c03rad0r/balloon-fresh-1/docs/e80-900mbl-02-eval/README.md

E80-900MBL-02 eval kit reference materials (purchased 2026-08-15).

- e80-900mbl-02-manual-id4396.pdf — user manual v1.00 (11 pp, text-extractable)
- e80-900mbl-02-spec-id4397.pdf — board schematic (1 pp, image-only; pin map cross-validated vs main.h in capability report)
- lr2021-datasheet-id4393.pdf — actually a ZIP: E80_DEMO STM32F103 reference firmware (Keil CubeMX, Semtech LR20xx driver v1.3.1). Unpack locally to read.
- ebyte-doc-id1373.pdf — EBYTE corporate brochure (no technical value, kept for provenance)
- E80-900MBL-02_CAPABILITY_REPORT.md — consultant capability extraction (chip, PA tables, pin map, UART command protocol, gaps)

Live plan: docs/plans/PLAN-E80-LR2021-EVAL-2026-08-15.md
Ports on desk box: /dev/ttyUSB3, /dev/ttyUSB4 (CH340, 115200 8N1)
