c03rad0r/balloon-fresh-1/tracker/hardware/connectivity/OPEN-ITEMS.md

# v10 connectivity OPEN ITEMS

Every pin whose connection is NOT decided yet, or whose decision is UNVERIFIED.
This file is the companion to `v10_pinmap.reg`: the registry says what IS, this says
what is NOT YET DECIDED and what evidence would close it.

Rule: a pin may be `UNASSIGNED` only if it is listed here. The registry check prints
the UNASSIGNED list every run; if a pin appears there and not here, that is a defect.

---

## OPEN-16 — ESP32-S3 GPIO0 (J_PROG pin 6)
- **State:** unverified. The WROOM-1U's GPIO0 pad number is not named by any in-repo
  source. An earlier guess (pad 25) was WRONG — pad 25 is IO48 and already carries
  `/U3_RESET_N`; the guess had clobbered that net and was reverted (PR #266).
- **Blocked on:** Espressif ESP32-S3-WROOM-1 datasheet pin table (not in repo).
- **Workaround in force:** J_PROG pin 6 dangles. Flashing still works over
  USB-Serial-JTAG (EN + USB D± are connected), which needs no GPIO0.
- **Likely CLOSED by registry data (2026-10-26):** `GPIO0` = **`U1` pad 27**, per the pad->GPIO map
  corroborated 20 ways in `docs/analysis/E28-ENABLES-DRIVE-FROM-ESP32.md` §3. `U1.27` is
  `UNASSIGNED` in the registry, which is exactly consistent with being the `J_PROG` pin that
  dangles. Weakens the blocker to "still wants the datasheet table pasted in".
- **Closes when:** datasheet table pasted in, or GPIO0 read off a physical module.

## OPEN-E28-EN — E28 RX_EN (pin 8) / TX_EN (pin 9)
- **State:** pads now NAMED (2026-10-26); assignment still not landed on the board.
- **Note:** these are NEW versus the bare SX1280 (which had no PA/LNA enables), so no
  v9 pin carried over.
- **Resolved pads** (pad->GPIO map corroborated 20 ways against this registry; see
  `docs/analysis/E28-ENABLES-DRIVE-FROM-ESP32.md`):
  `TX_EN -> U1.35 (IO42)` — the only clean spare GPIO; `RX_EN -> U1.16 (IO46)` — a
  strapping pin whose load is a high-Z module input. Fallback for RX_EN is strapping it
  high with a resistor rather than spending the strap pin.
- **DO NOT strap both to +3V3.** ADR-123 explicitly budgets `E28 extras (RX_EN, TX_EN) | 2`
  and states "fits with 2 spare"; this item was open only because nobody had named the pads.
  A strap recommendation was made and retracted on 2026-10-26.
- **Closes when:** the two nets are created, routed and re-graded, and the IO46 strapping
  behaviour is confirmed from the WROOM-1 datasheet (the OPEN-16 blocker).

## OPEN-17 / OPEN-25 (merged) — the LAST ADC INPUT on the board

**State:** unresolved, and now BLOCKING two functions that are both in the design.

Two things compete for one ADC-capable pin:

1. **`/SCAP_ADC` — the supercap-rail monitor** (`R_DIV1`/`R_DIV2`, 2× 1 M, ADR-006).
2. **`/CUT_SENSE_W1..W4` — the cut-sense lines** (ADR-051 §2.6), which the operator has now
   confirmed are IN the design (ADR-129 D5).

**Measured in the v9 netlist: `/SCAP_ADC` connects to NOTHING but its own divider.** In v9 the
node was a net between `R_DIV1.2` and `R_DIV2.1` and had **no ESP32 pin at all** — the rail
monitor was never actually readable. So this is not a regression v10 introduced; v10 inherited it
by carrying the divider across. It is recorded here because ADR-129 restores the divider and
therefore makes the gap explicit.

**The arithmetic** (`docs/analysis/ADC-PIN-RESOLUTION-OPEN17-OPEN25.md`): there is **no spare ADC
input**. `IO13` is spent on the F33 rail monitor (ADR-047 §6, `F33_VSENSE`). ADR-029 §4 forbids
GPIO0 for the supercap divider (it is a strap), and ADR-069 forbids dividers on straps generally.

**The three shapes the analysis allows, in its own order of preference:**

1. **Give the cut-sense the one-GPIO + resistor-ladder/mux shape** ADR-051 §2.6 already allows.
2. **Free an ADC-capable pin** by relocating one *digital* assignment onto a free pin — **but note
   the correction below: `U1.26..U1.30` is NOT a "free IO22–IO34 block"**. Those pads are
   `IO45`, `IO0`, `IO35`, `IO36`, `IO37` (two strapping pins + three octal-PSRAM pins), so no
   digital line can move there. The only clean spare GPIO on this board is `U1.35 (IO42)`; see
   `docs/analysis/E28-ENABLES-DRIVE-FROM-ESP32.md` §3. This preserves
   rail-monitor accuracy.
3. **Only if no digital line can move**, share IO13 — and then the divider network must be
   designed and *measured* for burden and post-cut interpretability before flight.

**Not decided here.** `U_CUT1..4` pin 3 is landed on `/CUT_SENSE_W<n>` and the divider is landed
on `/SCAP_ADC`; **neither has a U1 pin.** Closing this item is what gives them one.

**Closes when:** a shape is chosen and a U1 pad is assigned to `/SCAP_ADC` and to the cut-sense
encoding. **`/SCAP_ADC` and `/CUT_SENSE_W1..W4` will remain single-ended nets until then** — they
are a deliberate, documented open item, not an omission.
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
