c03rad0r/balloon-fresh-1/data/comprehensive_plot_20260724.png

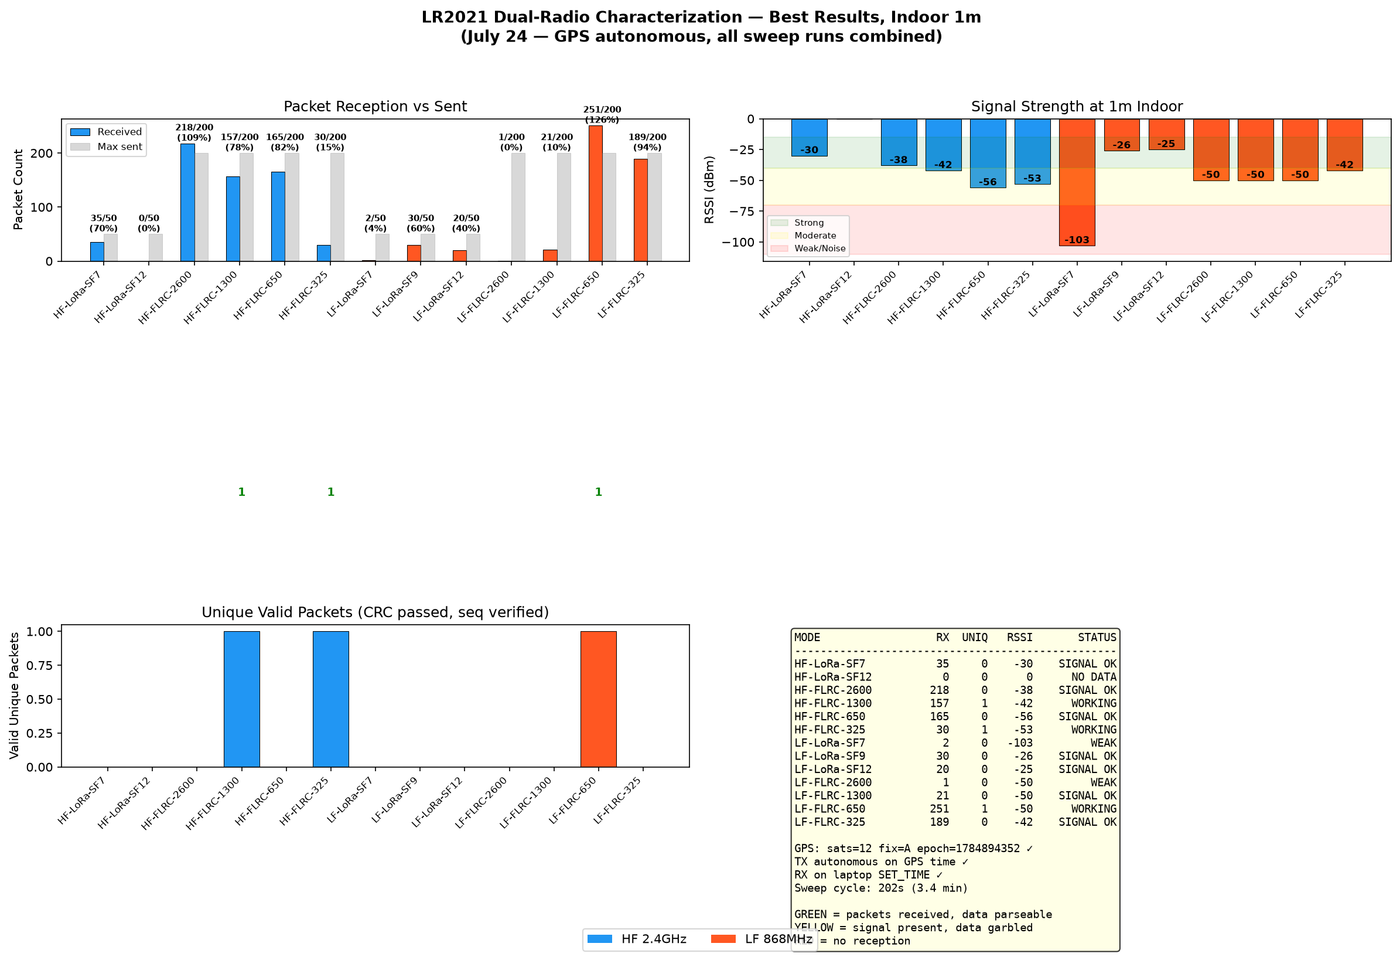
data/comprehensive_plot_20260724.png
