c03rad0r/balloon-fresh-1/data/payload-corruption.png

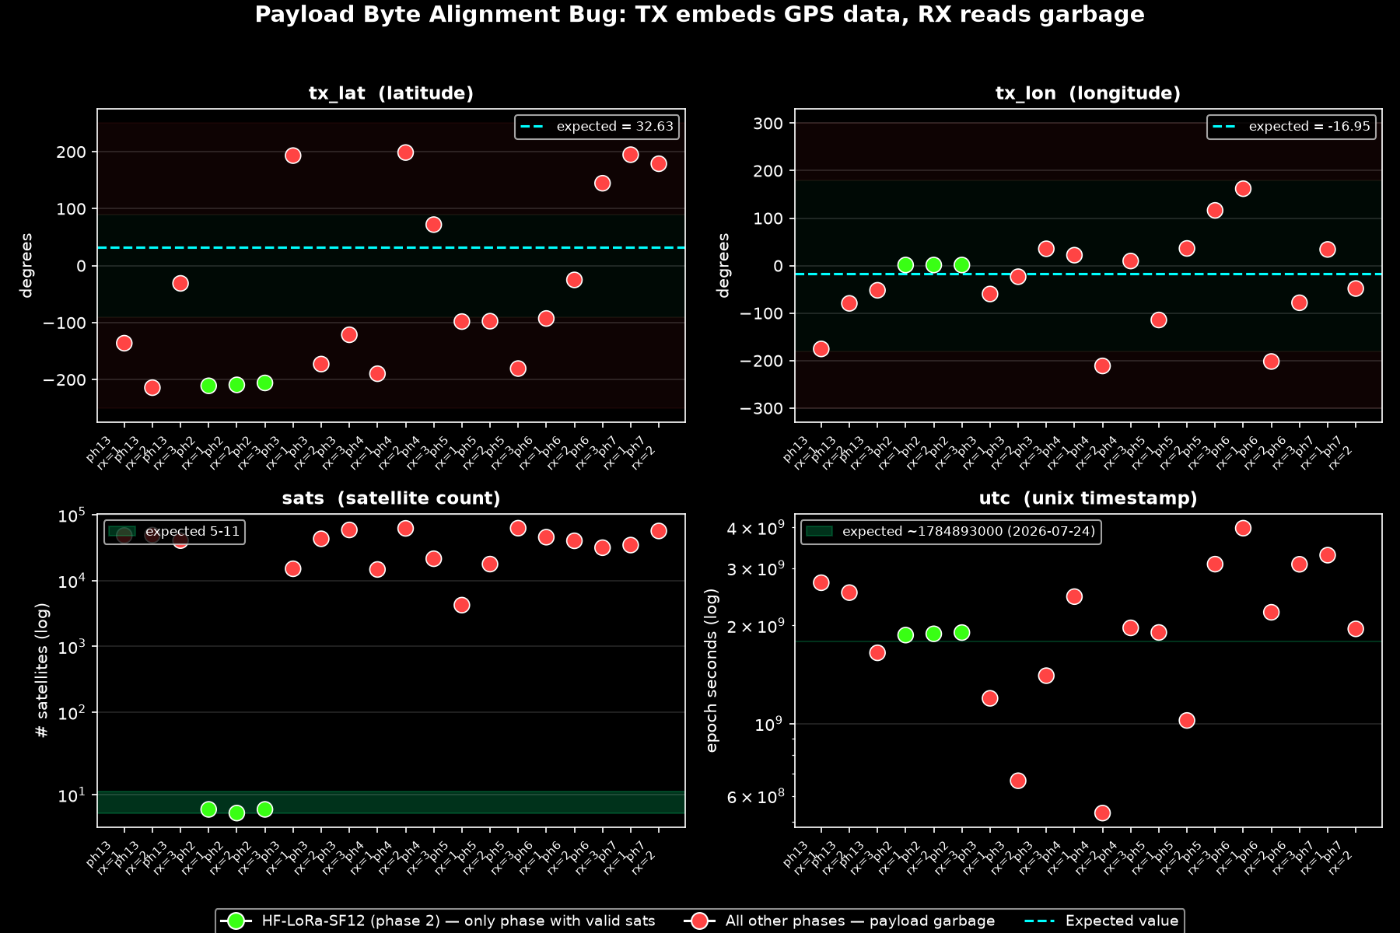
data/payload-corruption.png
