c03rad0r/balloon-fresh-1/data/plots/01_rssi_vs_distance.png

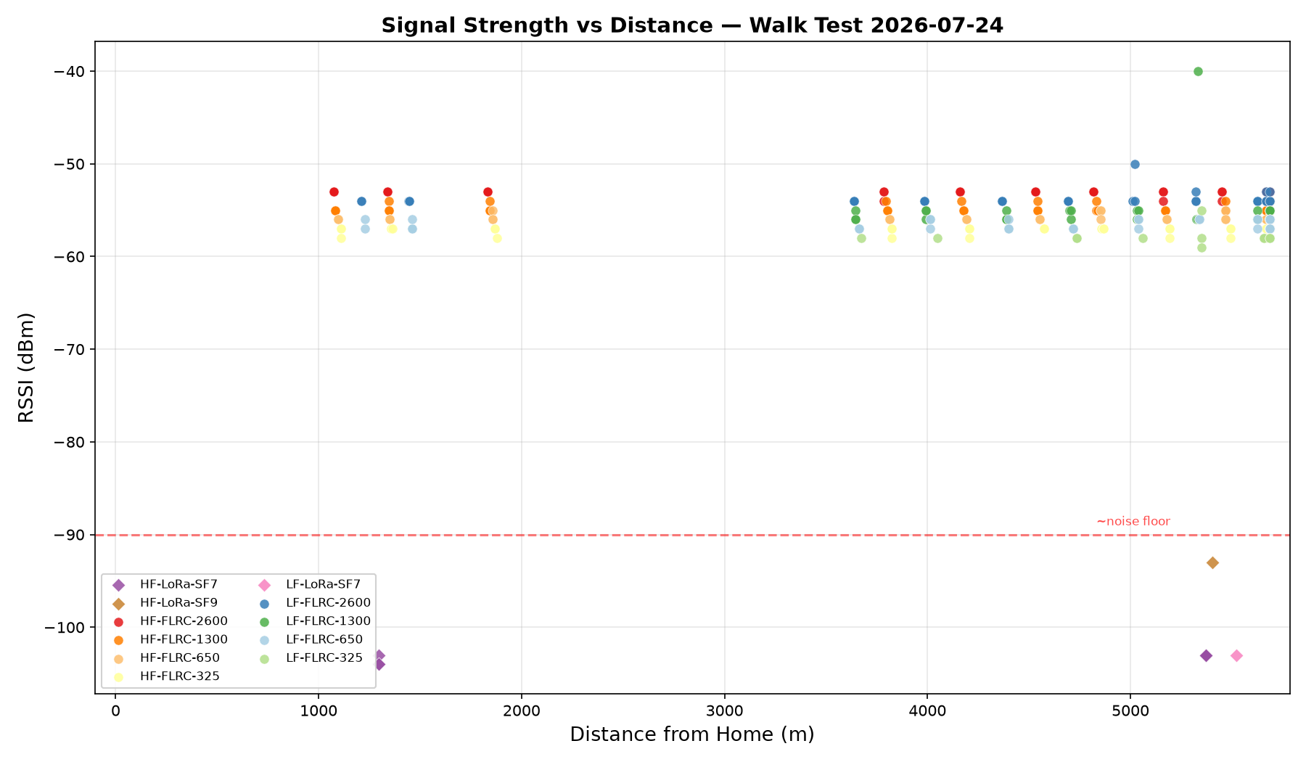
data/plots/01_rssi_vs_distance.png
