c03rad0r/balloon-fresh-1/data/plots/02_rssi_over_time.png

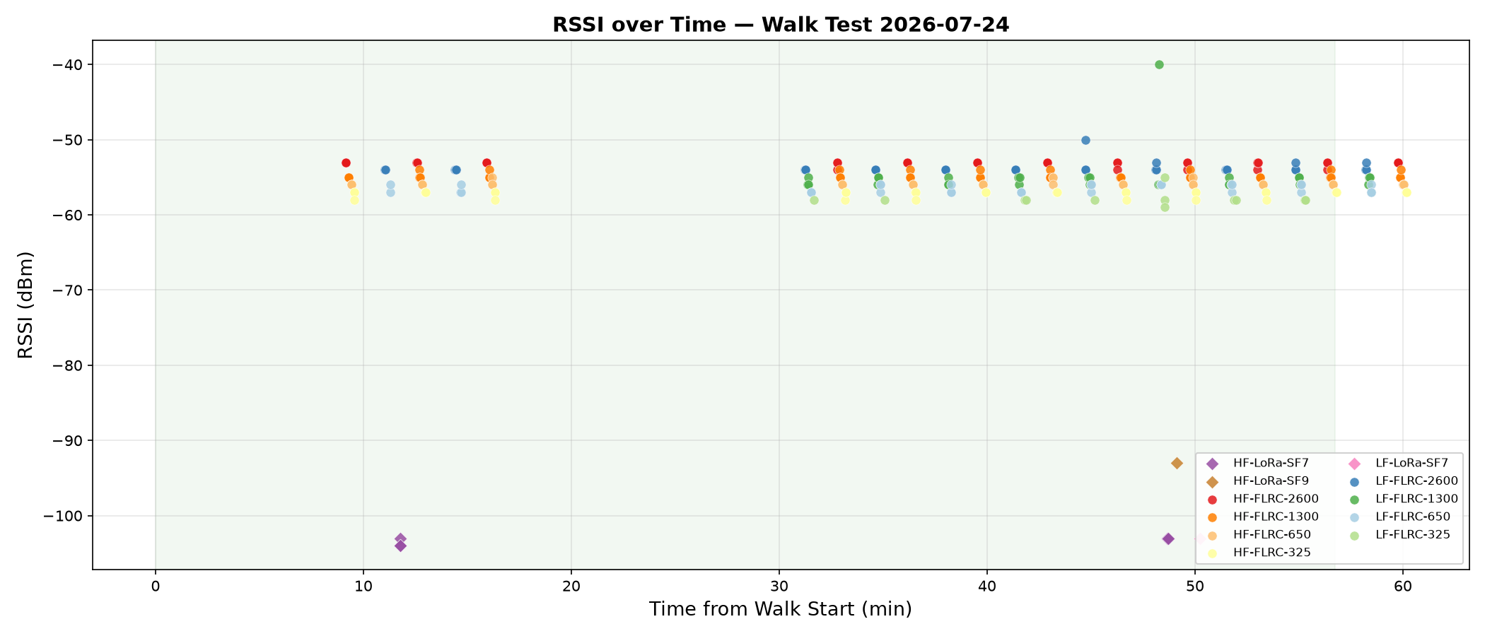
data/plots/02_rssi_over_time.png
