c03rad0r/balloon-fresh-1/data/plots/03_packets_per_mode.png

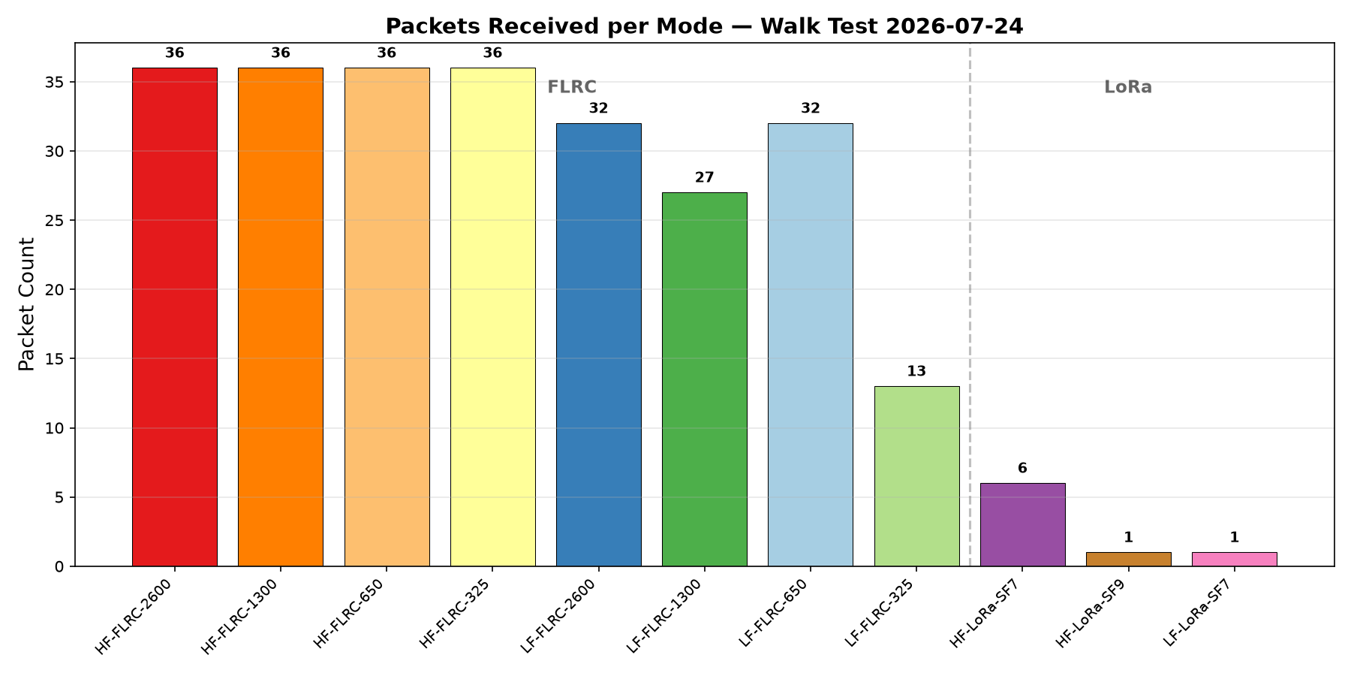
data/plots/03_packets_per_mode.png
