c03rad0r/balloon-fresh-1/data/plots/04_gps_walk_track.png

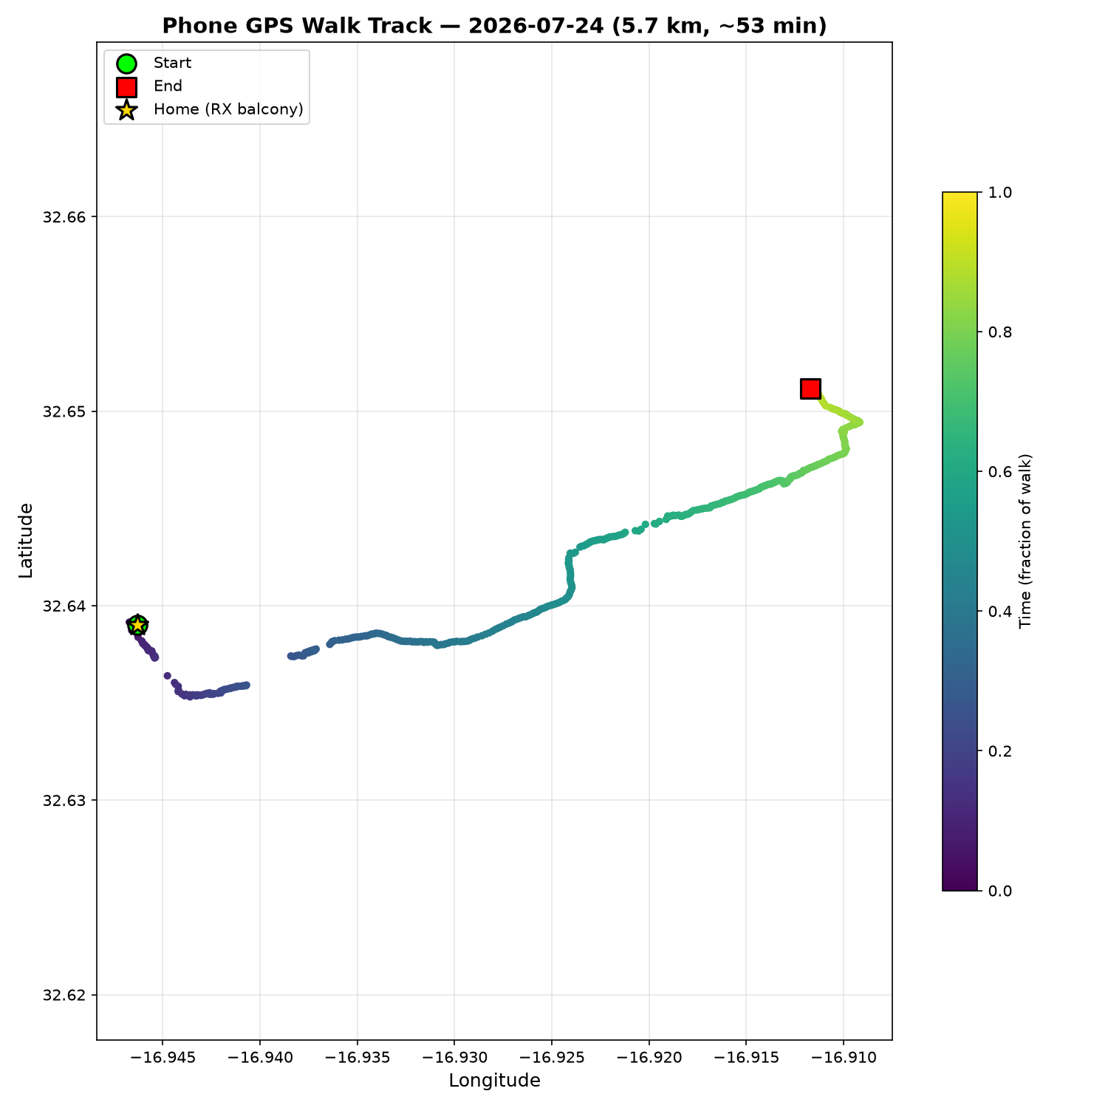
data/plots/04_gps_walk_track.png
