c03rad0r/balloon-fresh-1/data/plots/05_rssi_distribution.png

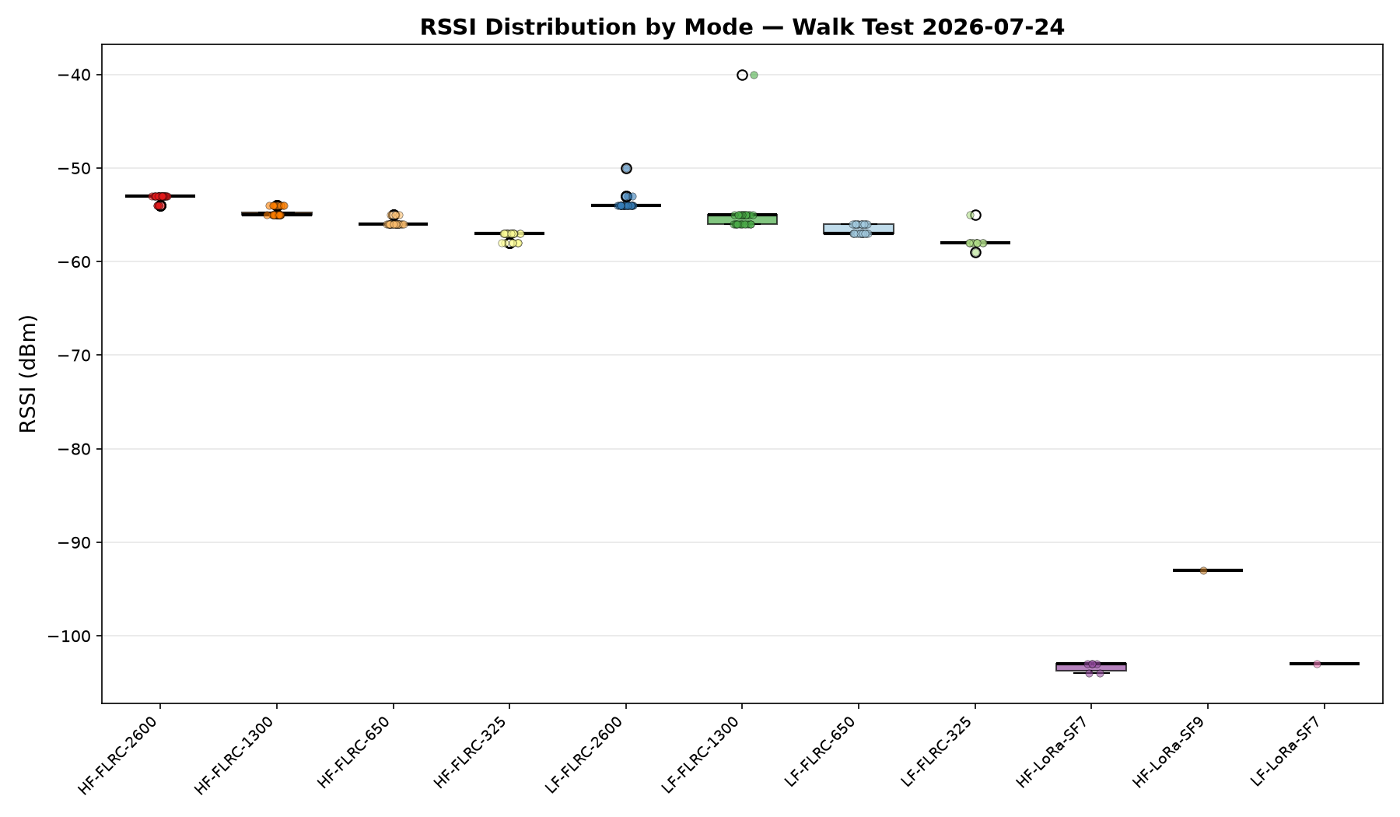
data/plots/05_rssi_distribution.png
