c03rad0r/balloon-fresh-1/data/plots/06_signal_map.png

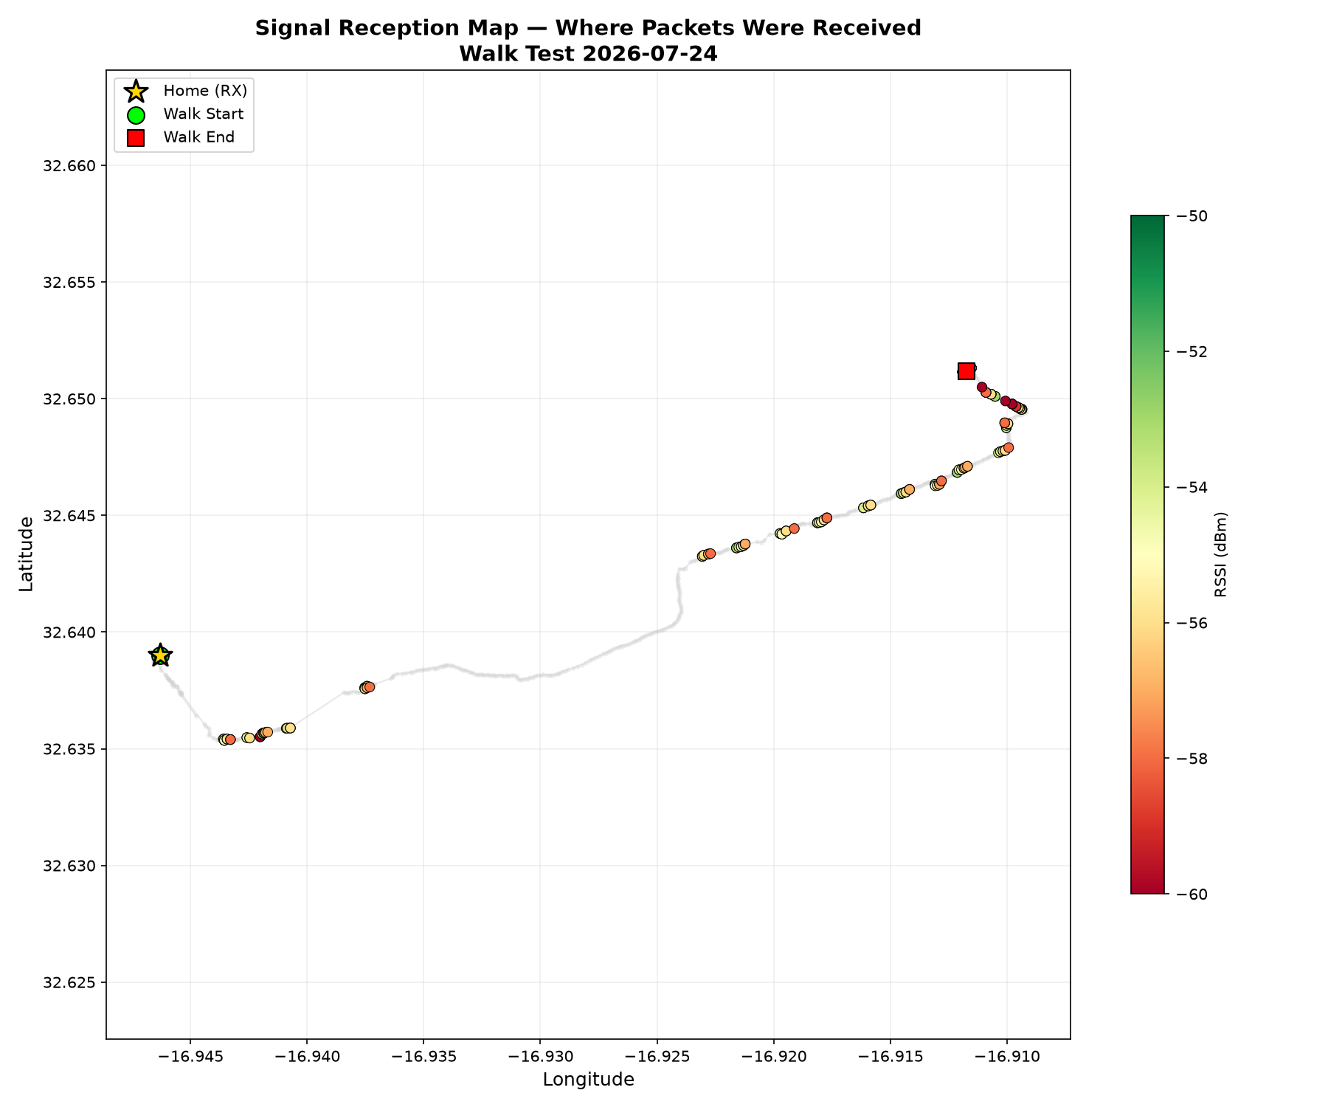
data/plots/06_signal_map.png
