c03rad0r/balloon-fresh-1/data/recent-rssi-analysis.png

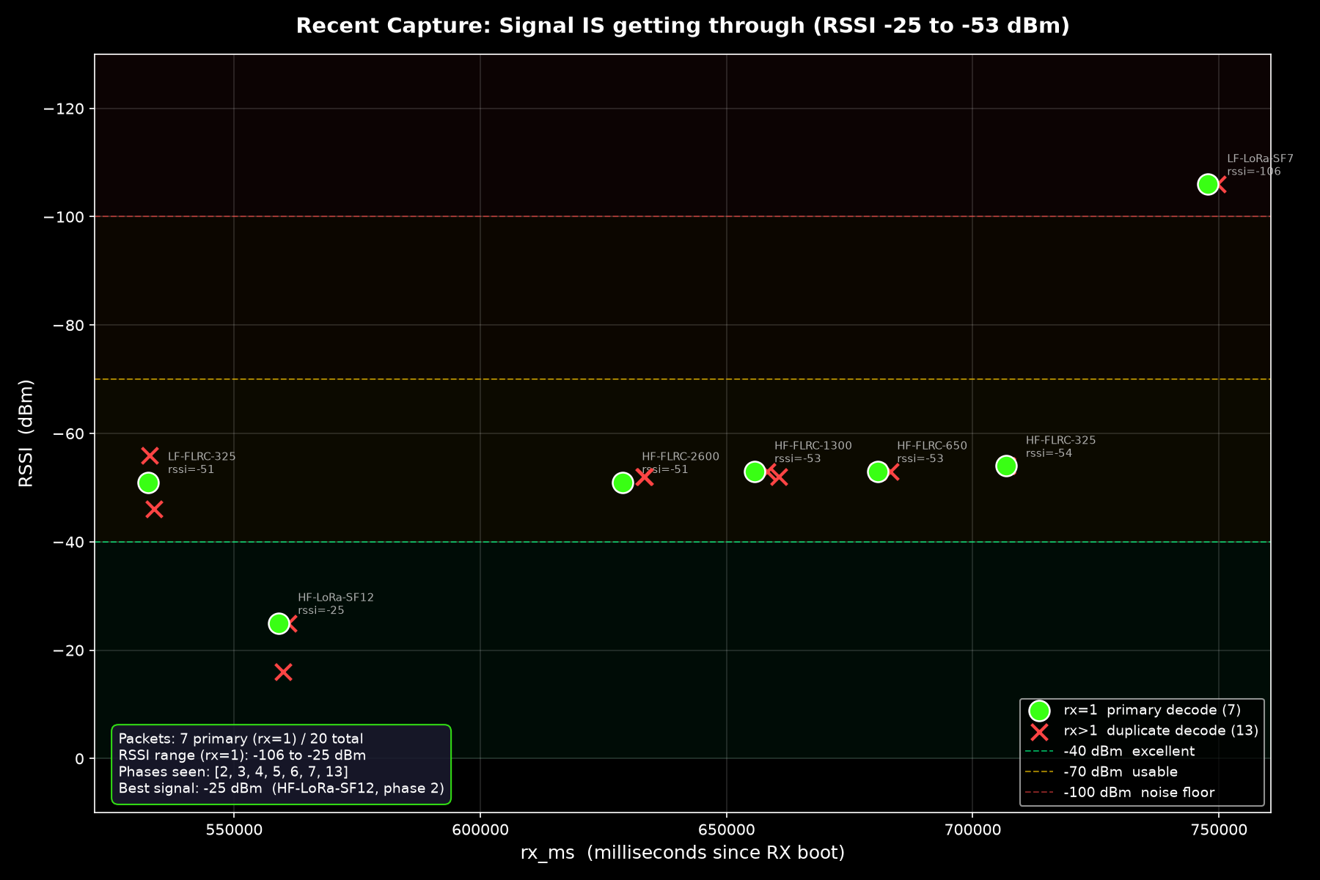
data/recent-rssi-analysis.png
