c03rad0r/balloon-fresh-1/data/sweep_plots.png

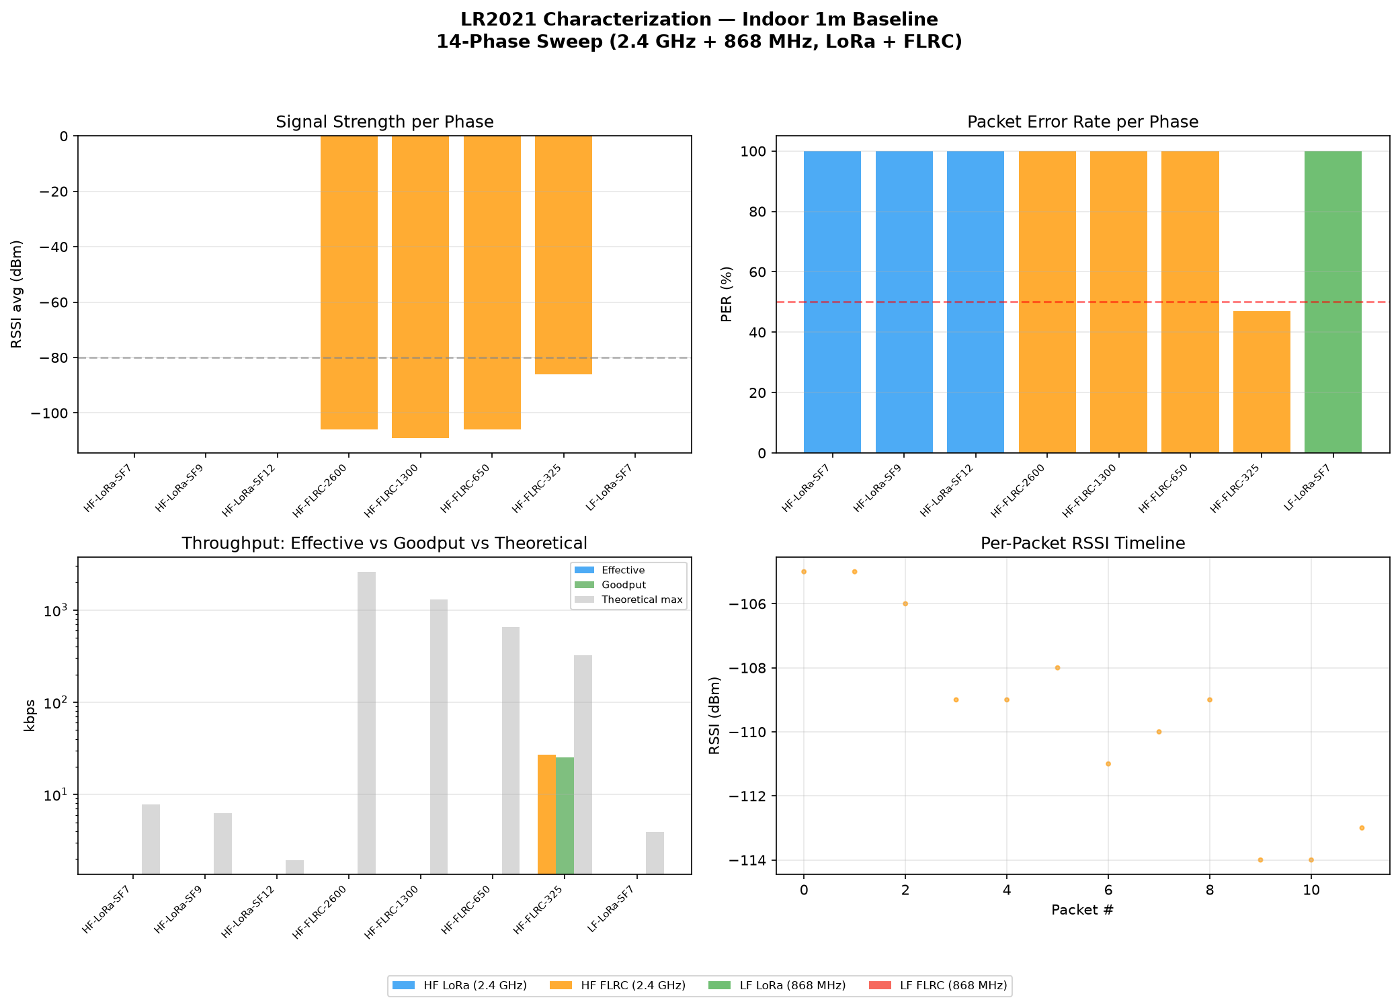
data/sweep_plots.png
