c03rad0r/balloon-fresh-1/data/sweep_plots_v4.png

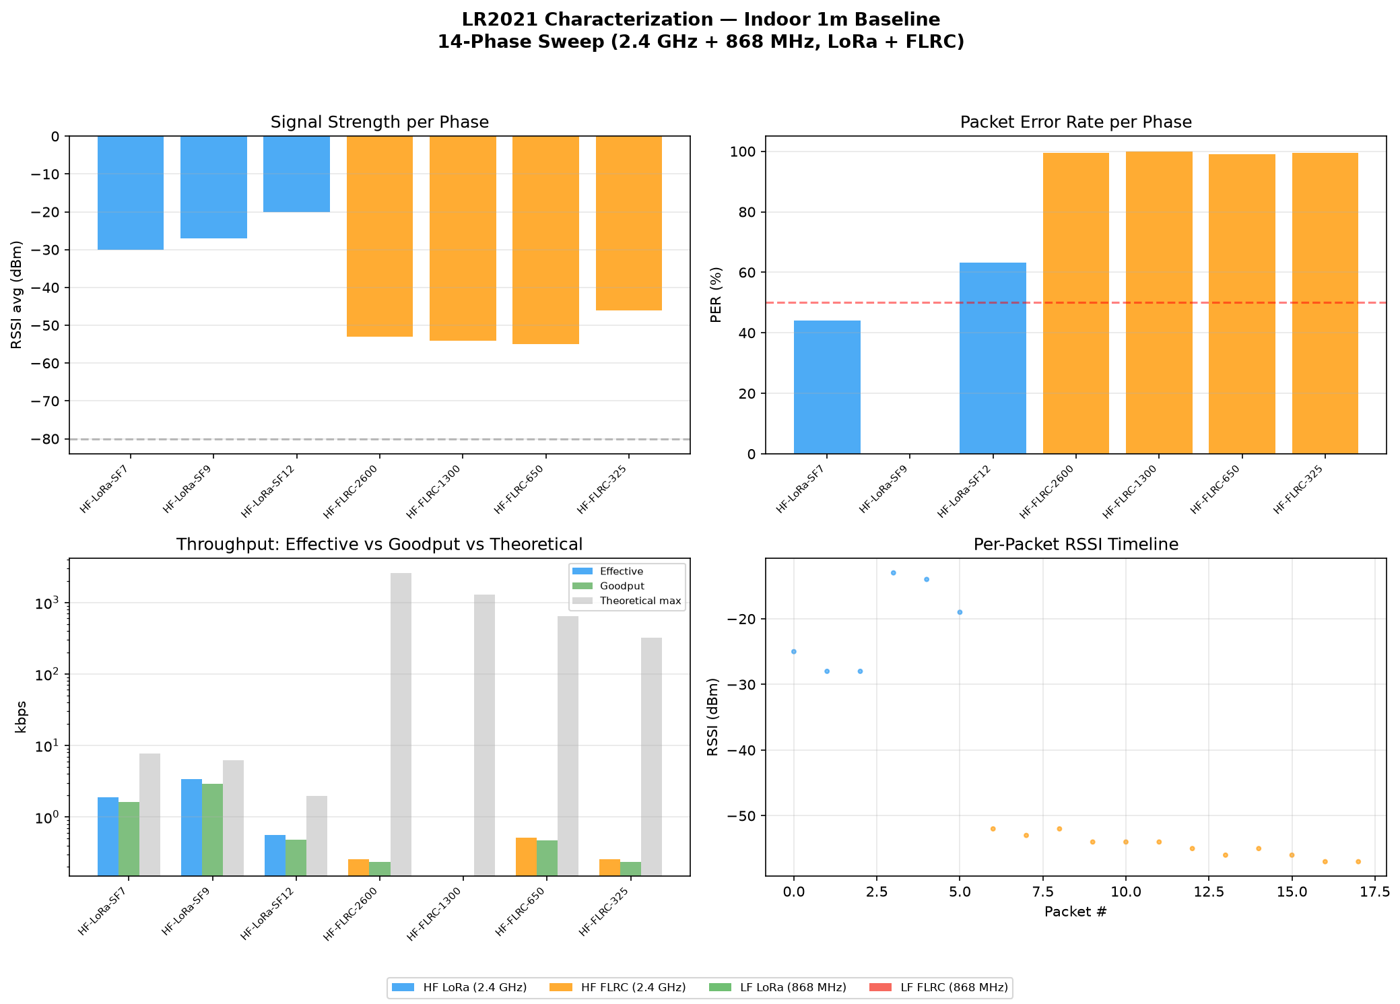
data/sweep_plots_v4.png
