c03rad0r/balloon-fresh-1/data/v4-channel-sweep/plots/01_per_heatmap.png

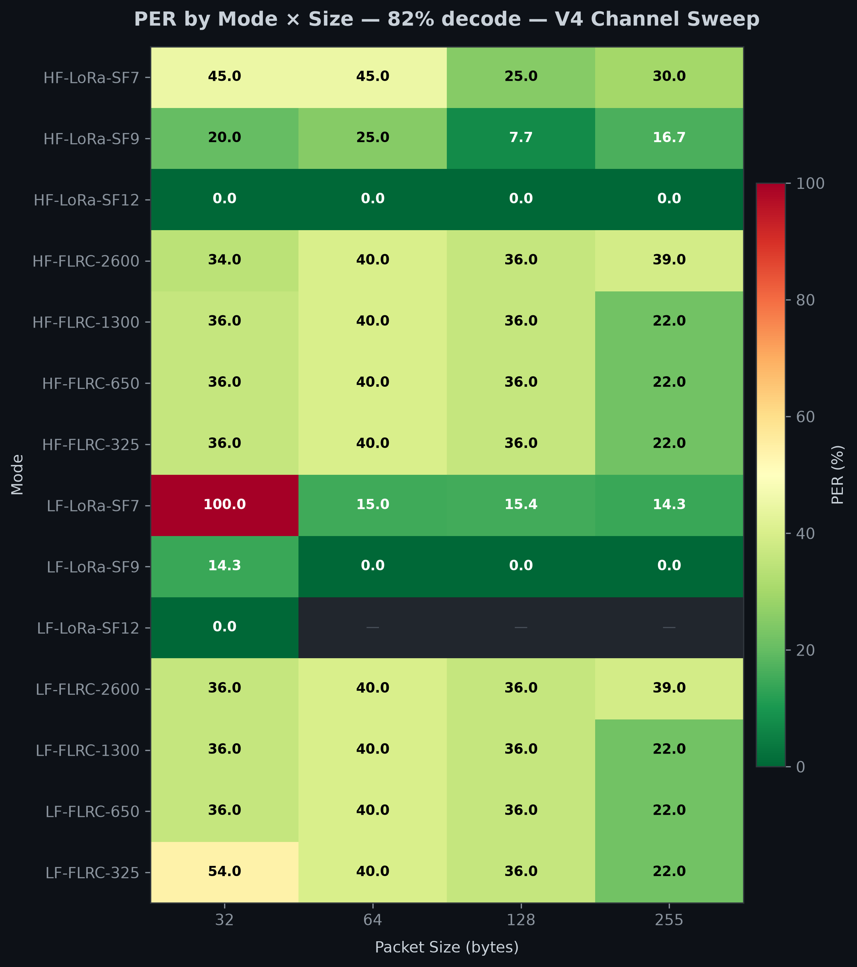
data/v4-channel-sweep/plots/01_per_heatmap.png
