c03rad0r/balloon-fresh-1/data/v4-channel-sweep/plots/02_channel_sweep.png

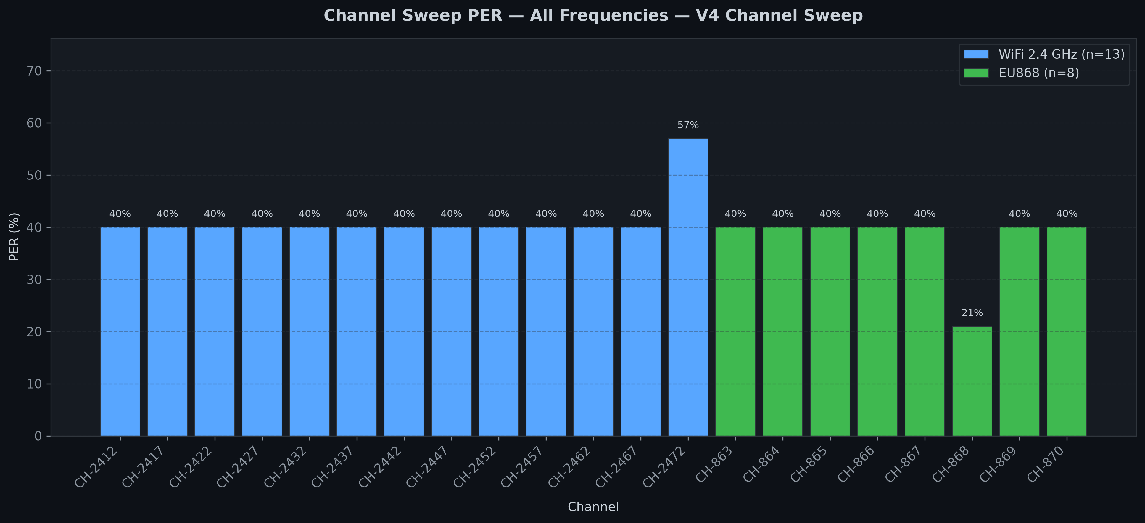
data/v4-channel-sweep/plots/02_channel_sweep.png
