c03rad0r/balloon-fresh-1/data/v4-channel-sweep/plots/03_rssi_by_mode.png

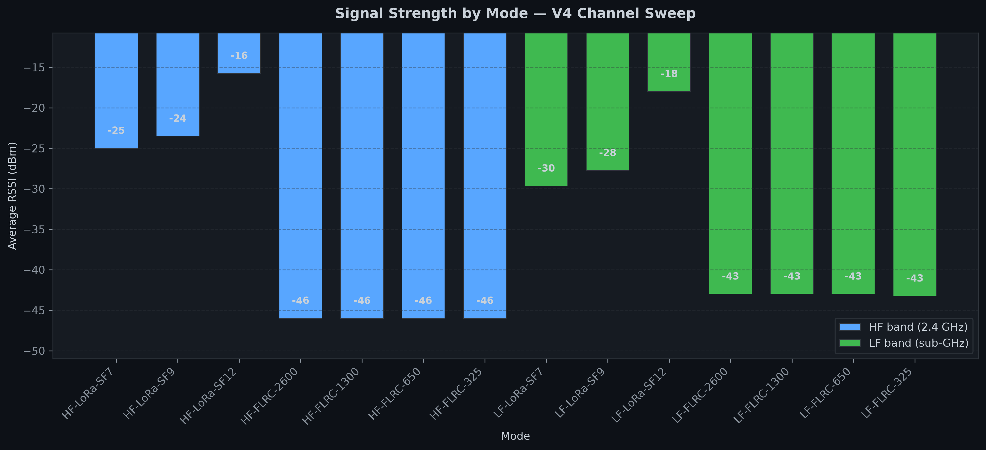
data/v4-channel-sweep/plots/03_rssi_by_mode.png
