c03rad0r/balloon-fresh-1/data/v4-channel-sweep/plots/05_per_comparison.png

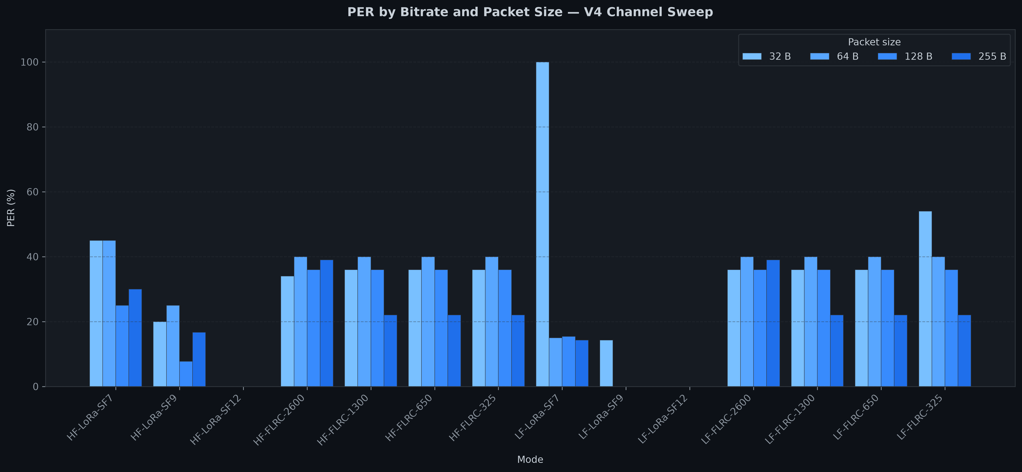
data/v4-channel-sweep/plots/05_per_comparison.png
