c03rad0r/balloon-fresh-1/data/v4-channel-sweep/plots/06_throughput.png

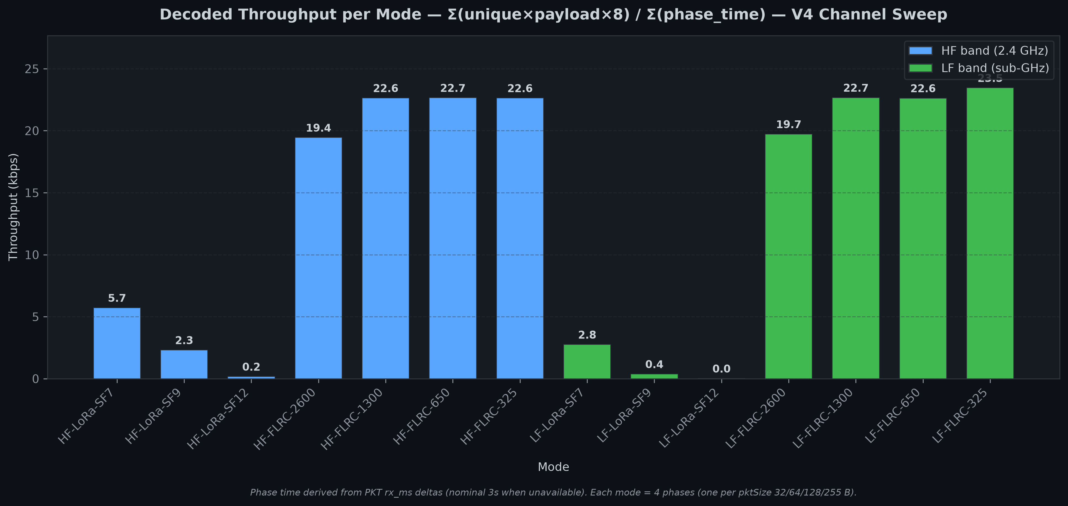
data/v4-channel-sweep/plots/06_throughput.png
