c03rad0r/balloon-fresh-1/data/v4-channel-sweep/plots/per_vs_channel.png

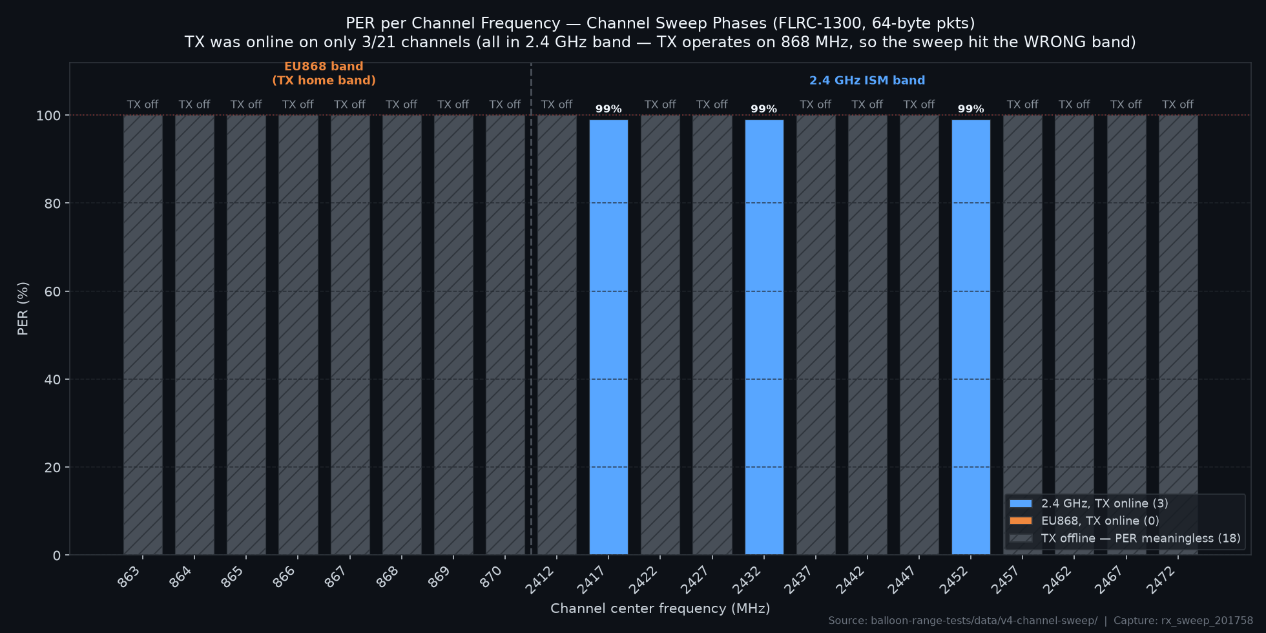
data/v4-channel-sweep/plots/per_vs_channel.png
