c03rad0r/balloon-fresh-1/data/v4-channel-sweep/plots/rssi_vs_mode.png

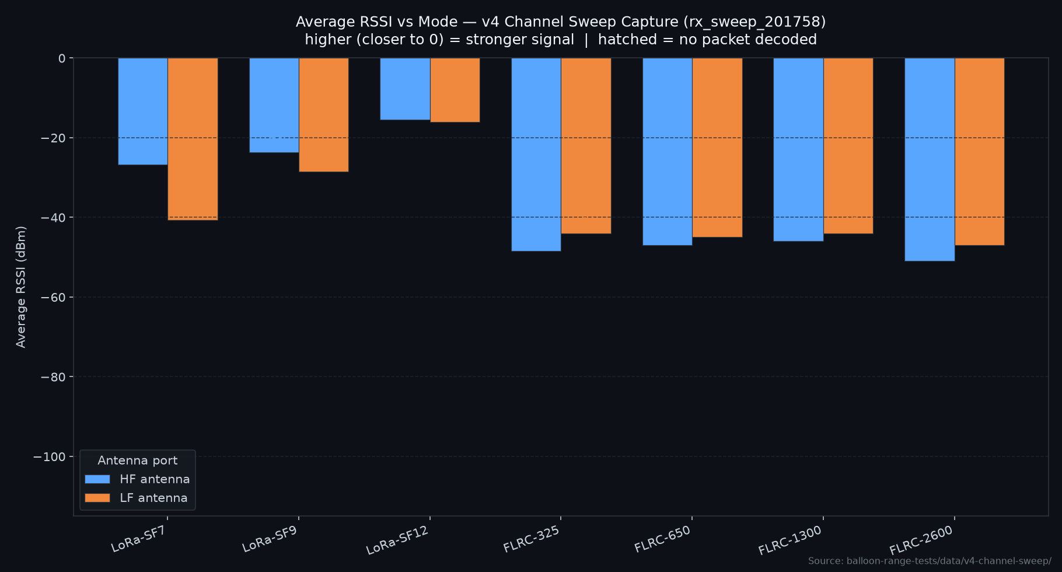
data/v4-channel-sweep/plots/rssi_vs_mode.png
