c03rad0r/balloon-fresh-1/data/v4-channel-sweep/plots/walk_04_decode_summary.png

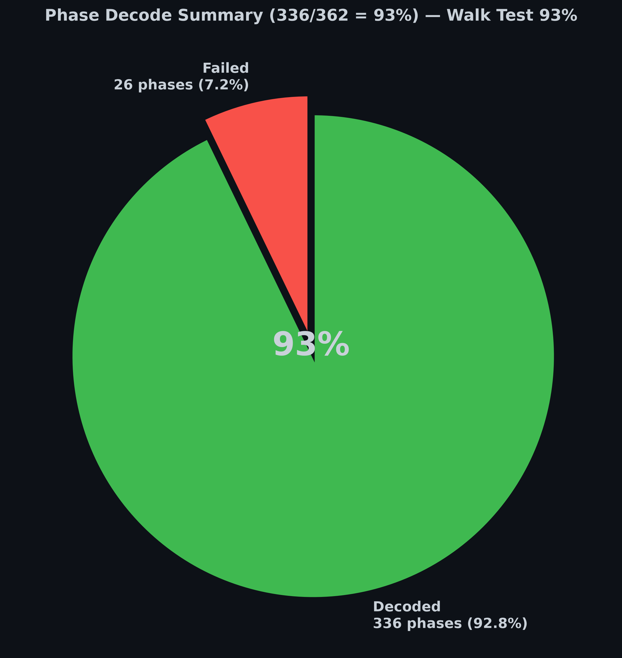
data/v4-channel-sweep/plots/walk_04_decode_summary.png
