c03rad0r/balloon-fresh-1/data/v4-channel-sweep/plots/walk_05_per_comparison.png

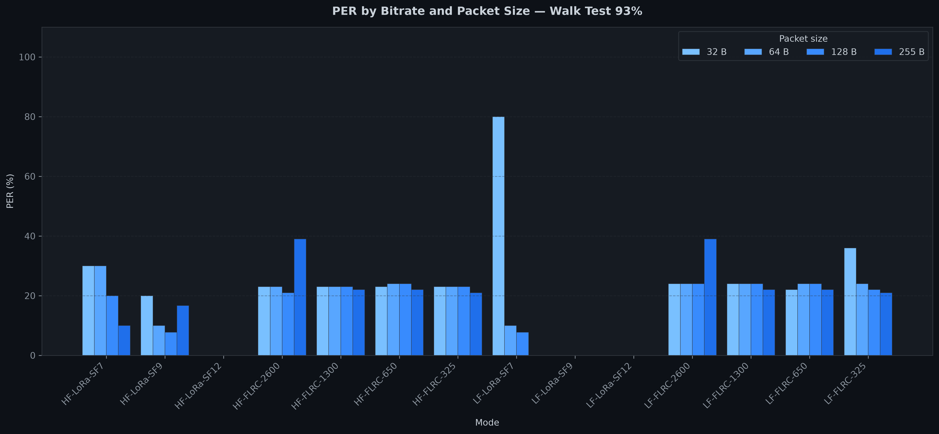
data/v4-channel-sweep/plots/walk_05_per_comparison.png
