c03rad0r/balloon-fresh-1/data/v4-channel-sweep/plots/walk_06_throughput.png

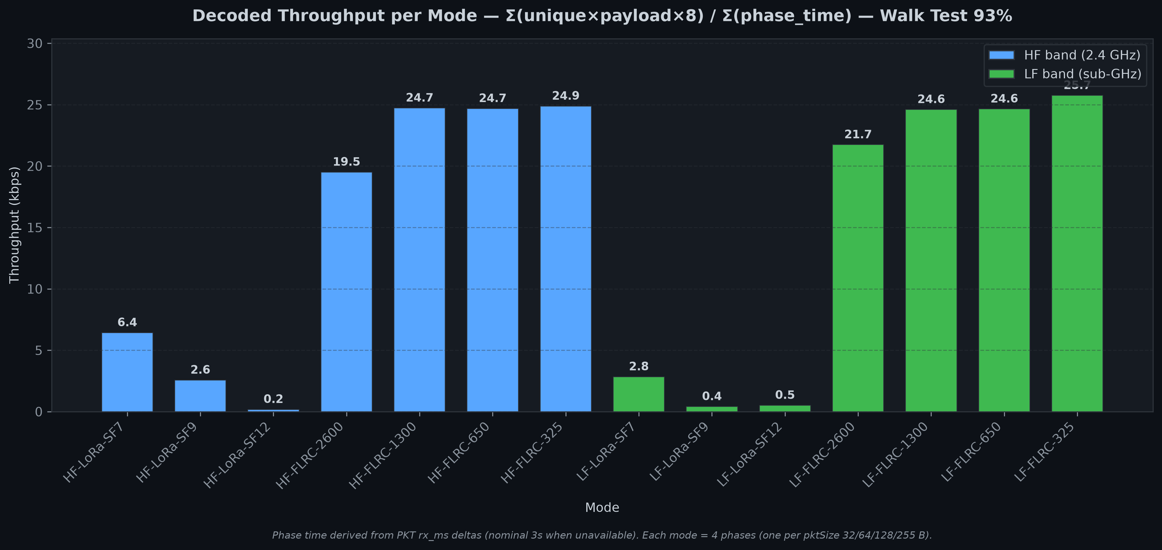
data/v4-channel-sweep/plots/walk_06_throughput.png
