c03rad0r/balloon-fresh-1/data/walk-comprehensive-analysis.png

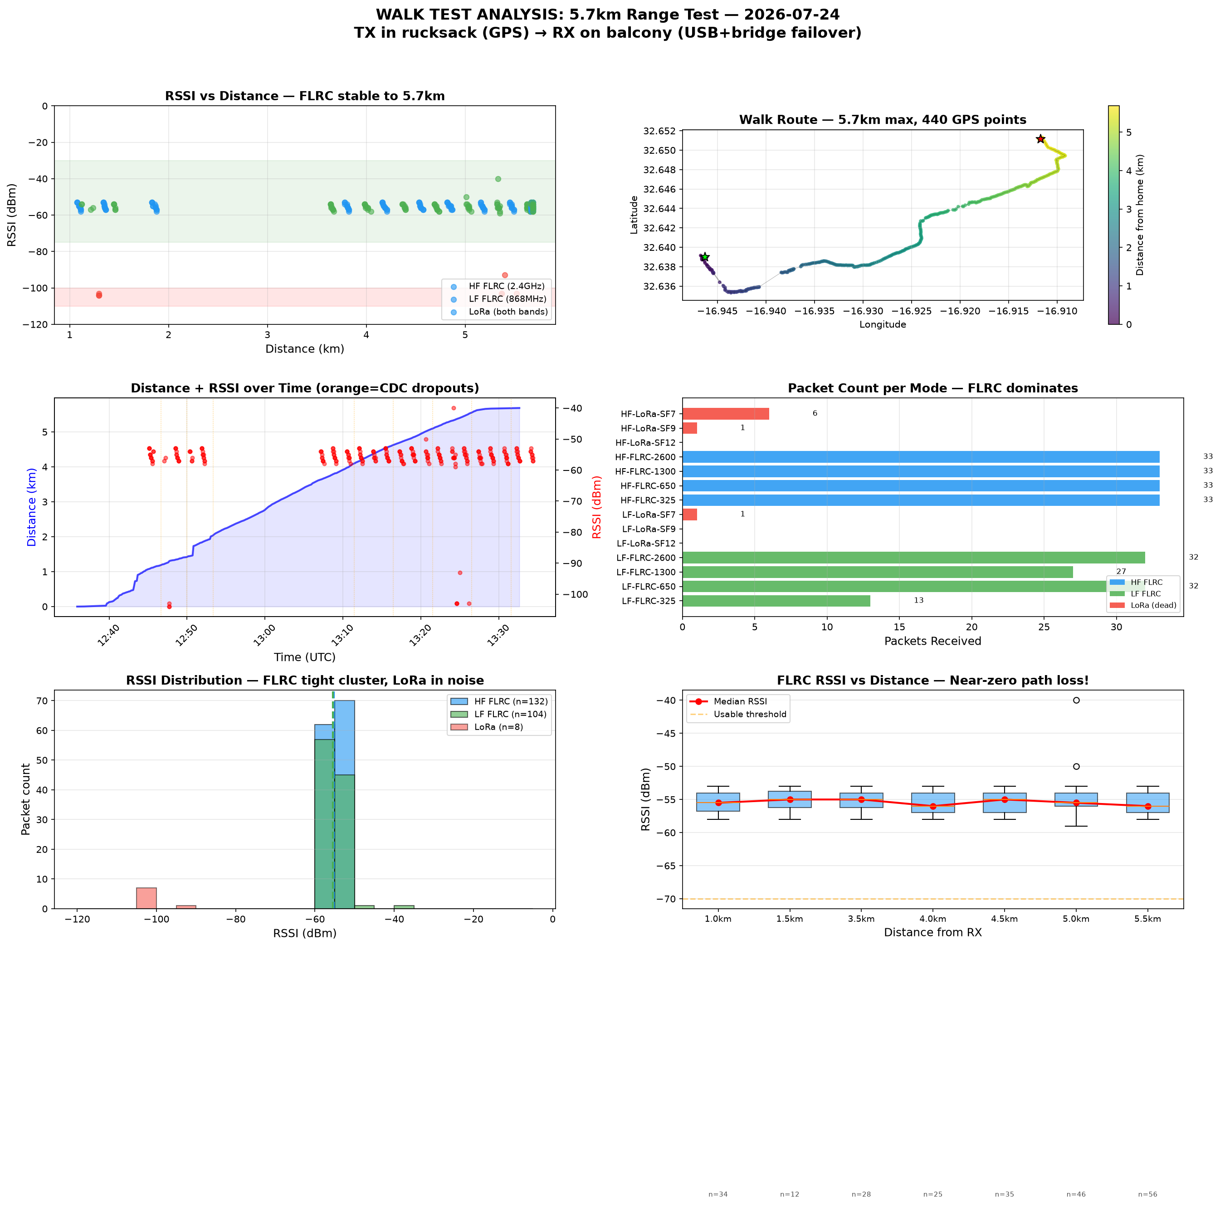
data/walk-comprehensive-analysis.png
