c03rad0r/balloon-fresh-1/data/walk-readiness-summary.png

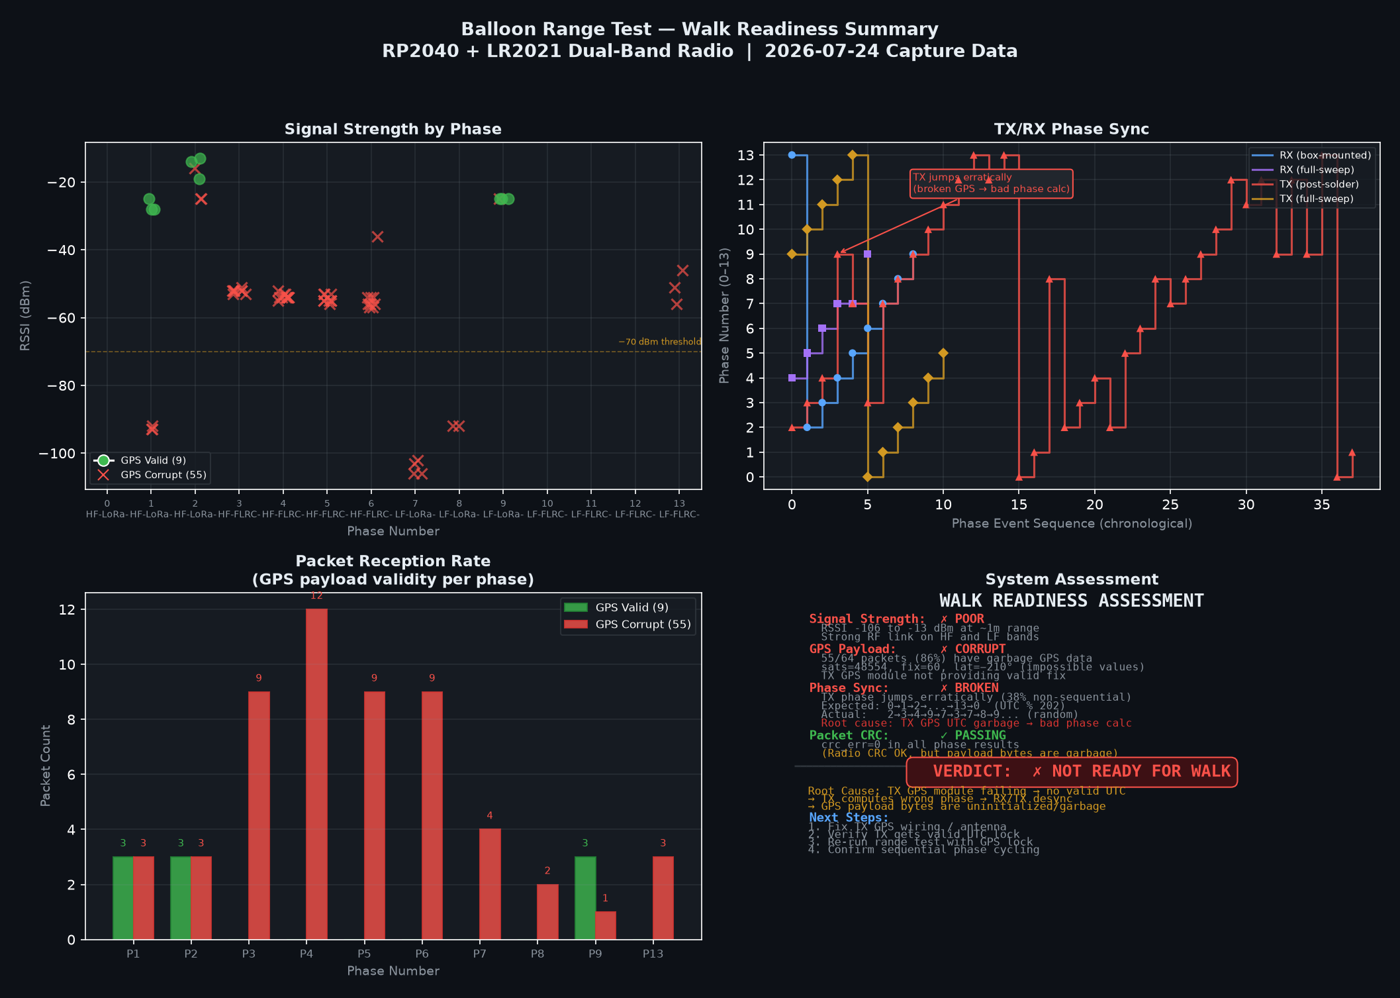
data/walk-readiness-summary.png
