c03rad0r/balloon-fresh-1/docs/analysis/assets/amplifier-hypothesis-ebar.png

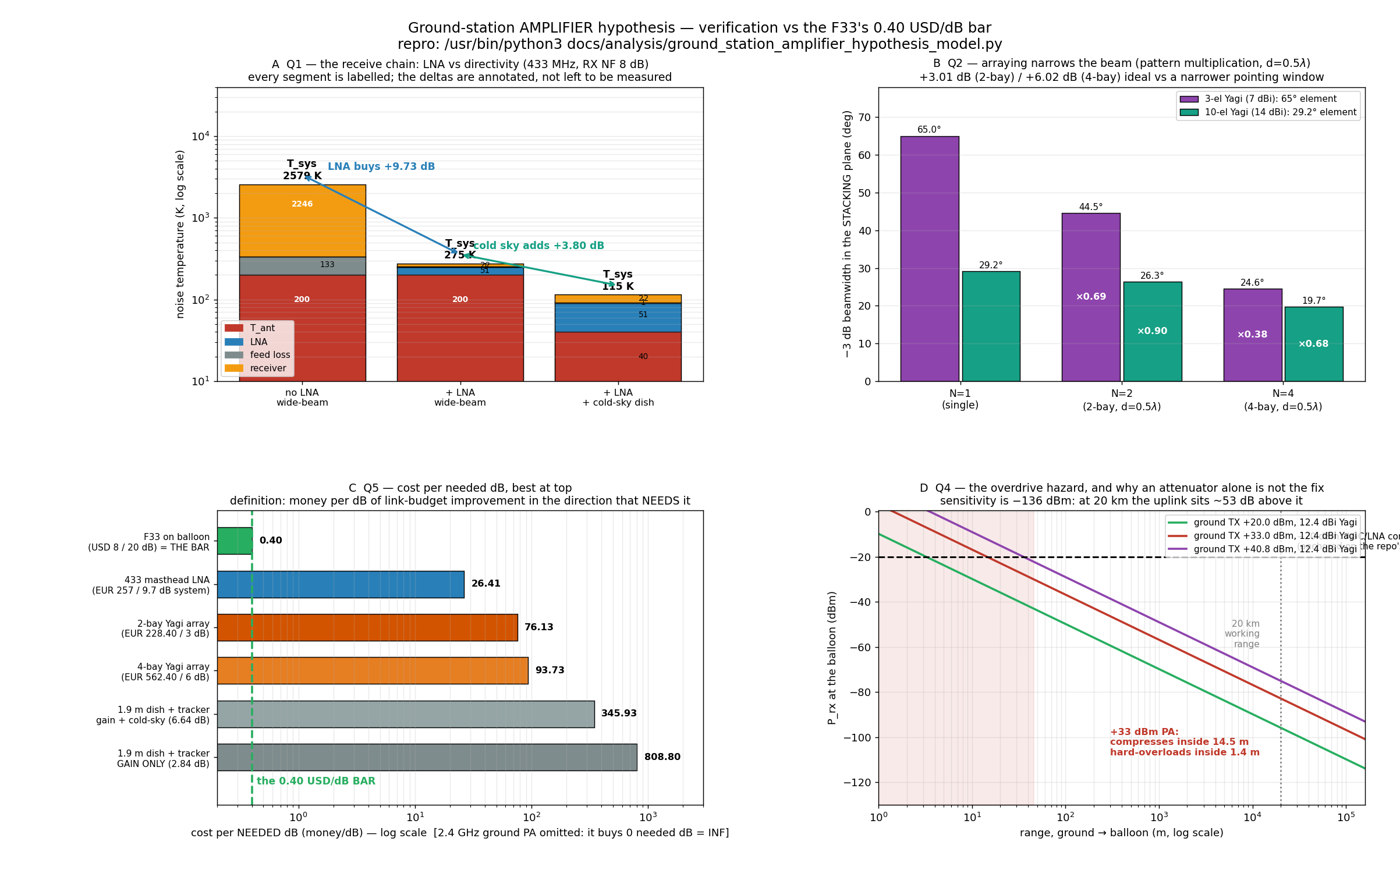
docs/analysis/assets/amplifier-hypothesis-ebar.png
