c03rad0r/balloon-fresh-1/docs/analysis/assets/flrc-max-trade.png

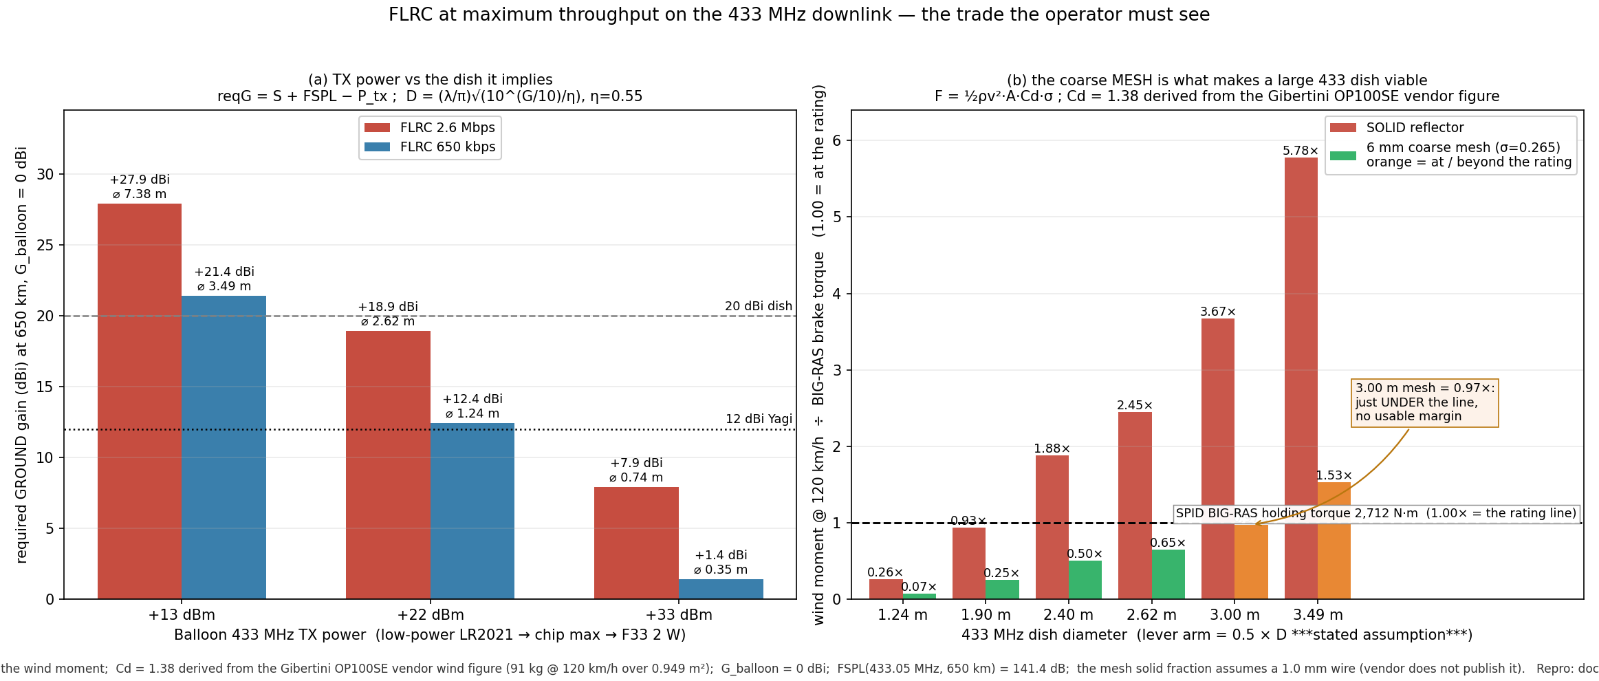
docs/analysis/assets/flrc-max-trade.png
