c03rad0r/balloon-fresh-1/docs/analysis/assets/gain-per-dollar-challenge.png

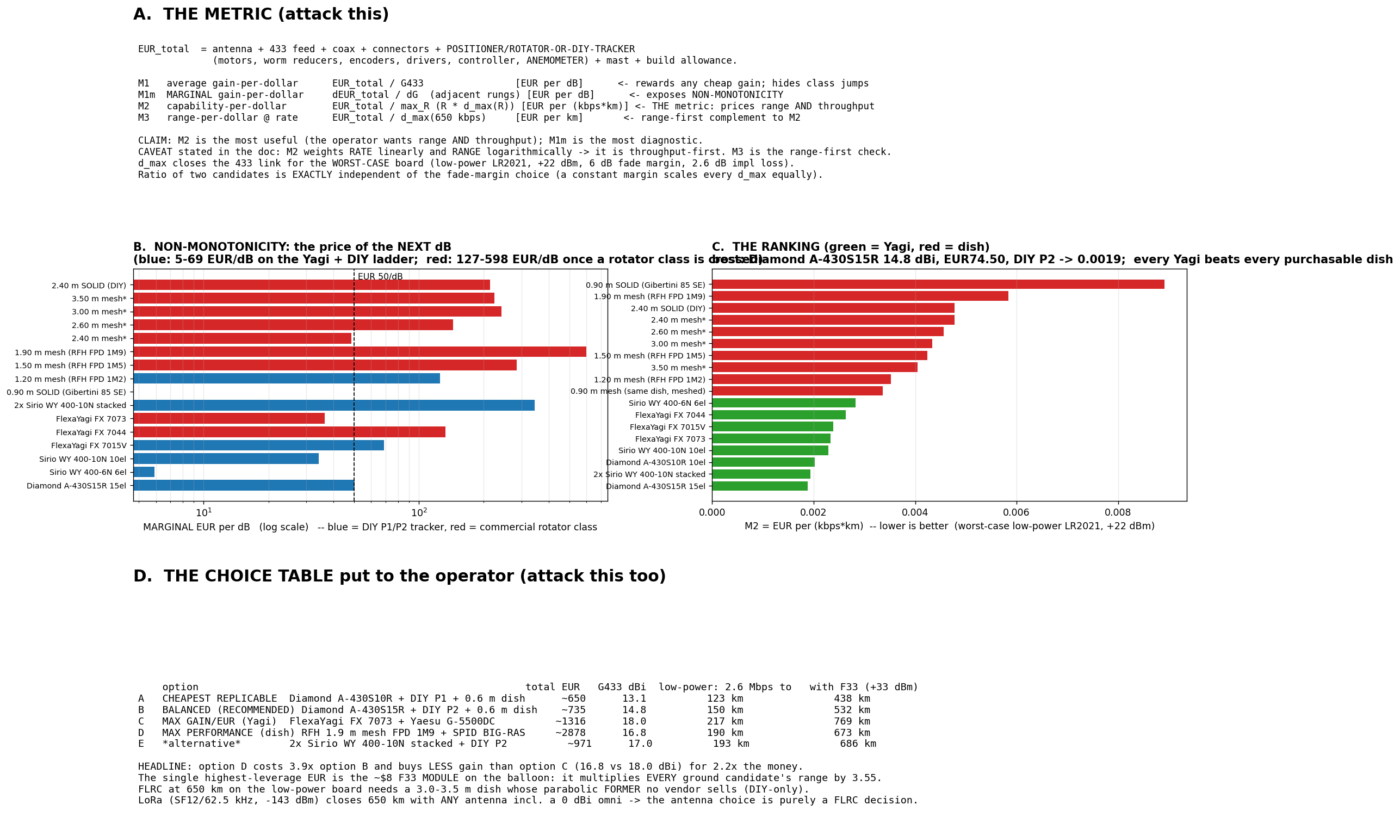
docs/analysis/assets/gain-per-dollar-challenge.png
