c03rad0r/balloon-fresh-1/docs/analysis/assets/gain-per-dollar/fig2-yagi-vs-dish.png

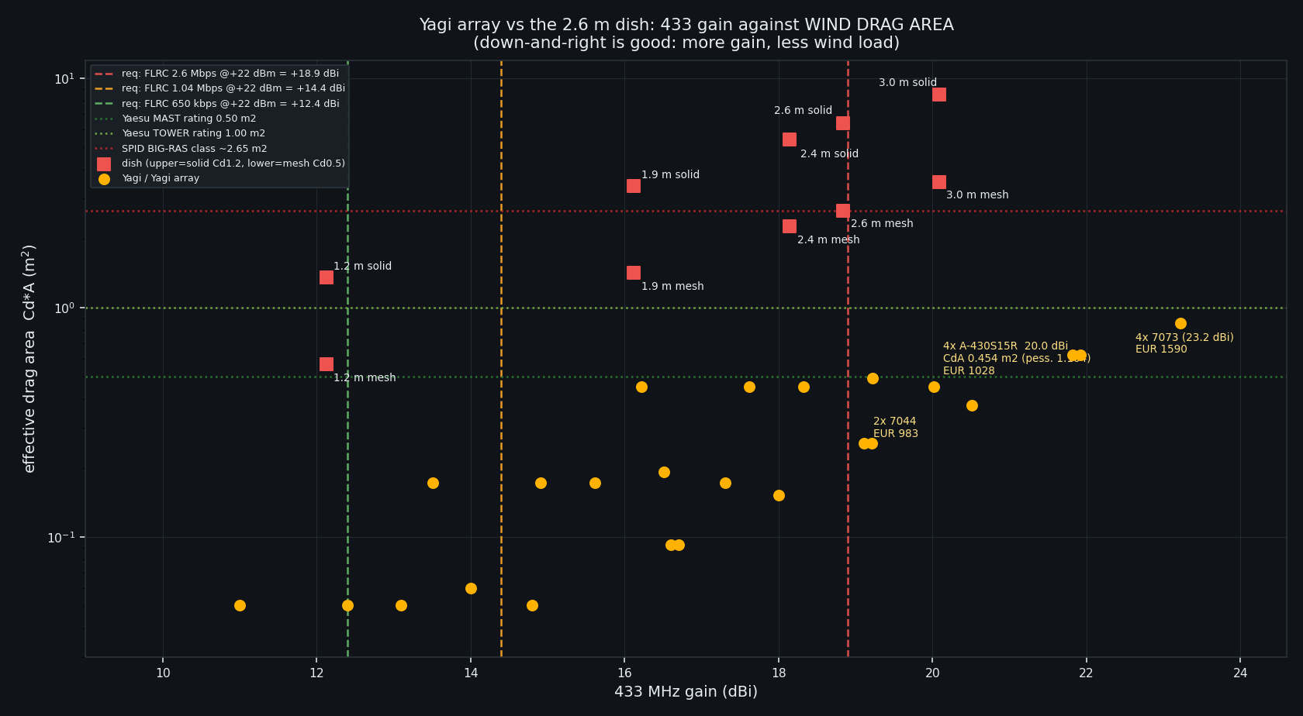
docs/analysis/assets/gain-per-dollar/fig2-yagi-vs-dish.png
