c03rad0r/balloon-fresh-1/docs/analysis/assets/gain-per-dollar/fig3-frontier.png

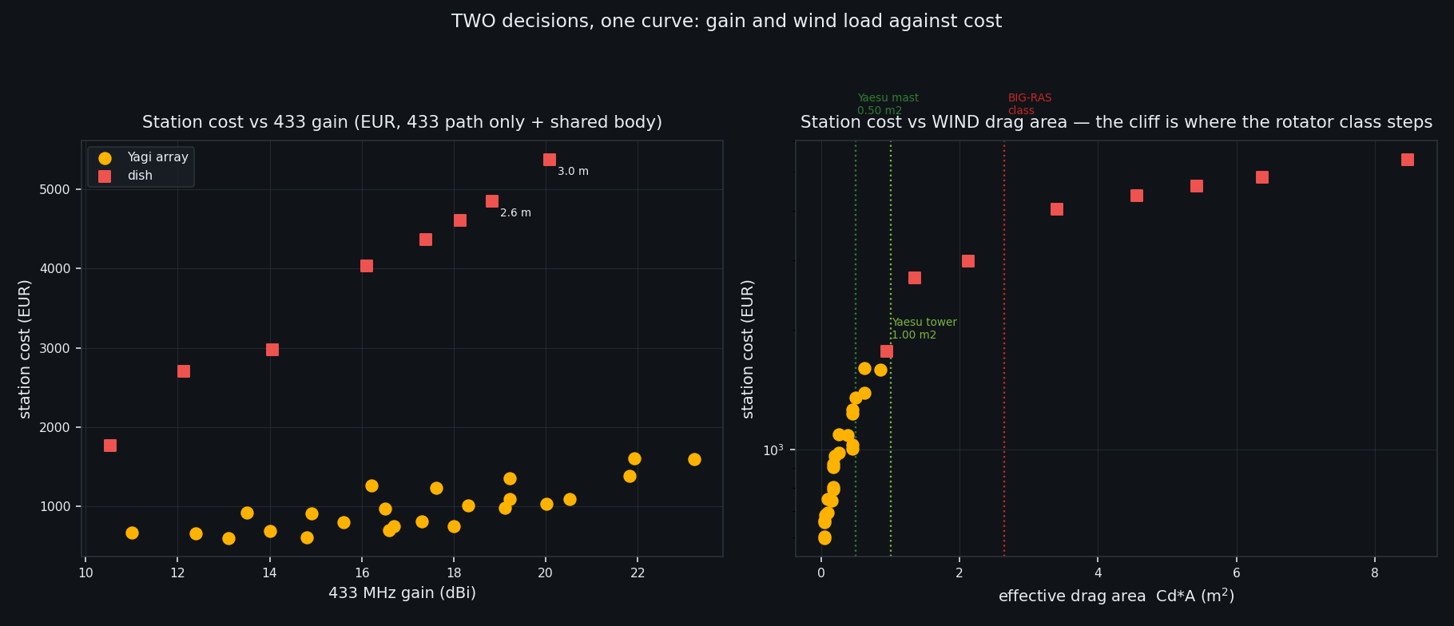
docs/analysis/assets/gain-per-dollar/fig3-frontier.png
