c03rad0r/balloon-fresh-1/docs/analysis/assets/ground-station-amp-vs-ant-figure.png

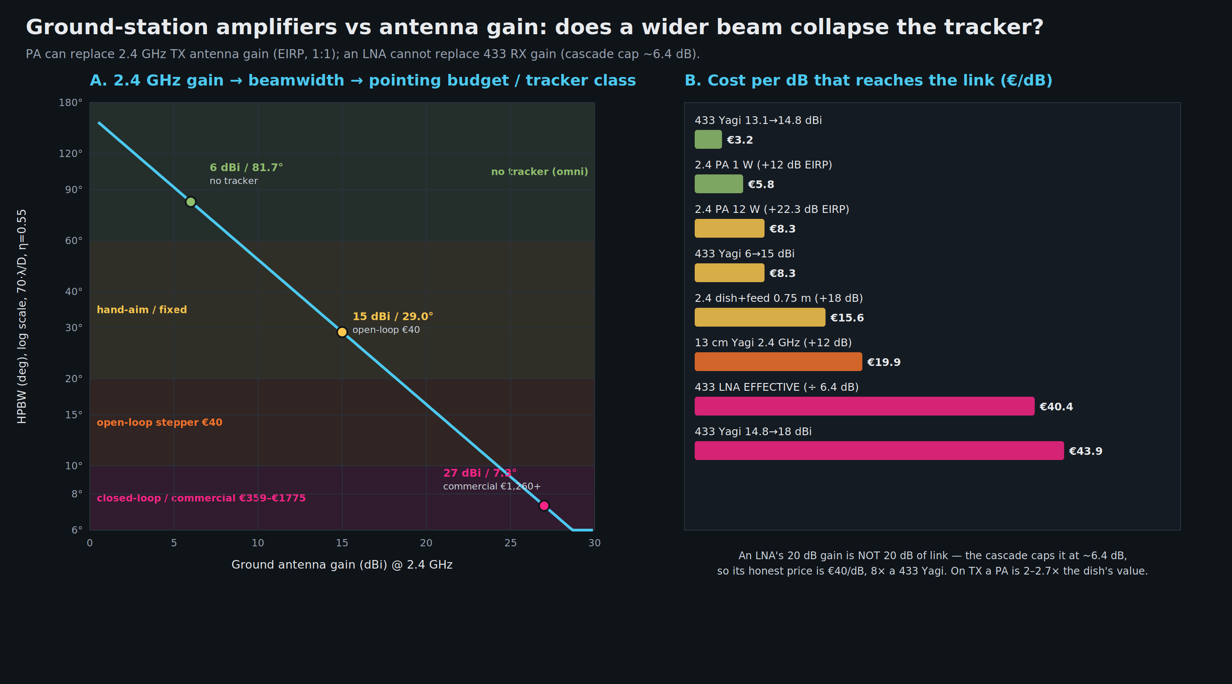
docs/analysis/assets/ground-station-amp-vs-ant-figure.png
