c03rad0r/balloon-fresh-1/docs/analysis/assets/ground-station-plan-summary.png

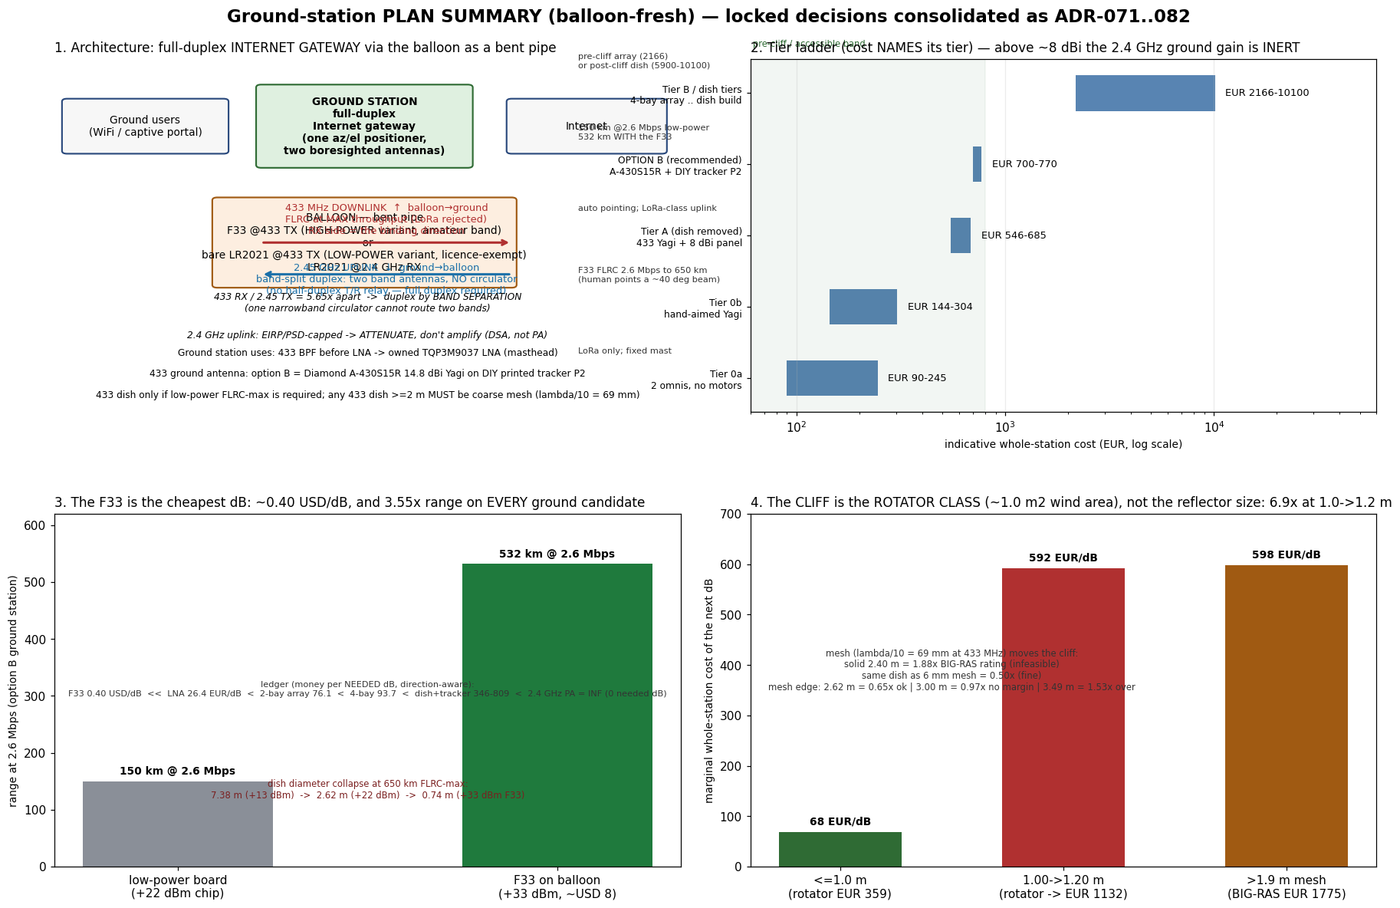
docs/analysis/assets/ground-station-plan-summary.png
