c03rad0r/balloon-fresh-1/docs/analysis/assets/level-control/dynamic-range-budget.png

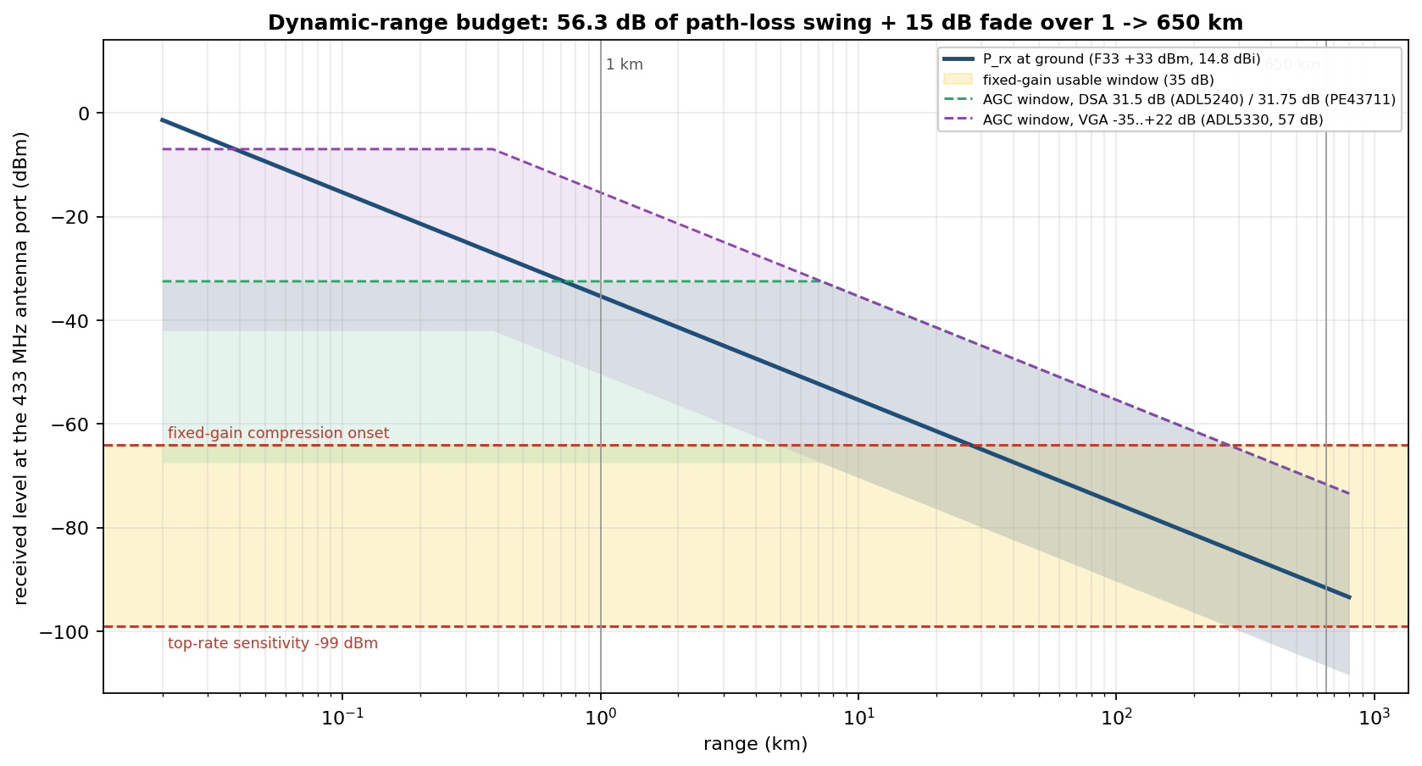
docs/analysis/assets/level-control/dynamic-range-budget.png
