c03rad0r/balloon-fresh-1/docs/analysis/assets/lowpower-link-verdict.png

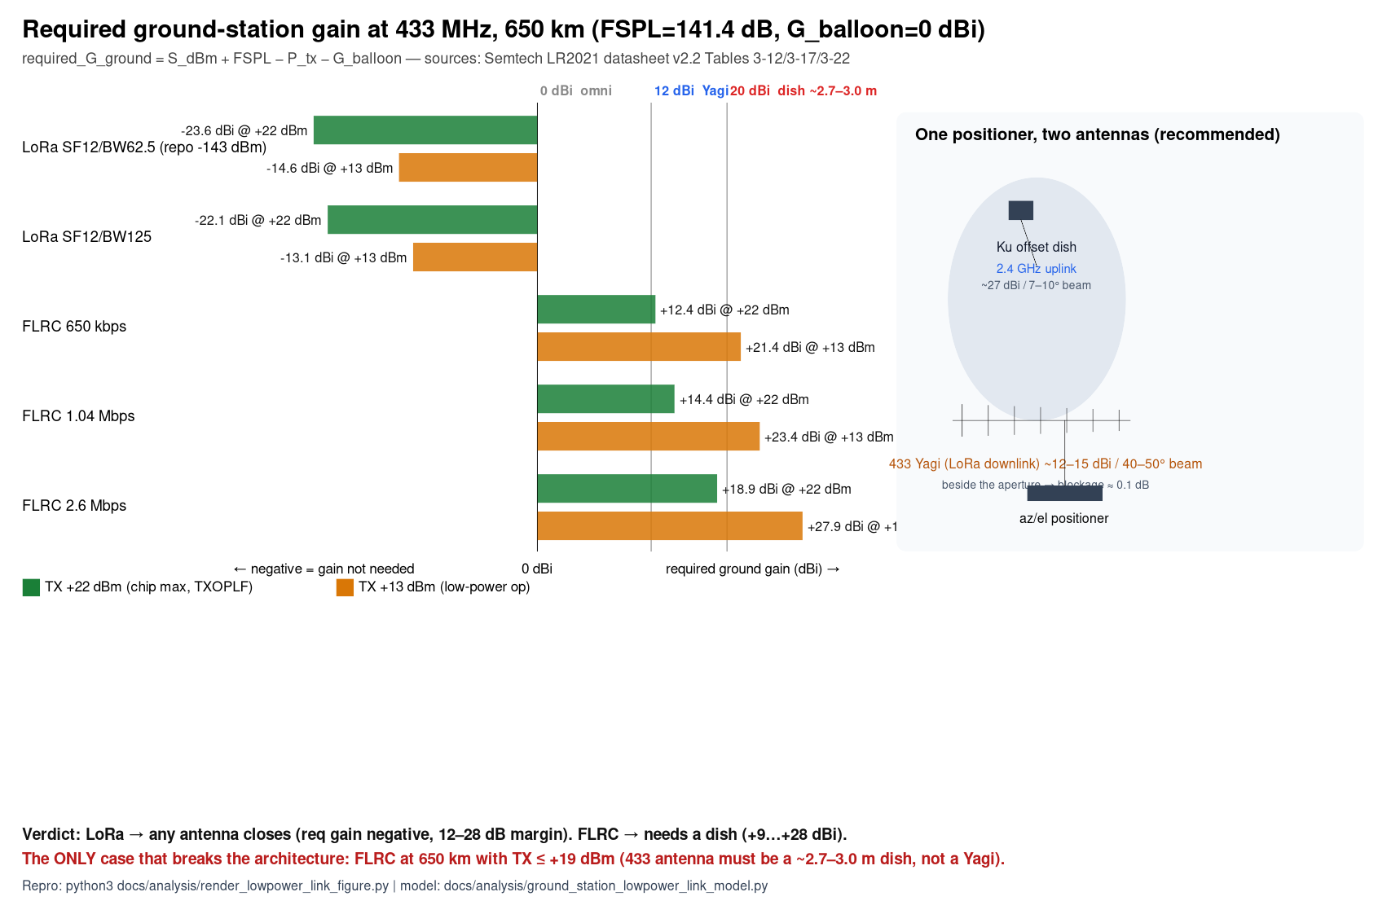
docs/analysis/assets/lowpower-link-verdict.png
