c03rad0r/balloon-fresh-1/docs/analysis/assets/rf-gaps/ruze-2g4-surface-error.png

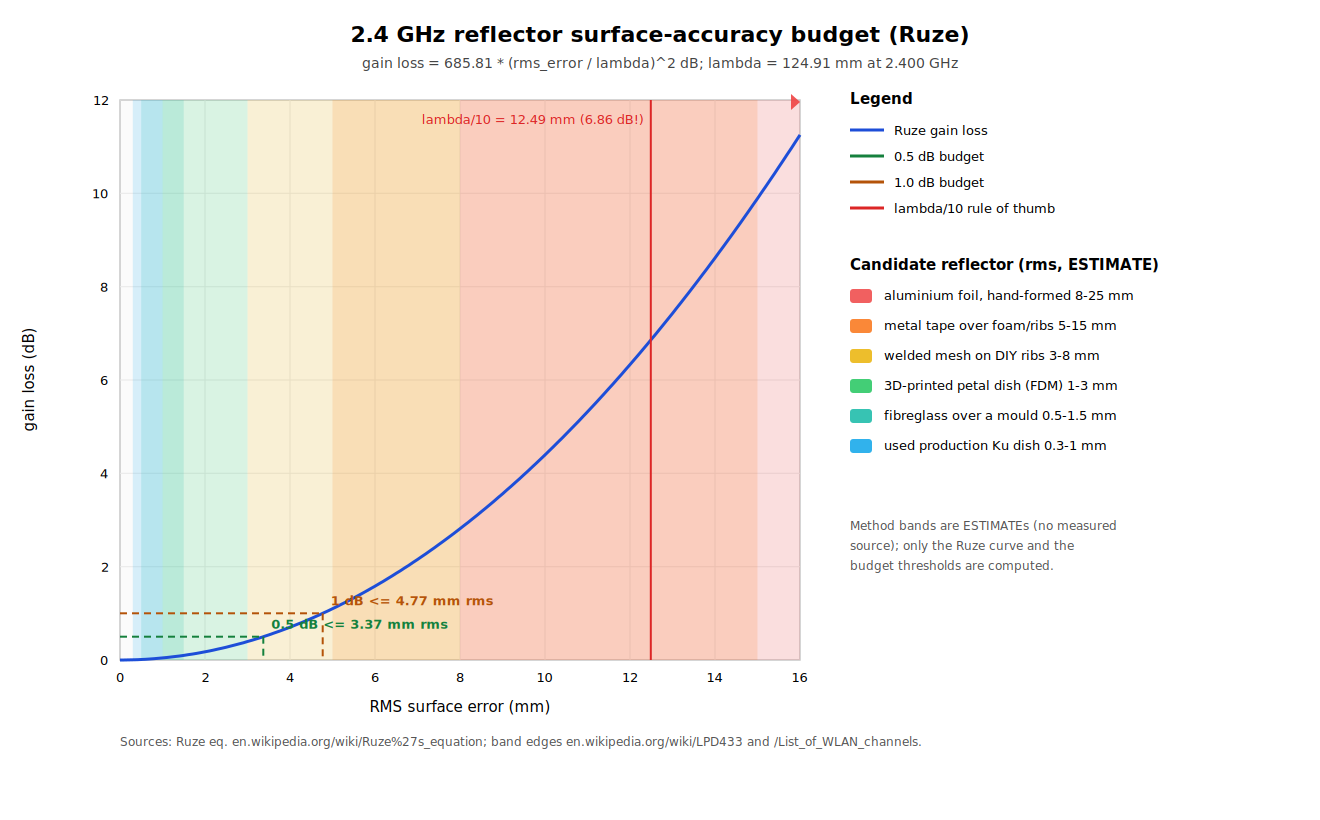
docs/analysis/assets/rf-gaps/ruze-2g4-surface-error.png
