c03rad0r/balloon-fresh-1/docs/analysis/board-status/board-status-v9.png

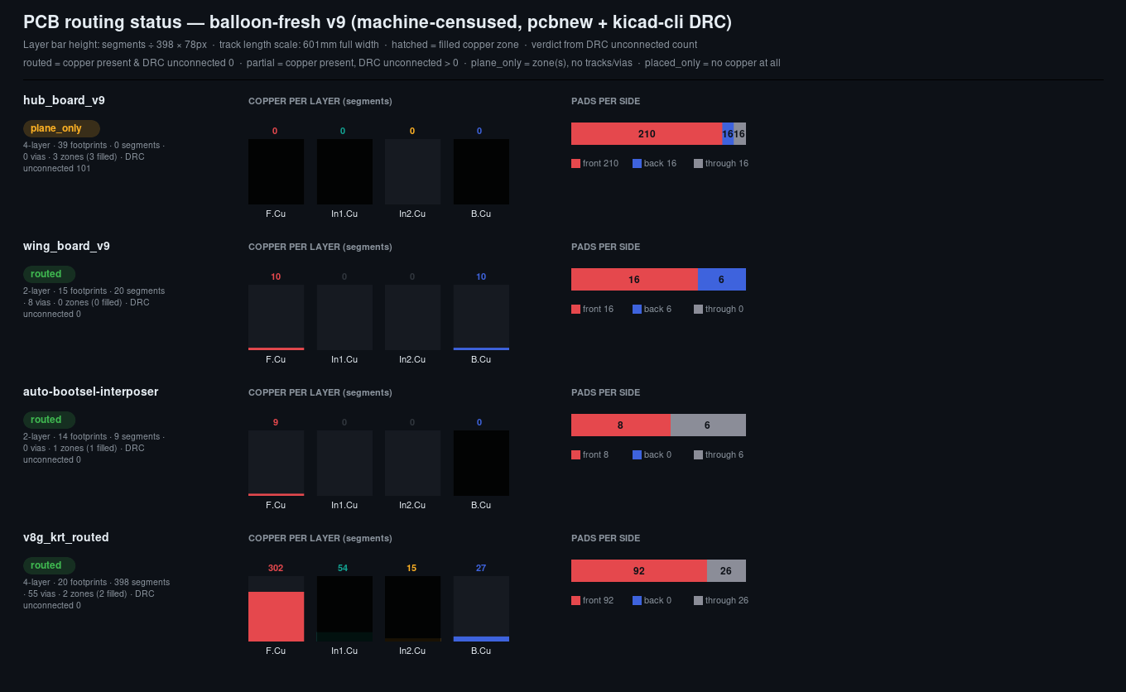
docs/analysis/board-status/board-status-v9.png
