c03rad0r/balloon-fresh-1/docs/analysis/figures/positioner-rightsizing.png

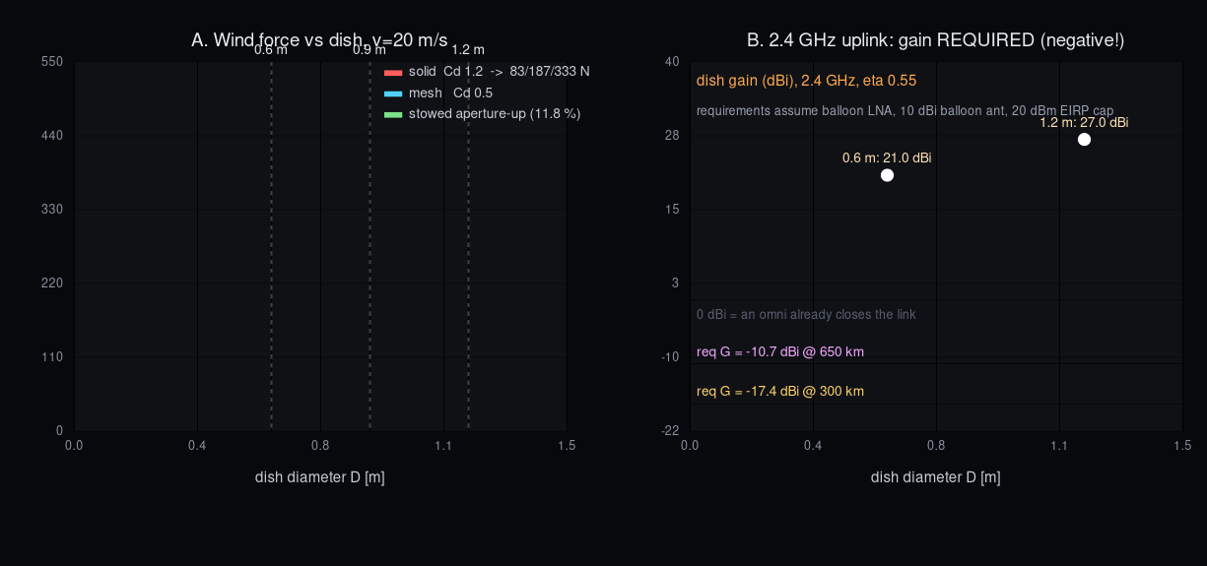
docs/analysis/figures/positioner-rightsizing.png
