c03rad0r/balloon-fresh-1/docs/analysis/figures/tier0-eirp-capped-uplink.png

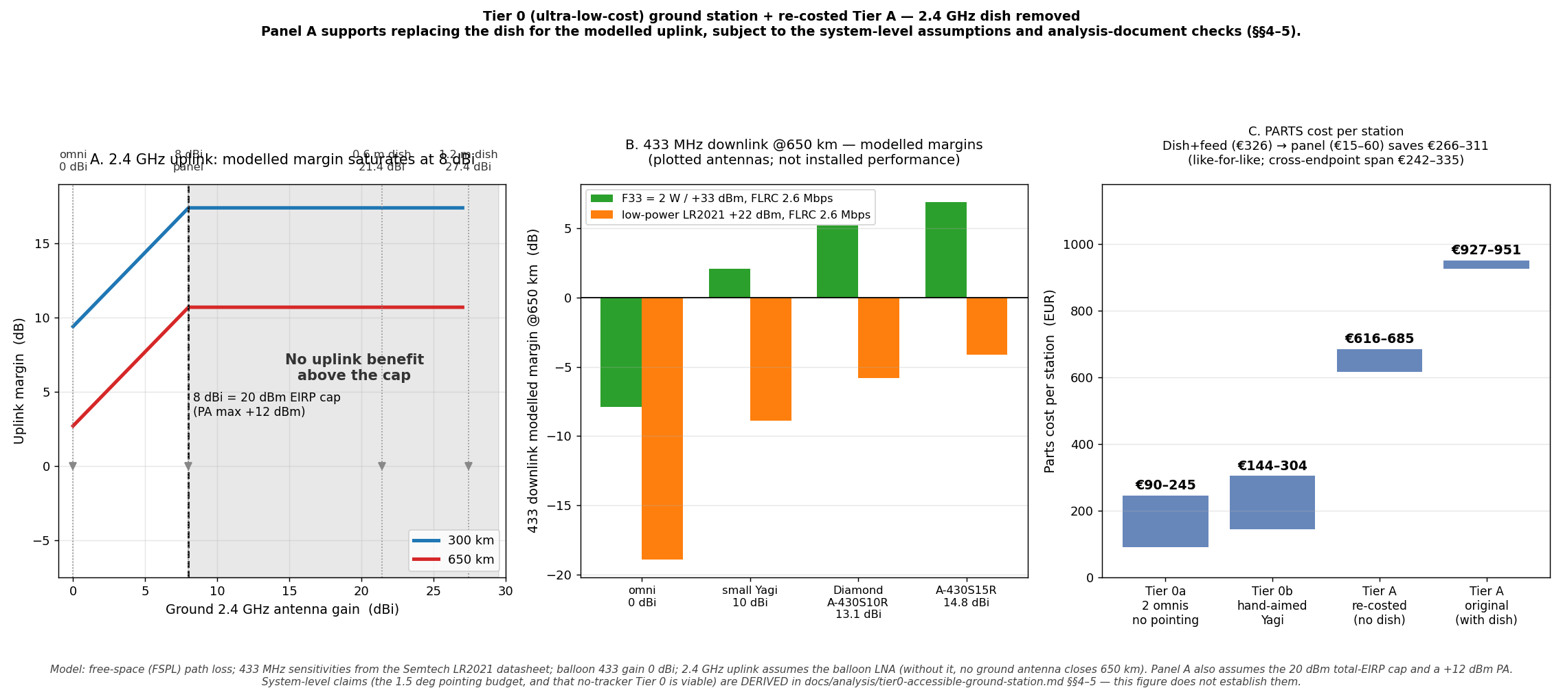
docs/analysis/figures/tier0-eirp-capped-uplink.png
