c03rad0r/balloon-fresh-1/docs/analysis/out/balloon_altitude_vs_payload.png

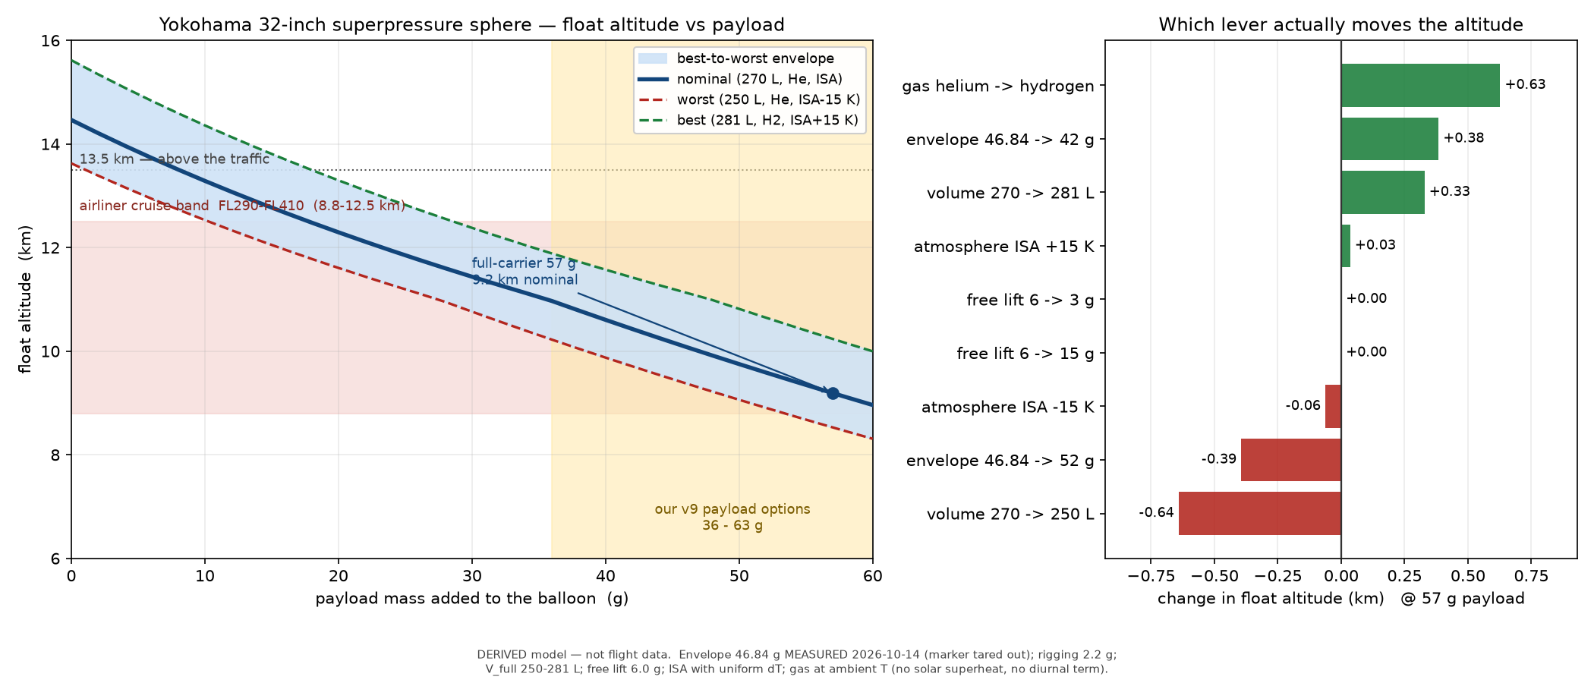
docs/analysis/out/balloon_altitude_vs_payload.png
