c03rad0r/balloon-fresh-1/docs/analysis/telco-g1-g2-g3-services.png

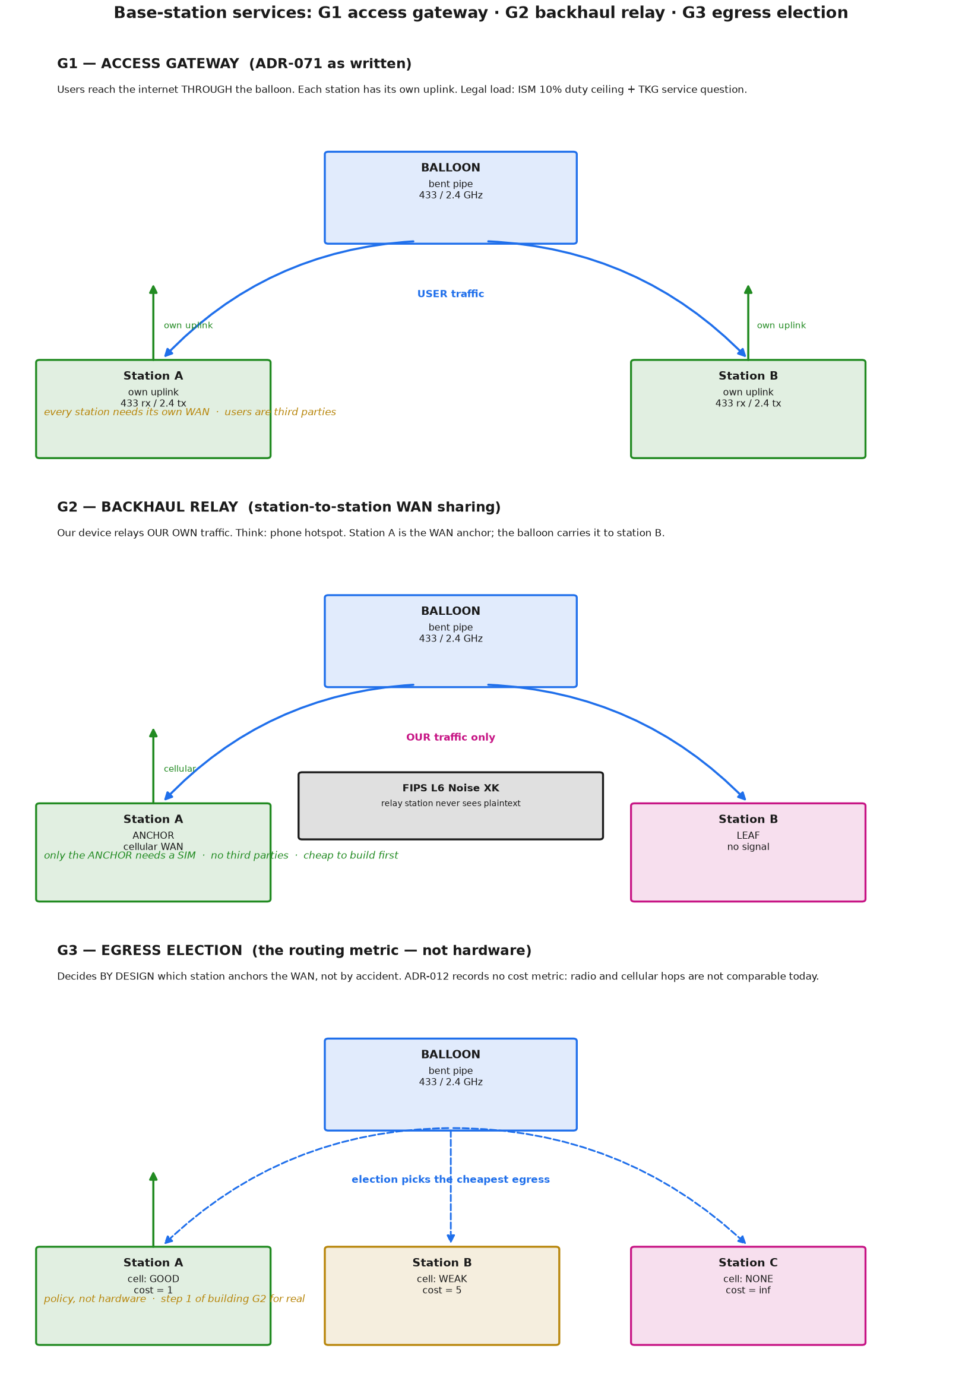
docs/analysis/telco-g1-g2-g3-services.png
