c03rad0r/balloon-fresh-1/docs/analysis/telco-topology-options.png

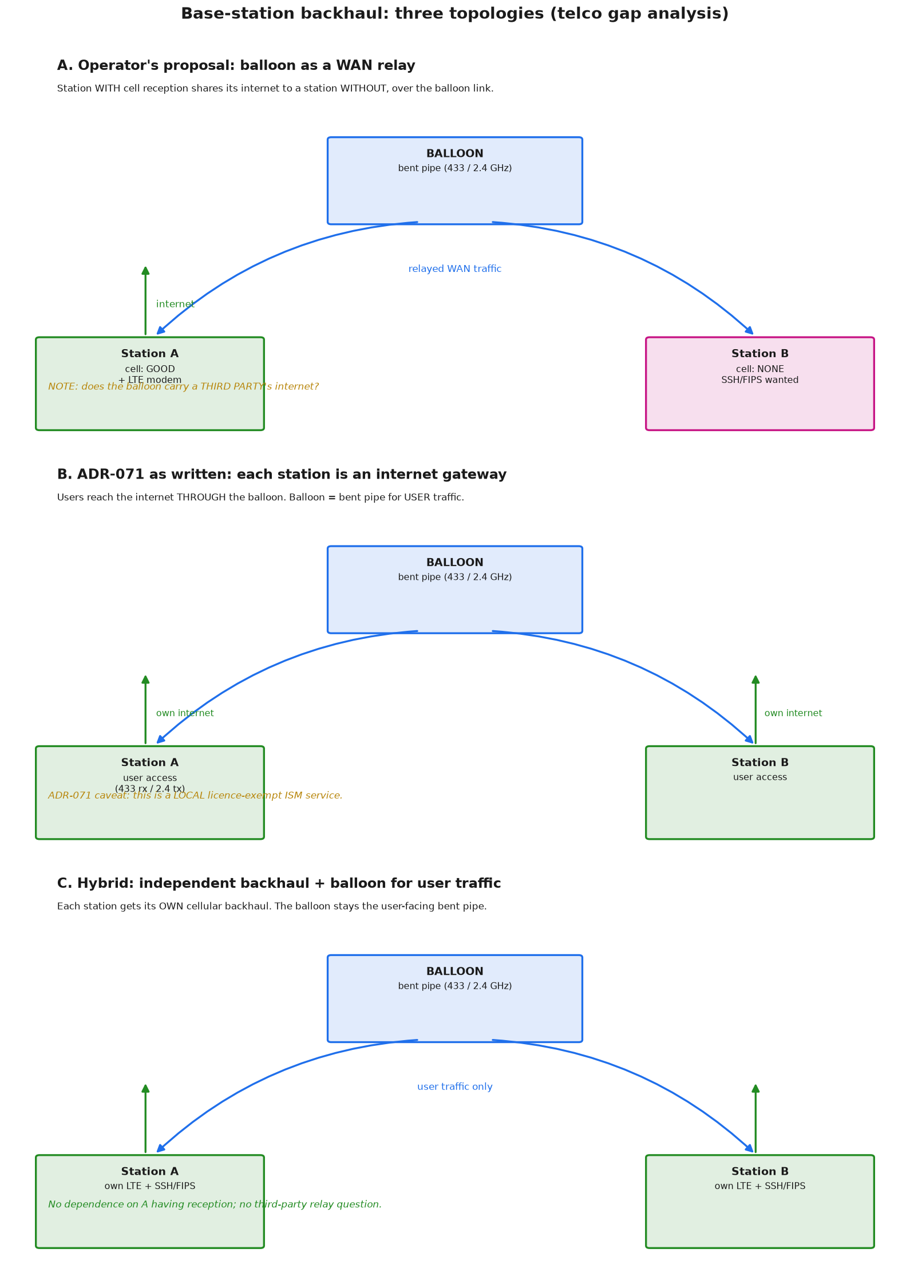
docs/analysis/telco-topology-options.png
