c03rad0r/balloon-fresh-1/docs/analysis/vertical-hub-load-cases.png

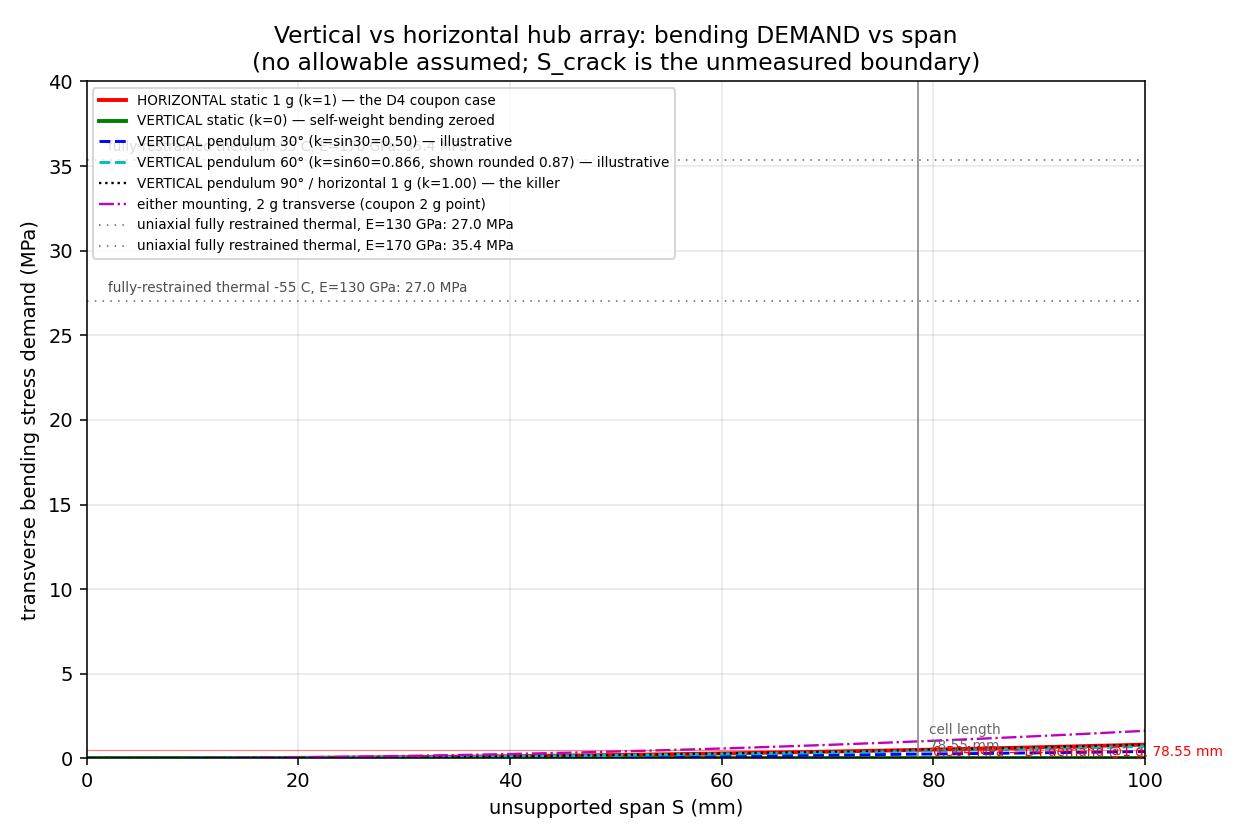
docs/analysis/vertical-hub-load-cases.png
