c03rad0r/balloon-fresh-1/docs/boards/base-station.png

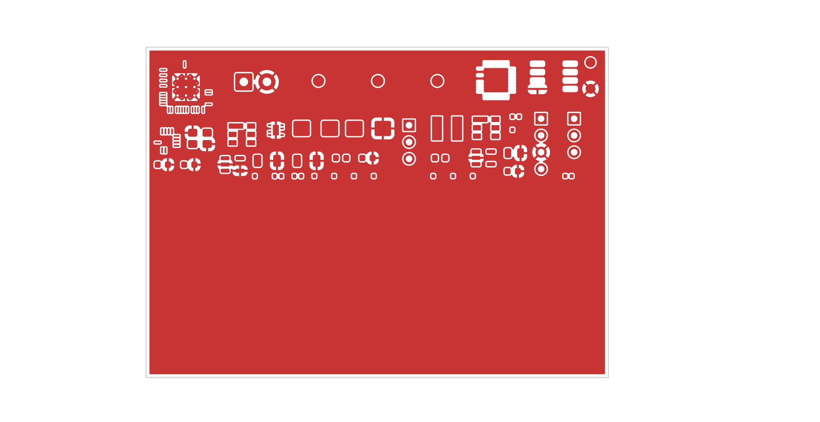
docs/boards/base-station.png
