c03rad0r/balloon-fresh-1/docs/boards/hub-v9.png

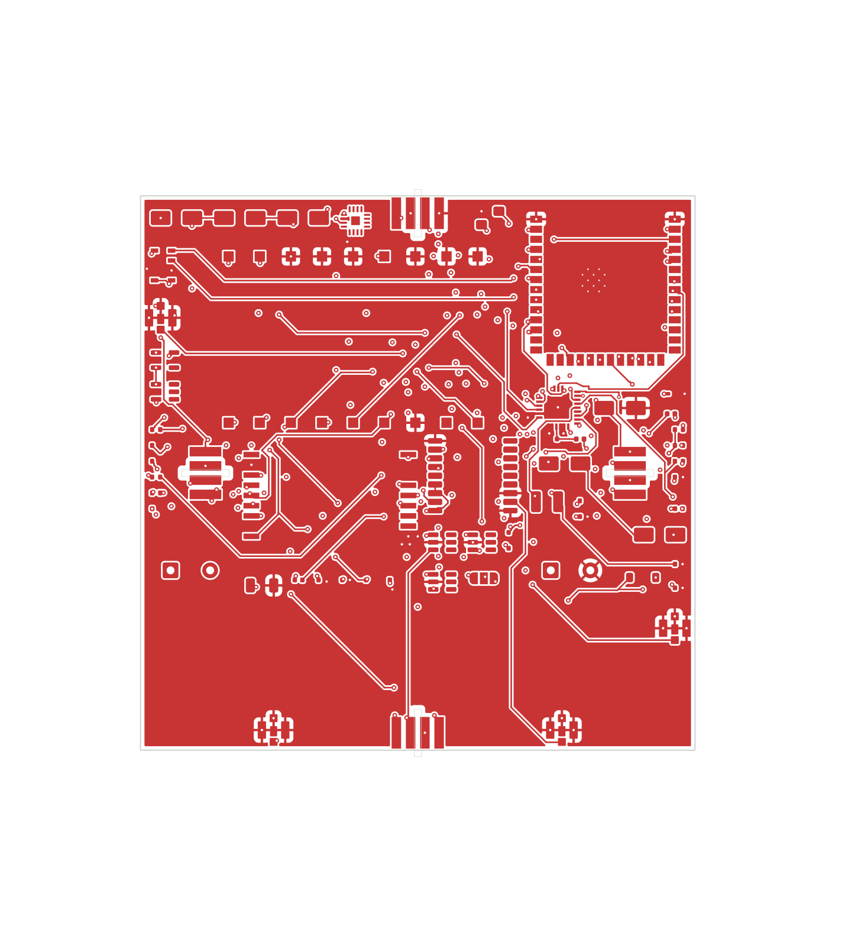
docs/boards/hub-v9.png
