c03rad0r/balloon-fresh-1/docs/boards/wing-v9.png

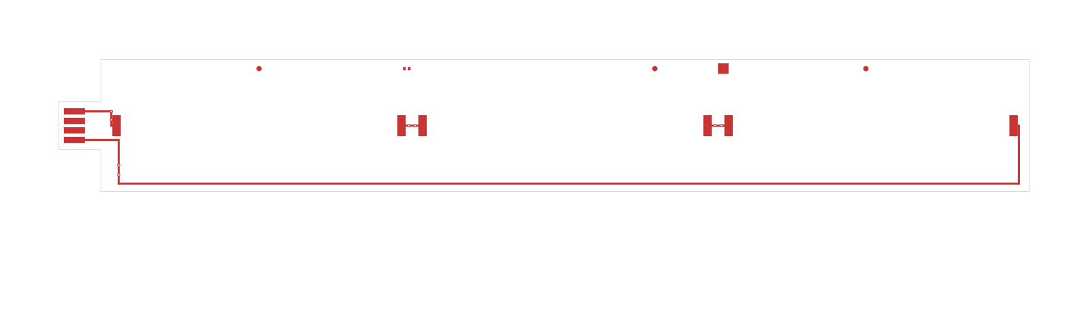
docs/boards/wing-v9.png
