c03rad0r/balloon-fresh-1/docs/esp32-c3-pinout.jpg

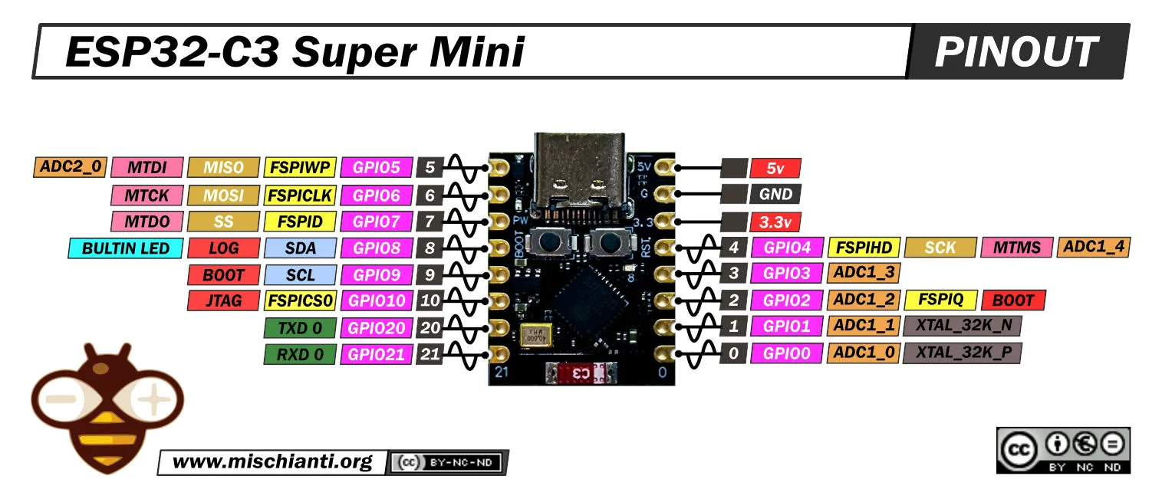
docs/esp32-c3-pinout.jpg
