c03rad0r/balloon-fresh-1/docs/fab/handoff/B.Cu.png

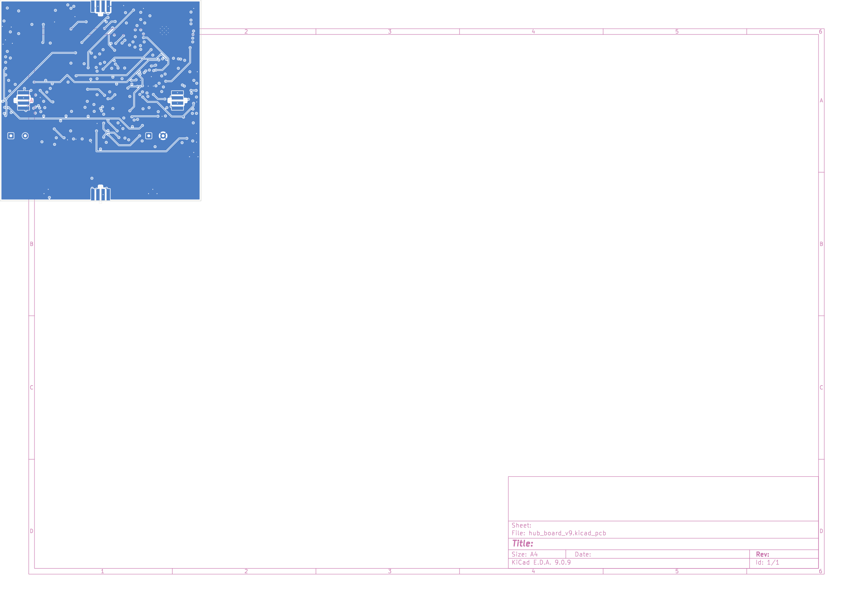
docs/fab/handoff/B.Cu.png
