c03rad0r/balloon-fresh-1/docs/fab/hub-v9/peel-coupon-specimens.png

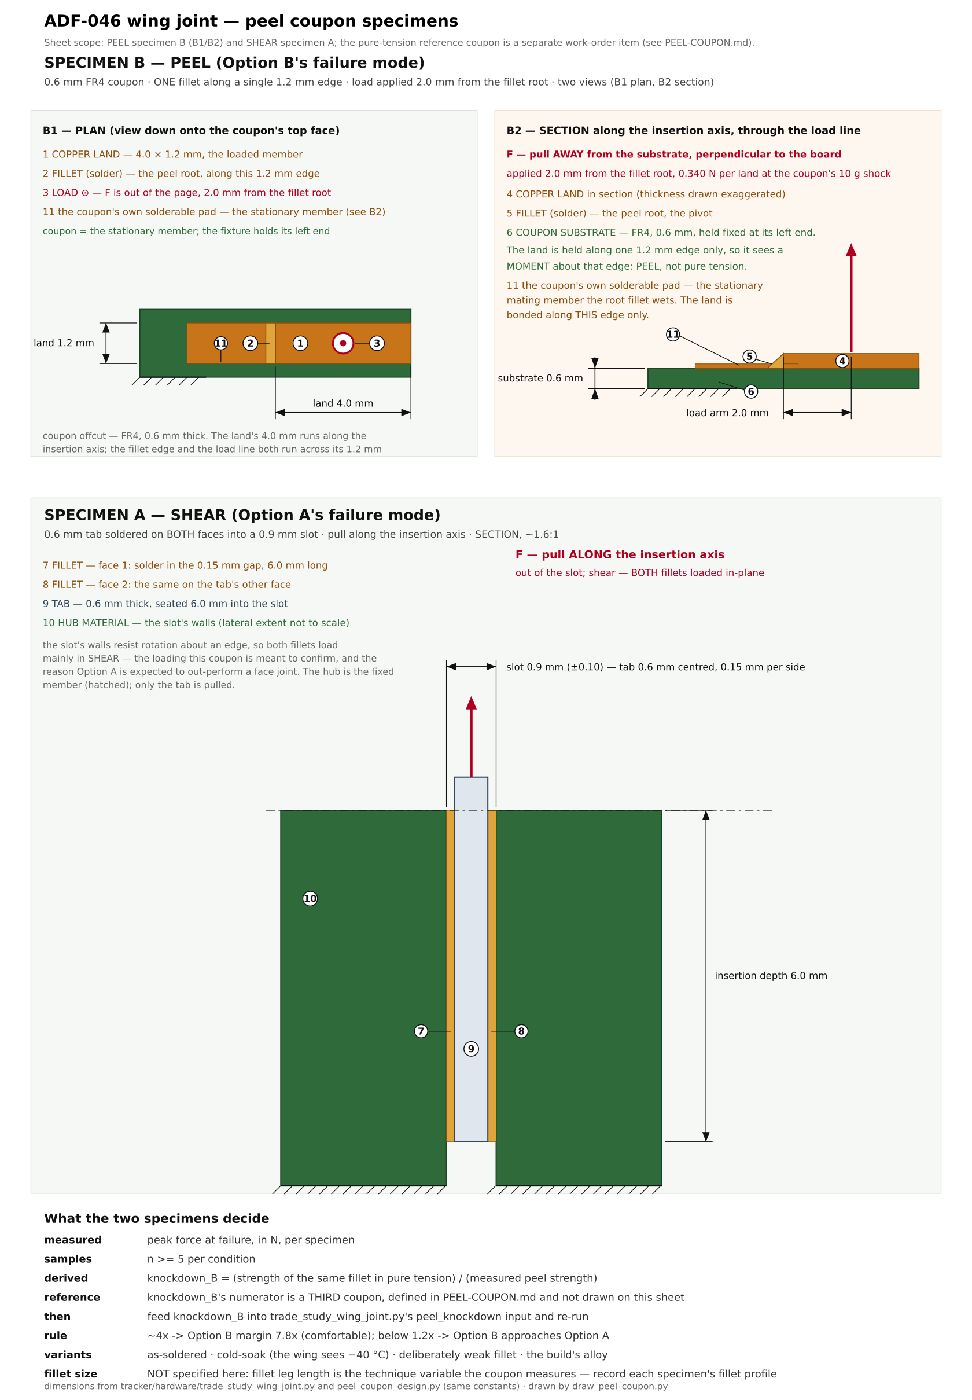
docs/fab/hub-v9/peel-coupon-specimens.png
