c03rad0r/balloon-fresh-1/docs/fab/jlc-query/edge-launch-cross-section.png

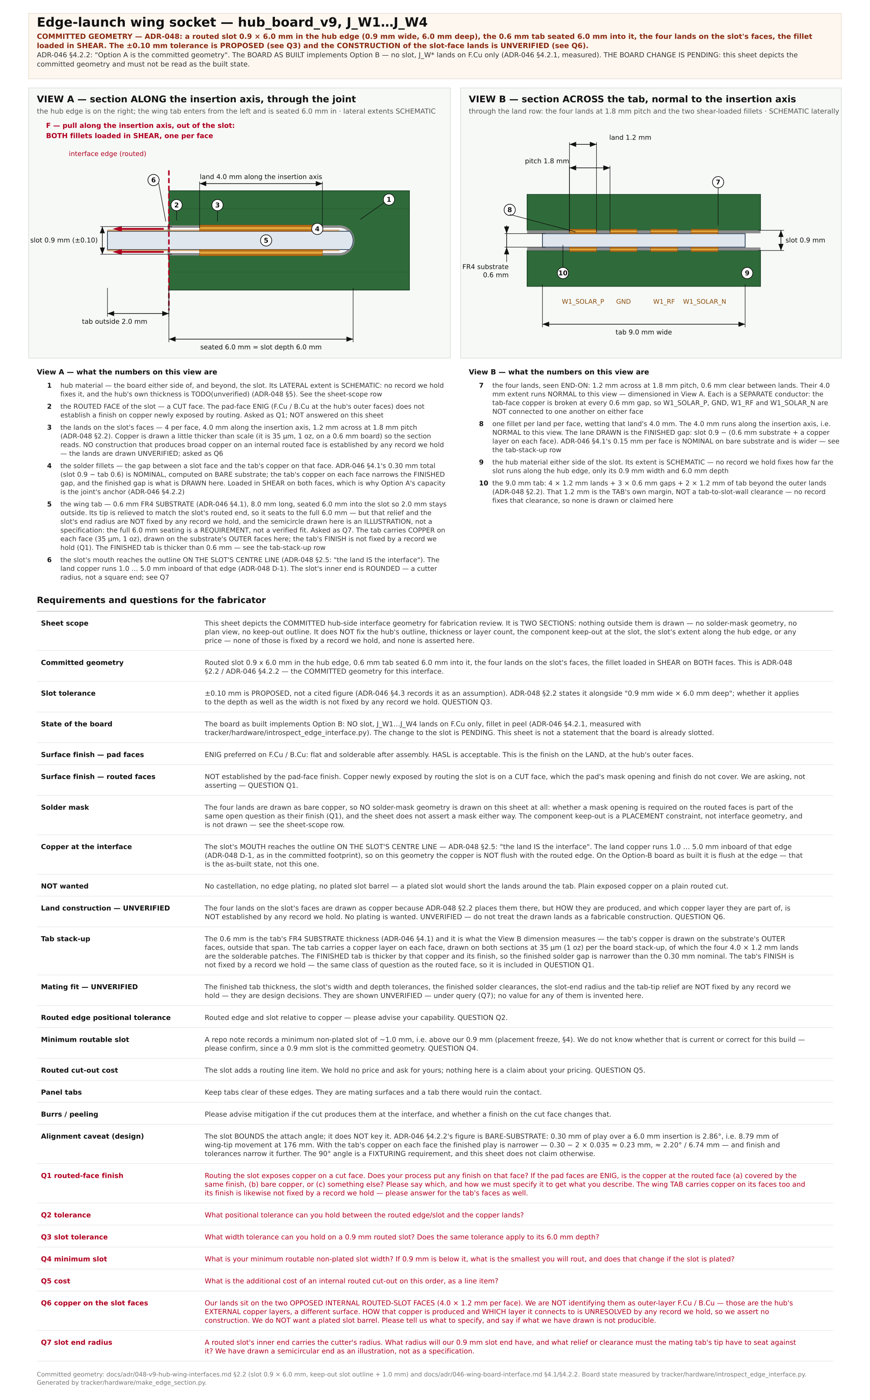
docs/fab/jlc-query/edge-launch-cross-section.png
