c03rad0r/balloon-fresh-1/docs/fab/jlc-query/u413-open-ground.png

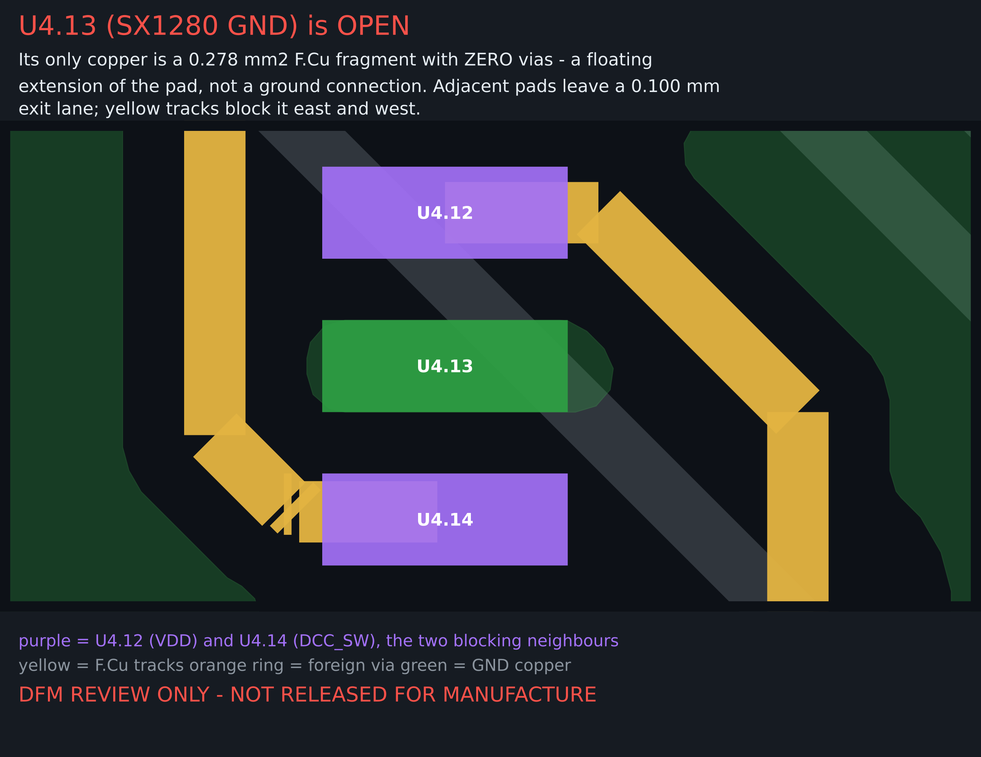
docs/fab/jlc-query/u413-open-ground.png
