c03rad0r/balloon-fresh-1/docs/fab/reviews/u1-pad-field.png

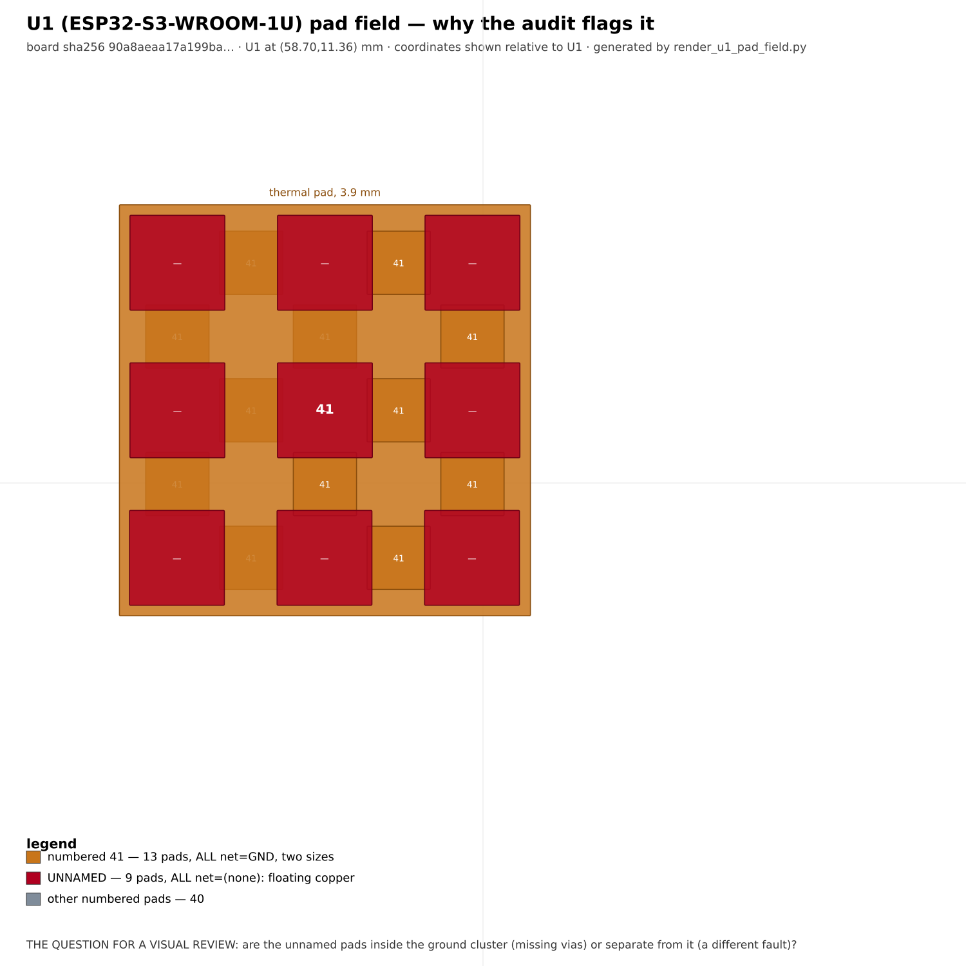
docs/fab/reviews/u1-pad-field.png
