c03rad0r/balloon-fresh-1/docs/fab/status/hub-antenna-volumes.png

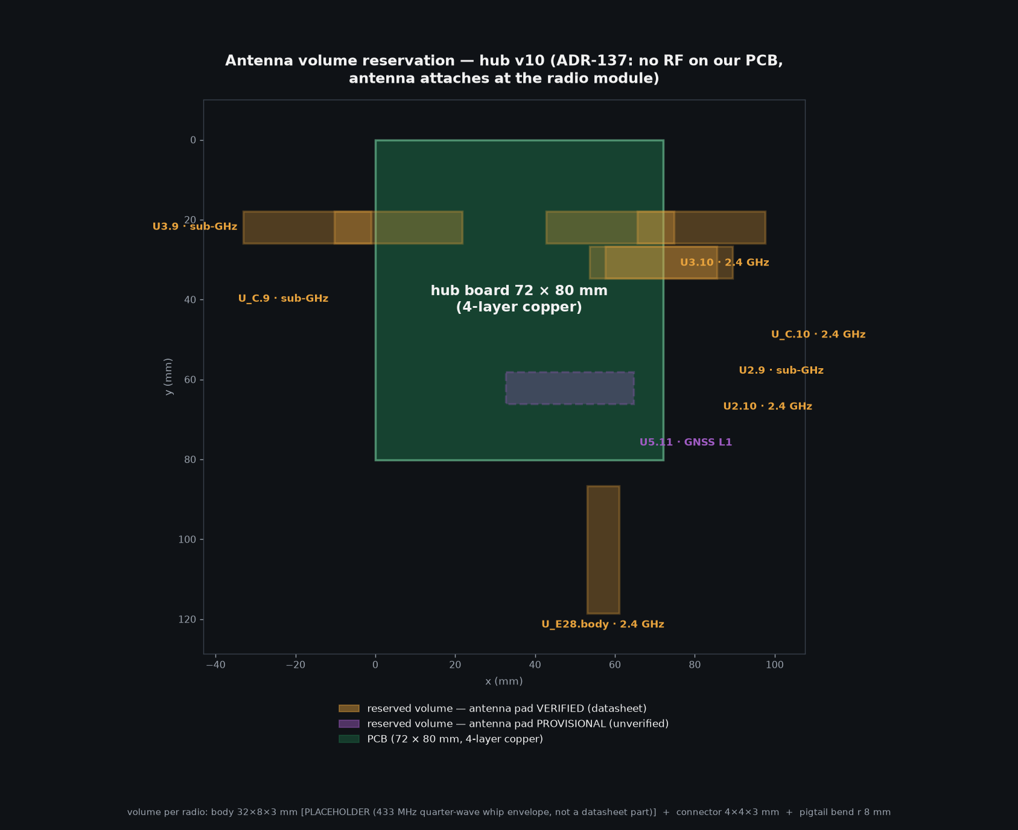
docs/fab/status/hub-antenna-volumes.png
