c03rad0r/balloon-fresh-1/docs/fab/status/hub-radio-options.png

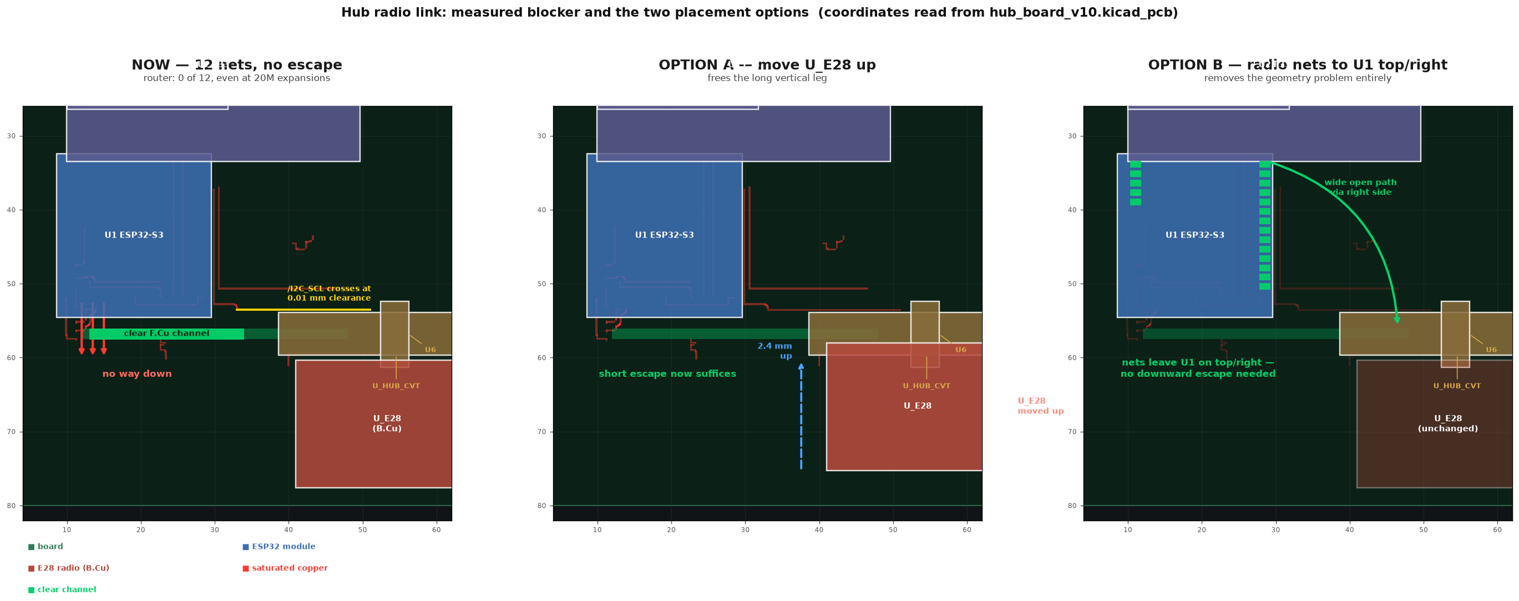
docs/fab/status/hub-radio-options.png
