c03rad0r/balloon-fresh-1/docs/fab/status/hub_v10_master.png

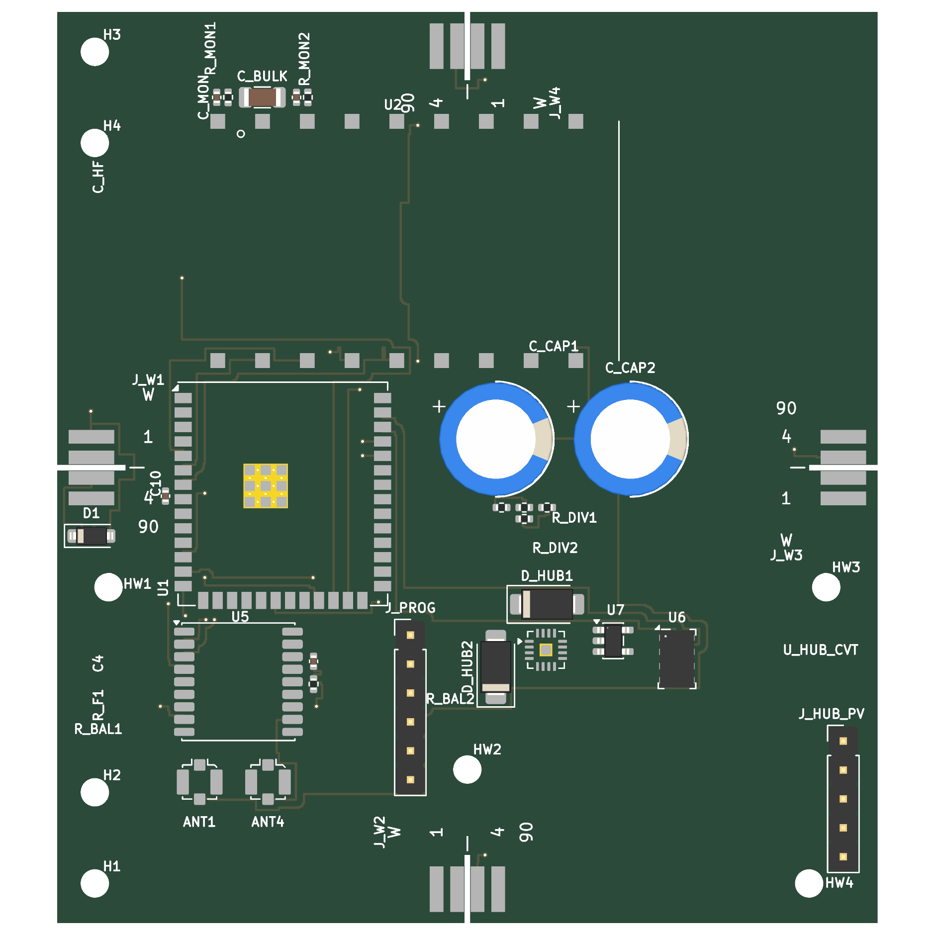
docs/fab/status/hub_v10_master.png
