c03rad0r/balloon-fresh-1/docs/fab/status/lora1280-3d-bottom.png

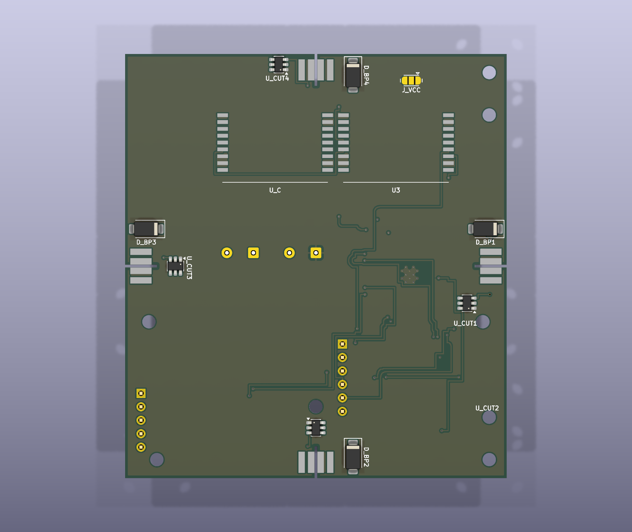
docs/fab/status/lora1280-3d-bottom.png
