c03rad0r/balloon-fresh-1/docs/fab/status/lora1280-7of9-2d.png

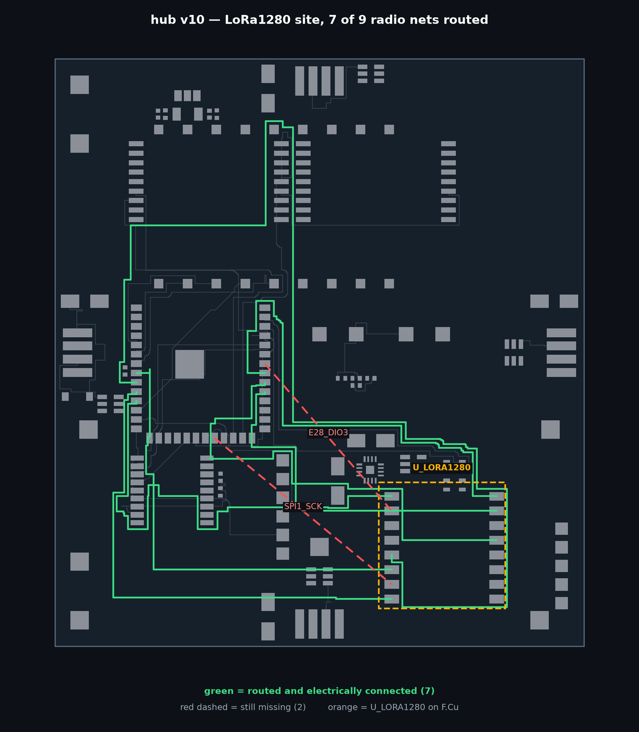
docs/fab/status/lora1280-7of9-2d.png
