c03rad0r/balloon-fresh-1/docs/fab/status/lora1280-clearance-5.png

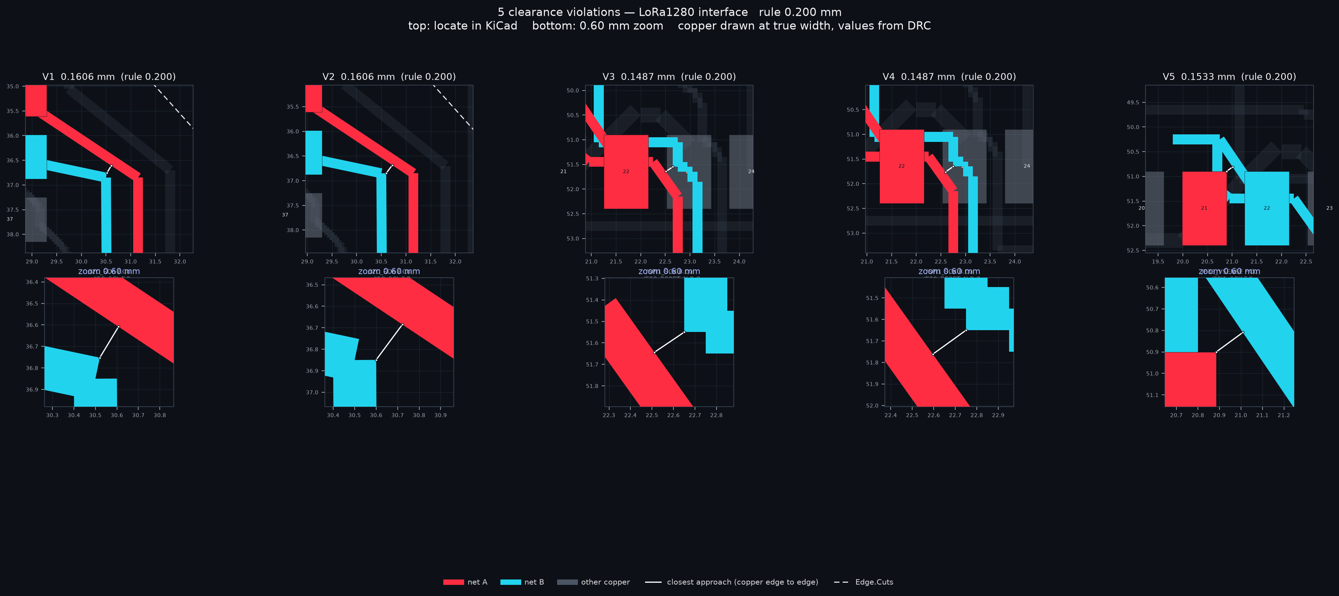
docs/fab/status/lora1280-clearance-5.png
