c03rad0r/balloon-fresh-1/docs/fab/status/router-independent-vs-repo.png

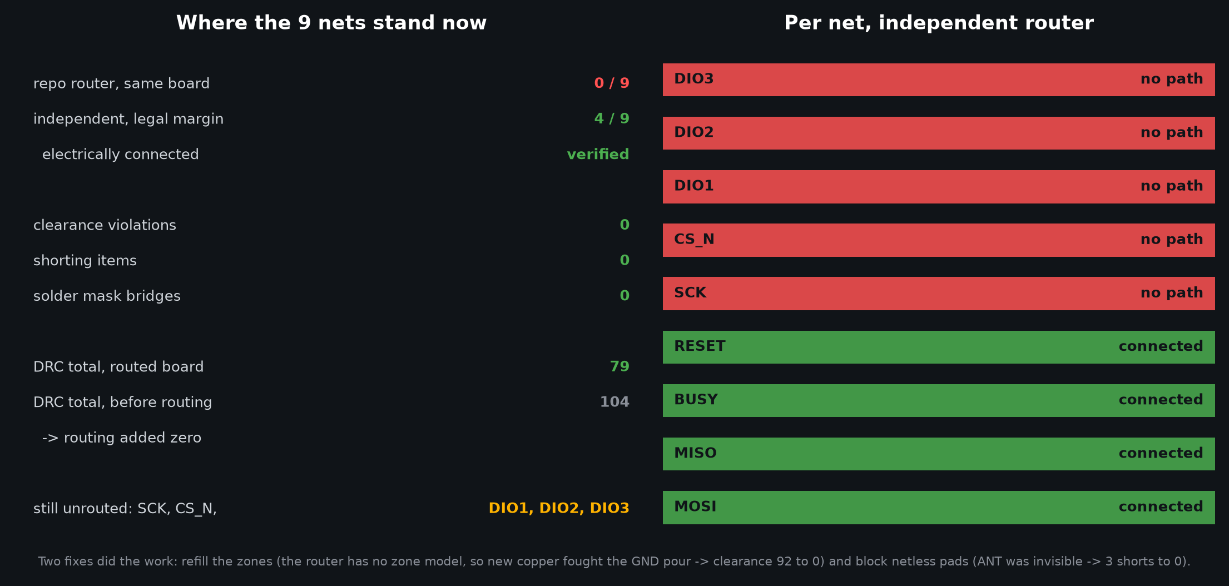
docs/fab/status/router-independent-vs-repo.png
