c03rad0r/balloon-fresh-1/docs/fab/status/wing_ic_master.png

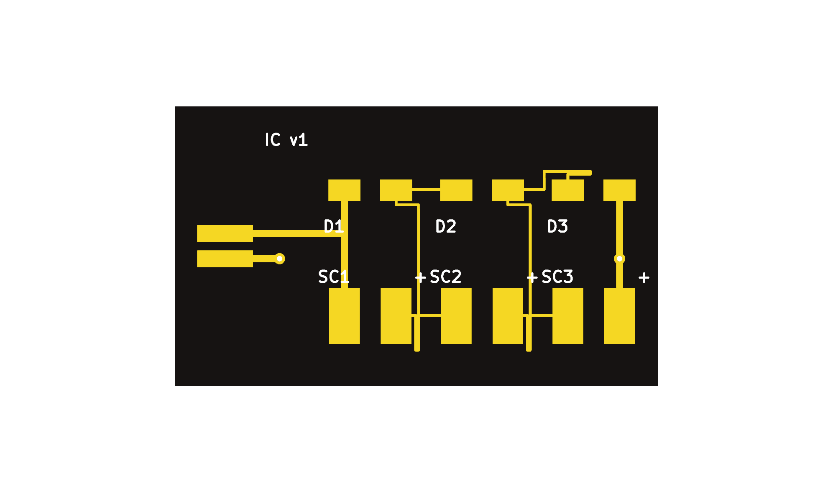
docs/fab/status/wing_ic_master.png
