c03rad0r/balloon-fresh-1/docs/fab/wing-3d/wing_interconnect_routed_bottom.png

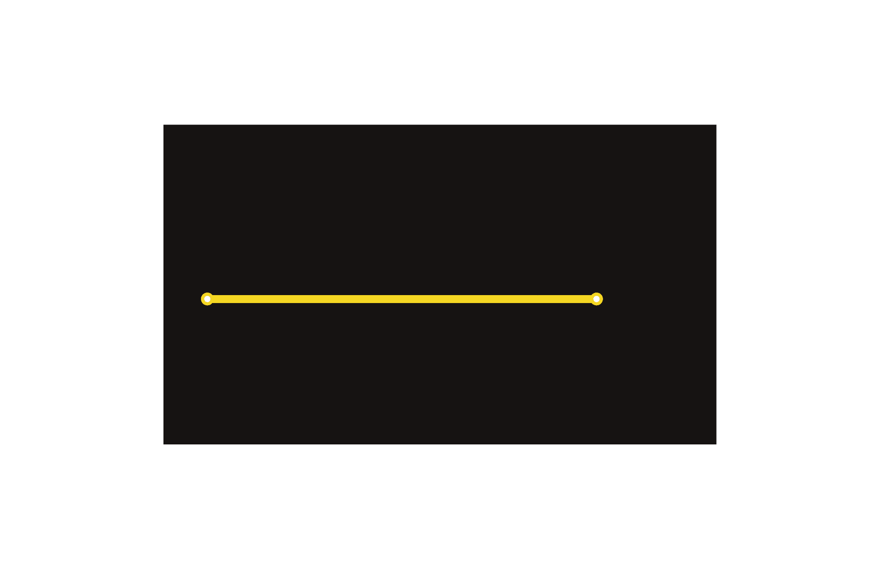
docs/fab/wing-3d/wing_interconnect_routed_bottom.png
