c03rad0r/balloon-fresh-1/docs/fab/wing-3d/wing_interconnect_v1.png

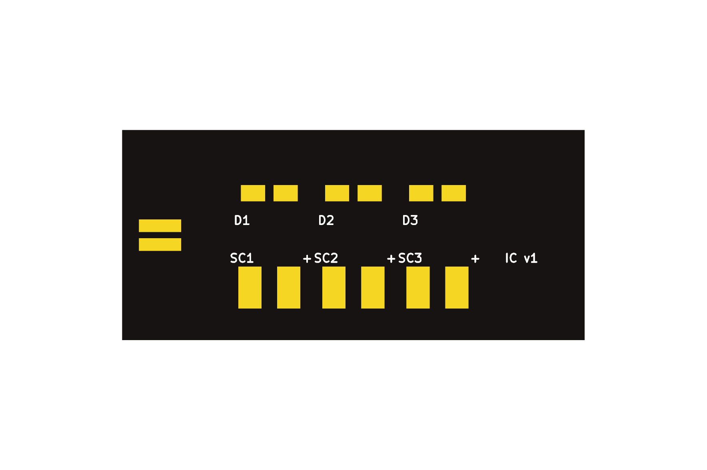
docs/fab/wing-3d/wing_interconnect_v1.png
