c03rad0r/balloon-fresh-1/docs/fab/wing-3d/wing_to_hub_interface.png

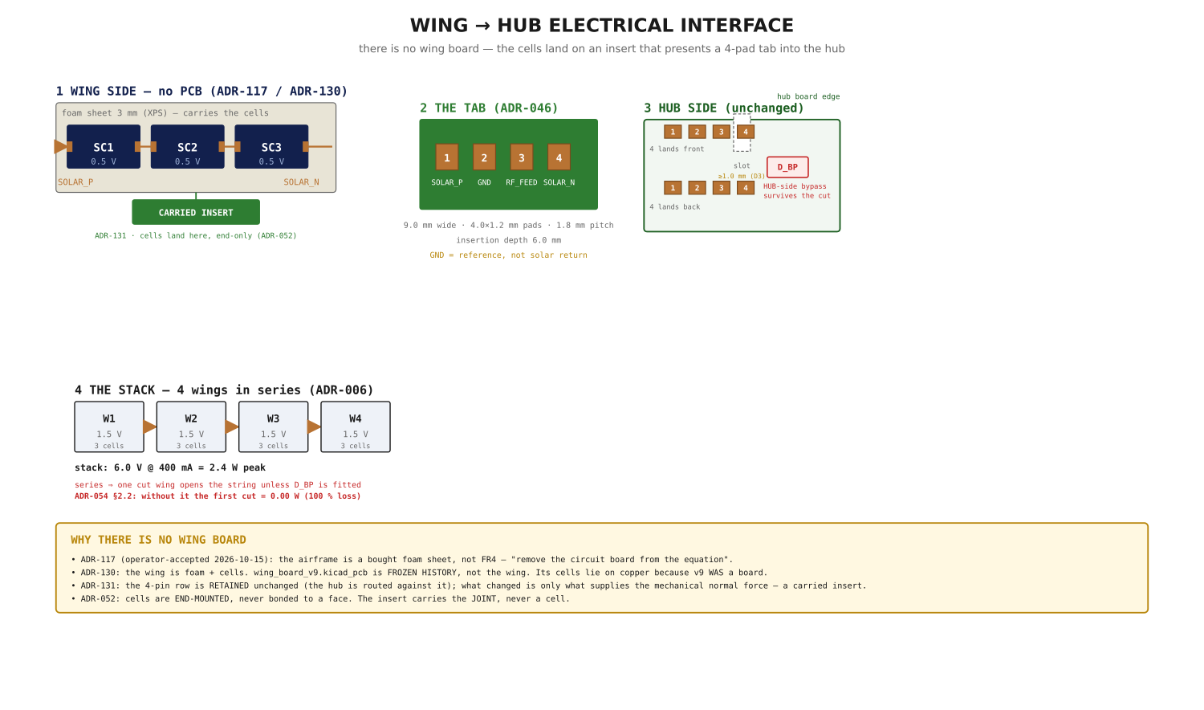
docs/fab/wing-3d/wing_to_hub_interface.png
