c03rad0r/balloon-fresh-1/docs/fab/wing-3d/wing_xps_3mm_BOTH_FACES.png

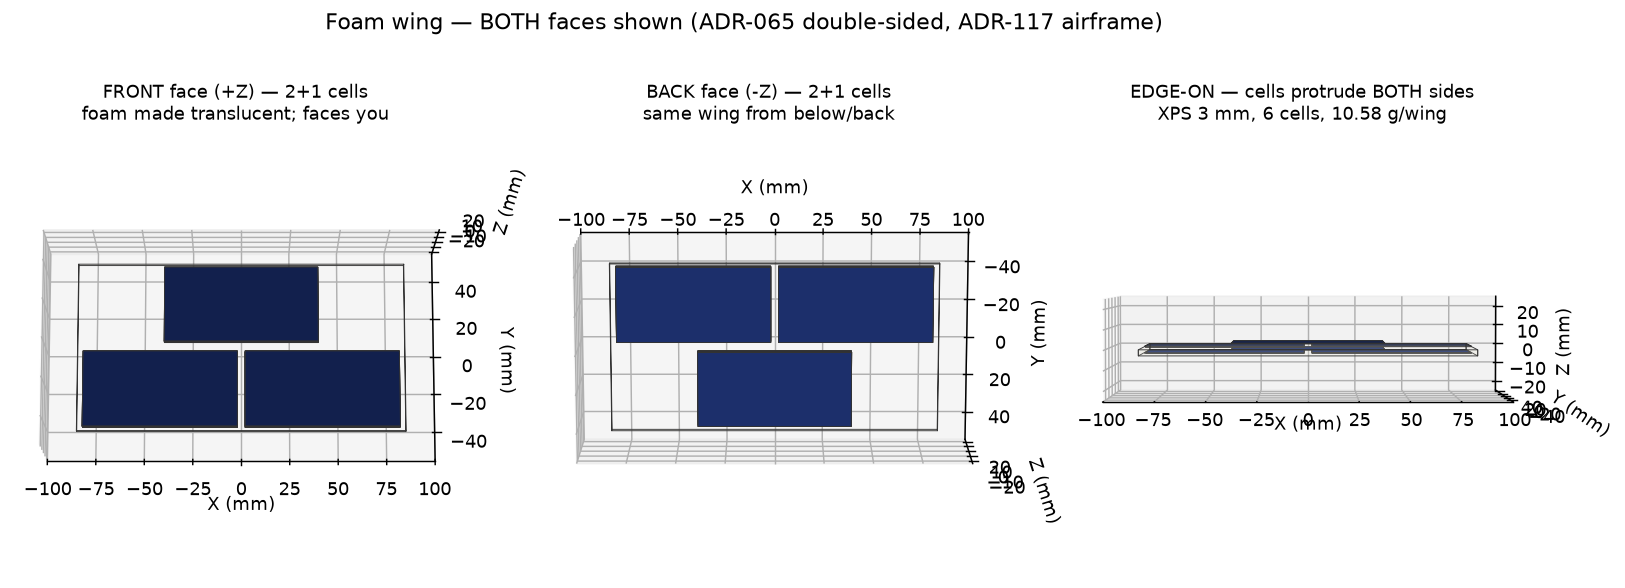
docs/fab/wing-3d/wing_xps_3mm_BOTH_FACES.png
