c03rad0r/balloon-fresh-1/docs/fab/wing-3d/wing_xps_3mm_EDGE_single.png

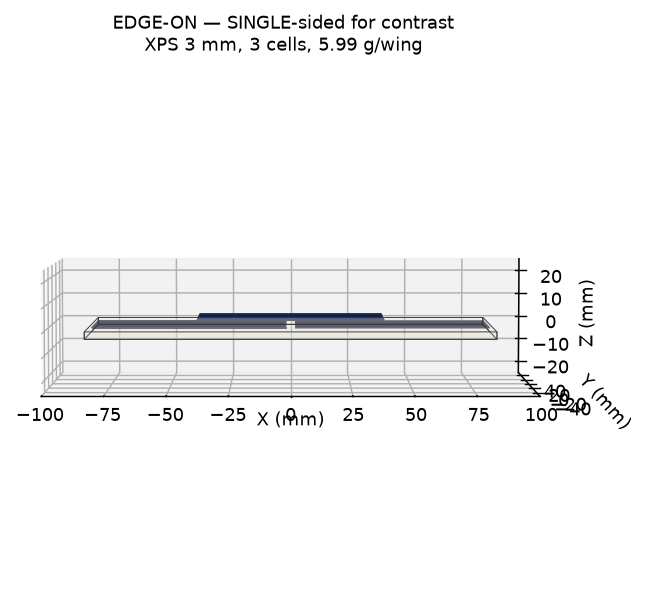
docs/fab/wing-3d/wing_xps_3mm_EDGE_single.png
