c03rad0r/balloon-fresh-1/docs/hardware-reference/rp2040-pinout.png

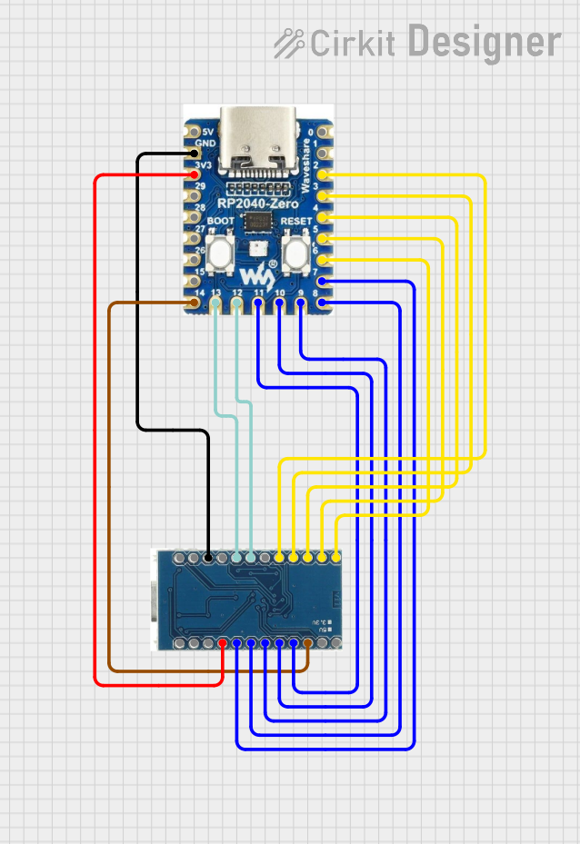
docs/hardware-reference/rp2040-pinout.png
