c03rad0r/balloon-fresh-1/docs/sx1280/Figure15-1-Application-Schematic.png

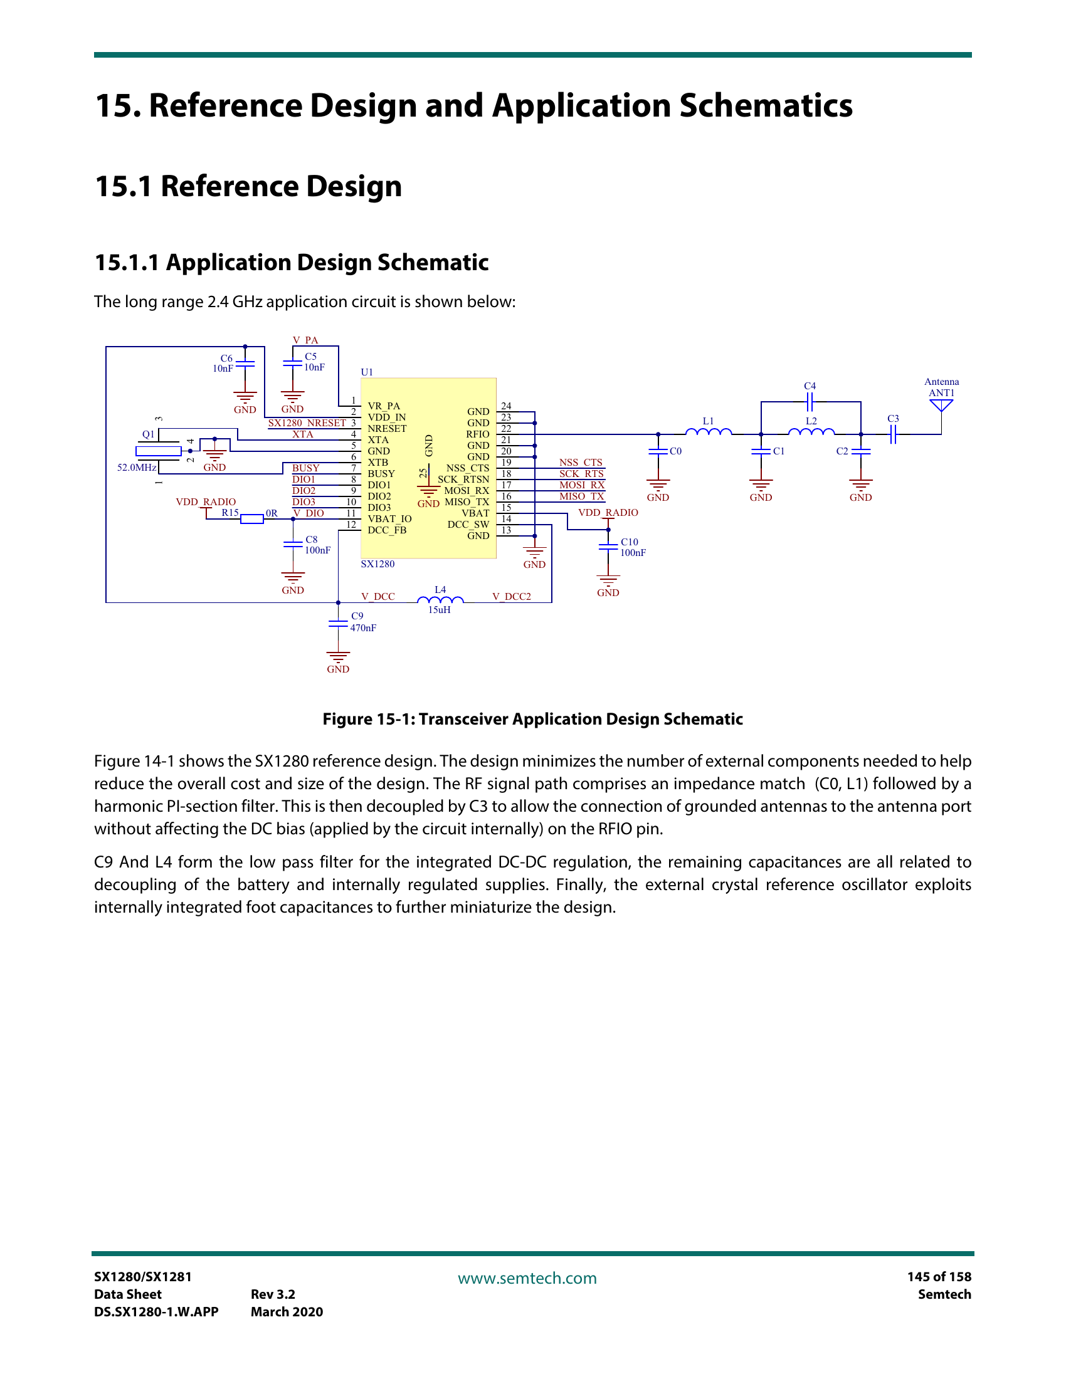
docs/sx1280/Figure15-1-Application-Schematic.png
