c03rad0r/balloon-fresh-1/docs/sx1280/Figure17-3-QFN4x4-LandPattern.png

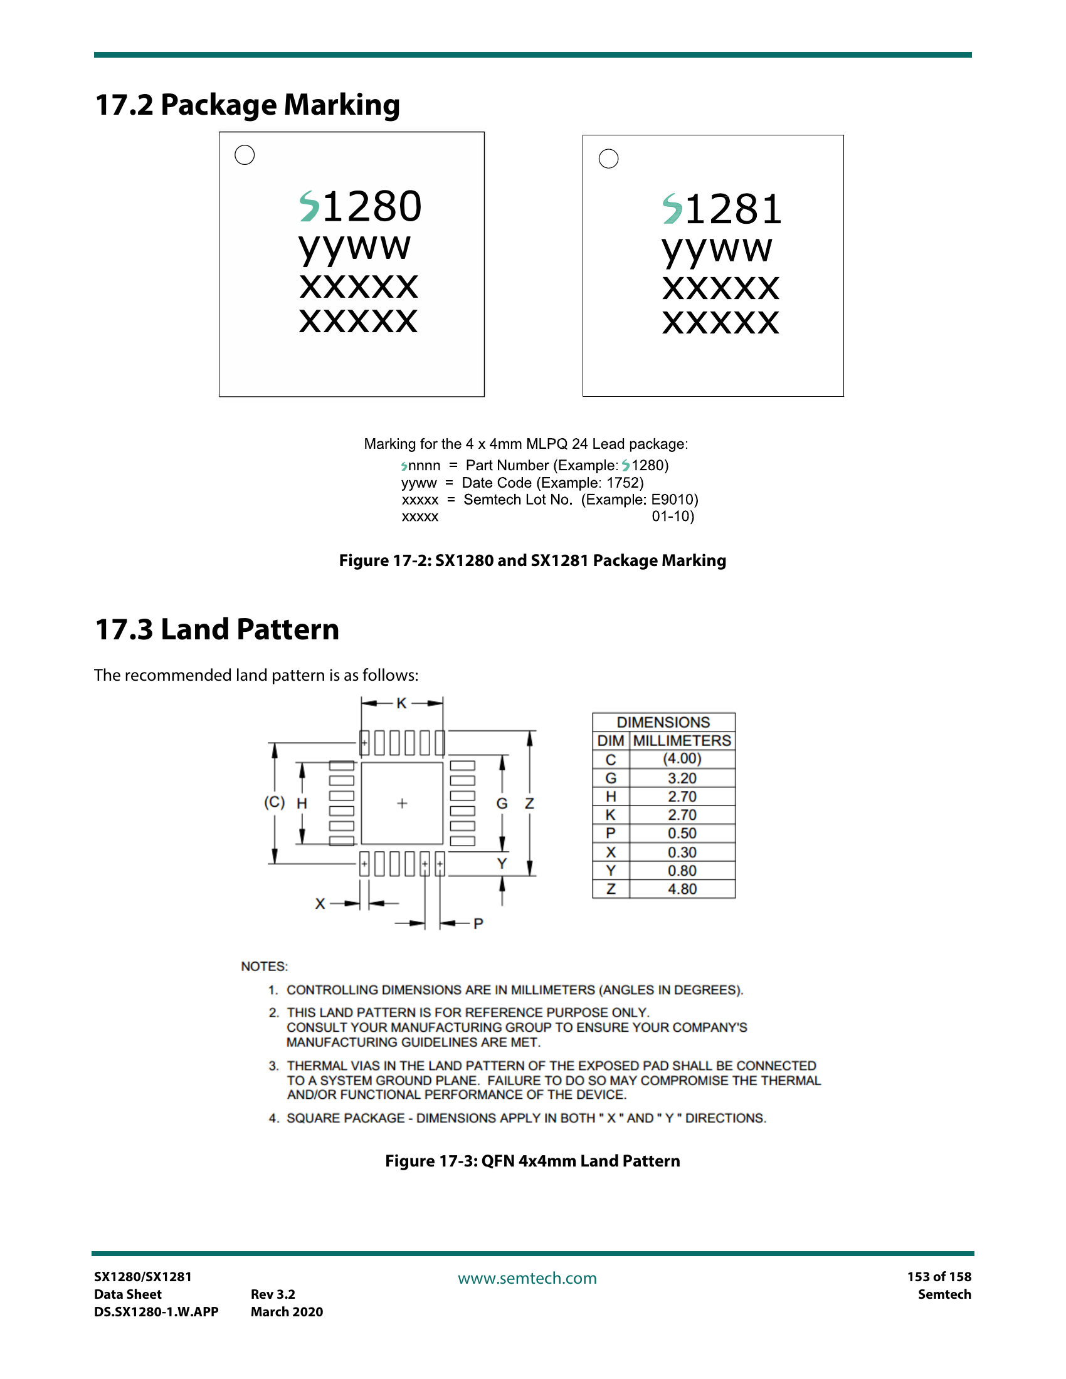
docs/sx1280/Figure17-3-QFN4x4-LandPattern.png
