c03rad0r/balloon-fresh-1/docs/v9-system-diagram.png

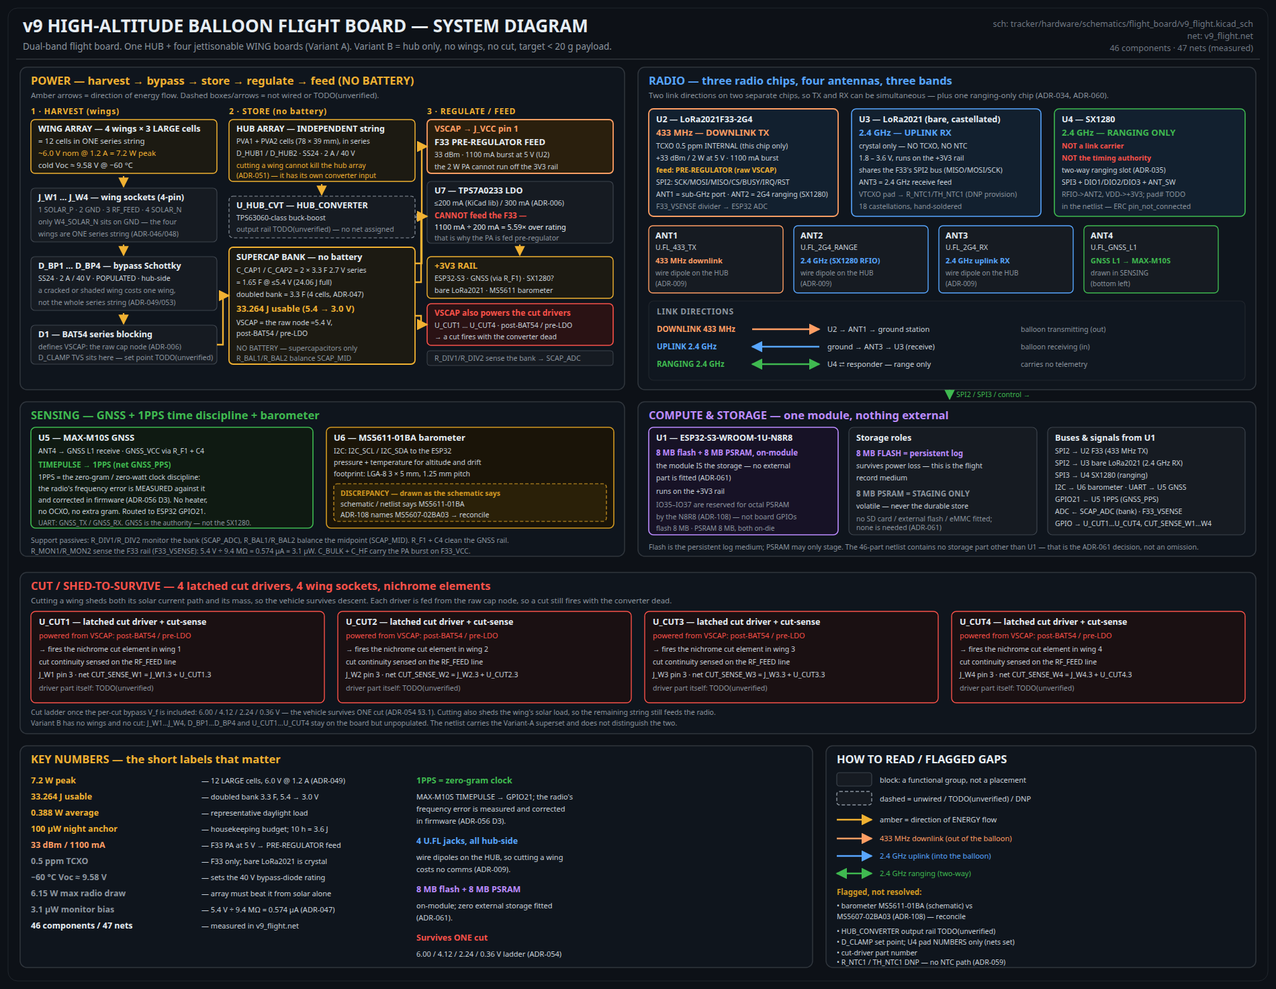
docs/v9-system-diagram.png
