c03rad0r/balloon-fresh-1/hardware/enclosure/bigradio/preview-both.png

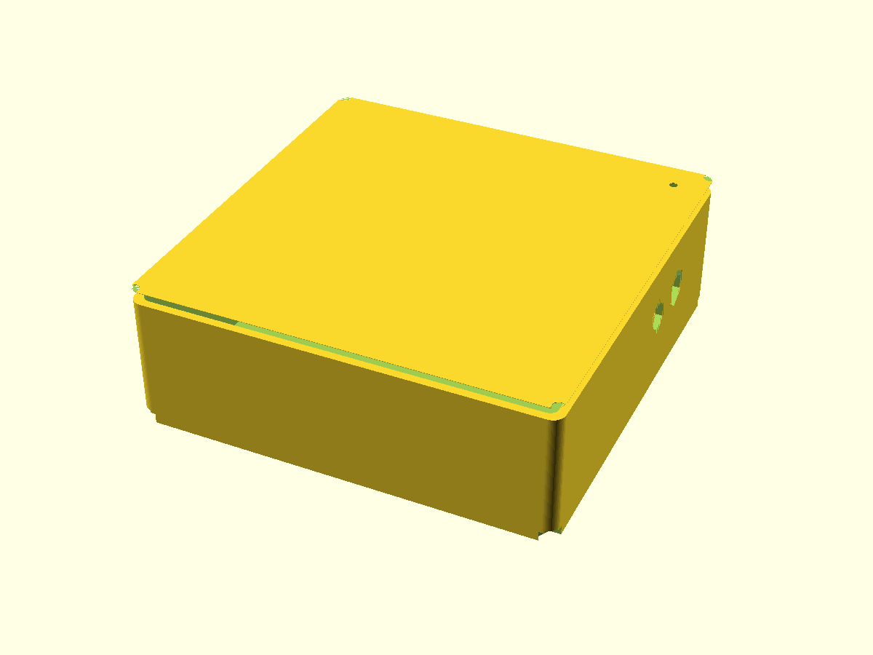
hardware/enclosure/bigradio/preview-both.png
