c03rad0r/balloon-fresh-1/hardware/enclosure/preview-both.png

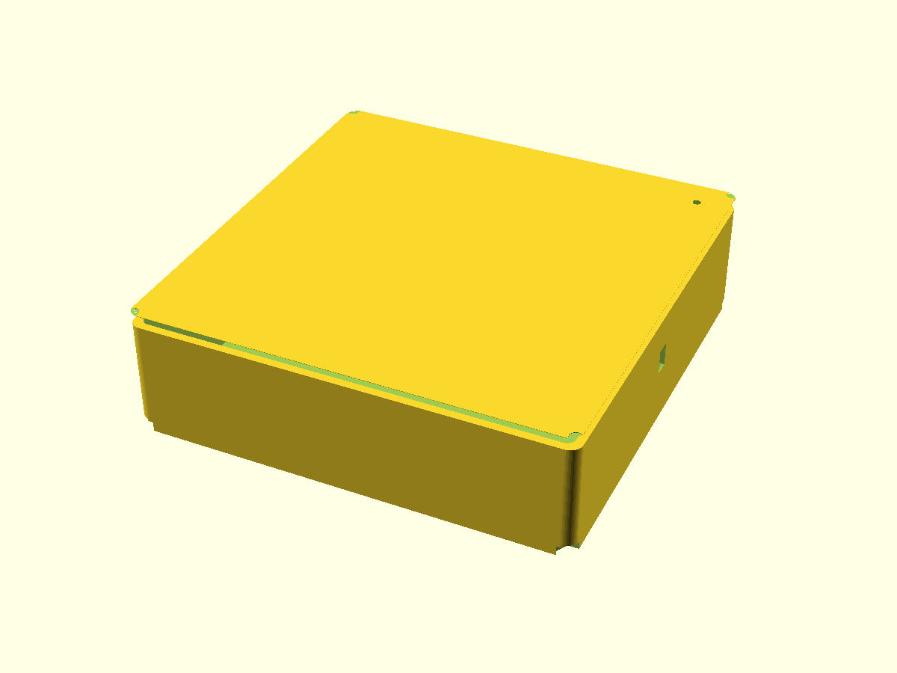
hardware/enclosure/preview-both.png
