c03rad0r/balloon-fresh-1/tracker/ground-station/antenna-tracker/docs/ESP32-pinout.png

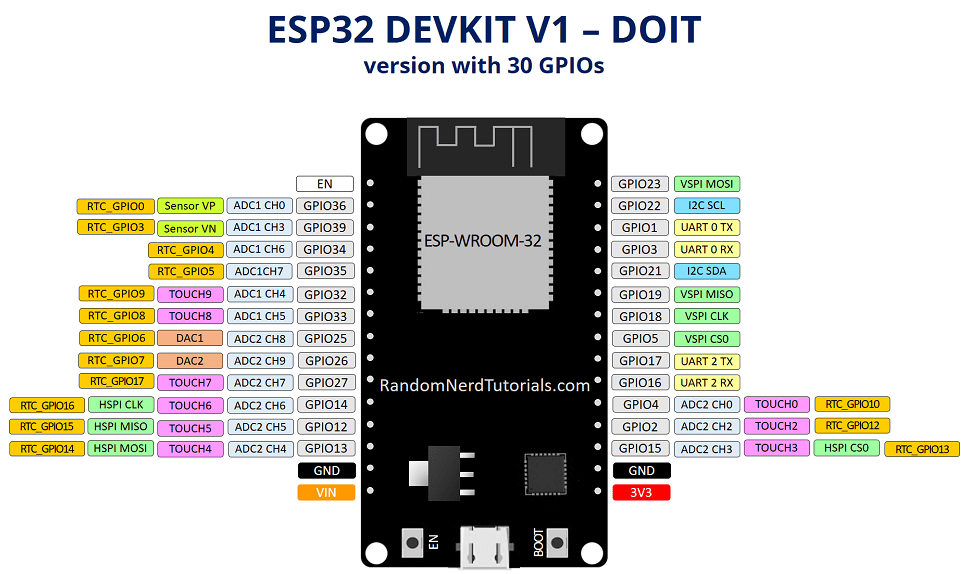
tracker/ground-station/antenna-tracker/docs/ESP32-pinout.png
