c03rad0r/balloon-fresh-1/tracker/ground-station/antenna-tracker/docs/pinout-gpio-pin-number.png

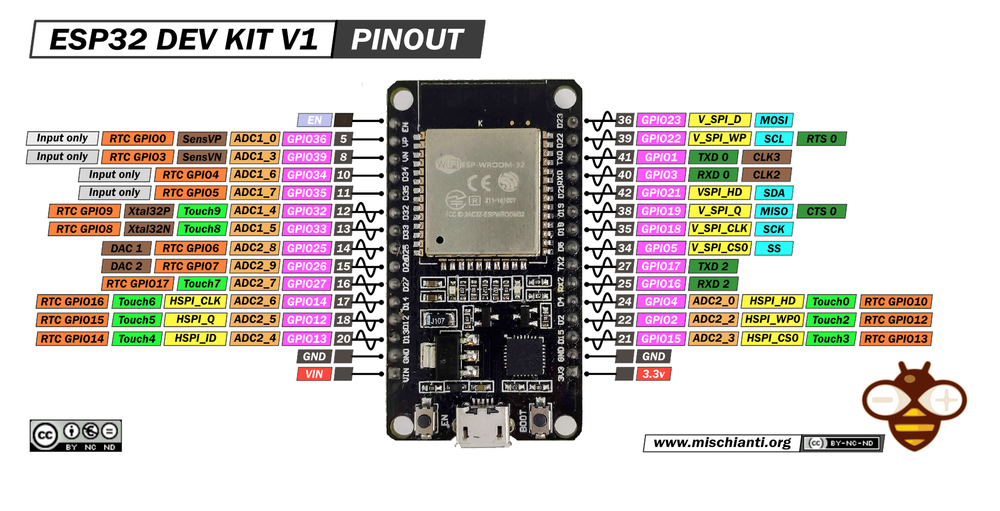
tracker/ground-station/antenna-tracker/docs/pinout-gpio-pin-number.png
