c03rad0r/balloon-fresh-1/tracker/hardware/enclosure/bottom_bottom.png

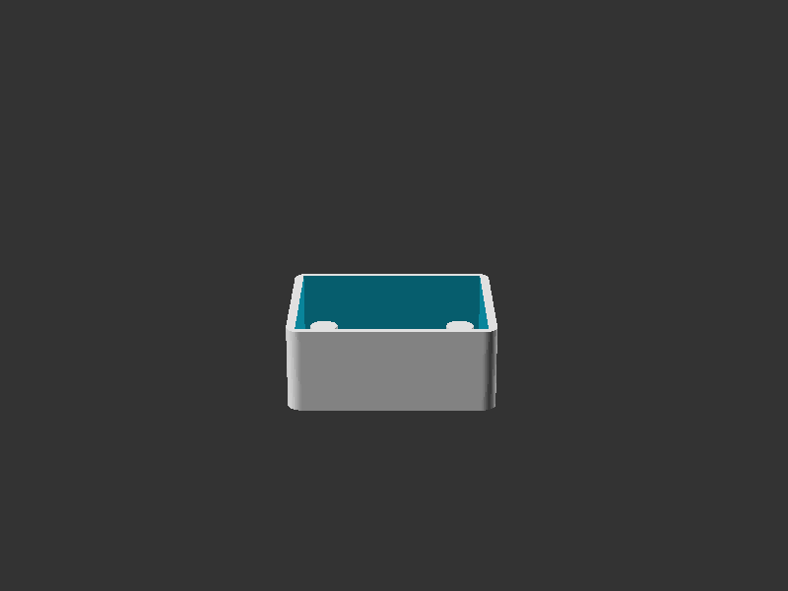
tracker/hardware/enclosure/bottom_bottom.png
