c03rad0r/balloon-fresh-1/tracker/hardware/enclosure/preview_big.png

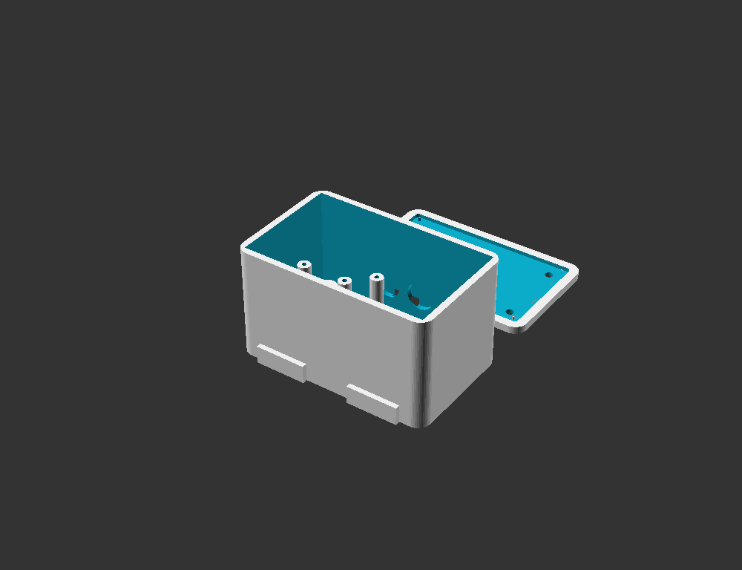
tracker/hardware/enclosure/preview_big.png
