c03rad0r/balloon-fresh-1/tracker/hardware/enclosure/preview_both.png

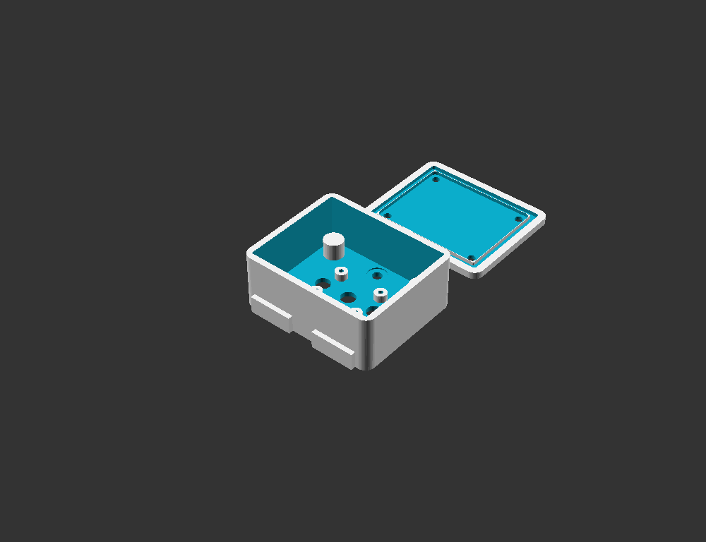
tracker/hardware/enclosure/preview_both.png
