c03rad0r/balloon-fresh-1/tracker/hardware/output/renders/v8i-board-4layer.png

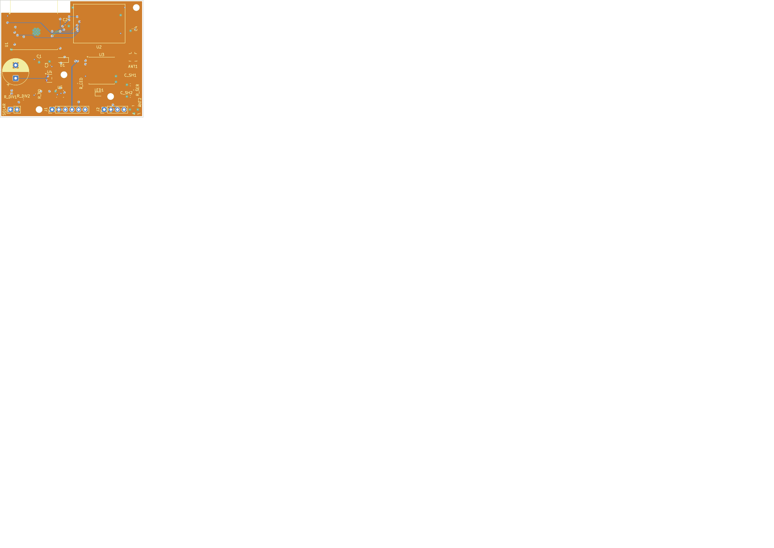
tracker/hardware/output/renders/v8i-board-4layer.png
