c03rad0r/balloon-fresh-1/tracker/hardware/output/renders/v8i-schematic.png

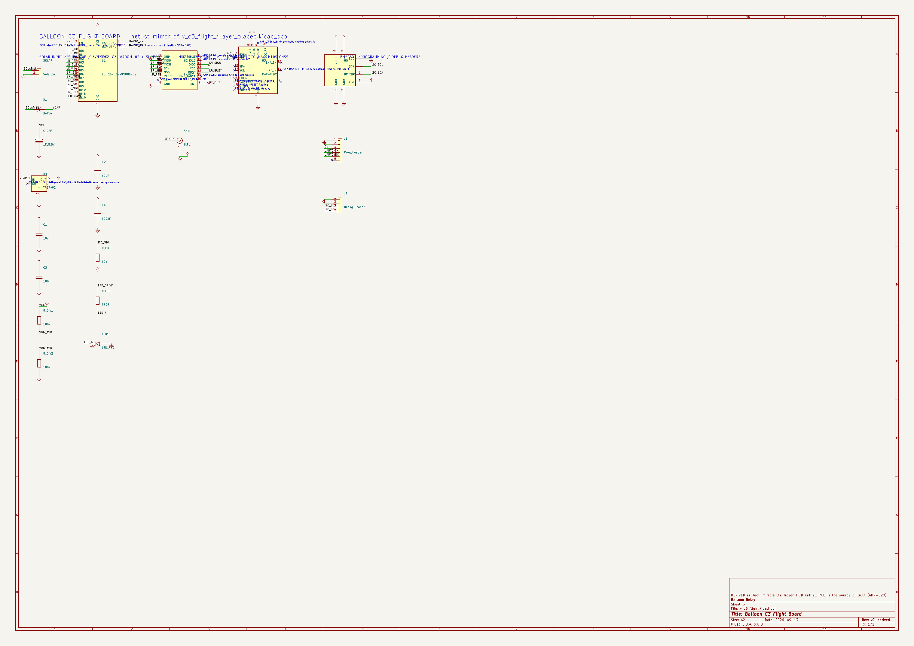
tracker/hardware/output/renders/v8i-schematic.png
