c03rad0r/balloon-fresh-1/tracker/hardware/output/v8f_front_preview.png

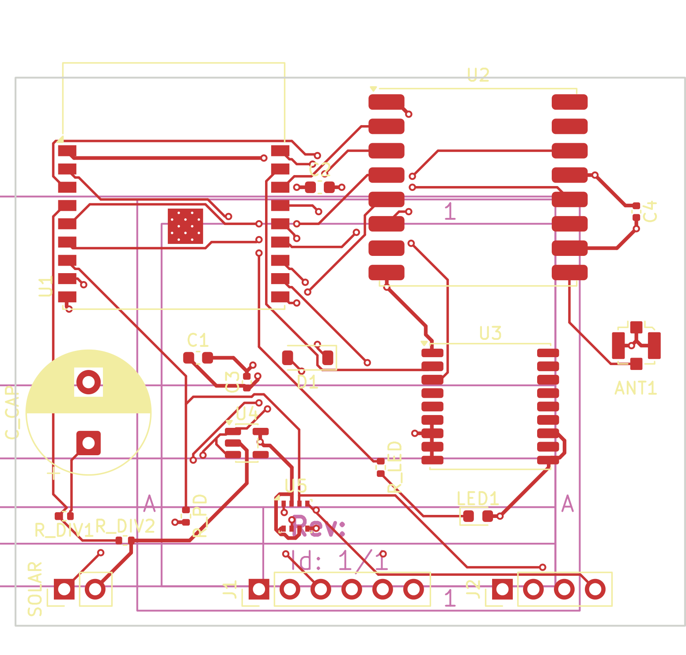
tracker/hardware/output/v8f_front_preview.png
