c03rad0r/balloon-fresh-1/tracker/hardware/renders/_evidence_control_nomodel_hub_top.png

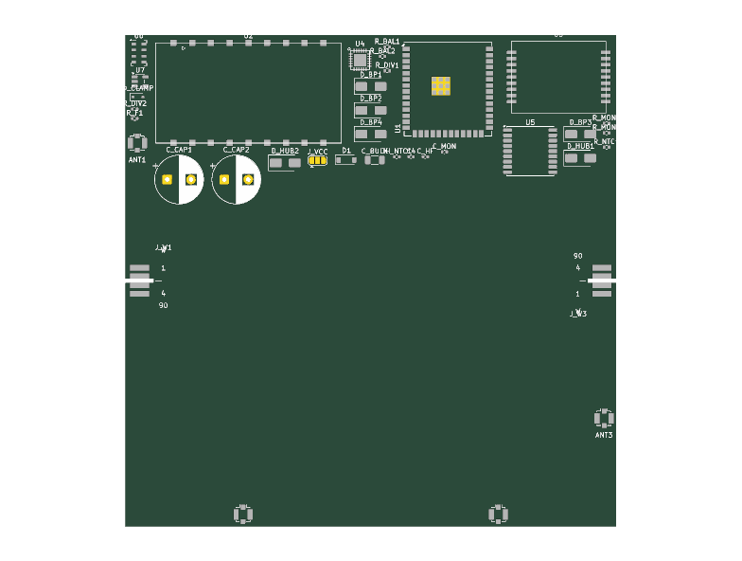
tracker/hardware/renders/_evidence_control_nomodel_hub_top.png
