c03rad0r/balloon-fresh-1/tracker/hardware/renders/hub_board_v9_top.png

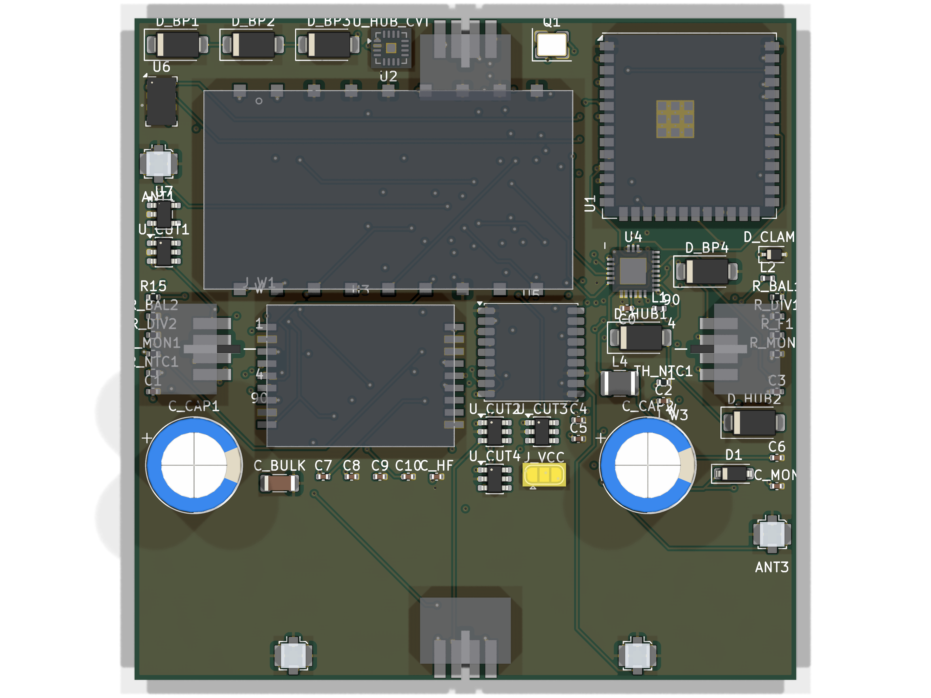
tracker/hardware/renders/hub_board_v9_top.png
