c03rad0r/balloon-fresh-1/tracker/hardware/renders/hub_bottom.png

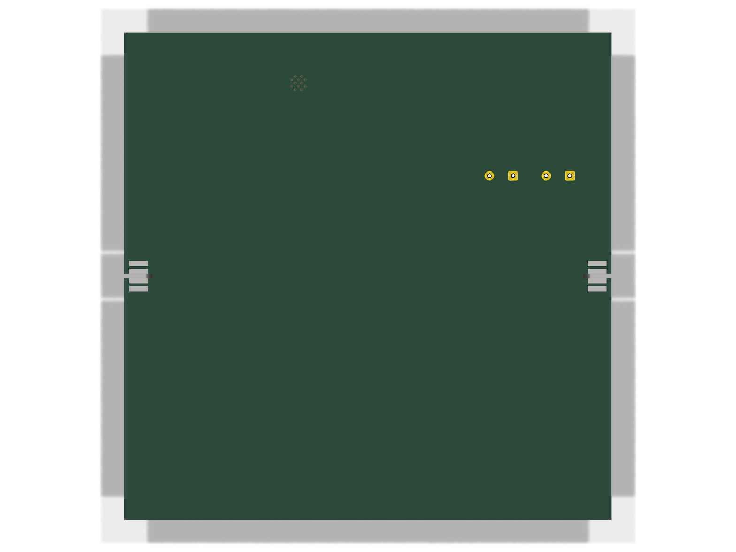
tracker/hardware/renders/hub_bottom.png
