c03rad0r/balloon-fresh-1/tracker/hardware/renders/wing_bottom.png

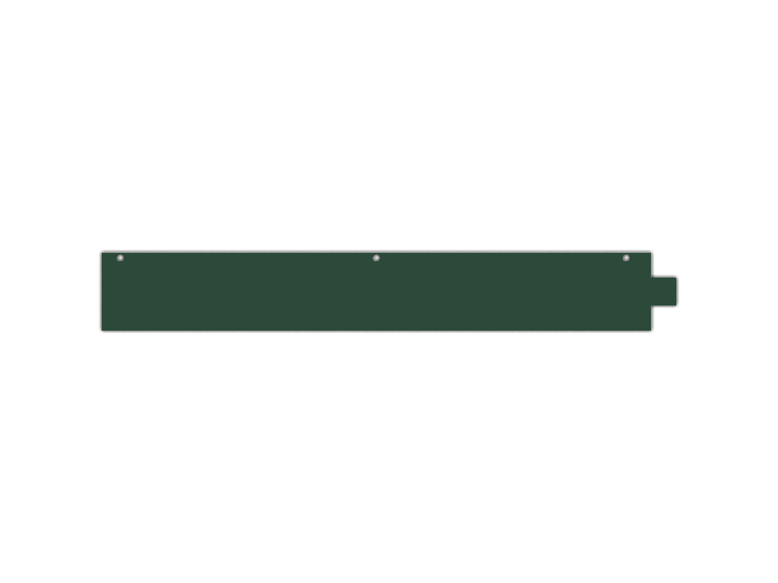
tracker/hardware/renders/wing_bottom.png
