c03rad0r/balloon-fresh-1/tracker/hardware/renders/wing_top.png

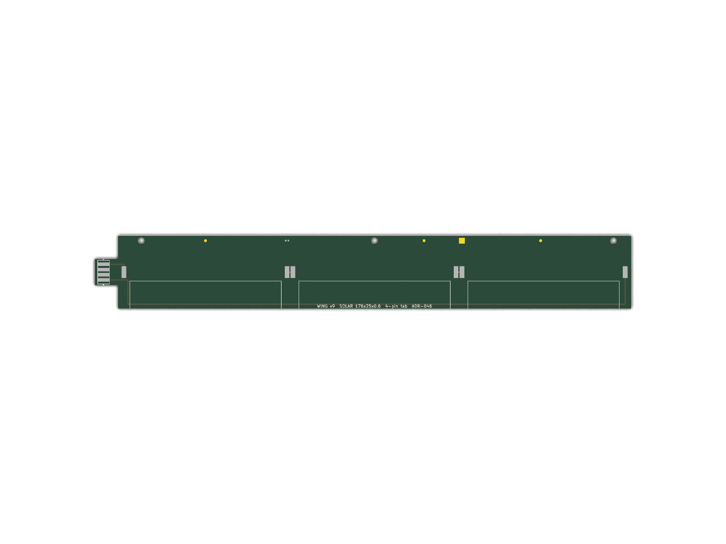
tracker/hardware/renders/wing_top.png
