c03rad0r/balloon-fresh-1/tracker/hardware/wing_board/renders/wing_v9_iso.png

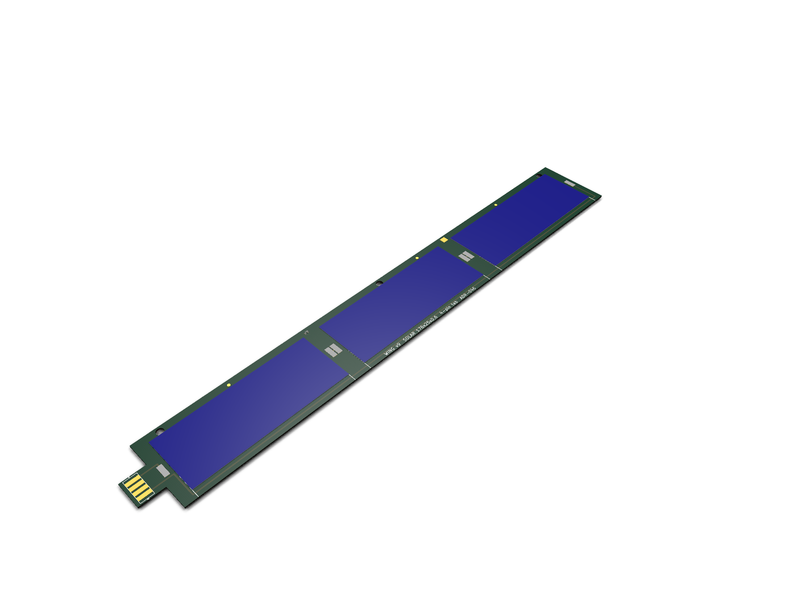
tracker/hardware/wing_board/renders/wing_v9_iso.png
