c03rad0r/balloon-fresh-1/docs/fab/hub-v9/gerbers/hub_board_v9-bom-jlcpcb.csv

Comment | Designator
1M | R_DIV2
10nF | C_MON
0R | R15
U.FL_433_TX | ANT1
1M | R_DIV1
SN74LVC1G373DBVR | U_CUT3
3.3F 2.7V (AVX SCC) | C_CAP2
100nF | C_HF
MS5611-01BA | U6
TPS7A02 | U7
100nF | C8
U.FL_GNSS_L1 | ANT4
SS24 | D_HUB1
ESP32-S3-WROOM-1U-N8R8 | U1
0.8pF | C0
10k | R_BAL2
U.FL_2G4_RX | ANT3
SS24 | D_BP4
4.7M | R_MON2
SS24 | D_BP1
100nF | C10
SN74LVC1G373DBVR | U_CUT1
U.FL_2G4_RANGE | ANT2
10uF | C4
LoRa2021_Castellated | U3
SN74LVC1G373DBVR | U_CUT2
4.7M | R_MON1
10k | R_BAL1
SS24 | D_HUB2
52MHz | Q1
10nF | C6
2.5nH | L2
WING_SOCKET_4P (hub wing interface 4) | J_W4
100pF | C3
BAT54 | D1
TODO(unverified) (NTC, R25/beta TODO) | TH_NTC1
1.2pF | C1
WING_SOCKET_4P (hub wing interface 1) | J_W1
100uF | C_BULK
1.2pF | C2
100R | R_F1
WING_SOCKET_4P (hub wing interface 3) | J_W3
TODO(unverified) (sets ntc_r_ratio) | R_NTC1
SS24 | D_BP3
LoRa2021F33-2G4 | U2
470nF | C9
MAX-M10S | U5
SN74LVC1G373DBVR | U_CUT4
WING_SOCKET_4P (hub wing interface 2) | J_W2
SX1280 | U4
BQ25504RGTR | U_HUB_CVT
0.5pF | C7
3.3F 2.7V (AVX SCC) | C_CAP1
10nF | C5
15uH | L4
3.0nH | L1
SS24 | D_BP2
TVS clamp (set point TODO(unverified)) | D_CLAMP
