c03rad0r/balloon-fresh-1/docs/fab/hub-v9/gerbers/hub_v9-bom.csv

Reference | Value | Footprint
ANT1 | U.FL_433_TX | Connector_Coaxial:U.FL_Molex_MCRF_73412-0110_Vertical
ANT2 | U.FL_2G4_RANGE | Connector_Coaxial:U.FL_Molex_MCRF_73412-0110_Vertical
ANT3 | U.FL_2G4_RX | Connector_Coaxial:U.FL_Molex_MCRF_73412-0110_Vertical
ANT4 | U.FL_GNSS_L1 | Connector_Coaxial:U.FL_Molex_MCRF_73412-0110_Vertical
C4 | 10uF | Capacitor_SMD:C_0402_1005Metric
C_BULK? | 100uF | Capacitor_SMD:C_1206_3216Metric
C_CAP1,C_CAP2 | 3.3F 2.7V (AVX SCC) | Capacitor_THT:CP_Radial_D10.0mm_P5.00mm
C_HF? | 100nF | Capacitor_SMD:C_0402_1005Metric
C_MON? | 10nF | Capacitor_SMD:C_0402_1005Metric
D1 | BAT54 | Diode_SMD:D_SOD-123
D_BP1-D_BP4,D_HUB1,D_HUB2 | SS24 | Diode_SMD:D_SMA
D_CLAMP? | TVS clamp (set point TODO(unverified)) | Diode_SMD:D_SOD-323
J_VCC? | F33_VCC_SEL (5V raw | 3V3) | Jumper:SolderJumper-3_P1.3mm_Open_RoundedPad1.0x1.5mm
J_W1 | WING_SOCKET_4P (hub wing interface 1) | Tracker_Mechanical:Wing_Tab_4P
J_W2 | WING_SOCKET_4P (hub wing interface 2) | Tracker_Mechanical:Wing_Tab_4P
J_W3 | WING_SOCKET_4P (hub wing interface 3) | Tracker_Mechanical:Wing_Tab_4P
J_W4 | WING_SOCKET_4P (hub wing interface 4) | Tracker_Mechanical:Wing_Tab_4P
PVA1,PVA2 | SolarCell_78x39mm
R_BAL1,R_BAL2 | 10k | Resistor_SMD:R_0402_1005Metric
R_DIV1,R_DIV2 | 1M | Resistor_SMD:R_0402_1005Metric
R_F1 | 100R | Resistor_SMD:R_0402_1005Metric
R_MON1,R_MON2 | 4.7M | Resistor_SMD:R_0402_1005Metric
R_NTC1 | TODO(unverified) (sets ntc_r_ratio) | Resistor_SMD:R_0402_1005Metric
TH_NTC1 | TODO(unverified) (NTC, R25/beta TODO) | Resistor_SMD:R_0402_1005Metric
U1 | ESP32-S3-WROOM-1U-N8R8 | RF_Module:ESP32-S3-WROOM-1U
U2 | LoRa2021F33-2G4 | balloon_flight_v9:LoRa2021F33_2G4
U3 | LoRa2021_Castellated | balloon_flight_v9:LoRa2021_Castellated
U4 | SX1280 | balloon_flight_v9:SX1280_QFN24
U5 | MAX-M10S | RF_GPS:ublox_MAX
U6 | MS5611-01BA | Package_LGA:LGA-8_3x5mm_P1.25mm
U7 | TPS7A02 | Package_TO_SOT_SMD:SOT-23-5
U_CUT1-U_CUT4 | latched cut driver + cut-sense (part TODO(unverified))
U_HUB_CVT? | HUB_PV input (part TODO(unverified))
