c03rad0r/balloon-fresh-1/SCRATCH/lr2021-manifest-parts/datasheets-lr11x0.md

# LR11x0 family datasheet-provenance — machine-mergeable fragment

- source file (read only): `docs/lr2021-research/datasheets/provenance-lr11x0.md`
- source sha256: `d671f6c0acf7ace67db01ba4f2bcb4770e949c09db3a4e4b1ad0efcc7c2b90a7`
- source size: `13283` bytes
- verified entries (path exists AND sha256 matches): `6`
- entries flagged HASH MISMATCH: `0`
- FAILED entries: `4`
- verification: `sha256sum` (fallback `shasum -a 256`, then `sha256`), run this session
- network access: none

---

## R1 — Semtech LR1110 product page (HTML)

- local path: `docs/lr2021-research/datasheets/semtech-lr1110-product-page.html.gz` (gzip, byte-exact of the fetched HTTP body; uncompressed `238257` bytes)
- local path: `docs/lr2021-research/datasheets/semtech-lr1110-product-page.txt` (text render of the same fetch)
- local path: `/home/c03rad0r/lr2021-scratch/product-lr1110.html` (SCRATCH, outside repo; uncompressed fetched HTML)
- origin URL: https://www.semtech.com/products/wireless-rf/lora-edge/lr1110
- HTTP status: `200`
- version/revision: `n/a` (none recorded; page carries rotating CDN cache-busting tokens)
- retrieval date: `2026-09-30T23:10:56Z`
- file size: `37759` bytes (gzip), `238257` bytes (uncompressed), `23088` bytes (.txt)
- sha256 (uncompressed fetched HTML): `5a314904a32dcfe9a1d5a4fa0fa009234b0a33cef024ee9f44d935cb1606ad71` (recorded; locally re-verified via `zcat docs/lr2021-research/datasheets/semtech-lr1110-product-page.html.gz | sha256sum`)
- sha256 (.txt render): `6c9c902abfe09d581375d4f182d81124719babaac60cd770054819c01e3a81a2` (recorded; locally re-verified via sha256sum)
- sha256 (.html.gz gzip bytes): `70eac156ef16cda8f42bb1203f3ea145684bc1abef00765e305a59bed3ab00cd` (recorded; locally re-verified via sha256sum)
- sha256 (SCRATCH uncompressed HTML, same bytes as above): `5a314904a32dcfe9a1d5a4fa0fa009234b0a33cef024ee9f44d935cb1606ad71` (recorded; locally re-verified via sha256sum)
- status: `VERIFIED`

## R2 — Semtech LR1120 product page (HTML)

- local path: `docs/lr2021-research/datasheets/semtech-lr1120-product-page.html.gz` (gzip, byte-exact of the fetched HTTP body; uncompressed `235108` bytes)
- local path: `docs/lr2021-research/datasheets/semtech-lr1120-product-page.txt` (text render of the same fetch)
- local path: `/home/c03rad0r/lr2021-scratch/product-lr1120.html` (SCRATCH, outside repo; uncompressed fetched HTML)
- origin URL: https://www.semtech.com/products/wireless-rf/lora-edge/lr1120
- HTTP status: `200`
- version/revision: `n/a` (none recorded; page carries rotating CDN cache-busting tokens)
- retrieval date: `2026-09-30T23:10:56Z`
- file size: `37392` bytes (gzip), `235108` bytes (uncompressed), `22413` bytes (.txt)
- sha256 (uncompressed fetched HTML): `1b34326bf597406e73e6308f8e0f53f933f411347ac5d70392b8345038e1eb62` (recorded; locally re-verified via `zcat docs/lr2021-research/datasheets/semtech-lr1120-product-page.html.gz | sha256sum`)
- sha256 (.txt render): `c60b41d6dc82c79caa0482e591e095bc7dfe87ff8465f6734475861276e369cb` (recorded; locally re-verified via sha256sum)
- sha256 (.html.gz gzip bytes): `be85cd57525510be3134a97157b81bd42be8f3378720e36270f2169cf9e9c982` (recorded; locally re-verified via sha256sum)
- sha256 (SCRATCH uncompressed HTML, same bytes as above): `1b34326bf597406e73e6308f8e0f53f933f411347ac5d70392b8345038e1eb62` (recorded; locally re-verified via sha256sum)
- status: `VERIFIED`

## R3 — Semtech LR1121 product page (HTML)

- local path: `docs/lr2021-research/datasheets/semtech-lr1121-product-page.html.gz` (gzip, byte-exact of the fetched HTTP body; uncompressed `233401` bytes)
- local path: `docs/lr2021-research/datasheets/semtech-lr1121-product-page.txt` (text render of the same fetch)
- local path: `/home/c03rad0r/lr2021-scratch/product-lr1121.html` (SCRATCH, outside repo; uncompressed fetched HTML)
- origin URL: https://www.semtech.com/products/wireless-rf/lora-connect/lr1121
- HTTP status: `200`
- version/revision: `n/a` (none recorded; page carries rotating CDN cache-busting tokens)
- retrieval date: `2026-09-30T23:10:56Z`
- file size: `37130` bytes (gzip), `233401` bytes (uncompressed), `22097` bytes (.txt)
- sha256 (uncompressed fetched HTML): `3c8f8ac07e27a3306ab8fdd2e817cda9d1724876bf261841461697a7f11a25c9` (recorded; locally re-verified via `zcat docs/lr2021-research/datasheets/semtech-lr1121-product-page.html.gz | sha256sum`)
- sha256 (.txt render): `a607587917dc32951a0a8fc9b71ad6aebde4b10b4c9d4861d2838be6341ef466` (recorded; locally re-verified via sha256sum)
- sha256 (.html.gz gzip bytes): `ef72f977c7cf22e0f61ab40468646a481125dde4dbf8c7fc83f48b1e527f54ff` (recorded; locally re-verified via sha256sum)
- sha256 (SCRATCH uncompressed HTML, same bytes as above): `3c8f8ac07e27a3306ab8fdd2e817cda9d1724876bf261841461697a7f11a25c9` (recorded; locally re-verified via sha256sum)
- status: `VERIFIED`

## R4 — LR1110 datasheet (PDF)

- local path: `docs/lr2021-research/semtech-official/LR1110_v2.1_data_sheet.pdf`
- local path: `/home/c03rad0r/lr2021-scratch/LR1110_v2.1_data_sheet.pdf` (SCRATCH, outside repo)
- origin URL: https://semtech.my.salesforce.com/sfc/p/E0000000JelG/a/RQ00000AXyaj/EQ4jOcJX3lpB41OWGz0VBBLb_avBZzvqrAZfl2P8ID0
- HTTP status: `n/a` (no HTTP status recorded; file obtained via the Salesforce viewer's `Download` button in a browser session)
- version/revision: `DS.LR1110.W.APP`, `Rev 2.1`, cover date `July 2025`; PDF ModDate `2025-07-07 19:49:46 CEST`, `42` pages
- retrieval date: `2026-09-30T23:21:00Z`
- file size: `1286566` bytes
- sha256: `dac6eaf0763f1b5c132610ea0467f8fe65eba780ab925de020ac80e2a549f7b0` (recorded; locally re-verified via sha256sum)
- md5 cross-ref: `18fbc075313feb959eef936b511e3026` (from source; locally re-verified via `md5sum`: `18fbc075313feb959eef936b511e3026`)
- sha256 (SCRATCH copy, byte-identical): `dac6eaf0763f1b5c132610ea0467f8fe65eba780ab925de020ac80e2a549f7b0` (recorded; locally re-verified via sha256sum)
- status: `VERIFIED`

## R5 — LR1120 datasheet (PDF)

- local path: `docs/lr2021-research/semtech-official/LR1120_V2_2_data_sheet.pdf`
- local path: `/home/c03rad0r/lr2021-scratch/LR1120_V2_2_data_sheet.pdf` (SCRATCH, outside repo)
- origin URL: https://semtech.my.salesforce.com/sfc/p/E0000000JelG/a/RQ00000B5wJZ/QJAaTz_ibxFbmPFnWM3EloRSMa0k4yWZBOkXYB2o6K8
- HTTP status: `n/a` (no HTTP status recorded; file obtained via the Salesforce viewer's `Download` button in a browser session)
- version/revision: `DS.LR1120.W.APP`, `Rev 2.2`, cover date `July 2025`; PDF ModDate `2025-07-07 19:51:58 CEST`, `45` pages
- retrieval date: `2026-09-30T23:22:30Z`
- file size: `1185970` bytes
- sha256: `d4ea4a43d57a06840c28d25c1ff5e3b3afb255f3b2f85133d82fc80b65b04431` (recorded; locally re-verified via sha256sum)
- md5 cross-ref: `fed19ccca5ff8ca7466bd9e54115d56a` (from source; locally re-verified via `md5sum`: `fed19ccca5ff8ca7466bd9e54115d56a`)
- sha256 (SCRATCH copy, byte-identical): `d4ea4a43d57a06840c28d25c1ff5e3b3afb255f3b2f85133d82fc80b65b04431` (recorded; locally re-verified via sha256sum)
- status: `VERIFIED`

## R6 — LR1121 datasheet (PDF)

- local path: `docs/lr2021-research/semtech-official/LR1121_V2_1_data_sheet.pdf`
- local path: `/home/c03rad0r/lr2021-scratch/LR1121_V2_1_data_sheet.pdf` (SCRATCH, outside repo)
- origin URL: https://semtech.my.salesforce.com/sfc/p/E0000000JelG/a/RQ0000093ZiP/RV4Ba6LROsFrFjnAAVK2av5W11RGmCms_3Q2cyKHdDA
- HTTP status: `n/a` (no HTTP status recorded; file obtained via the Salesforce viewer's `Download` button in a browser session)
- version/revision: `DS.LR1121.W.APP`, `Rev 2.1`; PDF ModDate `2025-04-23 13:10:43 CEST`, `35` pages
- retrieval date: `2026-09-30T23:26:00Z`
- file size: `968122` bytes
- sha256: `114bd9d7bd07b453a511f412c9e157d7179f636b03dc1e197988f1c899d96d56` (recorded; locally re-verified via sha256sum)
- md5 cross-ref: `880981b964e151fc75fa2ddc229ea34b` (from source; locally re-verified via `md5sum`: `880981b964e151fc75fa2ddc229ea34b`)
- sha256 (SCRATCH copy, byte-identical): `114bd9d7bd07b453a511f412c9e157d7179f636b03dc1e197988f1c899d96d56` (recorded; locally re-verified via sha256sum)
- status: `VERIFIED`

## F1 — Salesforce delivery links, direct `curl` GET (all three)

- local path: `n/a` (no artifact retrieved)
- origin URL: https://semtech.my.salesforce.com/sfc/p/E0000000JelG/a/RQ00000AXyaj/EQ4jOcJX3lpB41OWGz0VBBLb_avBZzvqrAZfl2P8ID0 and https://semtech.my.salesforce.com/sfc/p/E0000000JelG/a/RQ00000B5wJZ/QJAaTz_ibxFbmPFnWM3EloRSMa0k4yWZBOkXYB2o6K8 and https://semtech.my.salesforce.com/sfc/p/E0000000JelG/a/RQ0000093ZiP/RV4Ba6LROsFrFjnAAVK2av5W11RGmCms_3Q2cyKHdDA
- HTTP status: `200`
- version/revision: `n/a`
- retrieval date: `2026-09-30T23:0xZ` (as recorded; minute unspecified)
- file size: `1359` bytes (each of the 3 responses)
- sha256: `n/a` (no artifact)
- status: `FAILED`
- FAILED reason: JS gate — response is a `<form id="postBack" method="POST">` stub with no PDF bytes
- saved scratch response bodies (not counted as retrievals; no sha256 recorded in source):
  - `/home/c03rad0r/lr2021-scratch/ds-1110.bin` (`1359` bytes; measured sha256 `d30e65b29905695f01c080c08a74519de3ebf171081f7a80000325b47805359f`)
  - `/home/c03rad0r/lr2021-scratch/ds-1120.bin` (`1359` bytes; measured sha256 `660bd6cafcb19ad268032b8bda8778d37776b1ea78e79224c97abb473caa13cb`)
  - `/home/c03rad0r/lr2021-scratch/ds-1121.bin` (`1359` bytes; measured sha256 `c7d4d4e4b89894b837c296a739e36cc6074e627f08462cb1e5ba7d6ca4503e91`)

## F2 — Guessed direct `uploads/documents` PDF path

- local path: `n/a` (no artifact retrieved)
- origin URL: https://www.semtech.com/uploads/documents/DS_LR1110.pdf
- HTTP status: `200`
- version/revision: `n/a`
- retrieval date: `2026-09-30T23:0xZ` (as recorded; minute unspecified)
- file size: `21149` bytes
- sha256: `n/a` (no artifact)
- status: `FAILED`
- FAILED reason: soft-404 — body is a HubSpot "Find Product Documentation" landing page, not a PDF; HTTP 200 alone is insufficient

## F3 — `lora-connect/{lr1110,lr1120}` product-page slugs

- local path: `n/a` (no artifact retrieved)
- origin URL: https://www.semtech.com/products/wireless-rf/lora-connect/lr1110 and https://www.semtech.com/products/wireless-rf/lora-connect/lr1120
- HTTP status: `404`
- version/revision: `n/a`
- retrieval date: `2026-09-30T23:0xZ` (as recorded; minute unspecified)
- file size: `105910` bytes (each)
- sha256: `n/a` (no artifact)
- status: `FAILED`
- FAILED reason: HTTP 404

## F4 — Alternate mirror — Mouser

- local path: `n/a` (no artifact retrieved)
- origin URL: https://www.mouser.com/datasheet/2/761/LR1110_Datasheet_v1.1-1662965.pdf
- HTTP status: `n/a`
- version/revision: `n/a`
- retrieval date: `2026-09-30T23:0xZ` (as recorded; minute unspecified)
- file size: `n/a`
- sha256: `n/a` (no artifact)
- status: `FAILED`
- FAILED reason: transport error — `curl: (92) HTTP/2 stream 1 was not closed cleanly: INTERNAL_ERROR`; not retried
