c03rad0r/balloon-fresh-1/docs/analysis/assets/gain-per-dollar/fig1-cost-cliff.png

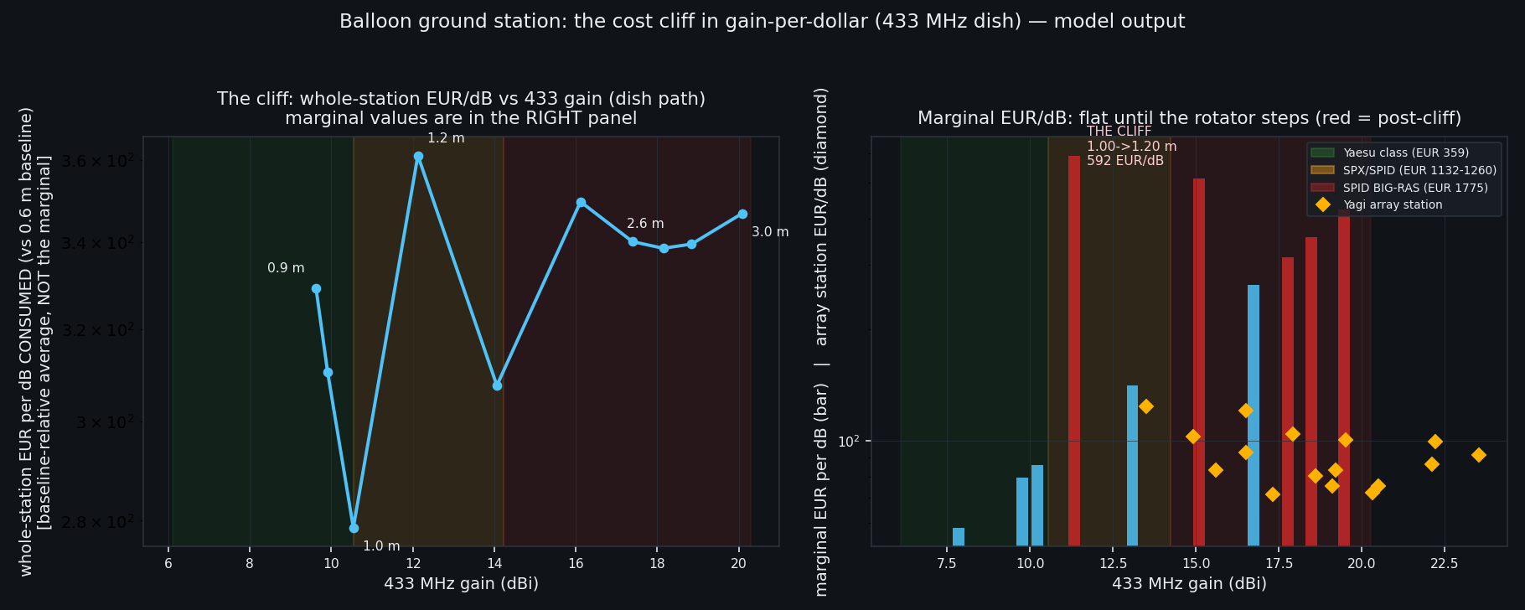
docs/analysis/assets/gain-per-dollar/fig1-cost-cliff.png
