c03rad0r/balloon-fresh-1/docs/assets/lr2021/LoRa2021_Package/LoRa2021_Package/LoRa2021 V1.2_pads.dxf

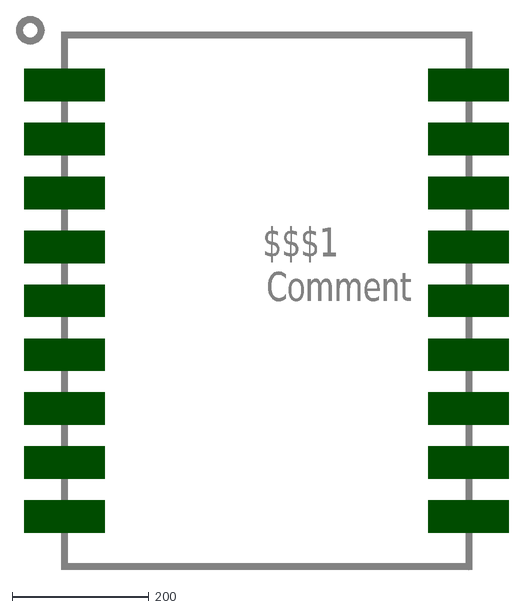
[picture p97: CAD file, 2026-10-06]
docs/assets/lr2021/LoRa2021_Package/LoRa2021_Package/LoRa2021 V1.2_pads.dxf
$$$1
Comment
