c03rad0r/balloon-fresh-1/docs/fab/hub-v9/3d/hub_v9.step

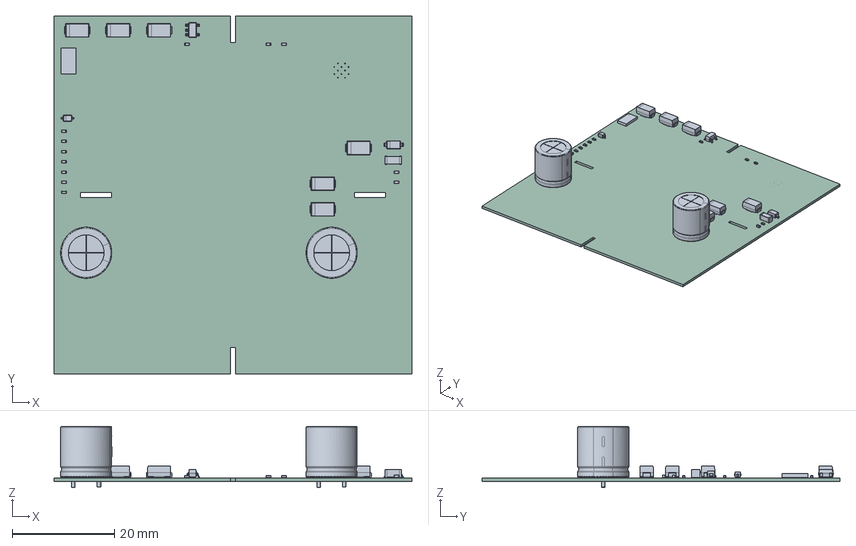
[picture p98: CAD file, 2026-10-14]
docs/fab/hub-v9/3d/hub_v9.step
70.0 x 70.0 x 12.0 mm
R_0402_1005Metric x 9
CP_Radial_D10.0mm_P5.00mm x 2
D_SMA x 6
C_0402_1005Metric x 3
LGA-8_3x5mm_P1.25mm
D_SOD-323
SOT-23-5
D_SOD-123
C_1206_3216Metric
hub_v9_PCB
