c03rad0r/balloon-fresh-1/hardware/enclosure/bigradio/bottom.stl

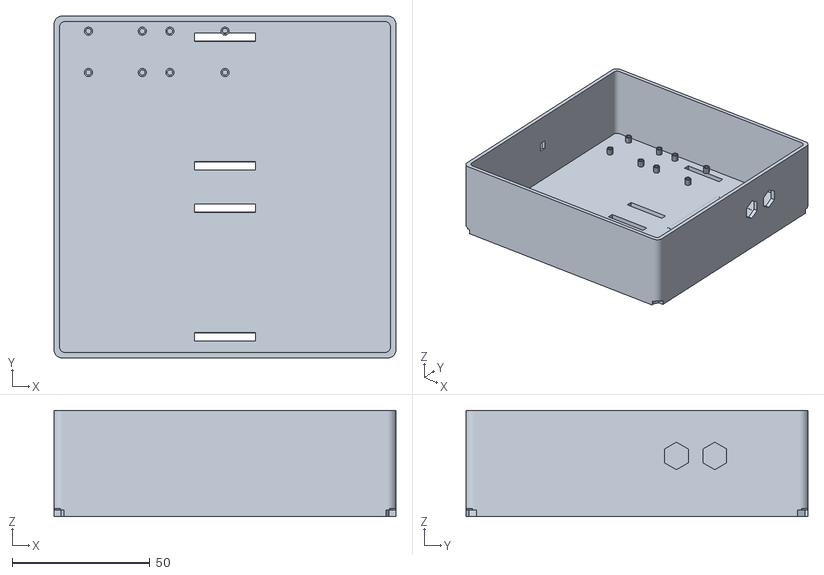
[picture p99: CAD file, 2026-08-24]
hardware/enclosure/bigradio/bottom.stl
124.0 x 124.0 x 38.5
