c03rad0r/balloon-fresh-1/hardware/enclosure/lid.stl

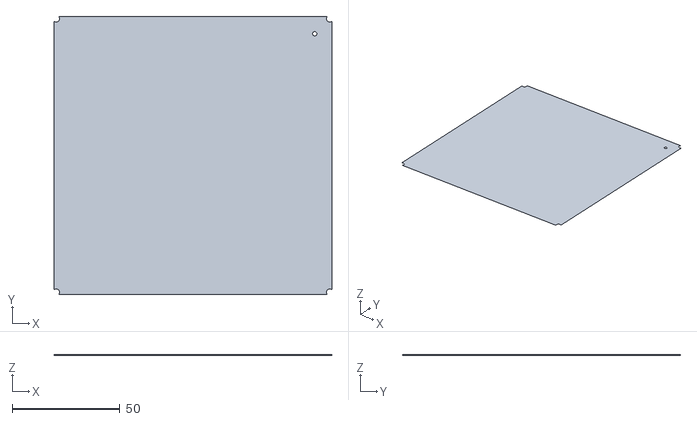
[picture p100: CAD file, 2026-08-24]
hardware/enclosure/lid.stl
128.7 x 128.7 x 0.1
