c03rad0r/balloon-fresh-1/tracker/hardware/enclosure/bottom_final.stl

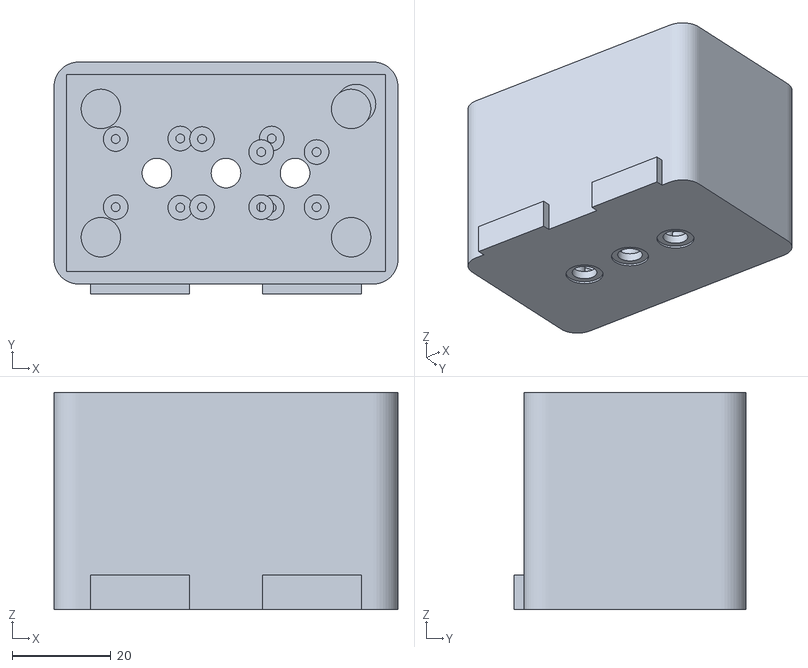
[picture p101: CAD file, 2026-08-24]
tracker/hardware/enclosure/bottom_final.stl
69.7 x 47.0 x 44.0
