c03rad0r/balloon-fresh-1/docs/fab/hub-v9/3d/wing_v9.step

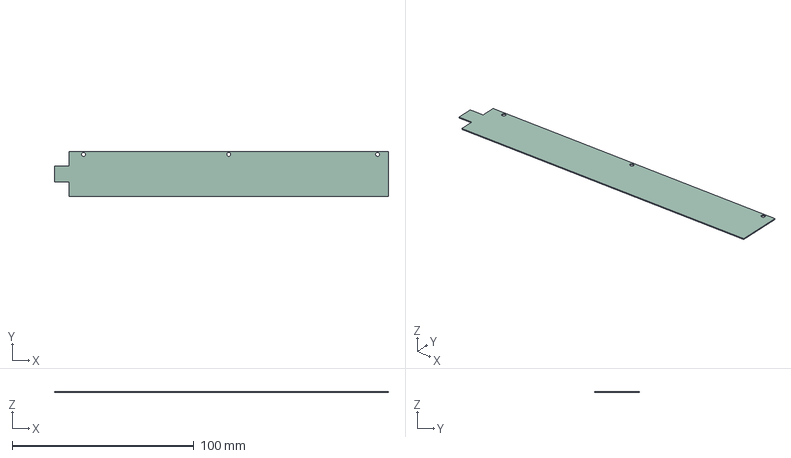
[picture p102: CAD file, 2026-10-14]
docs/fab/hub-v9/3d/wing_v9.step
184.0 x 25.0 x 0.51 mm
solar_cell_small_52.07x19.65x0.21 x 6
ferrite_bead_0402_dnp
wing_v9_fiducial_1mm_dot x 3
wing_v9_tab_4pin_lands
wing_v9_rf_provision_pad_2x2
wing_board_v9_PCB
