c03rad0r/balloon-fresh-1/hardware/enclosure/bigradio/lid.stl

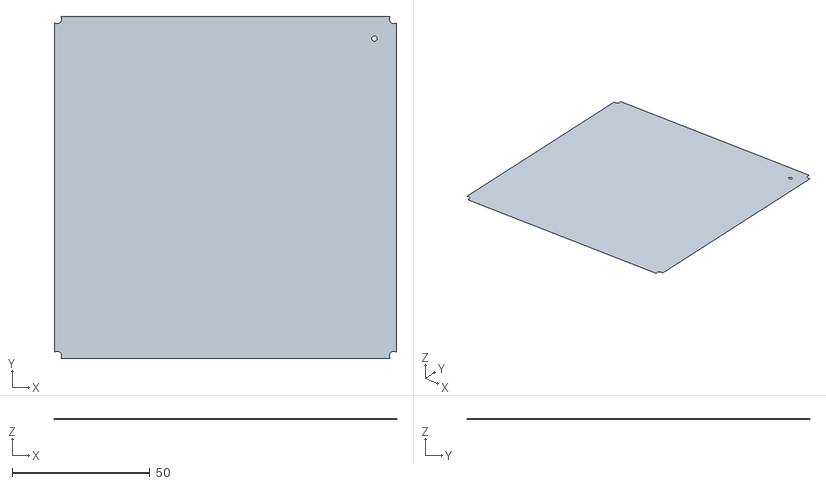
[picture p103: CAD file, 2026-08-24]
hardware/enclosure/bigradio/lid.stl
124.0 x 124.0 x 0.1
