c03rad0r/balloon-fresh-1/hardware/enclosure/bottom.stl

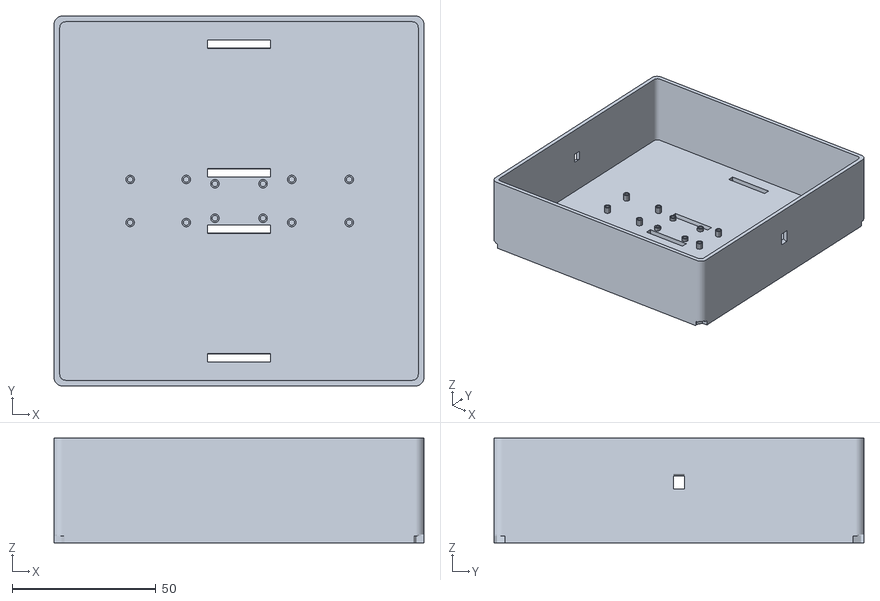
[picture p104: CAD file, 2026-08-24]
hardware/enclosure/bottom.stl
128.7 x 128.7 x 36.5
