c03rad0r/balloon-fresh-1/tracker/hardware/enclosure/lid_final.stl

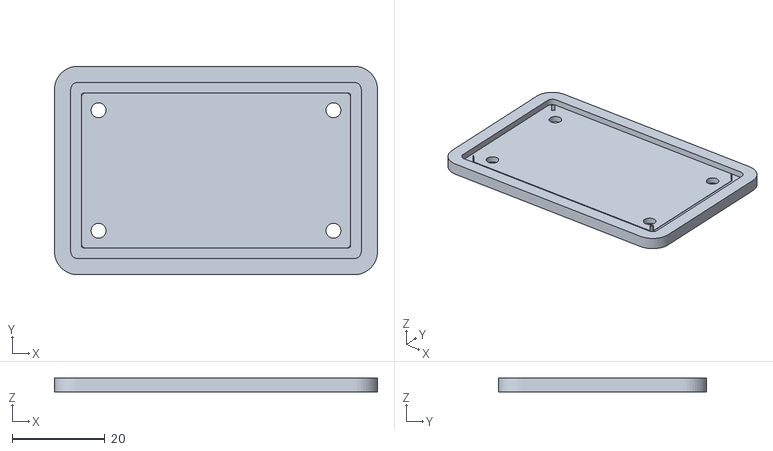
[picture p105: CAD file, 2026-08-24]
tracker/hardware/enclosure/lid_final.stl
69.7 x 45.0 x 3.00
