c03rad0r/balloon-fresh-1/tracker/hardware/enclosure/bottom.stl

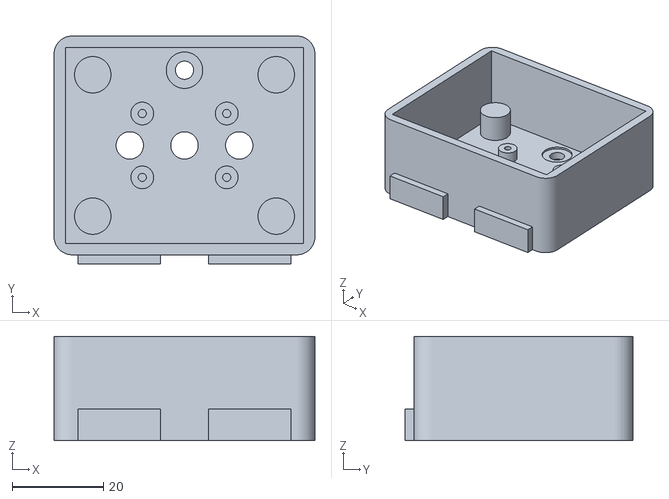
[picture p106: CAD file, 2026-08-24]
tracker/hardware/enclosure/bottom.stl
57.2 x 50.0 x 22.9
