c03rad0r/balloon-fresh-1/tracker/hardware/enclosure/lid_v2.stl

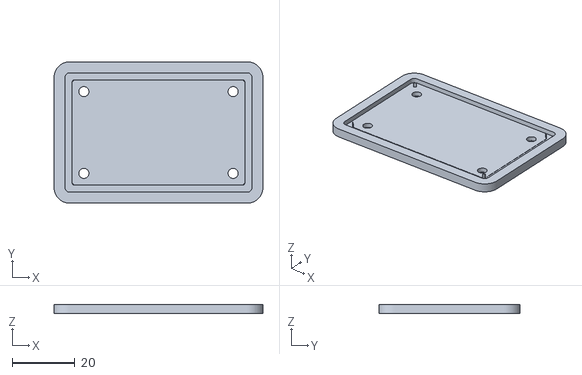
[picture p107: CAD file, 2026-08-24]
tracker/hardware/enclosure/lid_v2.stl
66.5 x 45.0 x 3.00
