c03rad0r/balloon-fresh-1/tracker/hardware/enclosure/lid_big_oversize.stl

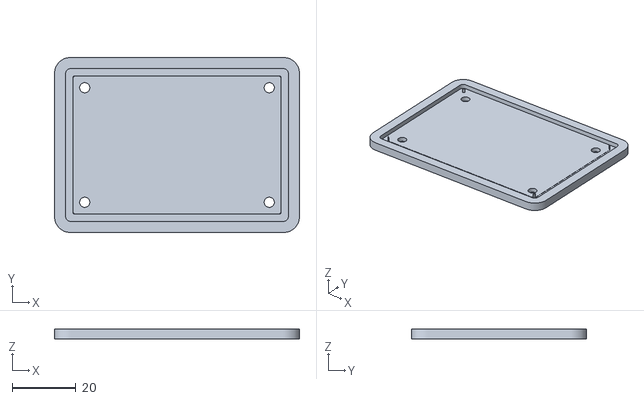
[picture p108: CAD file, 2026-08-24]
tracker/hardware/enclosure/lid_big_oversize.stl
77.0 x 55.0 x 3.00
