c03rad0r/balloon-fresh-1/tracker/hardware/enclosure/bottom_big_final.stl

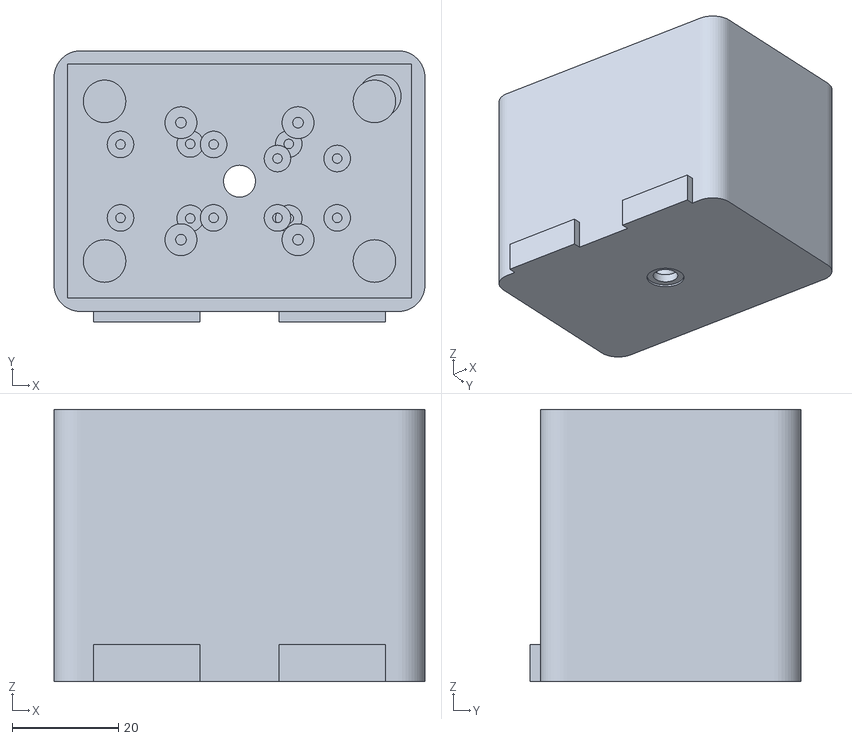
[picture p109: CAD file, 2026-08-24]
tracker/hardware/enclosure/bottom_big_final.stl
69.7 x 51.0 x 51.1
