c03rad0r/balloon-fresh-1/tracker/hardware/enclosure/lid.stl

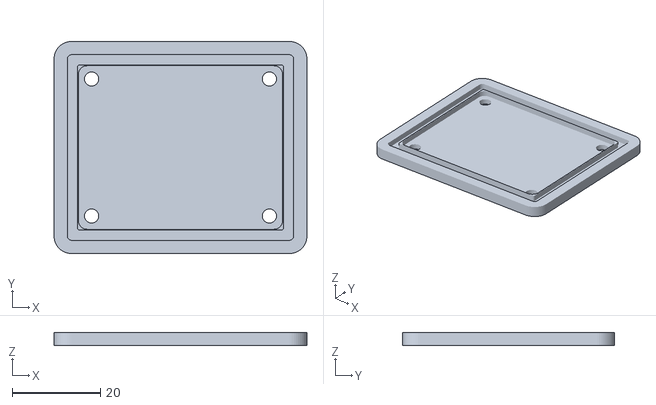
[picture p110: CAD file, 2026-08-24]
tracker/hardware/enclosure/lid.stl
57.2 x 48.0 x 3.00
