c03rad0r/balloon-fresh-1/tracker/hardware/enclosure/bottom_v2_generic.stl

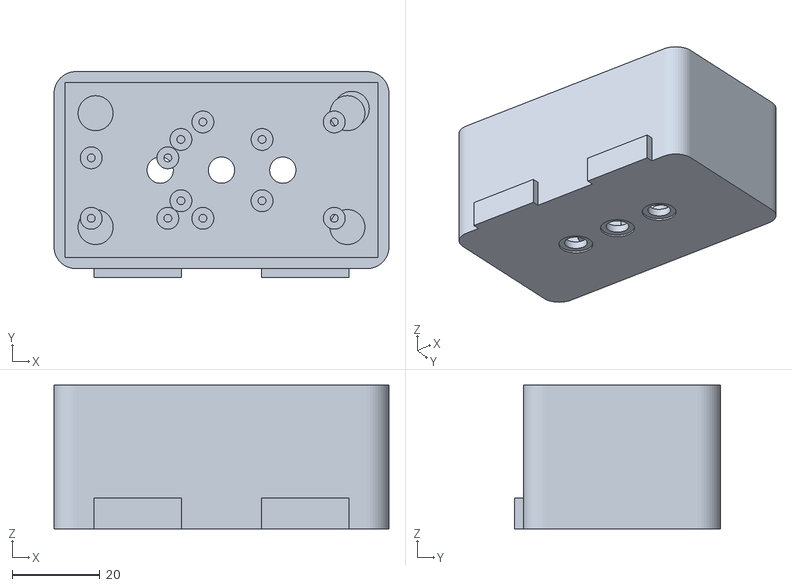
[picture p111: CAD file, 2026-08-24]
tracker/hardware/enclosure/bottom_v2_generic.stl
76.5 x 47.0 x 32.8
