c03rad0r/balloon-fresh-1/tracker/hardware/enclosure/bottom_big_oversize.stl

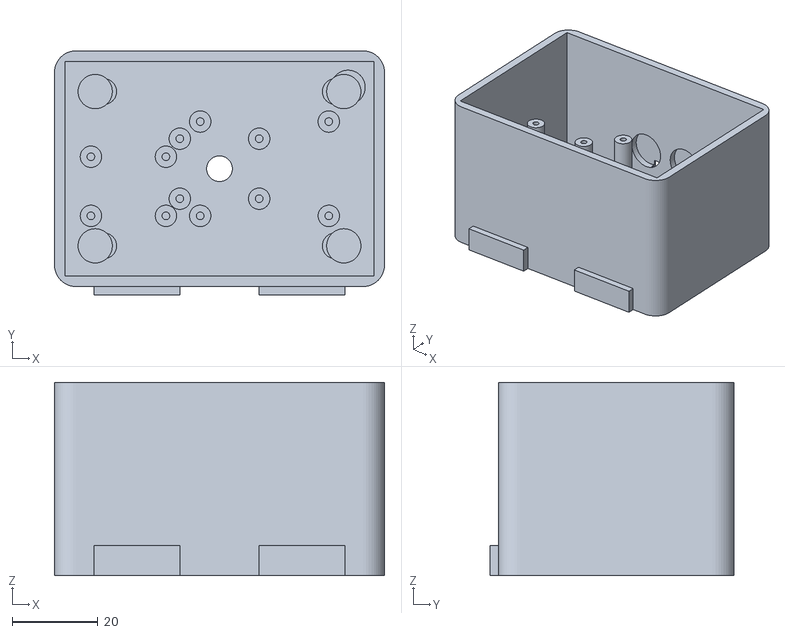
[picture p112: CAD file, 2026-08-24]
tracker/hardware/enclosure/bottom_big_oversize.stl
77.0 x 57.0 x 45.1
