c03rad0r/balloon-fresh-1/tracker/hardware/enclosure/lid_big_final.stl

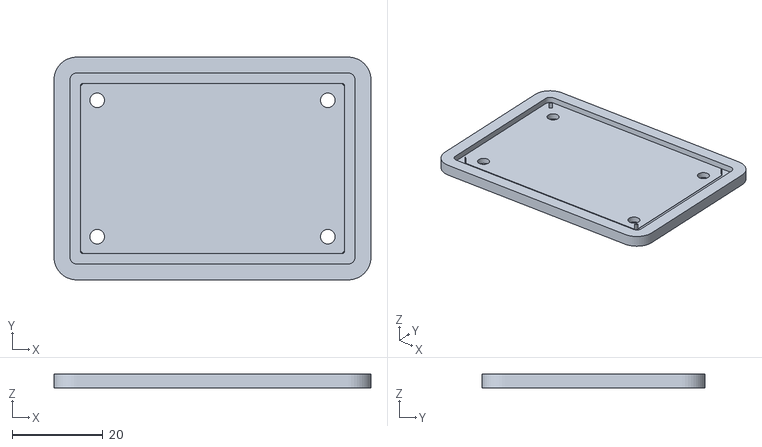
[picture p113: CAD file, 2026-08-24]
tracker/hardware/enclosure/lid_big_final.stl
69.7 x 49.0 x 3.00
