c03rad0r/balloon-fresh-1/tracker/hardware/enclosure/lid_v2_generic.stl

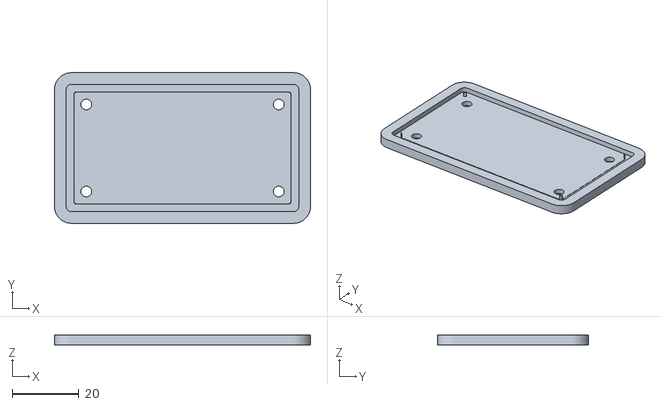
[picture p114: CAD file, 2026-08-24]
tracker/hardware/enclosure/lid_v2_generic.stl
76.5 x 45.0 x 3.00
