c03rad0r/balloon-fresh-1/tracker/hardware/enclosure/bottom_v2.stl

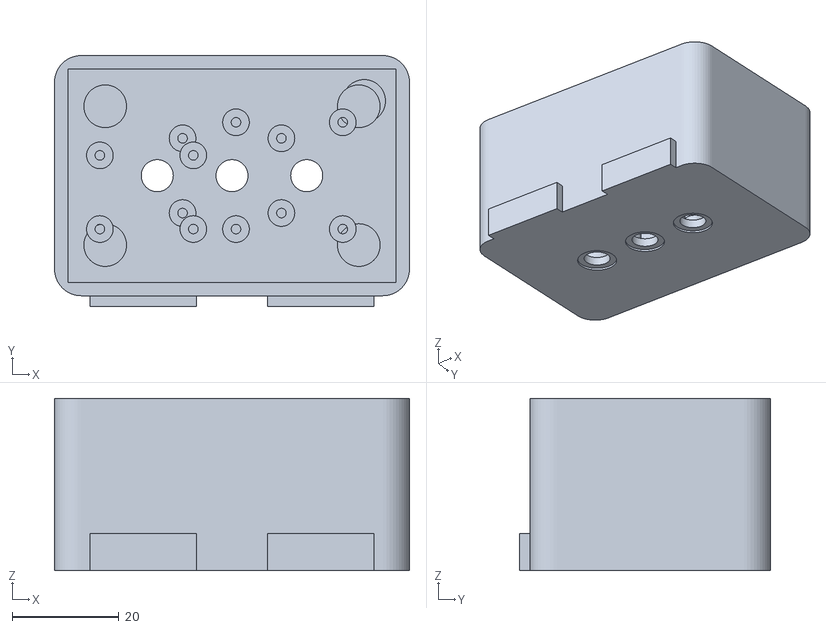
[picture p115: CAD file, 2026-08-24]
tracker/hardware/enclosure/bottom_v2.stl
66.5 x 47.0 x 32.3
