c03rad0r/balloon-fresh-1/tracker/hardware/enclosure/lid_big.stl

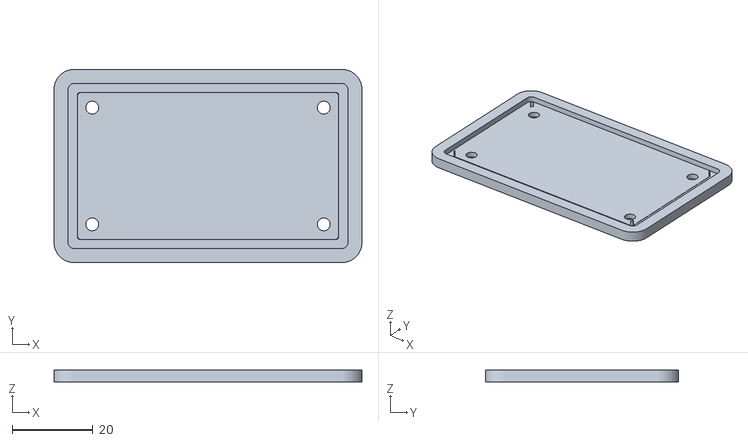
[picture p116: CAD file, 2026-08-24]
tracker/hardware/enclosure/lid_big.stl
76.5 x 48.0 x 3.00
