c03rad0r/balloon-fresh-1/tracker/hardware/enclosure/bottom_big.stl

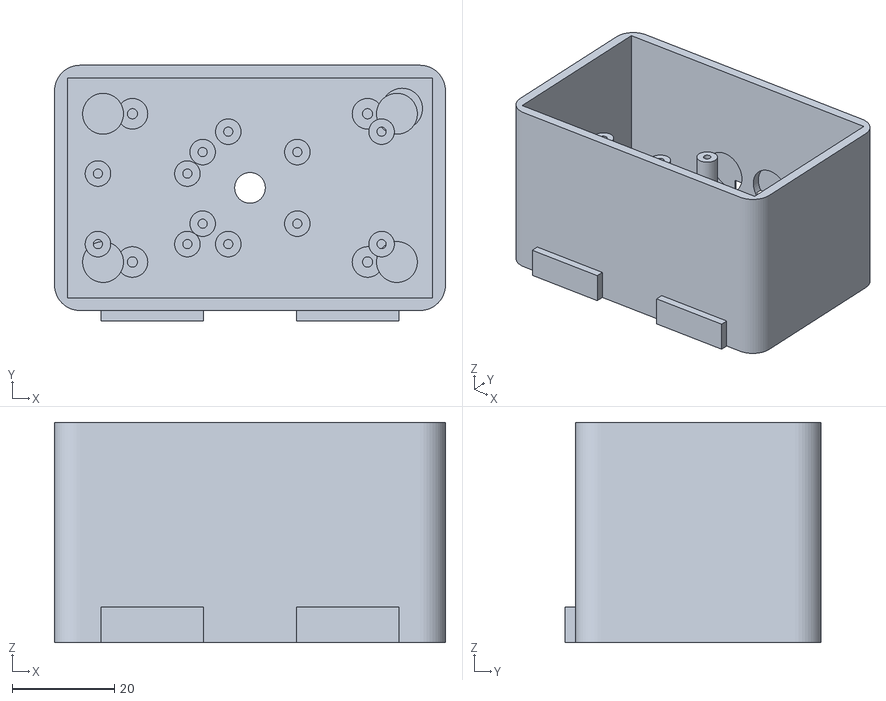
[picture p117: CAD file, 2026-08-24]
tracker/hardware/enclosure/bottom_big.stl
76.5 x 50.0 x 43.1
