c03rad0r/balloon-fresh-1/(list of files, cad)

Other CAD files:
hardware/enclosure/balloon-field-case-bigradio.scad
hardware/enclosure/balloon-field-case.scad
hardware/ground-station/dish/dish.scad
tracker/hardware/enclosure/balloon_dev_case.scad
tracker/hardware/enclosure/balloon_dev_case_big.scad
