c03rad0r/balloon-fresh-1/docs/logic-analyzer-wiring-diagram.html

LOGIC ANALYZER WIRING — RP2040 ↔ LR2021 SPI BUS

8-channel 24 MHz logic analyzer — probe SPI signals to debug per-byte vs batch/DMA transfer

RP2040 (Pi Pico)

SPI0 — Master

- CS / NSSGP17CH1
- SCKGP18CH2
- MOSIGP19CH3
- MISOGP16CH4
- BUSYGP20CH5
- DIO9/IRQGP21CH6
- RESETGP22—
- GNDGNDGND

LR2021 Module

NiceRF LoRa2021 — SPI Slave

- NSS←CH1
- SCK←CH2
- MOSI←CH3
- MISO←CH4
- BUSY←CH5
- DIO9←CH6
- NRESET←—
- GND←GND

LOGIC ANALYZER (8-CH 24MHz)

Cellulologic — channels labeled CH1-CH8

CH1NSS (CS)tap GP17

CH5BUSYtap GP20

CH2SCKtap GP18

CH6DIO9 / IRQtap GP21

CH3MOSItap GP19

CH7unused—

CH4MISOtap GP16

CH8unused—

GND → connect to RP2040 GND & LR2021 GND (common ground required)

NSS/CS

SCK

MOSI

MISO

BUSY

DIO9/IRQ

RESET

GND
