c03rad0r/balloon-fresh-1/docs/logic-analyzer-wiring-rp2040-zero.html

LOGIC ANALYZER WIRING — RP2040 Zero + LR2021 SPI BUS

Cellulologic 8-CH 24MHz — channels CH1-CH8 — actual firmware pins

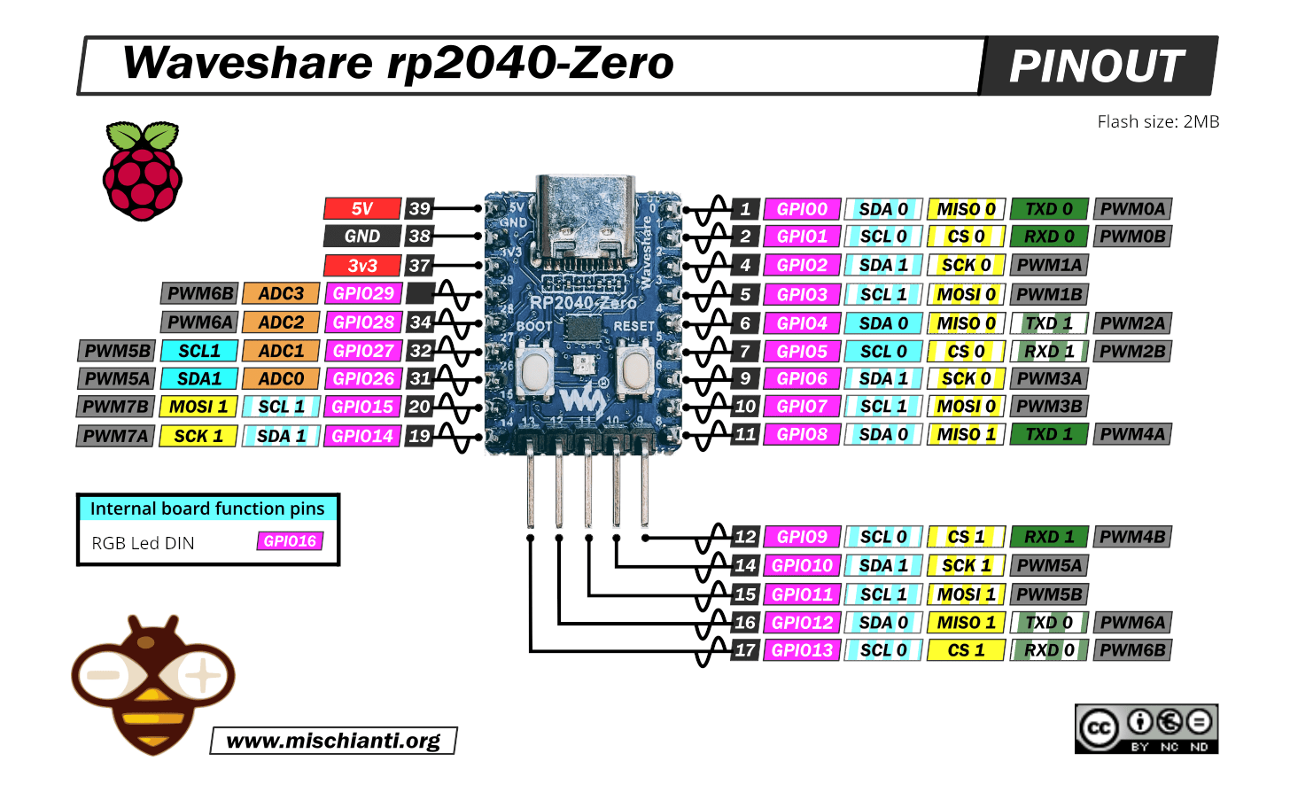
[picture p118: docs/rp2040-zero-pinout.png]
RP2040 Zero Pinout


Waveshare RP2040-Zero pinout (mischianti.org) — highlighted pins are used for LR2021 SPI

LR2021 Module

NiceRF LoRa2021 — SPI Slave

- NSS← GP5pin7CH1
- SCK← GP2pin4CH2
- MOSI← GP3pin5CH3
- MISO← GP4pin6CH4
- BUSY← GP6pin9CH5
- DIO9← GP7pin10CH6
- NRESET← GP8pin11CH7
- GND← GNDpin38GND

CELLULOLOGIC ANALYZER (8-CH 24MHz)

Channels labeled CH1-CH8 — connect GND to RP2040 GND

CH1NSS (CS)GP5/pin7

CH5BUSYGP6/pin9

CH2SCKGP2/pin4

CH6DIO9/IRQGP7/pin10

CH3MOSIGP3/pin5

CH7NRESETGP8/pin11

CH4MISOGP4/pin6

CH8unused—

Settings: Sample 24MHz (2x SPI) • Trigger CH1 falling edge • Decode SPI CPOL=0 CPHA=0 • Watch inter-byte gaps, NSS hold time, RESET glitches

NSS/CS

SCK

MOSI

MISO

BUSY

DIO9/IRQ

RESET

GND
