c03rad0r/balloon-fresh-1/docs/logic-analyzer-wiring-diagram.png

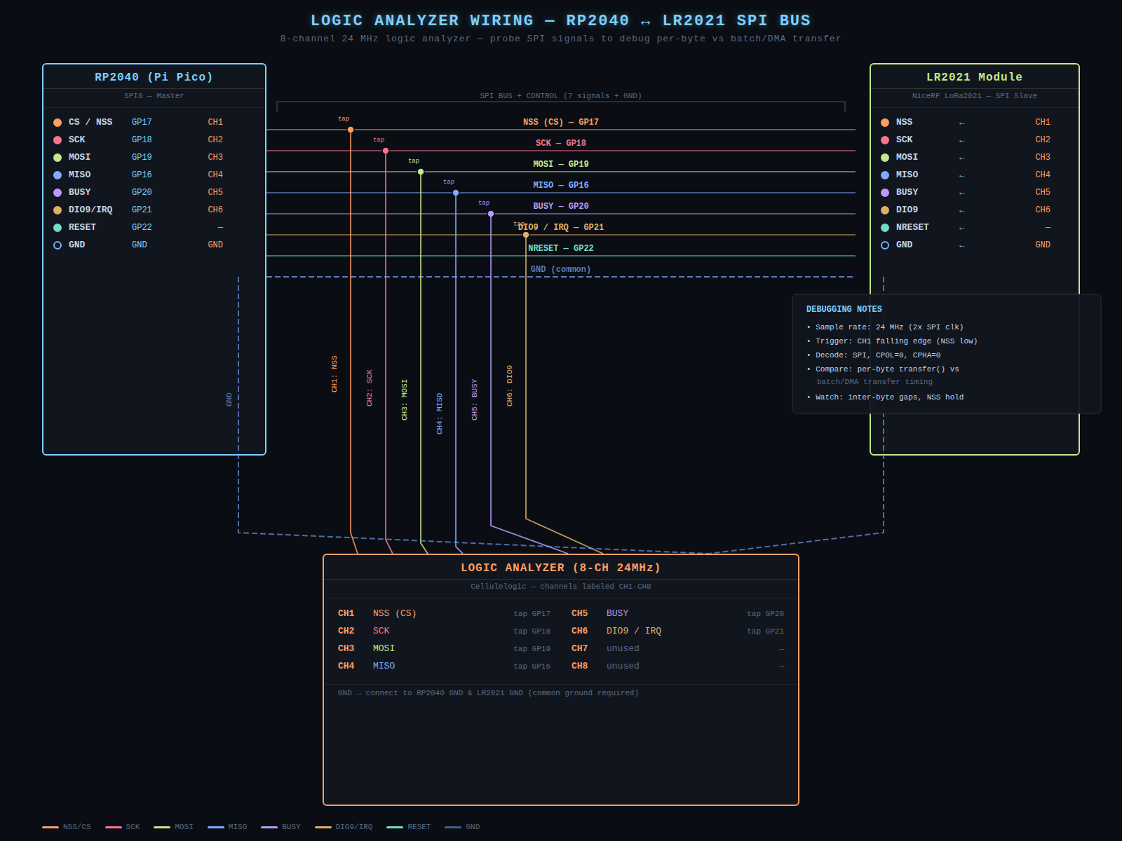
docs/logic-analyzer-wiring-diagram.png
