c03rad0r/balloon-fresh-1/docs/logic-analyzer-wiring-rp2040-zero.png

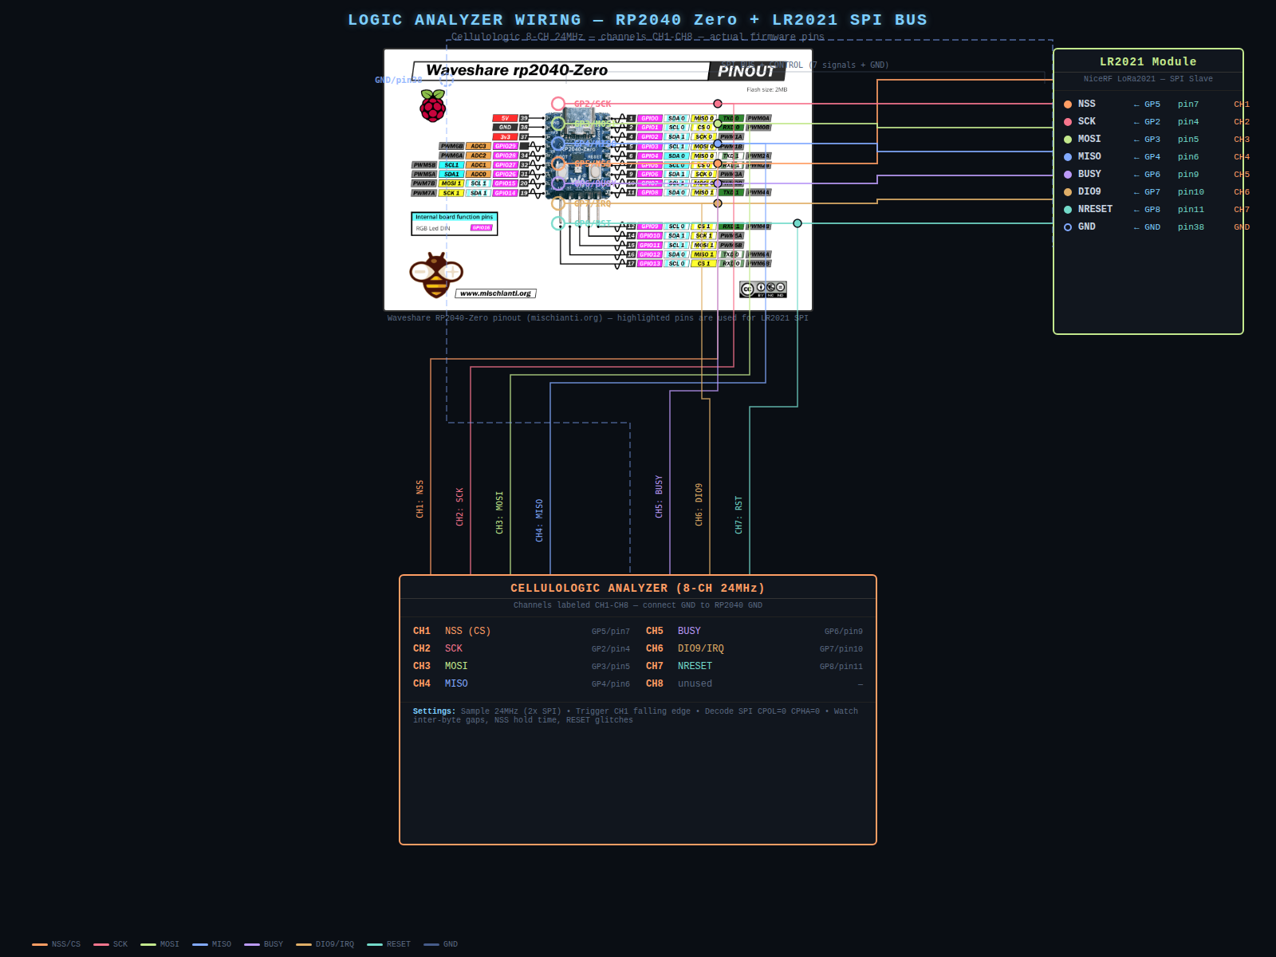
docs/logic-analyzer-wiring-rp2040-zero.png
