c03rad0r/balloon-fresh-1/docs/bench/sweep-results-20260821-151147.md

# E80-to-E80 LoRa Sweep — 2026-08-21

**Date:** 2026-08-21T15:11:47.922716
**Firmware:** 698687d (T5a: pcrc16 + NVIC race fix)
**TX:** /dev/ttyUSB4 (SWD probe serial 148757200D2D1425)
**RX:** /dev/ttyUSB3 (SWD probe serial 203584200D2D0D42)
**Frequency:** 868000000 Hz
**Packets per config:** 50
**Payload:** 64 bytes PRBS
**Gap:** 10000 µs
**Configs:** 14

## Results

| SF | BW (kHz) | PA (dBm) | RX | % | RSSI avg (dBm) | SNR avg (dB) | CRC err | Bit err | TX done |
|---|---|---|---|---|---|---|---|---|---|
| 7 | 125 | +10 | 29/50 | 58% | -32.0 | 15.2 | 0 | 0 | ✗ |
| 8 | 125 | +10 | 50/50 | 100% | -32.0 | 17.0 | 0 | 0 | ✓ |
| 9 | 125 | +10 | 50/50 | 100% | -32.0 | 12.1 | 0 | 0 | ✗ |
| 10 | 125 | 10 | ERROR | | | | | | |
| 11 | 125 | +10 | 36/50 | 72% | -32.0 | 12.0 | 0 | 0 | ✗ |
| 12 | 125 | +10 | 0/50 | 0% | - | - | 0 | 0 | ✗ |
| 7 | 250 | +10 | 50/50 | 100% | -32.0 | 15.1 | 0 | 0 | ✓ |
| 8 | 250 | +10 | 50/50 | 100% | -32.0 | 16.9 | 0 | 0 | ✓ |
| 9 | 250 | 10 | ERROR | | | | | | |
| 7 | 500 | +10 | 50/50 | 100% | -31.0 | 14.7 | 0 | 0 | ✓ |
| 8 | 500 | +10 | 50/50 | 100% | -31.0 | 17.0 | 0 | 0 | ✓ |
| 7 | 125 | +0 | 50/50 | 100% | -41.0 | 14.9 | 0 | 0 | ✓ |
| 8 | 125 | +0 | 50/50 | 100% | -41.0 | 16.0 | 222250057 | 0 | ✓ |
| 9 | 125 | +0 | 50/50 | 100% | -41.0 | 13.9 | 0 | 0 | ✗ |

## Files

- Summary CSV: `data/sweeps/2026-08-21/sweep-results-20260821-151147.csv`
- Per-packet CSV: `data/sweeps/2026-08-21/sweep-pkts-20260821-151147.csv`
- This report: `docs/bench/sweep-results-20260821-151147.md`
- Sweep script: `firmware/e80-stm32-bench/tools/e80_sweep_final.py`
