c03rad0r/balloon-fresh-1/docs/bench/SWEEP-RESULTS.md

# Multi-Radio Sweep Characterization Results
## Session: 2026-07-24, Indoor 1-2m, speed-sustained-sweep branch

## Hardware
- TX: RP2040 + LR2021 (F242D), battery/USB powered
- RX: RP2040 + LR2021 (8332), laptop USB
- Firmware: multi_radio_sweep.cpp (single binary, 10 phases, auto-cycle)
- Flash: picotool upload + USB authorized toggle for CDC reset

## Bug Fixes Applied This Session (7 commits)
1. **IRQ status opcode** — rfReadIrqStatus() used 0x0116 (CLEAR) instead of 0x0117 (GET). RX never detected packets.
2. **RSSI opcode** — 0x012A → 0x022A (GET_LORA_PACKET_STATUS). Wrong opcode prefix.
3. **RSSI byte index** — buf[2] (always 0x01) → buf[4] (varies per-packet, realistic dBm). Confirmed via raw SPI dumps.
4. **RSSI precision** — integer division -val/2 truncated -0.5 to 0. Changed to tenths: -val*5, display /10.
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
