c03rad0r/balloon-fresh-1/data/characterization-all-14-phases.png

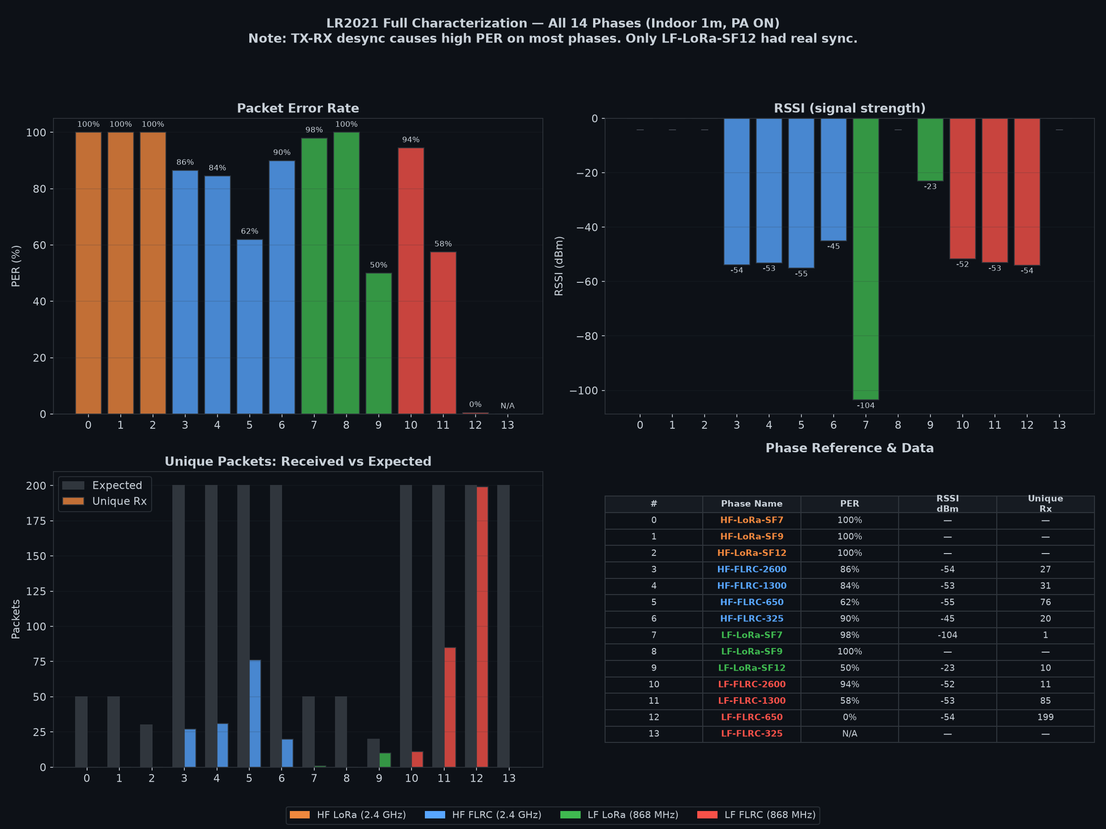
data/characterization-all-14-phases.png
