c03rad0r/balloon-fresh-1/data/full_characterization.png

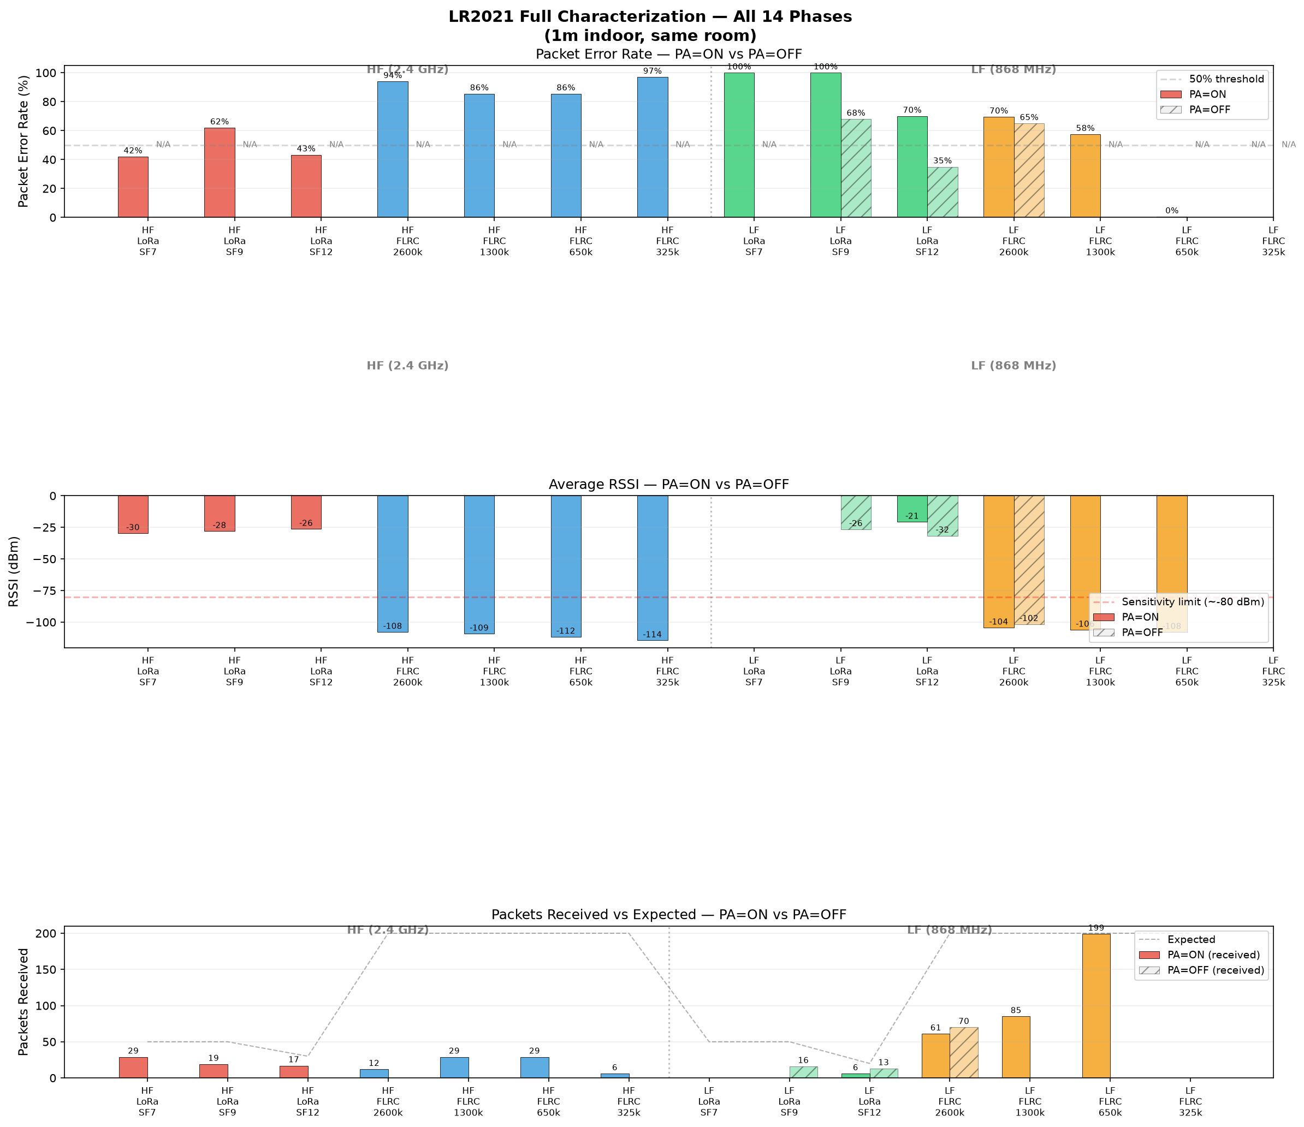
data/full_characterization.png
