c03rad0r/balloon-fresh-1/data/range-tests/20260725/analysis/flrc-per-vs-bw-merged.png

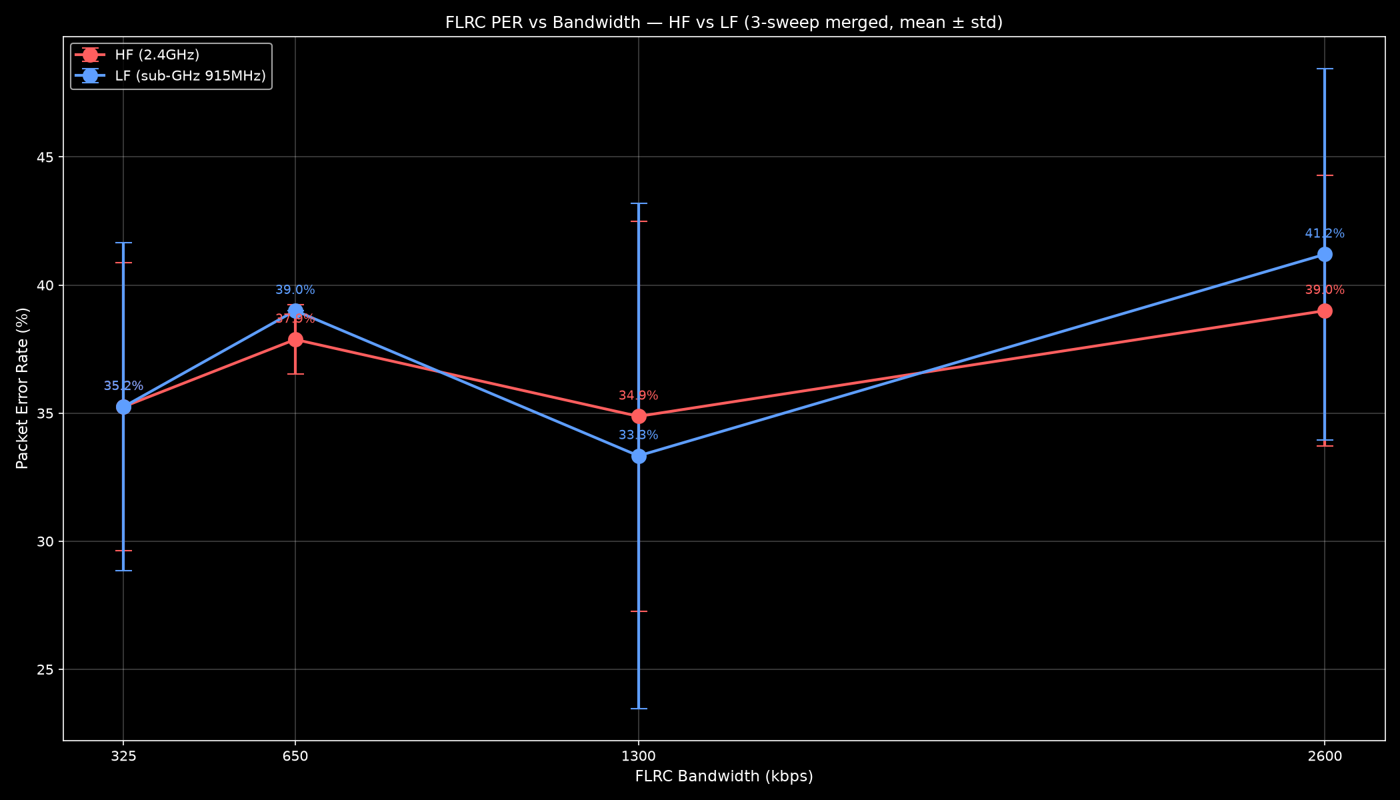
data/range-tests/20260725/analysis/flrc-per-vs-bw-merged.png
