c03rad0r/balloon-fresh-1/data/range-tests/20260725/analysis/mode-reliability-matrix.png

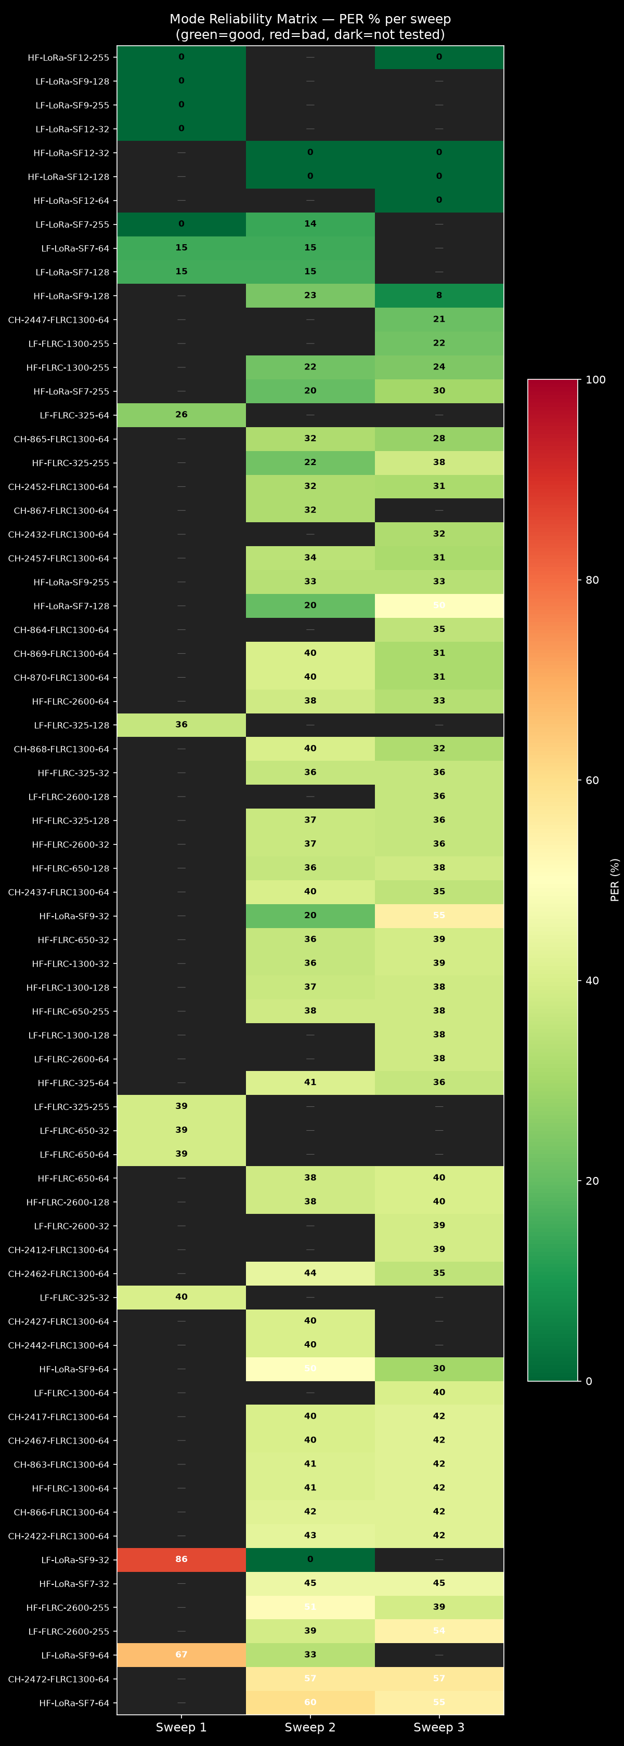
data/range-tests/20260725/analysis/mode-reliability-matrix.png
