c03rad0r/balloon-fresh-1/data/sweep-test-results-20260724.png

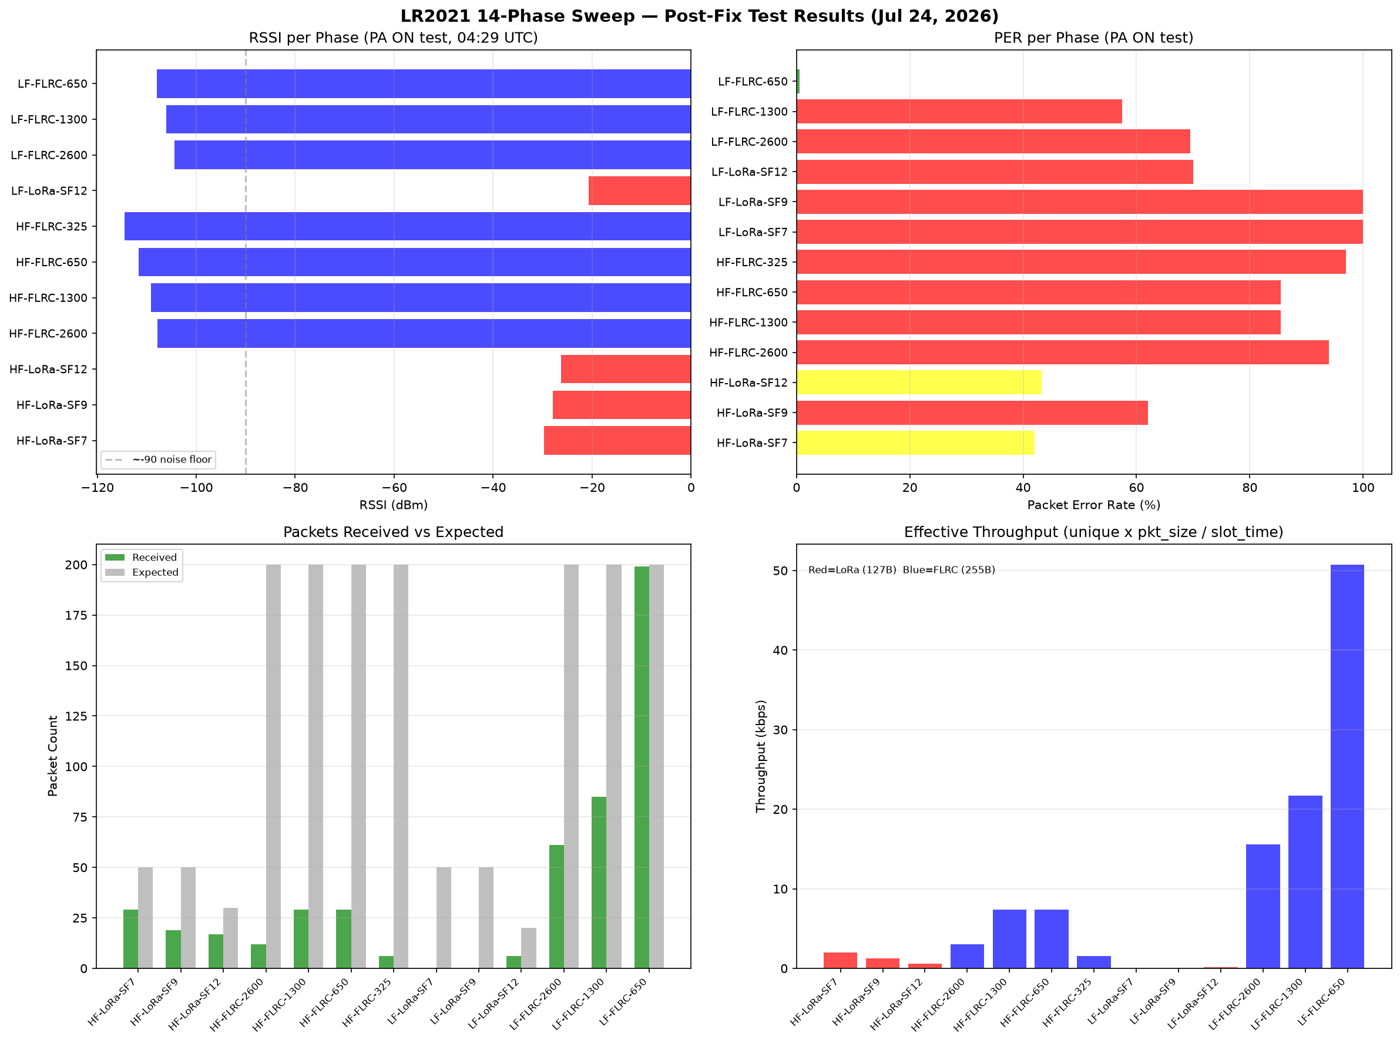
data/sweep-test-results-20260724.png
