c03rad0r/balloon-fresh-1/data/walk-5km-results.png

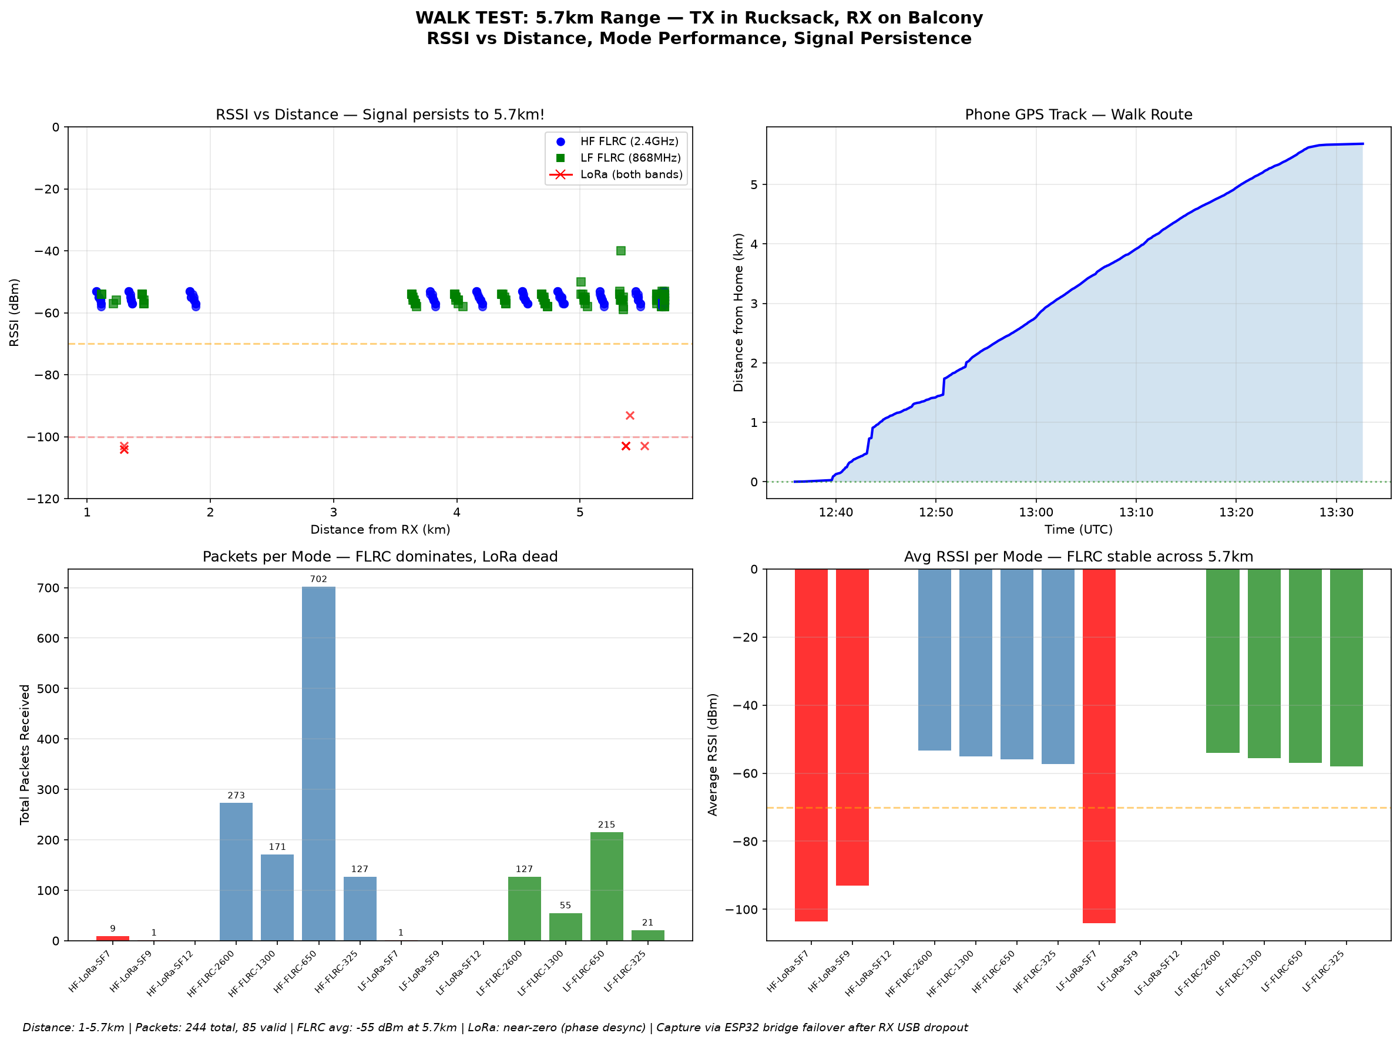
data/walk-5km-results.png
