c03rad0r/balloon-fresh-1/data/walk-test-results.png

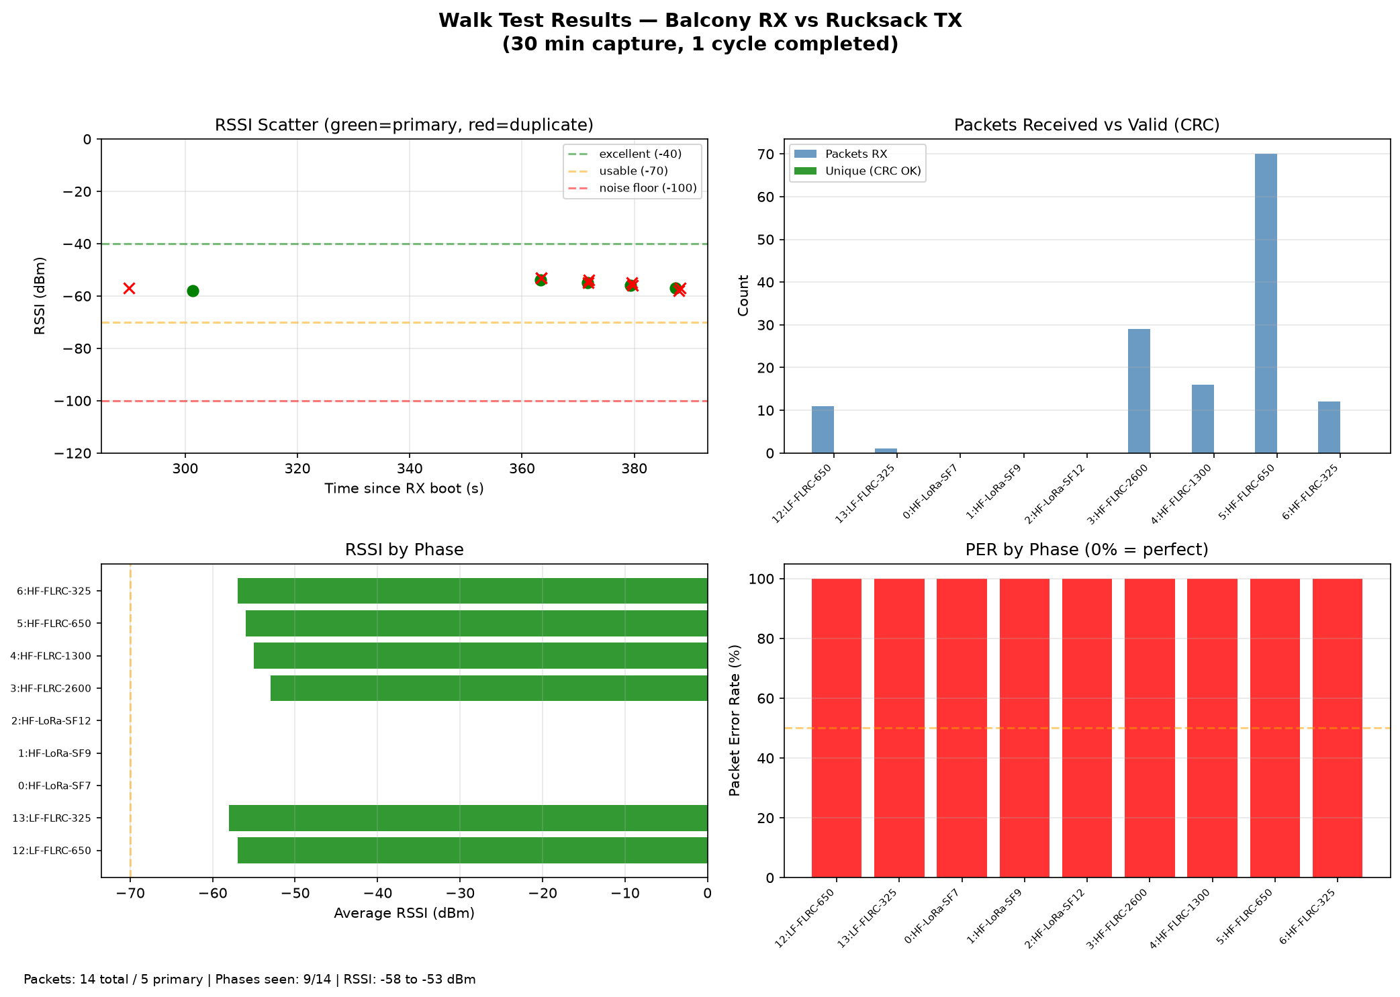
data/walk-test-results.png
