c03rad0r/balloon-fresh-1/data/walk-tests/plots/walk-20260726-063356/03_packets_decoded_vs_lost.png

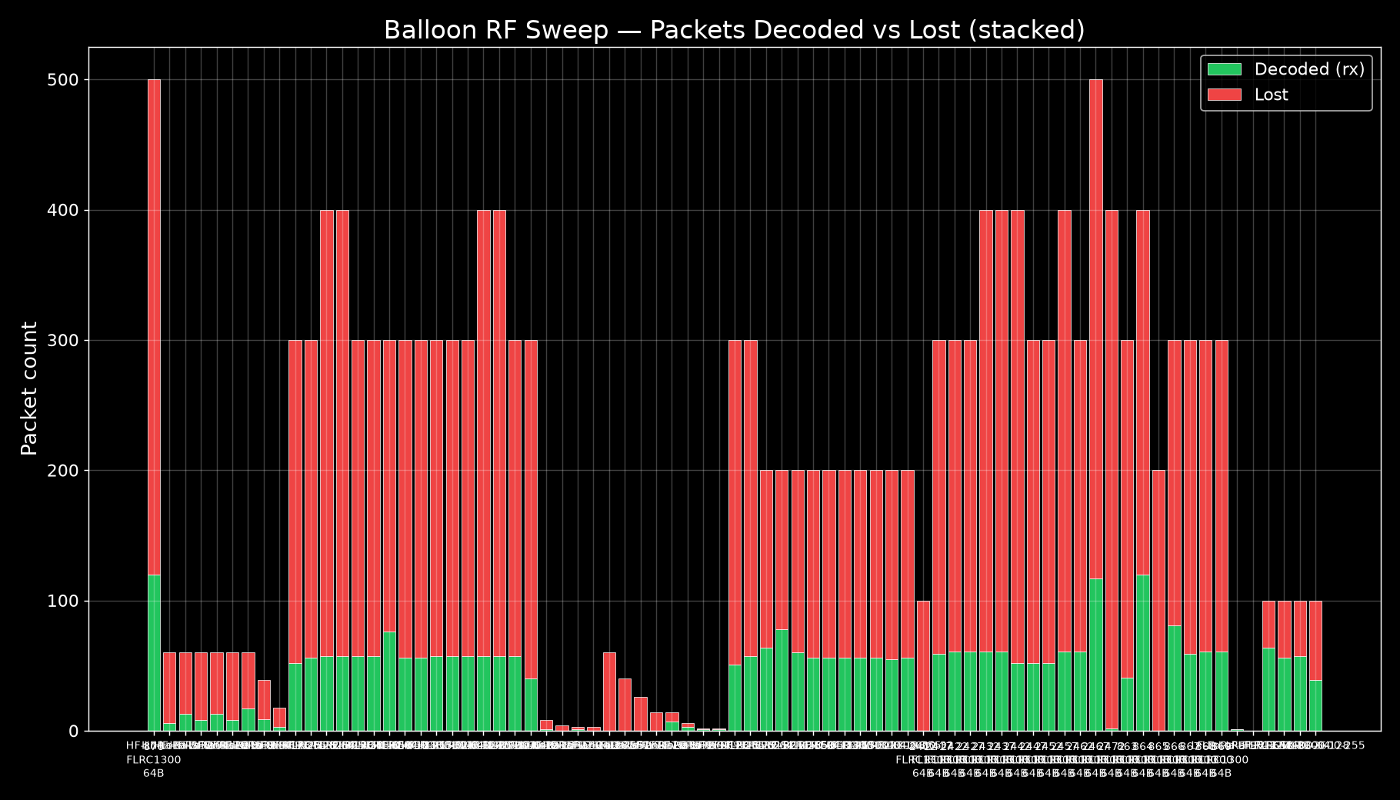
data/walk-tests/plots/walk-20260726-063356/03_packets_decoded_vs_lost.png
