c03rad0r/balloon-fresh-1/data/walk-tests/plots/walk-20260726-063356/05_rssi_vs_sequence.png

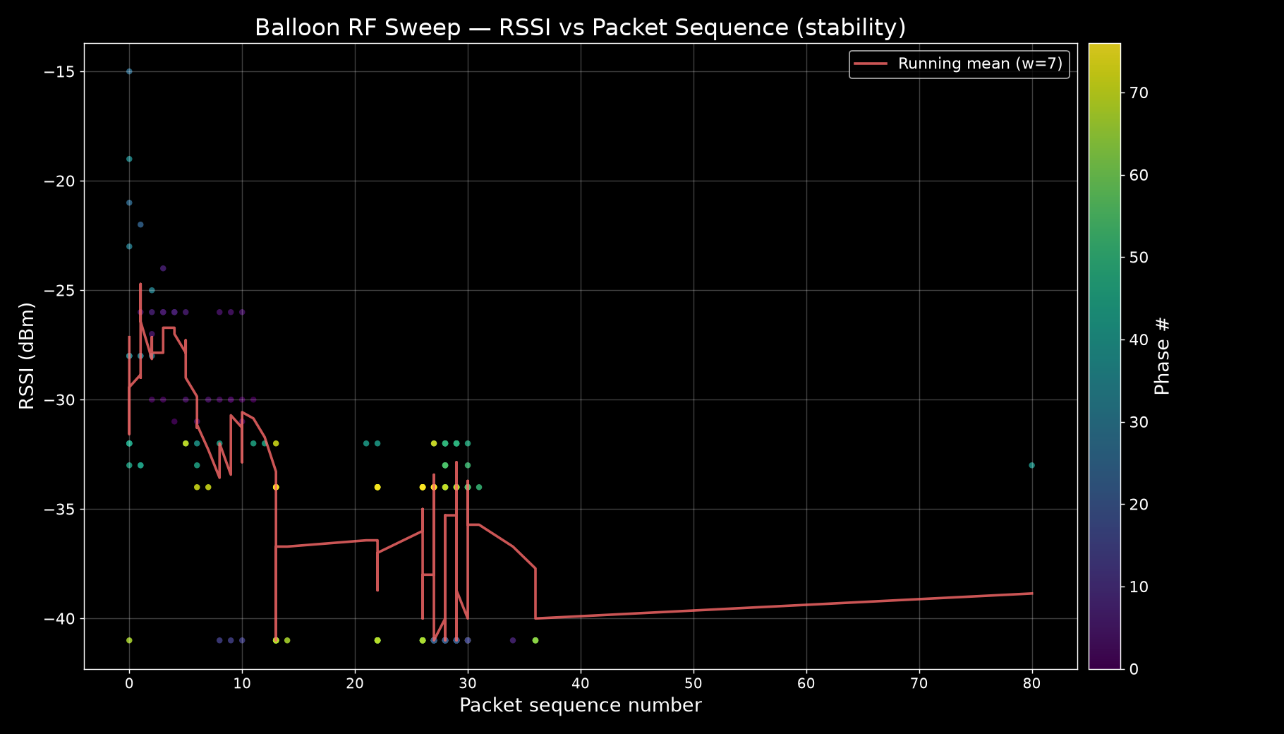
data/walk-tests/plots/walk-20260726-063356/05_rssi_vs_sequence.png
