c03rad0r/balloon-fresh-1/data/walk-tests/plots/walk-20260727-011900/02_rssi_by_phase.png

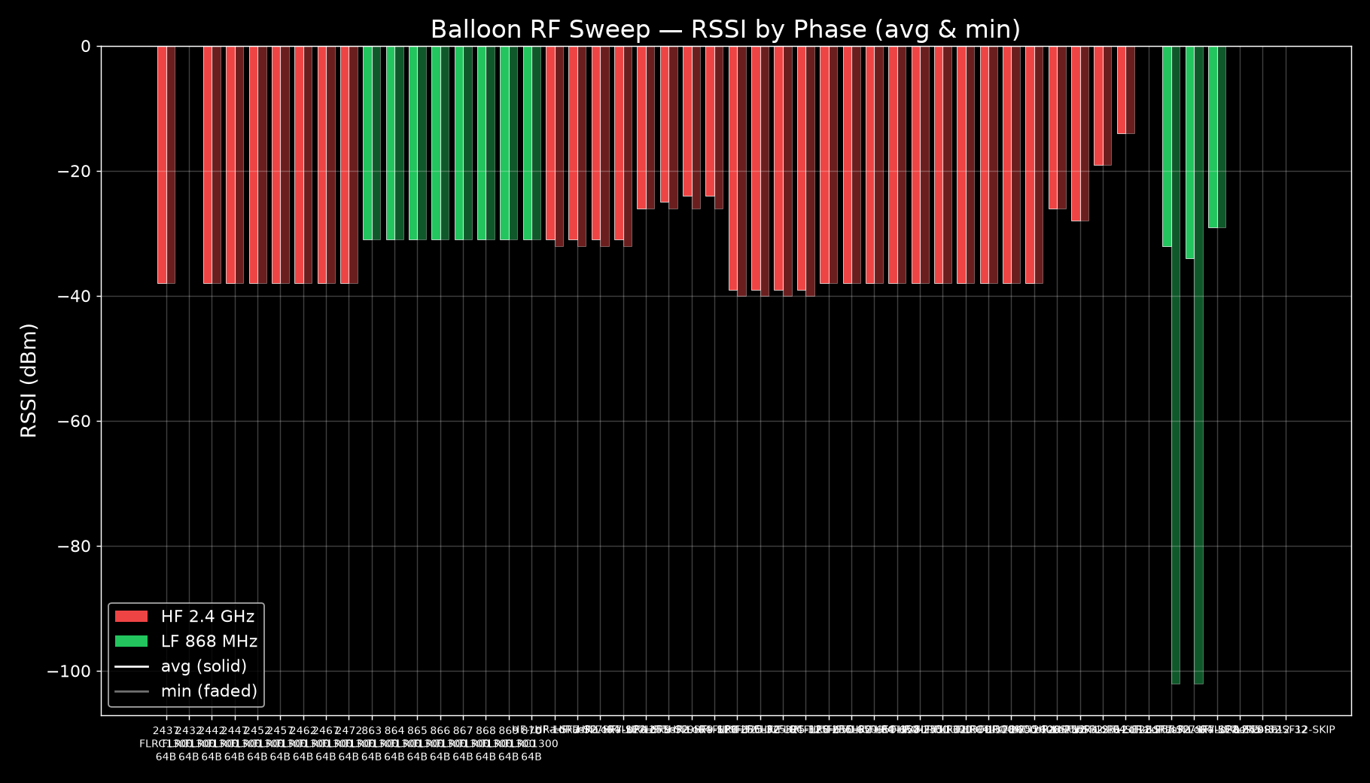
data/walk-tests/plots/walk-20260727-011900/02_rssi_by_phase.png
