c03rad0r/balloon-fresh-1/data/walk-tests/plots/walk-20260727-011900/03_packets_decoded_vs_lost.png

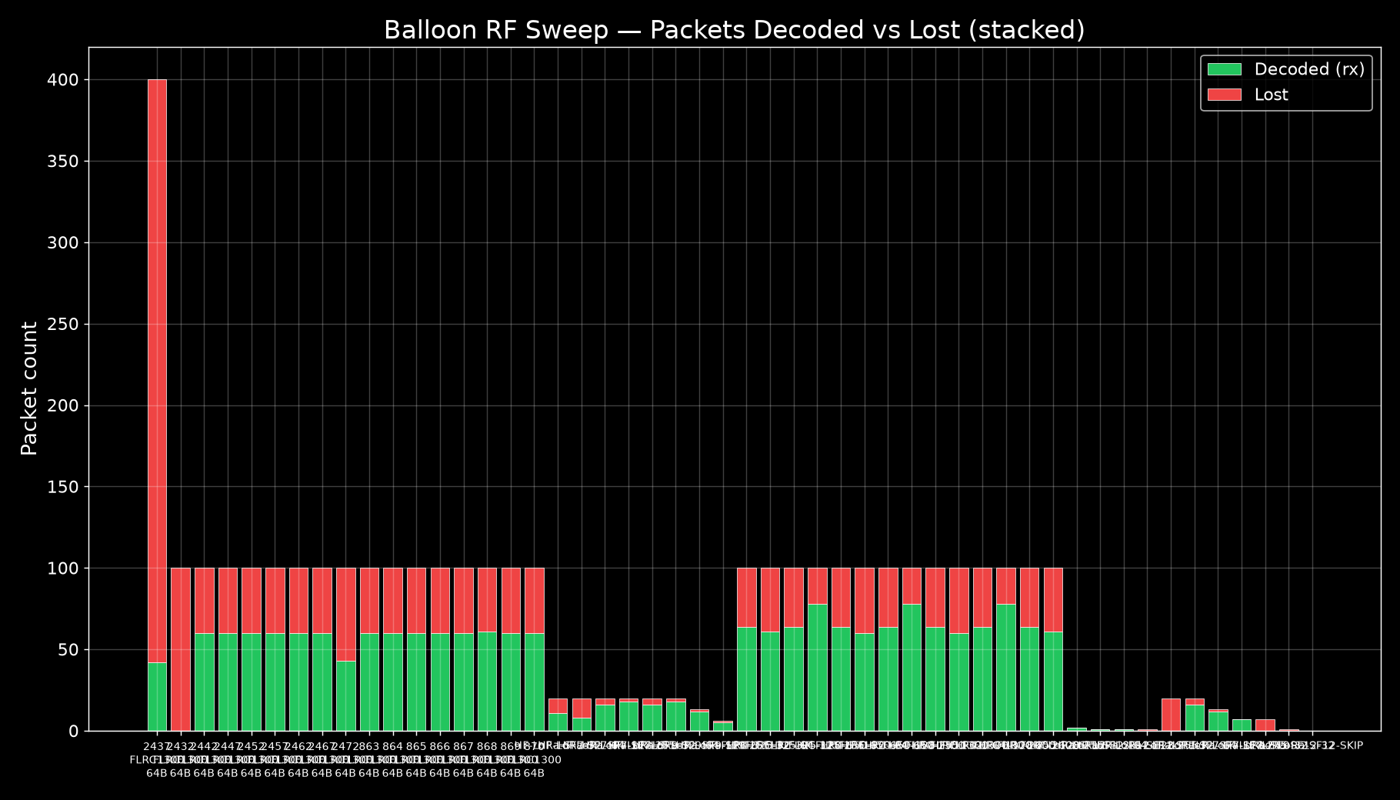
data/walk-tests/plots/walk-20260727-011900/03_packets_decoded_vs_lost.png
