c03rad0r/balloon-fresh-1/data/walk-tests/plots/walk-20260727-011900/06_gps_sats_over_time.png

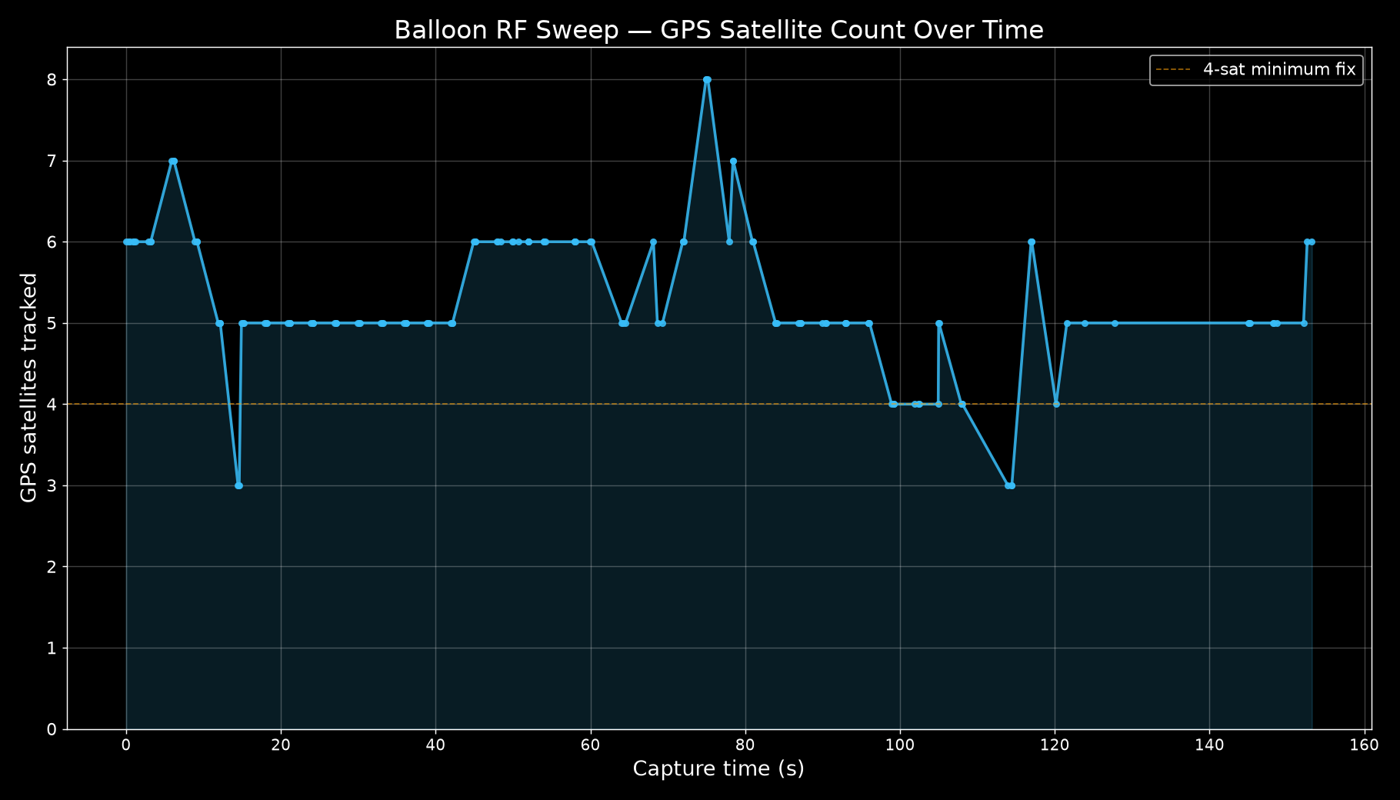
data/walk-tests/plots/walk-20260727-011900/06_gps_sats_over_time.png
