c03rad0r/balloon-fresh-1/data/walk-tests/walk_gps_track.png

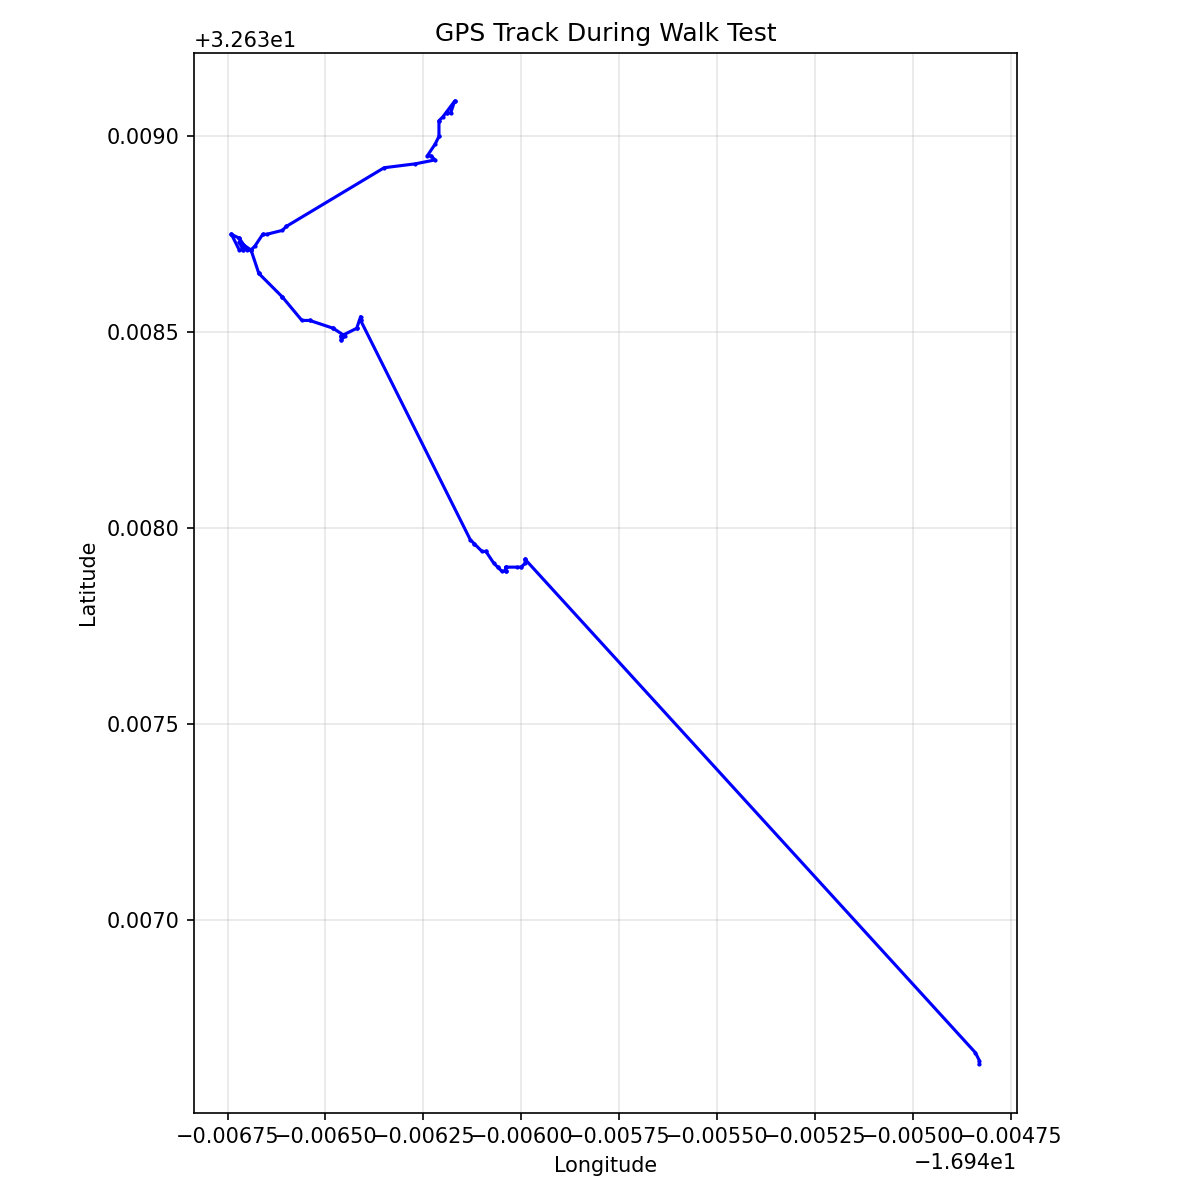
data/walk-tests/walk_gps_track.png
