c03rad0r/balloon-fresh-1/data/walk-tests/walk_per_vs_distance.png

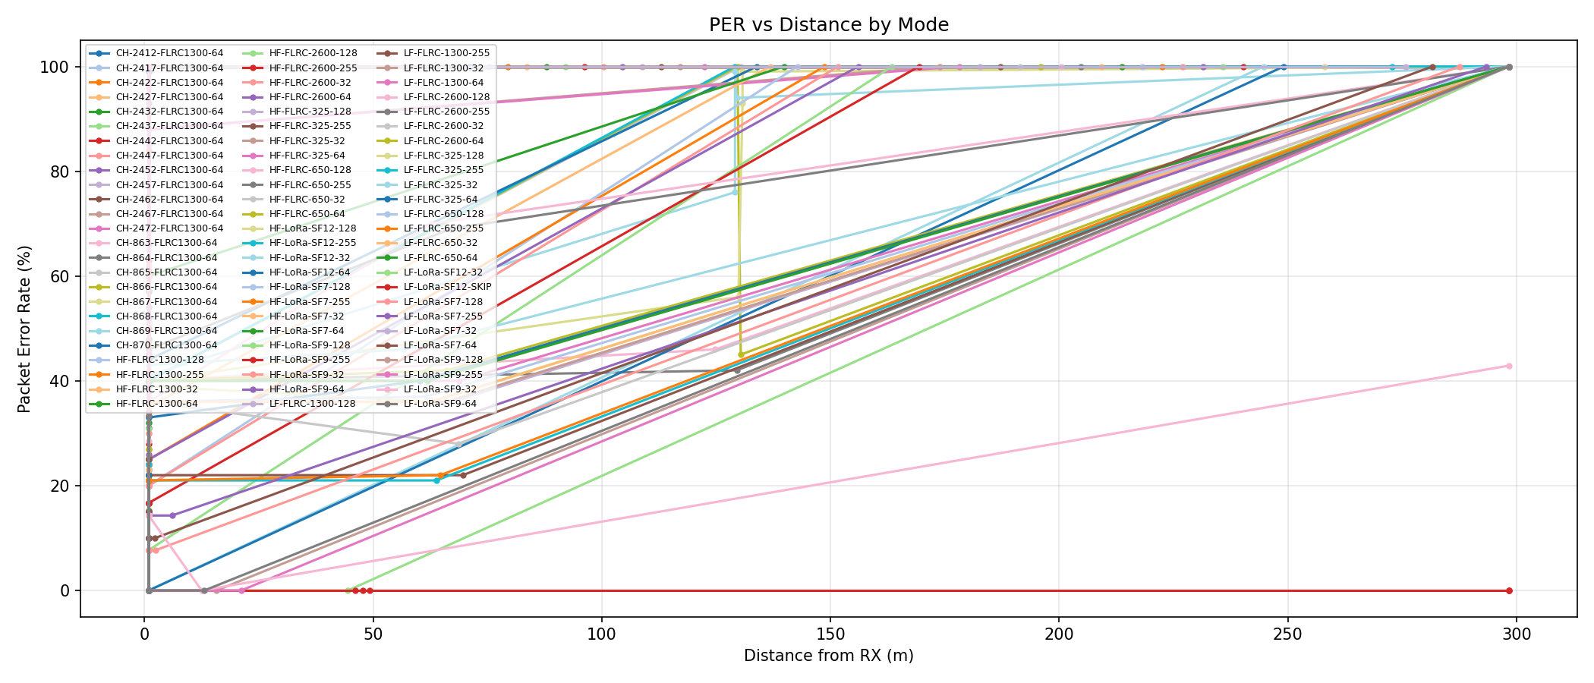
data/walk-tests/walk_per_vs_distance.png
