c03rad0r/balloon-fresh-1/data/walk-tests/walk_rssi_over_time.png

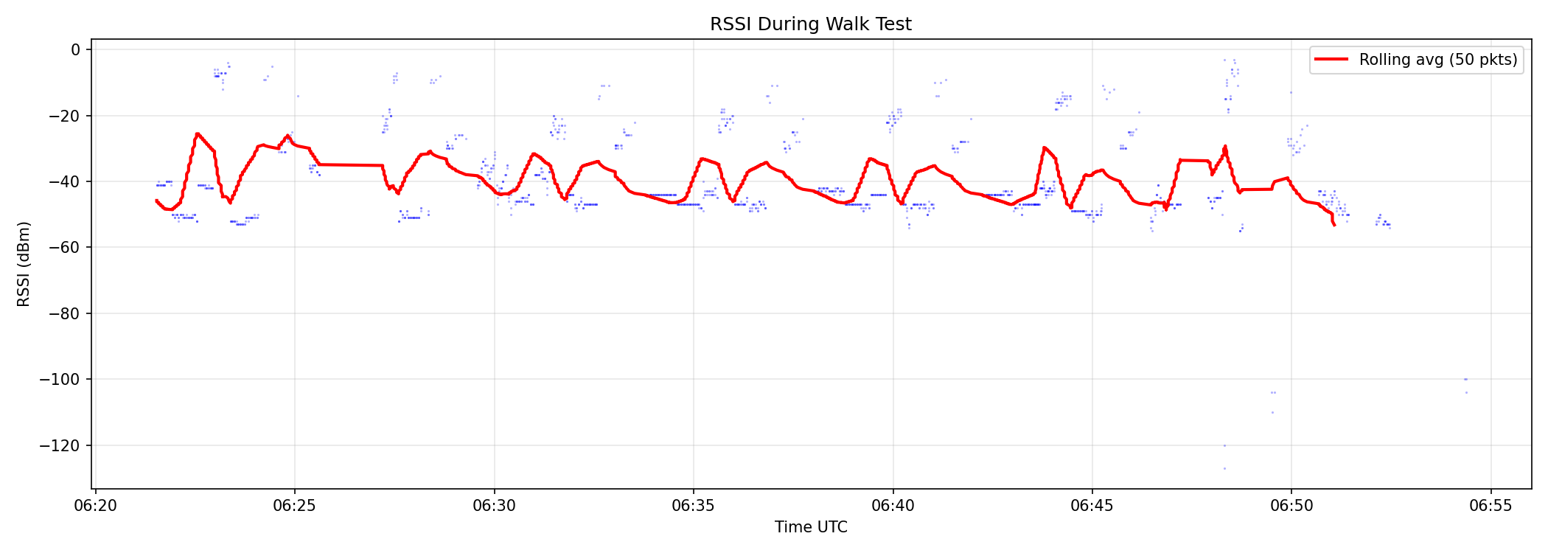
data/walk-tests/walk_rssi_over_time.png
