c03rad0r/balloon-fresh-1/data/walk-tests/walk_rssi_scatter_by_mode.png

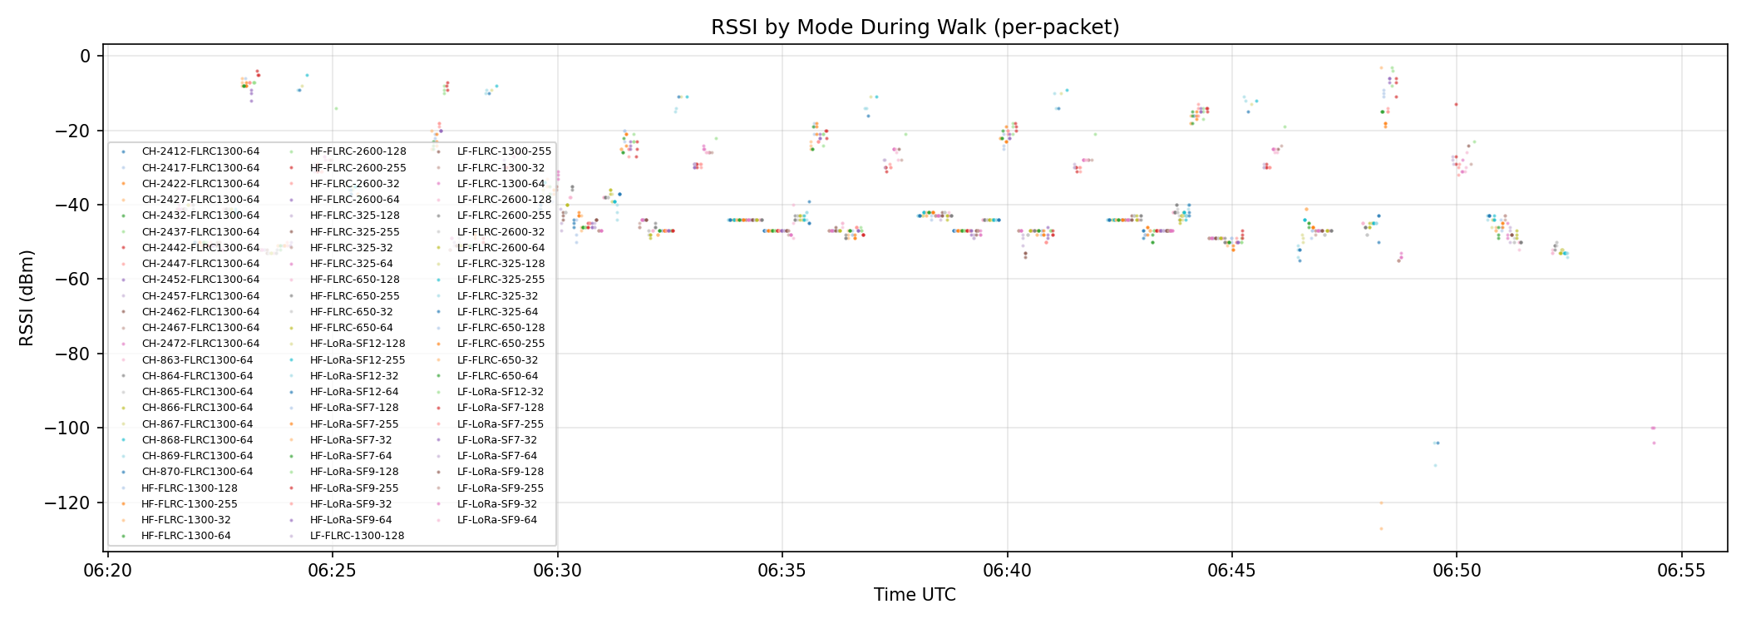
data/walk-tests/walk_rssi_scatter_by_mode.png
