c03rad0r/balloon-fresh-1/data/walk-tests/walk_throughput_loglog.png

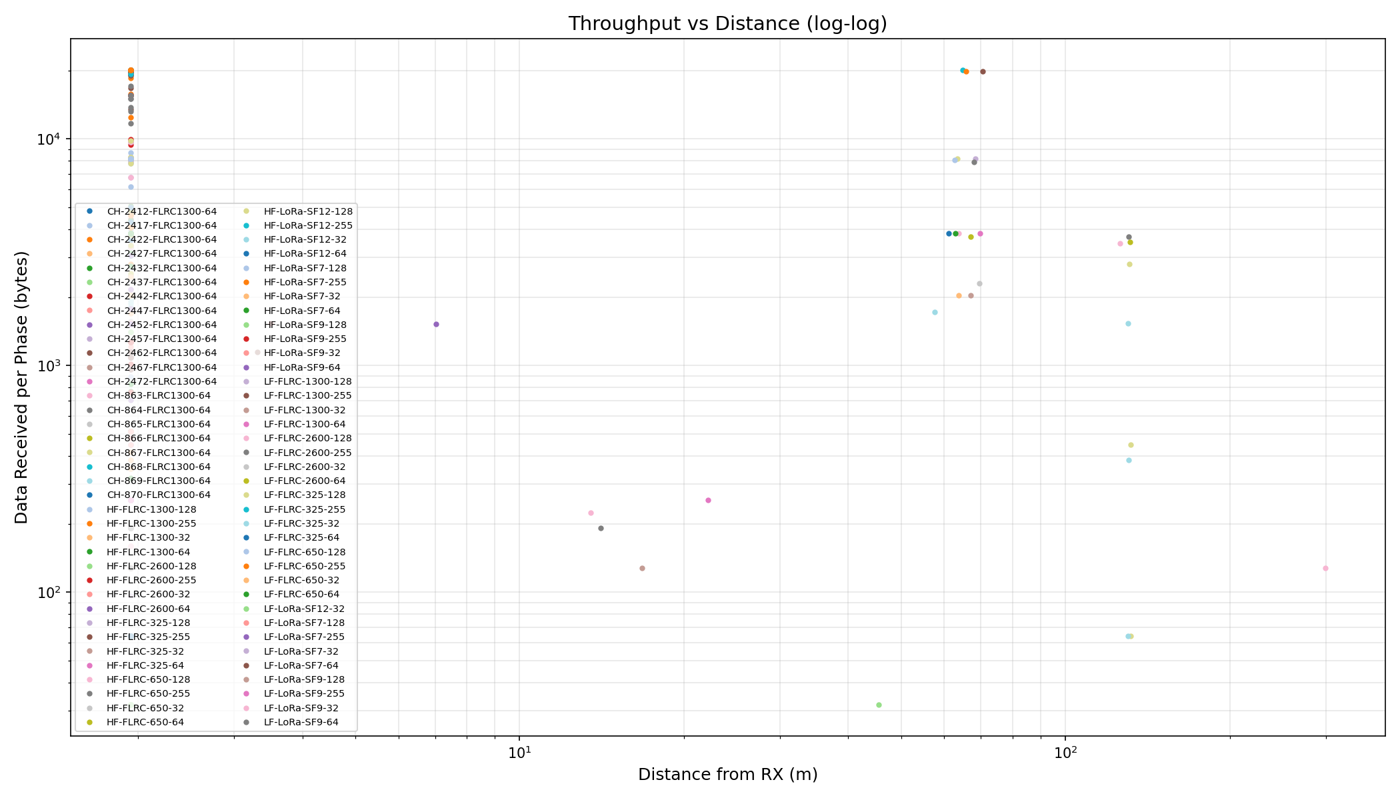
data/walk-tests/walk_throughput_loglog.png
