c03rad0r/balloon-fresh-1/data/walk-tests/walk_throughput_lora_vs_flrc.png

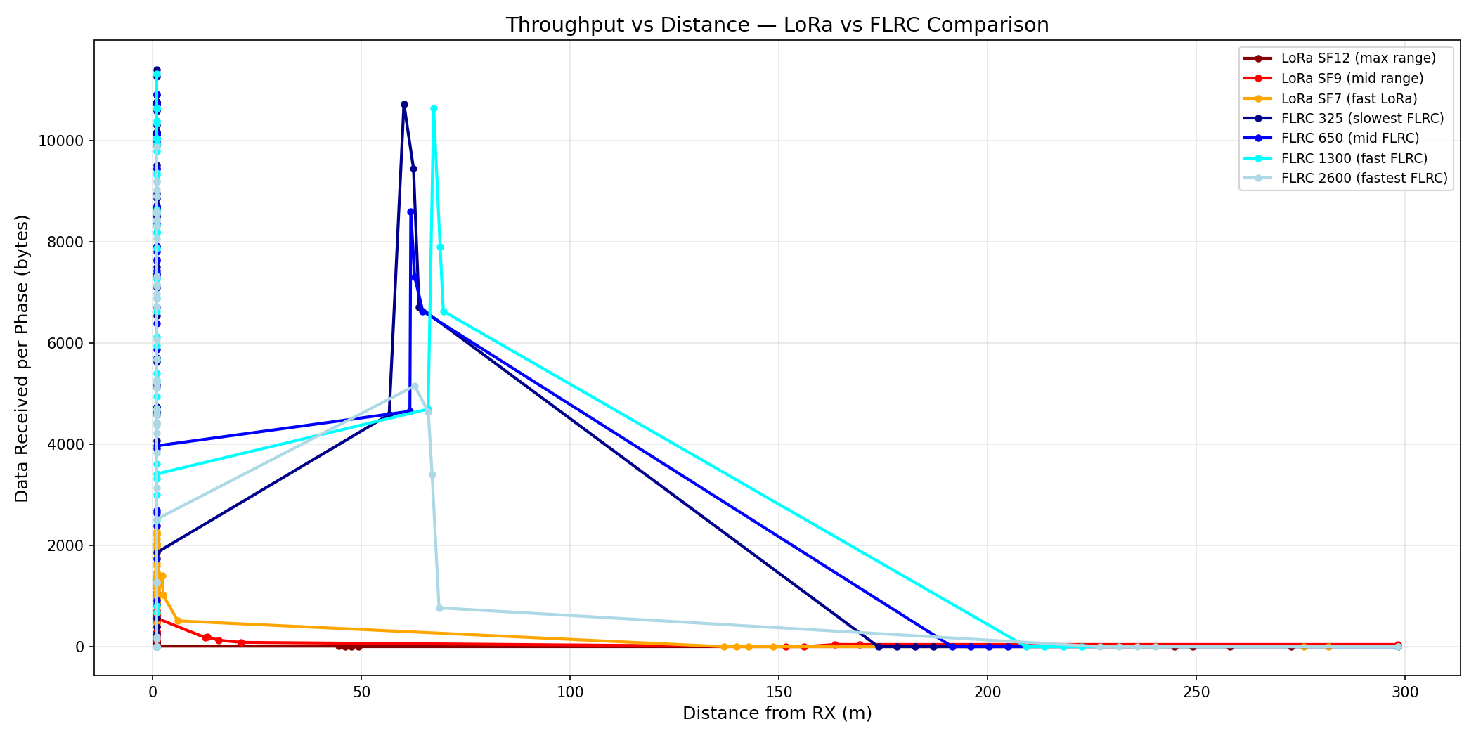
data/walk-tests/walk_throughput_lora_vs_flrc.png
