c03rad0r/balloon-fresh-1/data/walk-tests/walk_throughput_vs_distance_clean.png

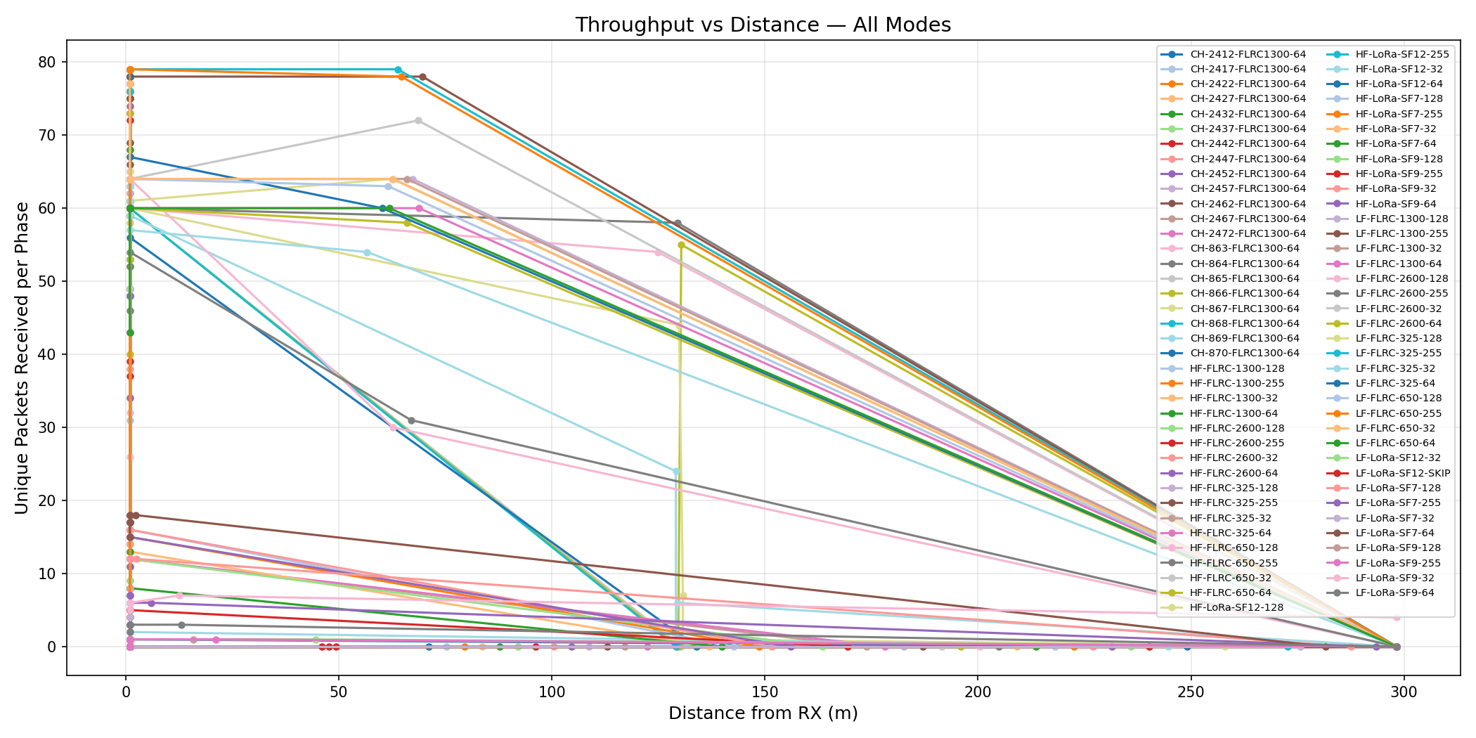
data/walk-tests/walk_throughput_vs_distance_clean.png
