c03rad0r/balloon-fresh-1/(list of files, drawings)

Other design files:
docs/assets/lr2021/LoRa2021_Package/LoRa2021_Package/LoRa2021V1.2_pads.pcb
docs/f33-module/materials/LORA2021F33-2G4 footprint_pads.pcb
tracker/hardware/output/c3_final_input.dsn
tracker/hardware/output/fr_trial2/clean.dsn
tracker/hardware/output/fr_trial/v7_4layer.dsn
tracker/hardware/output/freerouting_artifacts/v2_adc_freerouting_input.dsn
tracker/hardware/output/freerouting_artifacts/v2_adc_freerouting_routed.dsn
tracker/hardware/output/freerouting_artifacts/v2_adc_freerouting_test_input.dsn
tracker/hardware/output/handover-package/v7_routed.dsn
tracker/hardware/output/pcb-handoff/v7_routed.dsn
tracker/hardware/output/v1_clean_export.dsn
tracker/hardware/output/v1_fast_routed.dsn
tracker/hardware/output/v1_freerouting_output.dsn
tracker/hardware/output/v1_freerouting_routed.dsn
tracker/hardware/output/v2_adc_4layer.dsn
tracker/hardware/output/v2_adc_clean2.dsn
tracker/hardware/output/v2_adc_clean.dsn
tracker/hardware/output/v2_adc_fixed2.dsn
tracker/hardware/output/v2_adc_fixed3.dsn
tracker/hardware/output/v2_adc_fixed4.dsn
tracker/hardware/output/v2_adc_fixed.dsn
tracker/hardware/output/v2_adc_fixed_routed.dsn
tracker/hardware/output/v2_adc_freerouted2.dsn
tracker/hardware/output/v2_adc_freerouted.dsn
tracker/hardware/output/v2_adc_routed2.dsn
tracker/hardware/output/v2_adc_v3.dsn
tracker/hardware/output/v2_adc_v3_clean.dsn
tracker/hardware/output/v7_routed.dsn
tracker/hardware/output/v8_freerouting.dsn
tracker/hardware/output/v_c3_4layer.dsn
tracker/hardware/output/v_c3_flight_final.dsn
