c03rad0r/balloon-fresh-1/tracker/hardware/hub_board_v10_lora1280_7of9.kicad_pcb

## KiCad design tracker/hardware/hub_board_v10_lora1280_7of9.kicad_pcb (2026-10-30)

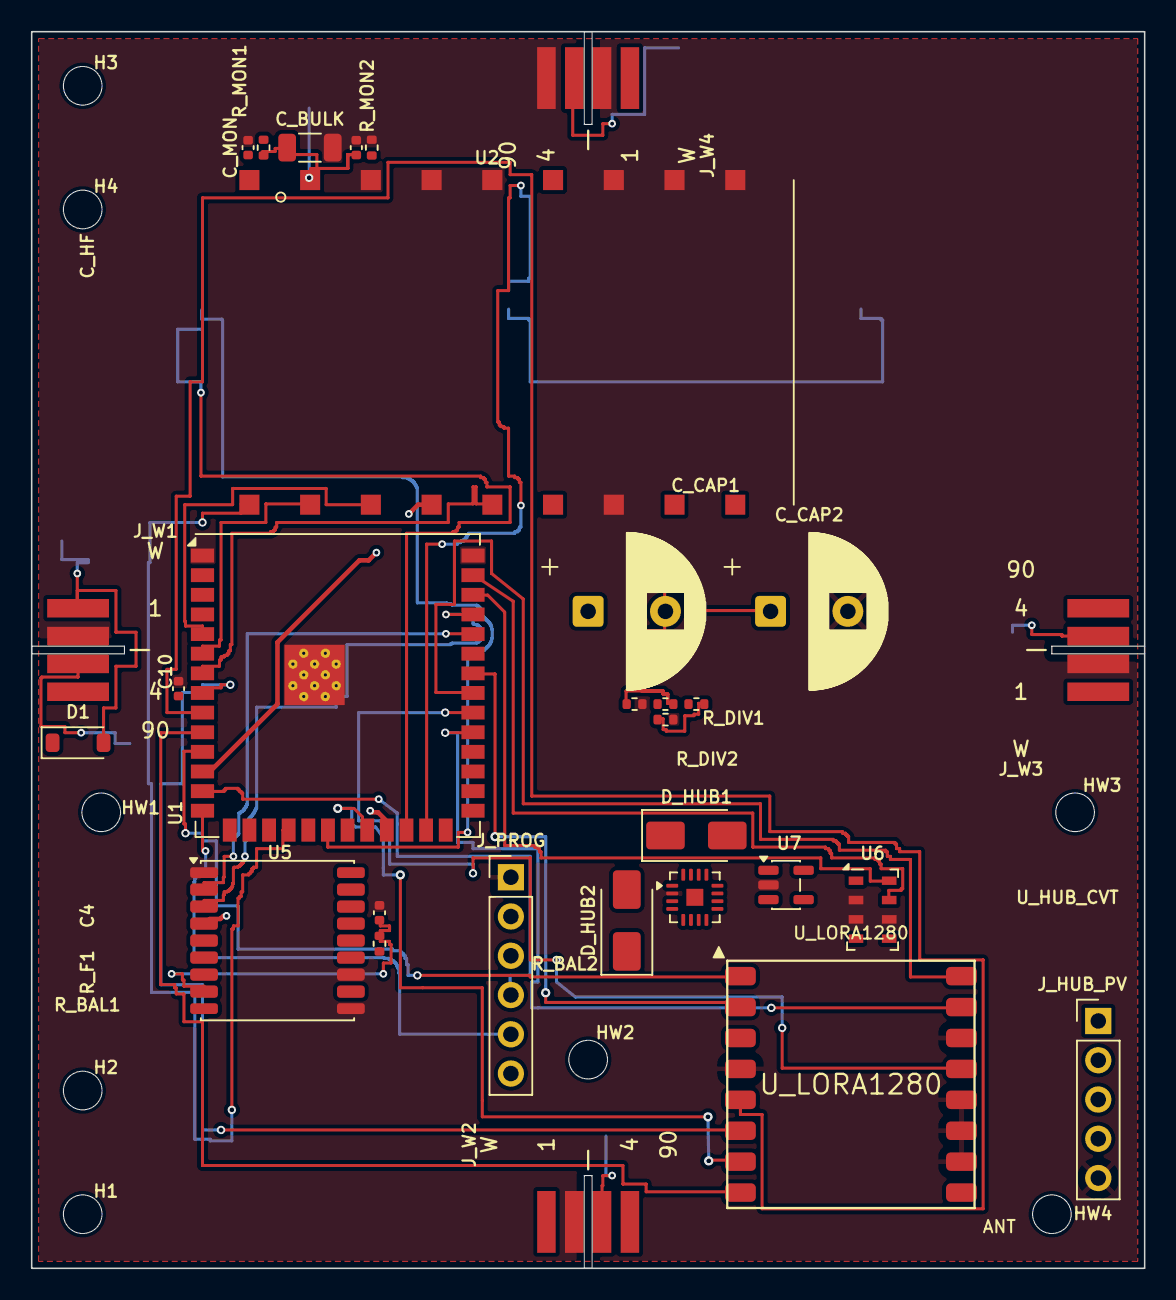
[picture p163: board hub_board_v10_lora1280_7of9.kicad_pcb from above]

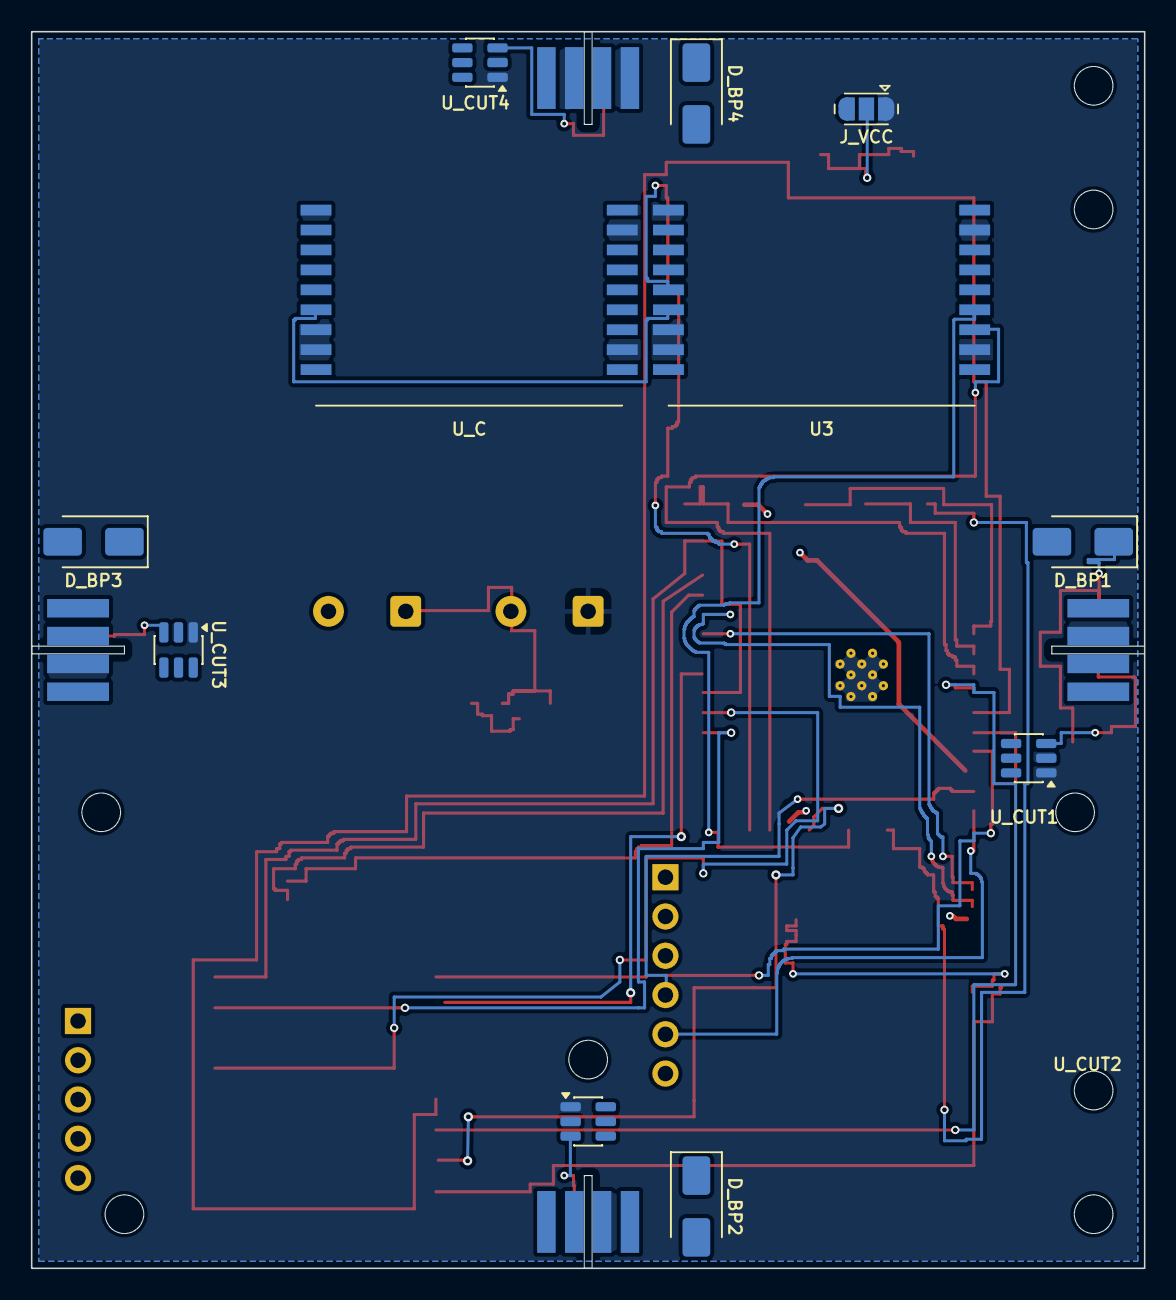
[picture p164: board hub_board_v10_lora1280_7of9.kicad_pcb from below]

Board: 4 copper layers, 72.0 x 80.0 mm, 49 parts (11 on the bottom side), 48 nets.

Parts:
C4, C10: 10uF; C_0402_1005Metric
C_BULK: 100uF; C_1206_3216Metric
C_CAP1: C_CAP1; CP_Radial_D10.0mm_P5.00mm
C_CAP2: C_CAP2; CP_Radial_D10.0mm_P5.00mm
C_HF: 100nF; C_0402_1005Metric
C_MON: 10nF; C_0402_1005Metric
D1: BAT54; D_SOD-123
D_BP1, D_BP2, D_BP3, D_BP4: SS24; D_SMA
D_HUB1, D_HUB2: SS24; D_SMA
H1, H2, H3, H4: TETHER_NPTH_D2.5; MountingHole_2.5mm
HW1, HW2, HW3, HW4: STRING_NPTH_D2.5; MountingHole_2.5mm
J_HUB_PV: HUB_PV_PANEL_5P (P | MID1 | spare | N | GND); PinHeader_1x05_P2.54mm_Vertical
J_PROG: J_PROG; PinHeader_1x06_P2.54mm_Vertical
J_VCC: F33_VCC_SEL (VSCAP | +3V3); SolderJumper-3_P1.3mm_Open_RoundedPad1.0x1.5mm
J_W1, J_W2, J_W3, J_W4: WING_SOCKET_4P; Wing_Tab_4P
R_BAL1, R_BAL2: 10k; R_0402_1005Metric
R_DIV1, R_DIV2: 1M; R_0402_1005Metric
R_F1: 100R; R_0402_1005Metric
R_MON1, R_MON2: 4.7M; R_0402_1005Metric
U1: U1; ESP32-S3-WROOM-1U
U2: U2; LoRa2021F33_2G4
U3: U3; LoRa2021_Castellated
U5: U5; ublox_MAX
U6: U6; LGA-8_3x5mm_P1.25mm
U7: U7; SOT-23-5
U_C: U_C; LoRa2021_Castellated
U_CUT1, U_CUT2, U_CUT3, U_CUT4: latched cut driver + cut-sense (part TODO(unverif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; SOT-23-6
U_HUB_CVT: U_HUB_CVT; VQFN-16-1EP_3x3mm_P0.5mm_EP1.1x1.1mm
U_LORA1280: LoRa1280

Connections:
+3V3: C10.1, J_PROG.2, J_VCC.3, R_F1.1, U1.2, U2.5, U3.1, U5.6, U5.7, U5.9, U6.1, U6.4, U6.5, U7.5, U_C.1, U_LORA1280.3 (VCC)
/CUT_SENSE_W1: J_W1.3, U_CUT1.3
/CUT_SENSE_W2: J_W2.3, U_CUT2.3
/CUT_SENSE_W3: J_W3.3, U_CUT3.3
/CUT_SENSE_W4: J_W4.3, U_CUT4.3
/E28_BUSY: U1.31, U_LORA1280.15 (BUSY)
/E28_CS_N: U1.10, U_LORA1280.8 (NSS)
/E28_DIO1: U1.33, U_LORA1280.16 (DIO1)
/E28_DIO2: U1.11, U_LORA1280.1 (DIO2)
/E28_DIO3: U1.34, U_LORA1280.2 (DIO3)
/E28_RESET_N: U1.32, U_LORA1280.13 (NRESET)
/EN: J_PROG.3, U1.3
/F33_BUSY: U1.12, U2.14
/F33_CS_N: U1.7, U2.13
/F33_IRQ: U1.17, U2.18
/F33_RESET_N: U1.18, U2.17
/F33_VCC: C_BULK.1, C_HF.1, J_VCC.2, R_MON1.1, U2.1
/F33_VSENSE: C_MON.1, R_MON1.2, R_MON2.1, U1.21
/GNSS_PPS: U1.23, U5.4
/GNSS_RX: U1.37, U5.3
/GNSS_TX: U1.36, U5.2
/GNSS_VCC: C4.1, R_F1.2, U5.8
/HUB_PV_MID1: D_HUB1.2, D_HUB2.1, J_HUB_PV.2
/HUB_PV_N: D_HUB2.2, J_HUB_PV.4, U_HUB_CVT.3
/HUB_PV_P: D_HUB1.1, J_HUB_PV.1, U_HUB_CVT.1
/I2C_SCL: U1.38, U6.8
/I2C_SDA: U1.39, U6.7
/SCAP_ADC: R_DIV1.2, R_DIV2.1
/SCAP_MID: C_CAP1.2, C_CAP2.1, R_BAL1.2, R_BAL2.1
/SPI1_MISO: U1.9, U3.3, U_C.3, U_LORA1280.5 (MISO)
/SPI1_MOSI: U1.8, U3.4, U_C.4, U_LORA1280.6 (MOSI)
/SPI1_SCK: U1.22, U3.5, U_C.5, U_LORA1280.7 (SCK)
/SPI2_MISO: U1.6, U2.16
/SPI2_MOSI: U1.5, U2.15
/SPI2_SCK: U1.4, U2.12
/U3_BUSY: U1.24, U3.7
/U3_CS_N: U1.20, U3.6
/U3_IRQ: U1.19, U3.15
/U3_RESET_N: U1.25, U3.14
/USB_DN: J_PROG.4, U1.13
/USB_DP: J_PROG.5, U1.14
/VSCAP: C_CAP1.1, D1.1, J_VCC.1, R_BAL1.1, R_DIV1.1, U7.1, U7.3, U_CUT1.1, U_CUT2.1, U_CUT3.1, U_CUT4.1
/VTCXO_VNTC: U3.13, U_C.13
/W1_SOLAR_N: D_BP1.2, D_BP2.1, J_W1.4, J_W2.1
/W1_SOLAR_P: D1.2, D_BP1.1, J_W1.1
/W2_SOLAR_N: D_BP2.2, D_BP3.1, J_W2.4, J_W3.1
/W3_SOLAR_N: D_BP3.2, D_BP4.1, J_W3.4, J_W4.1
GND: C4.2, C10.2, C_BULK.2, C_CAP2.2, C_HF.2, C_MON.2, D_BP4.2, J_HUB_PV.5, J_PROG.1, J_W1.2, J_W2.2, J_W3.2, J_W4.2, J_W4.4, R_BAL2.2, R_DIV2.2, R_MON2.2, U1.1, U1.40, U1.41, U2.2, U2.3, U2.4, U2.6, U2.7, U2.8, U2.11, U3.2, U3.8, U3.11, U3.12, U3.18, U5.1, U5.10, U5.12, U6.2, U6.3, U6.6, U7.2, U_C.2, U_C.8, U_C.11, U_C.12, U_C.18, U_CUT1.2, U_CUT2.2, U_CUT3.2, U_CUT4.2, U_HUB_CVT.2, U_LORA1280.4 (GND), U_LORA1280.10 (GND), U_LORA1280.11 (GND), U_LORA1280.12 (GND), U_LORA1280.14 (GND)
