c03rad0r/balloon-fresh-1/tracker/hardware/wing_interconnect/wing_interconnect_v1.kicad_pcb

## KiCad design tracker/hardware/wing_interconnect/wing_interconnect_v1.kicad_pcb (2026-10-25)

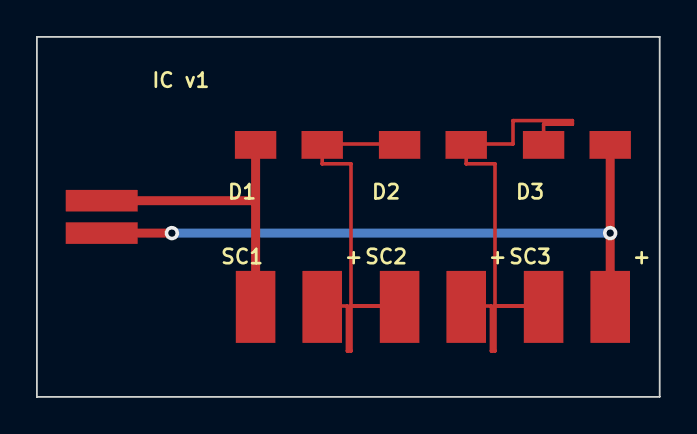
[picture p165: board wing_interconnect_v1.kicad_pcb from above]

Board: 2 copper layers, 34.6 x 20.0 mm, 7 parts (0 on the bottom side), 4 nets.

Parts:
D1, D2, D3: D_SMA_Wing
J1: Tab_2P
SC1, SC2, SC3: SolarTail_2P

Connections:
SOLAR_MID1: D1.2, D2.1, SC1.2, SC2.1
SOLAR_MID2: D2.2, D3.1, SC2.2, SC3.1
SOLAR_N: D3.2, J1.2, SC3.2
SOLAR_P: D1.1, J1.1, SC1.1
