c03rad0r/balloon-fresh-1/tracker/hardware/wing_board/wing_board_v9.kicad_pcb

## KiCad design tracker/hardware/wing_board/wing_board_v9.kicad_pcb (2026-10-17)

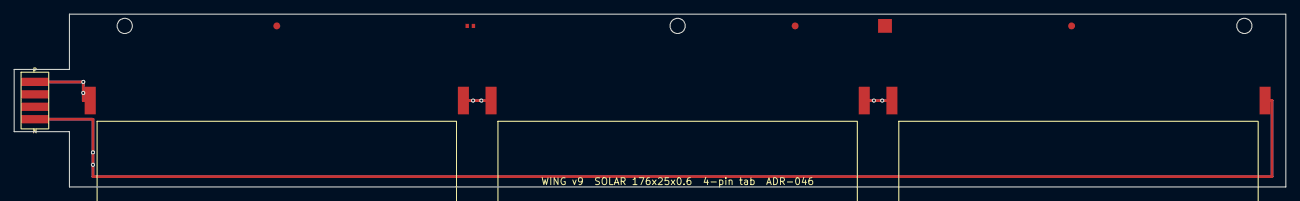
[picture p166: board wing_board_v9.kicad_pcb from above]

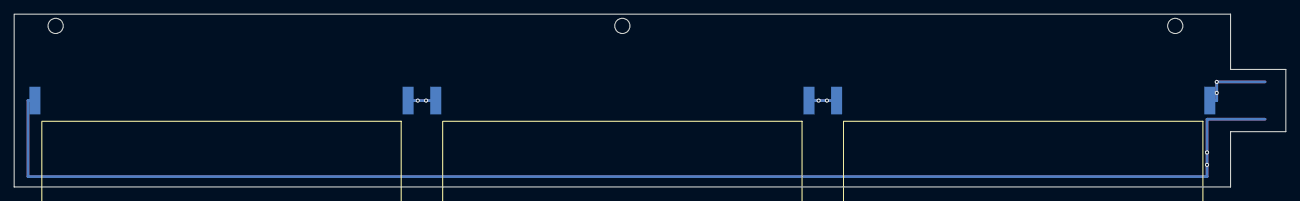
[picture p167: board wing_board_v9.kicad_pcb from below]

Board: 2 copper layers, 184.0 x 25.0 mm, 15 parts (3 on the bottom side), 4 nets.

Parts:
FB1: FerriteBead_0402_DNP_V2only; FerriteBead_0402_V2provision
FID1, FID2, FID3: Fiducial_1mm_Mask2mm
H1, H2, H3: MountingHole_NPTH_2.2mm; MountingHole_2.2mm_NPTH
J1: WingTab_v9_4pin
RF1: RF_ProvisionPad_v2only
SC1, SC2, SC3, SC4, SC5, SC6: SolarCell_52x19mm_0.5V; SolarCell_52x19mm

Connections:
SOLAR_MID1: SC1.2, SC2.1, SC4.2, SC5.1
SOLAR_MID2: SC2.2, SC3.1, SC5.2, SC6.1
SOLAR_N: J1.4, SC3.2, SC6.2
SOLAR_P: J1.1, SC1.1, SC4.1
