c03rad0r/balloon-fresh-1/tracker/hardware/base_station/base_station_v1_placed_v2.kicad_pcb

## KiCad design tracker/hardware/base_station/base_station_v1_placed_v2.kicad_pcb (2026-10-15)

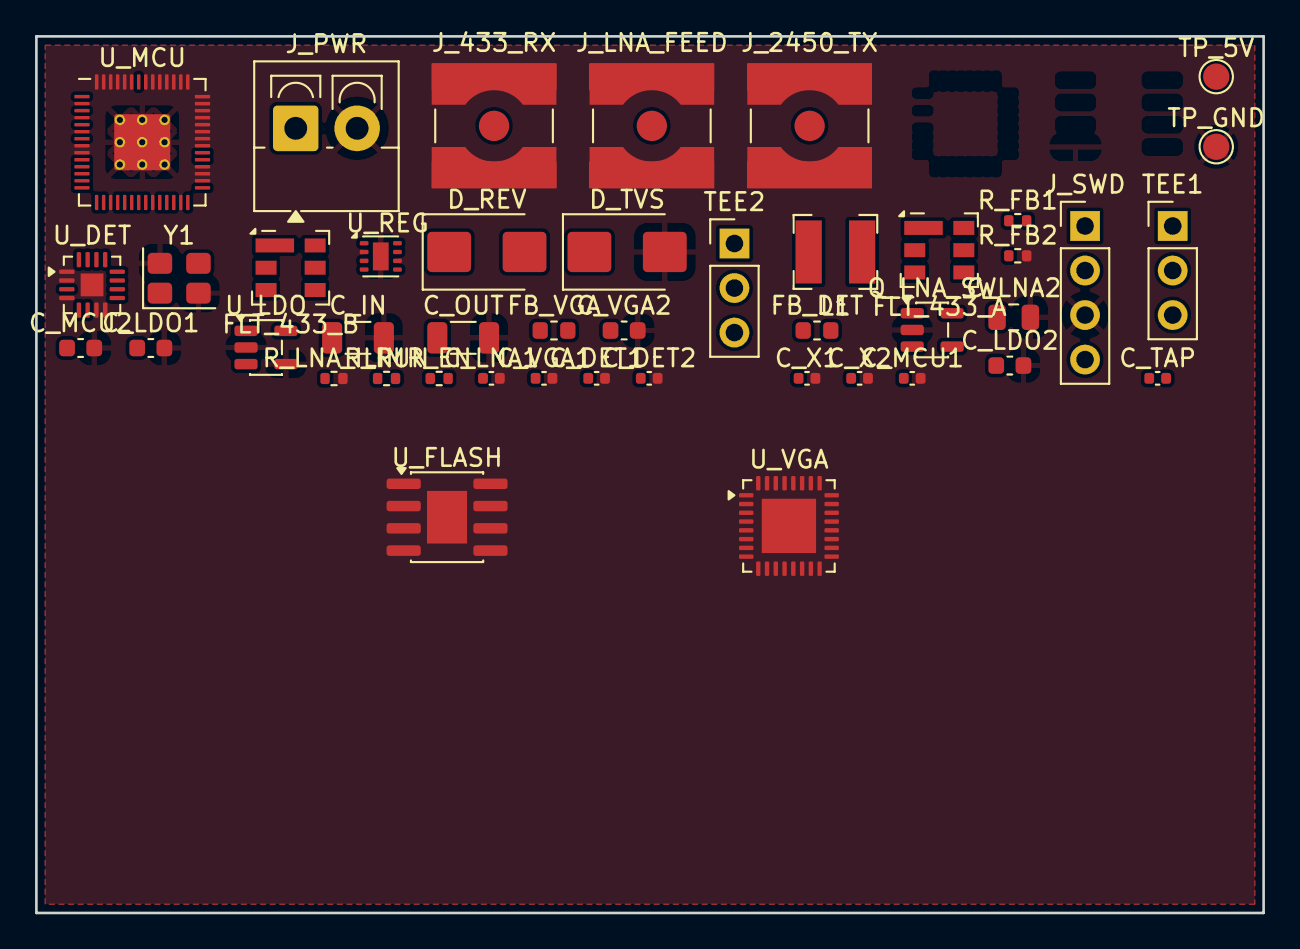
[picture p168: board base_station_v1_placed_v2.kicad_pcb from above]

Board: 4 copper layers, 70.0 x 50.0 mm, 44 parts (0 on the bottom side), 35 nets, no tracks yet.

Parts:
C_DET1: 100nF; C_0402_1005Metric
C_DET2: 100nF (VOUT filter); C_0402_1005Metric
C_IN: 10uF 25V; C_1206_3216Metric
C_LDO1, C_LDO2: 1uF; C_0603_1608Metric
C_LNA1: 100nF (tee DC injection bypass); C_0402_1005Metric
C_LNA2: 10uF (tee DC injection bypass); C_0805_2012Metric
C_MCU1: 100nF; C_0402_1005Metric
C_MCU2: 1uF; C_0603_1608Metric
C_OUT: 22uF 6V3; C_1206_3216Metric
C_TAP: directional/coupled tap after the BPF/LNA (TODO(u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; C_0402_1005Metric
C_VGA1: 100nF; C_0402_1005Metric
C_VGA2: 1uF; C_0603_1608Metric
C_X1, C_X2: 15pF; C_0402_1005Metric
D_REV: reverse-polarity/TVS protection; D_SMB
D_TVS: TVS clamp (set point TODO(unverified)); D_SMB
FB_DET: ferrite bead; L_0603_1608Metric
FB_VGA: ferrite bead / pi filter; L_0603_1608Metric
FLT_433_A: 433 MHz BPF (ahead of LNA); Filter_SAW-6_3.8x3.8mm
FLT_433_B: 433 MHz BPF #2 (before the AD8318 -- mandatory); Filter_SAW-6_3.8x3.8mm
J_433_RX: 433 MHz RX antenna port (SMA); SMA_Amphenol_132134-10_Vertical
J_2450_TX: 2.45 GHz TX antenna port (SMA; no PA on the PCBA); SMA_Amphenol_132134-10_Vertical
J_LNA_FEED: coax feed to the masthead LNA (SMA); SMA_Amphenol_132134-10_Vertical
J_PWR: VIN_GS 9-18V input; TerminalBlock_4Ucon_1x02_P3.50mm_Vertical
J_SWD: SWD debug header 1x4; PinHeader_1x04_P2.54mm_Vertical
L1: 2.2uH buck inductor; L_Bourns-SRN4018
Q_LNA_SW: load switch / resettable limiter (ADL5240 must NO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; SOT-23-5
R_EN: 100k LDO/REG enable pull-up; R_0402_1005Metric
R_FB1: 100k (feedback divider); R_0402_1005Metric
R_FB2: 22.6k (feedback divider); R_0402_1005Metric
R_LNA_ILIM: set LNA branch current limit; R_0402_1005Metric
R_RUN: 10k RUN pull-up; R_0402_1005Metric
TEE1: Mini-Circuits ZFBT-4R2GW+ bias tee (masthead feed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; PinHeader_1x03_P2.54mm_Vertical
TEE2: ZFBT-4R2GW+ bias tee (board side); PinHeader_1x03_P2.54mm_Vertical
TP_5V: +5V_PCBA test point; TestPoint_Pad_D1.5mm
TP_GND: GND test point; TestPoint_Pad_D1.5mm
U_DET: AD8318ACPZ-R7 log detector (15mA allowance); LFCSP-16-1EP_3x3mm_P0.5mm_EP1.3x1.3mm
U_FLASH: QSPI flash (RP2040 boot); SOIC-8-1EP_3.9x4.9mm_P1.27mm_EP2.29x3mm
U_LDO: 3.3V LDO for +3V3_MCU; SOT-23-5
U_MCU: RP2040 QFN-56; RP2040-QFN-56
U_REG: TPS62162 5V buck (3-17V in, 1A out); WSON-8-1EP_2x2mm_P0.5mm_EP0.9x1.6mm
U_VGA: ADL5240 VGA (93mA @ 4.75-5.25V, gain from RP2040); LFCSP-32-1EP_5x5mm_P0.5mm_EP3.1x3.1mm
Y1: 12MHz crystal; Crystal_SMD_3225-4Pin_3.2x2.5mm

Connections:
+3V3_MCU: C_LDO1.1, J_SWD.1, R_RUN.1, U_FLASH.8, U_LDO.5, U_MCU.16
+5V_DET: C_DET1.1, FB_DET.2, U_DET.5
+5V_LNA_SW: C_LNA1.1, C_LNA2.1, Q_LNA_SW.5, TEE1.3, TEE2.3
+5V_PCBA: C_LDO2.1, C_OUT.1, FB_DET.1, FB_VGA.1, L1.2, Q_LNA_SW.1, R_EN.1, R_FB1.1, TP_5V.1, U_LDO.1, U_REG.5
+5V_VGA: C_VGA1.1, C_VGA2.1, FB_VGA.2, U_VGA.1
DET_RF_IN: FLT_433_B.2, U_DET.3
DET_VOUT: C_DET2.1, U_DET.6, U_MCU.7
GND: C_DET1.2, C_DET2.2, C_IN.2, C_LDO1.2, C_LDO2.2, C_LNA1.2, C_LNA2.2, C_MCU1.2, C_MCU2.2, C_OUT.2, C_VGA1.2, C_VGA2.2, C_X1.2, C_X2.2, D_TVS.2, J_433_RX.2, J_2450_TX.2, J_LNA_FEED.2, J_PWR.2, J_SWD.3, Q_LNA_SW.2, R_FB2.2, R_LNA_ILIM.2, TP_GND.1, U_DET.1, U_DET.2, U_DET.4, U_DET.7, U_DET.8, U_DET.17, U_FLASH.4, U_FLASH.9, U_LDO.2, U_LDO.4, U_MCU.2, U_MCU.4, U_MCU.6, U_MCU.8, U_MCU.9, U_MCU.17, U_MCU.23, U_MCU.27, U_MCU.30, U_MCU.31, U_MCU.32, U_MCU.35, U_MCU.36, U_MCU.37, U_MCU.38, U_MCU.39, U_MCU.40, U_MCU.41, U_MCU.42, U_MCU.43, U_MCU.44, U_MCU.45, U_MCU.46, U_MCU.47, U_MCU.48, U_MCU.49, U_MCU.51, U_MCU.52, U_MCU.53, U_MCU.54, U_MCU.55, U_MCU.56, U_MCU.57, U_REG.2, U_REG.6, U_REG.9, U_VGA.2, U_VGA.4, U_VGA.33, Y1.2, Y1.4
IOVDD: C_MCU1.1, C_MCU2.1, U_MCU.1, U_MCU.5
LNA_EN: Q_LNA_SW.3, U_MCU.21
LNA_FLT: Q_LNA_SW.4, R_LNA_ILIM.1, U_MCU.22
QSPI_SCLK: U_FLASH.6, U_MCU.11
QSPI_SD0: U_FLASH.2, U_MCU.12
QSPI_SD1: U_FLASH.5, U_MCU.13
QSPI_SD2: U_FLASH.3, U_MCU.14
QSPI_SD3: U_FLASH.7, U_MCU.15
QSPI_SS: U_FLASH.1, U_MCU.10
REG_EN: R_EN.2, U_REG.7
REG_FB: R_FB1.2, R_FB2.1, U_REG.4
REG_PG: U_MCU.50, U_REG.8
REG_SW: L1.1, U_REG.3
RF_433_ANT: FLT_433_A.1, J_433_RX.1
RF_433_BPF1: FLT_433_A.2, TEE1.1
RF_TAP: C_TAP.2, FLT_433_B.1
RUN: R_RUN.2, U_MCU.26
SWCLK: J_SWD.4, U_MCU.28
SWDIO: J_SWD.2, U_MCU.29
VGA_GAIN0: U_MCU.18, U_VGA.6
VGA_GAIN1: U_MCU.19, U_VGA.7
VGA_GAIN2: U_MCU.20, U_VGA.8
VGA_RF_IN: C_TAP.1, TEE2.2, U_VGA.3
VIN_GS: D_REV.2, J_PWR.1
VIN_GS_PROT: C_IN.1, D_REV.1, D_TVS.1, U_REG.1
XIN: C_X1.1, U_MCU.24, Y1.1
XOUT: C_X2.1, U_MCU.25, Y1.3
