c03rad0r/balloon-fresh-1/tracker/hardware/routed/hub_v1_routed_zeroburn.kicad_pcb

## KiCad design tracker/hardware/routed/hub_v1_routed_zeroburn.kicad_pcb (2026-10-14)

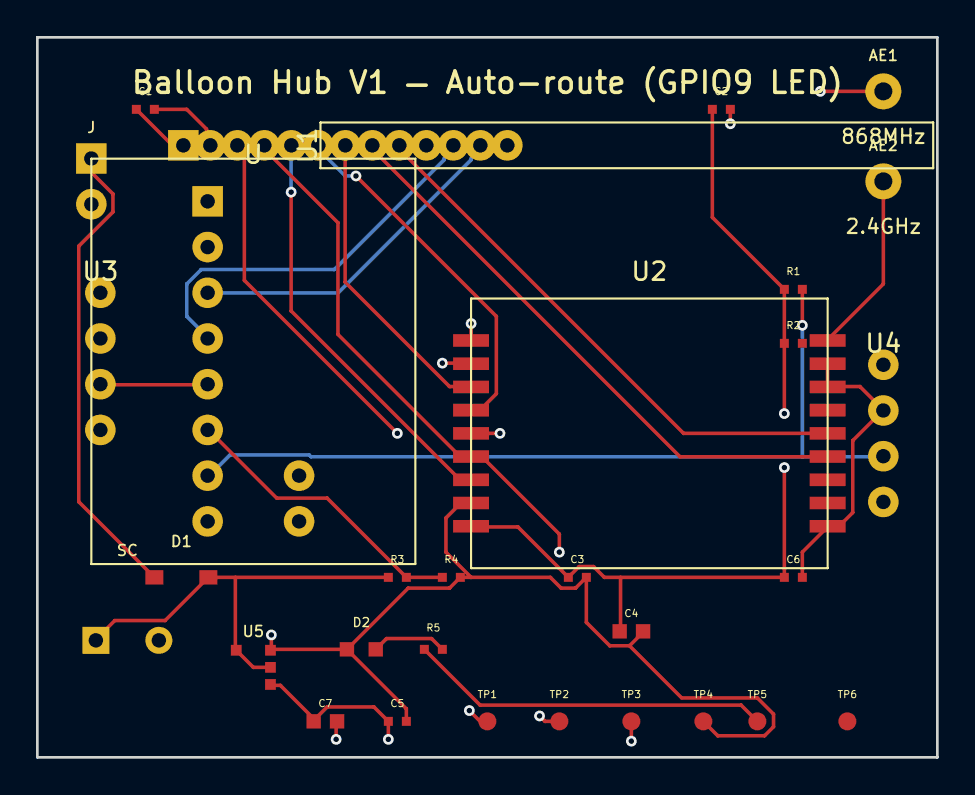
[picture p169: board hub_v1_routed_zeroburn.kicad_pcb from above]

Board: 4 copper layers, 50.0 x 40.0 mm, 30 parts (0 on the bottom side), 20 nets.

Parts:
AE1: 868MHz; TestPoint_THTPad_D2.0mm_Drill1.0mm
AE2: 2.4GHz; TestPoint_THTPad_D2.0mm_Drill1.0mm
C1, C2, C3, C5, C6: 100nF; C_0402_1005Metric
C4, C7: 10uF; C_0805_2012Metric
D1: BAT54; D_SOD-123
D2: STATUS; LED_0603_1608Metric
J: SOLAR; PinHeader_1x02_P2.54mm_Vertical
R1, R2: 4.7k; R_0402_1005Metric
R3, R4: 1M; R_0402_1005Metric
R5: 330R; R_0402_1005Metric
SC: 1F 5.5V; CP_Radial_D8.0mm_P3.50mm
TP1: SPI0_SCK; TestPoint_Pad_D1.0mm
TP2: SPI0_MOSI; TestPoint_Pad_D1.0mm
TP3: 3V3; TestPoint_Pad_D1.0mm
TP4: GND; TestPoint_Pad_D1.0mm
TP5: LED_GPIO18; TestPoint_Pad_D1.0mm
TP6: FEM_TX_GPIO19; TestPoint_Pad_D1.0mm
U: ESP32-C3-Mini-1; ESP32-C3_Mini_V1_Header
U1: RP2040-Zero; PinHeader_1x13_P2.54mm_Vertical
U2: LoRa2021; LoRa2021_Castellated
U3: MAX-M10S; PinHeader_1x04_P2.54mm_Vertical
U4: MS5611; PinHeader_1x04_P2.54mm_Vertical
U5: TPS7A02; SOT-23-5

Connections:
3V3: C1.1, C2.1, C3.1, C4.1, C5.1, C6.1, C7.1, R1.1, R2.1, TP3.1, U.1, U1.1, U2.1, U3.1, U4.1, U5.5
ESP_TX_RP2040_RX: U.3, U1.12
GND: C1.2, C2.2, C3.2, C4.2, C5.2, C6.2, C7.2, D2.1, J.2, R4.2, SC.2, TP4.1, U.2, U1.2, U1.13, U2.2, U2.8, U2.11, U2.12, U2.18, U3.2, U4.2, U5.2
GPS_TX_ESP_RX: U.5, U3.3
I2C_SDA: R1.2, U.7, U4.3
LED_ANODE: D2.2, R5.2
LR2021_BUSY: U1.7, U2.7
LR2021_DIO9: U1.8, U2.15
LR2021_RST: U1.9, U2.14
RF_2G4_2400: AE2.1, U2.10
RF_SUB_868: AE1.1, U2.9
RP2040_TX_ESP_RX: U.4, U1.11
SOLAR_IN: D1.1, J.1
SPI0_MISO: U1.5, U2.3
SPI0_MOSI: TP2.1, U1.4, U2.4
SPI0_NSS: U1.6, U2.6
SPI0_SCK: TP1.1, U1.3, U2.5
STATUS_LED: R5.1, TP5.1
VCAP: D1.2, R3.1, SC.1, U5.1, U5.3
VDIV_MID: R3.2, R4.1, U.6
