c03rad0r/balloon-fresh-1/tracker/hardware/output/v8j_krt_ms5611_unrouted.kicad_pcb

## KiCad design tracker/hardware/output/v8j_krt_ms5611_unrouted.kicad_pcb (2026-10-07)

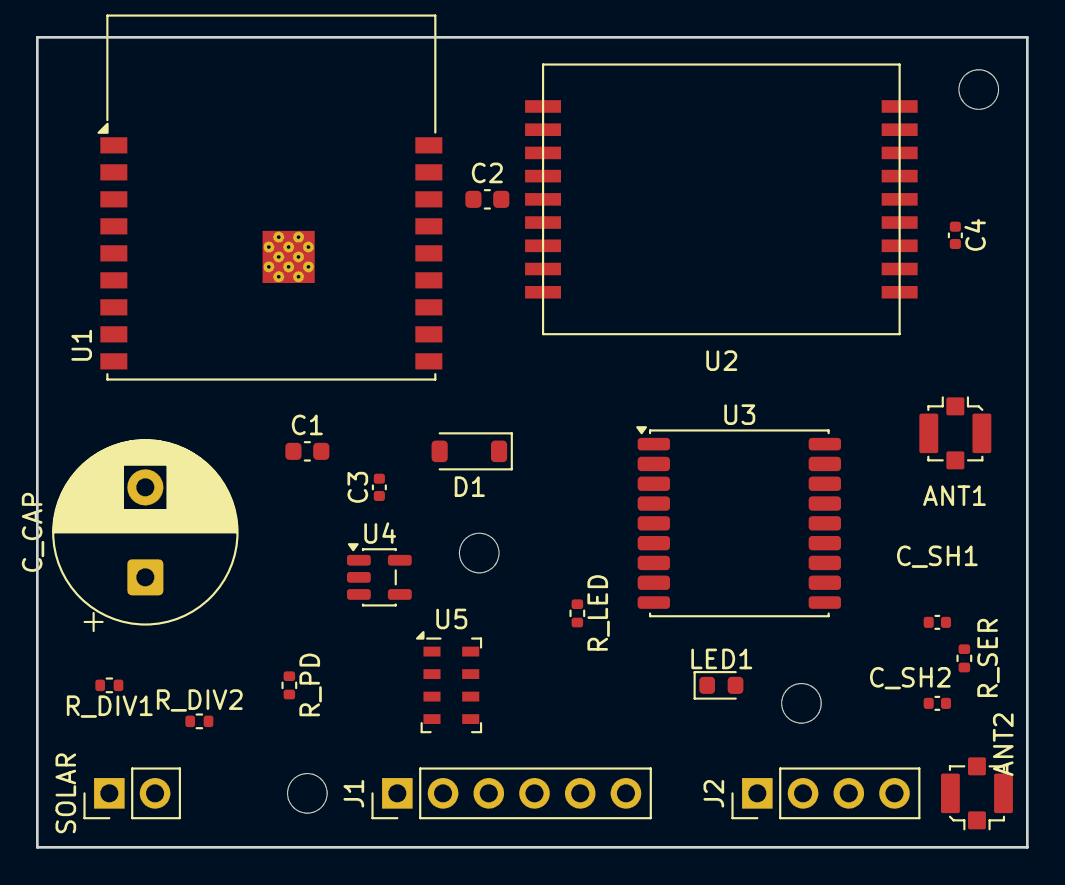
[picture p170: board v8j_krt_ms5611_unrouted.kicad_pcb from above]

Board: 4 copper layers, 55.0 x 45.0 mm, 28 parts (0 on the bottom side), 24 nets, no tracks yet.

Parts:
ANT1: U.FL; U.FL_Molex_MCRF_73412-0110_Vertical
ANT2: U.FL_GNSS; U.FL_Molex_MCRF_73412-0110_Vertical
C1, C2: 10uF; C_0603_1608Metric
C3, C4: 100nF; C_0402_1005Metric
C_CAP: 1F_5.5V; CP_Radial_D10.0mm_P5.00mm
C_SH1, C_SH2: DNP; C_0402_1005Metric
D1: BAT54; D_SOD-123
J1: Prog_Header; PinHeader_1x06_P2.54mm_Vertical
J2: Debug_Header; PinHeader_1x04_P2.54mm_Vertical
LED1: LED_RED; LED_0603_1608Metric
MNT1, MNT2, MNT3, MNT4: MountingHole; MountingHole_2.2mm_M2
R_DIV1, R_DIV2: 100k; R_0402_1005Metric
R_LED: 330R; R_0402_1005Metric
R_PD: 10k; R_0402_1005Metric
R_SER: 0R; R_0402_1005Metric
SOLAR: Solar_In; PinHeader_1x02_P2.54mm_Vertical
U1: ESP32-C3-WROOM-02
U2: LoRa2021_Gen4; LoRa2021_Castellated
U3: MAX-M10S; ublox_MAX
U4: TPS7A02; SOT-23-5
U5: MS5611-01BA; LGA-8_3x5mm_P1.25mm

Connections:
+3V3: C1.1, C2.1, C3.1, C4.1, J1.2, J2.2, R_PD.2, U1.1, U2.1, U3.6, U3.7, U3.8, U3.9, U4.5, U5.1, U5.5
EN: J1.3, U1.2
GND: ANT1.2, ANT2.2, C1.2, C2.2, C3.2, C4.2, C_CAP.2, C_SH1.1, C_SH2.1, J1.1, J2.1, LED1.2, R_DIV2.2, SOLAR.2, U1.9, U1.19, U2.2, U2.8, U2.11, U2.12, U2.18, U3.1, U3.10, U3.12, U4.2, U5.2, U5.3, U5.4, U5.6
GNSS_ANT: ANT2.1, C_SH2.2, R_SER.1
GNSS_RF: C_SH1.2, R_SER.2, U3.11
GPS_RX: U1.17, U3.2
GPS_TX: U1.18, U3.3
I2C_SCL: J2.4, U1.8, U5.8
I2C_SDA: J2.3, R_PD.1, U1.7, U5.7
LED_A: LED1.1, R_LED.2
LED_DRIVE: R_LED.1, U1.14
LR_BUSY: U1.3, U2.7
LR_IRQ: U1.13, U2.15
LR_RST: U1.15, U2.14
RF_OUT: ANT1.1, U2.9
SOLAR_IN: D1.1, SOLAR.1
SPI_MISO: U1.16, U2.3
SPI_MOSI: U1.6, U2.4
SPI_NSS: U1.10, U2.6
SPI_SCK: U1.5, U2.5
UART0_RX: J1.5, U1.11
UART0_TX: J1.4, U1.12
VCAP: C_CAP.1, D1.2, R_DIV1.1, U4.1, U4.3
VDIV_MID: R_DIV1.2, R_DIV2.1, U1.4
