c03rad0r/balloon-fresh-1/tracker/hardware/output/v1_fast_regen_routed.kicad_pcb

## KiCad design tracker/hardware/output/v1_fast_regen_routed.kicad_pcb (2026-10-05)

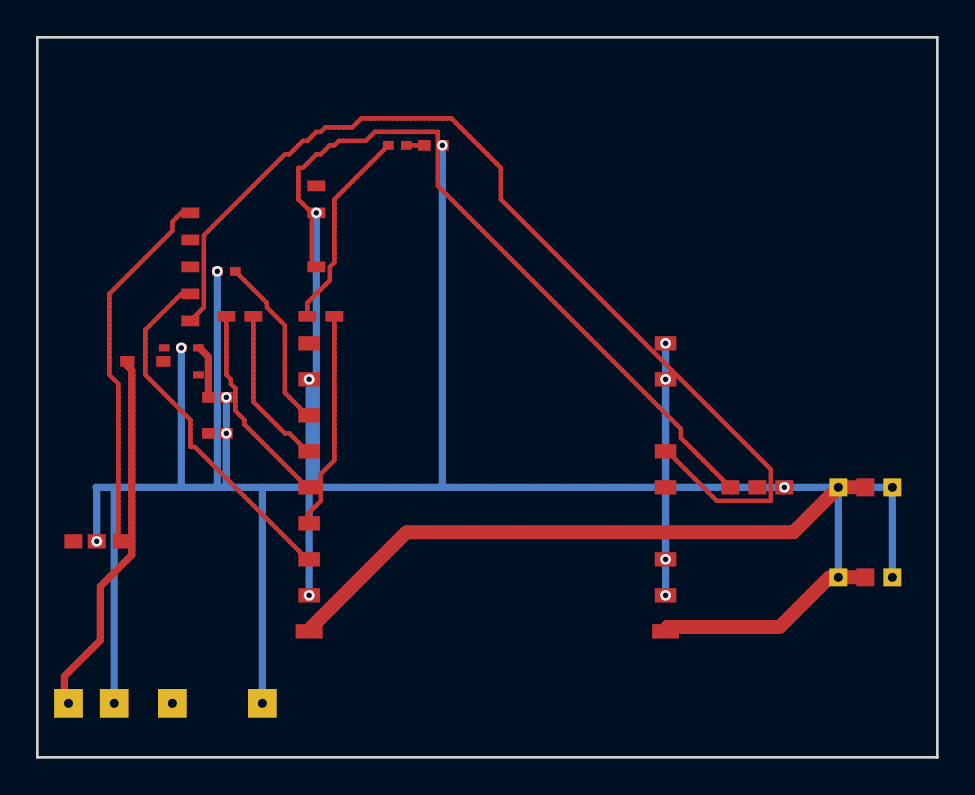
[picture p171: board v1_fast_regen_routed.kicad_pcb from above]

Board: 2 copper layers, 50.0 x 40.0 mm, 15 parts (0 on the bottom side), 17 nets.

Parts:
ANT1: U.FL-868
ANT2: U.FL-2400
C1, C2: 10uF
C_CAP: Supercap
D1: BAT54
FEM: FEM
LED1: LED-0603
R_LED: 330R
R_PD: 10k
SOLAR: Solar-Conn
U1: ESP32-C3
U2: LR2021F33
U3: MAX-M10S
U4: TPS7A02

Connections:
3V3: C2.1, FEM.VCC, U1.VCC, U2.1, U3.1, U4.4
FEM_TX: FEM.TX, U1.GPIO19
GND: ANT1.2, ANT1.3, ANT2.2, ANT2.3, C1.2, C2.2, C_CAP.2, FEM.GND, LED1.K, R_PD.1, SOLAR.2, U1.GND, U2.2, U2.8, U2.10, U2.11, U2.16, U2.17, U3.2, U4.2
GPS_RX: U1.GPIO1, U3.3
LED_ANODE: LED1.A, R_LED.2
LR2021_BUSY: U1.GPIO4, U2.7
LR2021_DIO9: U1.GPIO5, U2.13
LR2021_RST: U1.GPIO3, U2.14
RF_2G4_2400: ANT2.1, U2.18
RF_SUB_868: ANT1.1, U2.9
SOLAR_IN: D1.A, SOLAR.1
SPI_MISO: R_PD.2, U1.GPIO2, U2.3
SPI_MOSI: U1.GPIO7, U2.4
SPI_NSS: U1.GPIO10, U2.6
SPI_SCK: U1.GPIO6, U2.5
STATUS_LED: R_LED.1, U1.GPIO9
VCAP: C1.1, C_CAP.1, D1.K, U4.1, U4.3
