c03rad0r/balloon-fresh-1/tracker/hardware/auto_bootsel/auto-bootsel-interposer-placed.kicad_pcb

## KiCad design tracker/hardware/auto_bootsel/auto-bootsel-interposer-placed.kicad_pcb (2026-10-05)

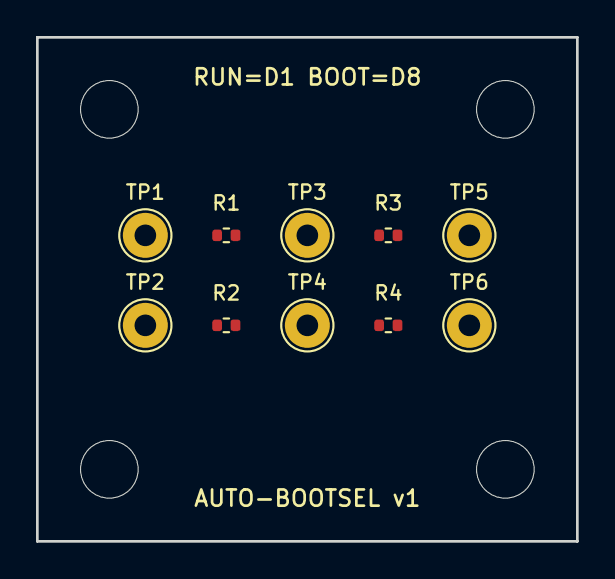
[picture p172: board auto-bootsel-interposer-placed.kicad_pcb from above]

Board: 2 copper layers, 30.0 x 28.0 mm, 14 parts (0 on the bottom side), 5 nets, no tracks yet.

Parts:
H1, H2, H3, H4: MountingHole_3.2mm_M3
R1, R2, R3, R4: 0R; R_0402_1005Metric
TP1: RUN_ESP; TestPoint_THTPad_D2.5mm_Drill1.2mm
TP2: BOOT_ESP; TestPoint_THTPad_D2.5mm_Drill1.2mm
TP3: RUN_RP; TestPoint_THTPad_D2.5mm_Drill1.2mm
TP4: BOOT_RP; TestPoint_THTPad_D2.5mm_Drill1.2mm
TP5, TP6: GND; TestPoint_THTPad_D2.5mm_Drill1.2mm

Connections:
BOOT_ESP: R2.1, TP2.1
BOOT_RP: R2.2, R4.1, TP4.1
GND: R3.2, R4.2, TP5.1, TP6.1
RUN_ESP: R1.1, TP1.1
RUN_RP: R1.2, R3.1, TP3.1
