c03rad0r/balloon-fresh-1/tracker/hardware/schematics/flight_board/build_flight_sch.py

#!/usr/bin/env python3
"""Derive a loading KiCad 9 schematic for the C3 flight board FROM the frozen PCB.

Direction of truth: the placed/routed PCB (`output/v8i_krt_gnss.kicad_pcb`)
plus the tested firmware are authoritative; this generated schematic is a MIRROR of
that netlist, never the other way round.  Nothing here invents connectivity: every
net, every pin and every declared no-connect is read out of the PCB file.

Outputs (all regenerated deterministically from the PCB sha256 in the header):
  v_c3_flight.kicad_sch   the schematic
  sym-lib-table           library table so ERC resolves the embedded lib_symbols
  balloon_flight.kicad_sym  custom symbols (LR2021F33) as a real library
  balloon_flight.pretty   the PCB's own footprints, exported verbatim
  fp-lib-table            footprint library table so Footprint fields resolve

Run:  python3 build_flight_sch.py
"""
import hashlib
import itertools
import os
import re
import sys
import uuid

HERE = os.path.dirname(os.path.abspath(__file__))
REPO = os.path.abspath(os.path.join(HERE, "..", "..", "..", ".."))

# The F33 land pattern is DERIVED from the vendor's own land file at generation
# time (scripts/gen_f33_landpattern.py), never copied from a hand-maintained
# custom.pretty file.  That script exits 2 if the vendor file will not decode or
# fails its own self-checks, so a stale/hand-edited F33 pattern cannot re-enter
# the v9 design of record unnoticed.
sys.path.insert(0, os.path.join(REPO, "scripts"))
import gen_f33_landpattern as F33GEN  # noqa: E402

PCB = os.path.join(REPO, "tracker", "hardware", "output",
                   "v8i_krt_gnss.kicad_pcb")
OUT_SCH = os.path.join(HERE, "v_c3_flight.kicad_sch")
OUT_LIBTABLE = os.path.join(HERE, "sym-lib-table")
OUT_FPLIB = os.path.join(HERE, "balloon_flight.pretty")
OUT_FPTABLE = os.path.join(HERE, "fp-lib-table")
OUT_CUSTOM_SYM = os.path.join(HERE, "balloon_flight.kicad_sym")
SYMDIR = "/usr/share/kicad/symbols"
FP_LIBNAME = "balloon_flight"

FROZEN_SHA256 = "638de56387721460100cd3048fb23229294f510f0a2d89795026c7e6c0cfd0ea"

POWER_NETS = ("+3V3", "GND")

def merge_lib_table(path, kind, entries):
    """Additively merge `(lib ...)` rows into a KiCad library table.

    The v_c3 / v9 / v10 targets all write into the SAME shared project-local
    table files (sym-lib-table, fp-lib-table).  Rewriting them outright from
    one target would leave the OTHER two sheets with dangling
    lib_symbol_issues / footprint_link_issues warnings, so merge instead:
    keep every row already present, append only the missing ones.  Idempotent.
    """
    lines = []
    have = set()
    if os.path.exists(path):
        with open(path, encoding="utf-8", errors="replace") as fh:
            lines = fh.read().splitlines()
        for ln in lines:
            m = re.match(r'\s*\(lib \(name "([^"]+)"\)', ln)
            if m:
                have.add(m.group(1))
    while lines and lines[-1].strip() == ")":
        lines.pop()
    if not lines:
        lines = ["(%s" % kind, "\t(version 7)"]
    added = []
    for (name, uri, descr) in entries:
        if name in have:
            continue
        lines.append('\t(lib (name "%s")(type "KiCad")(uri "%s")(options "")'
                     '(descr "%s"))' % (name, uri, descr))
        added.append(name)
    lines.append(")")
    with open(path, "w", encoding="utf-8") as fh:
        fh.write("\n".join(lines) + "\n")
    return added



# footprint lib-id -> schematic symbol lib-id.  Identity where the KiCad v9
# libraries carry a symbol for the same part.
PART_MAP = {
    "Resistor_SMD:R_0402_1005Metric": "Device:R",
    "Capacitor_SMD:C_0402_1005Metric": "Device:C",
    "Capacitor_SMD:C_0603_1608Metric": "Device:C",
    "Capacitor_THT:CP_Radial_D10.0mm_P5.00mm": "Device:C_Polarized",
    "Diode_SMD:D_SOD-123": "Device:D_Schottky",
    "LED_SMD:LED_0603_1608Metric": "Device:LED",
    "Connector_PinHeader_2.54mm:PinHeader_1x02_P2.54mm_Vertical":
        "Connector_Generic:Conn_01x02",
    "Connector_PinHeader_2.54mm:PinHeader_1x04_P2.54mm_Vertical":
        "Connector_Generic:Conn_01x04",
    "Connector_PinHeader_2.54mm:PinHeader_1x06_P2.54mm_Vertical":
        "Connector_Generic:Conn_01x06",
    "Connector_Coaxial:U.FL_Molex_MCRF_73412-0110_Vertical":
        "Connector:Conn_Coaxial",
    "RF_Module:ESP32-C3-WROOM-02": "RF_Module:ESP32-C3-WROOM-02",
    "RF_Module:HOPERF_RFM9XW_SMD": "balloon_flight:LR2021F33",
    "custom:LoRa2021_Castellated": "balloon_flight:LR2021F33",
    "MountingHole:MountingHole_2.2mm_M2": "Mechanical:MountingHole",
    "RF_GPS:ublox_MAX": "RF_GPS:MAX-M10S",
    "Package_TO_SOT_SMD:SOT-23-5": "Regulator_Linear:TPS7A0533PDBV",
    "Package_LGA:Bosch_LGA-8_2.5x2.5mm_P0.65mm_ClockwisePinNumbering":
        "Sensor:BME280",
    "Package_LGA:LGA-8_3x5mm_P1.25mm":
        "Sensor:BME280",
}

# Barometer: design intent is MS5611-01BA (10-1200 hPa) for the stratospheric flight
# profile. The frozen S0 placement PCB still labels this footprint as BMP280 because
# it predates the operator decision to switch; the generated schematic/netlist must
# reflect the intended part.  The BME280 *symbol* (Sensor:BME280) is used because it
# shares the BMP280 clockwise LGA-8 pad numbering that the board is wired for; only
# the Value and Footprint fields are overridden to MS5611-01BA / LGA-8_3x5mm_P1.25mm.
BARO_REF = "U5"
BARO_VALUE = "MS5611-01BA"
BARO_FOOTPRINT = "Package_LGA:LGA-8_3x5mm_P1.25mm"
# Custom inline symbol: the LR2021 Gen4 LoRa module as the board actually wires it.
# The board uses the 18-pin castellated LoRa2021_Castellated footprint; pad names
# below are derived from the v8i board netlist, with un-routed pads left neutral.
LR2021_PINS = [
    ("1", "VCC"), ("2", "GND"), ("3", "MISO"), ("4", "MOSI"),
    ("5", "SCK"), ("6", "NSS"), ("7", "BUSY"), ("8", "GND"),
    ("9", "ANT"), ("10", "PAD10"), ("11", "GND"), ("12", "GND"),
    ("13", "PAD13"), ("14", "RESET"), ("15", "DIO0"), ("16", "PAD16"),
    ("17", "PAD17"), ("18", "GND"),
]

# Pads declared deliberately unconnected (INTENTIONAL rows of the audit).
INTENTIONAL_NC = {
    ("J1", "6"), ("U3", "4"), ("U3", "5"), ("U3", "13"),
    ("U3", "14"), ("U3", "16"), ("U3", "17"),
}
# Pads in the audit whose GAP verdict is still open (PCB-S0b owns the ruling).
DECLARED_GAP = {
    ("U2", "10"): "TODO(unverified): LoRa2021 Gen4 pad 10 function / termination",
    ("U2", "13"): "TODO(unverified): LoRa2021 Gen4 pad 13 function / termination",
    ("U2", "16"): "TODO(unverified): LoRa2021 Gen4 pad 16 function / termination",
    ("U2", "17"): "TODO(unverified): LoRa2021 Gen4 pad 17 function / termination",
    ("U3", "15"): "TODO(unverified): MAX-M10S VIO_SEL tie-off required",
    ("U3", "18"): "TODO(unverified): MAX-M10S ~SAFEBOOT inactive level tie-off required",
    ("U4", "4"): "TODO(unverified): TPS7A02 pin 4 function / tie-off",
}

# Functional column layout: (column index, ordered refs)
COLUMNS = [
    ["SOLAR", "D1", "C_CAP", "U4", "C1", "C3", "R_DIV1", "R_DIV2"],
    ["U1", "C2", "C4", "R_PD", "R_LED", "LED1"],
    ["U2", "ANT1"],
    ["U3", "ANT2", "R_SER", "C_SH1", "C_SH2"],
    ["U5", "J1", "J2"],
    ["MNT1", "MNT2", "MNT3", "MNT4"],
]
COLUMN_TITLES = [
    "SOLAR INPUT / SUPERCAP / 3V3 LDO",
    "ESP32-C3-WROOM-02 + SUPPORT",
    "LR2021F33 RADIO (18-pin castellated)",
    "MAX-M10S GNSS + ANT2 FEED",
    "MS5611 + PROGRAMMING / DEBUG HEADERS",
    "MOUNTING HOLES",
]


# ---------------------------------------------------------------- helpers
# DETERMINISTIC uuids.  The .kicad_sch is a build product: regenerating it from
# the same PCB must be byte-identical, otherwise the recorded sha256 is not
# provenance and every re-run churns the diff.  uuid5 over a fixed namespace
# plus a per-run sequence is stable because the generator walks the board file
# in file order (no sets, no dicts built from unordered input).
UID_NAMESPACE = uuid.UUID("b4a1c0de-0000-5000-a000-f1a5b0a1d0e0")
_uid_seq = itertools.count(1)


def uid():
    return str(uuid.uuid5(UID_NAMESPACE, "flight-sch-%06d" % next(_uid_seq)))


def fmt(v):
    s = "%.4f" % round(float(v) + 0.0, 4)
    s = s.rstrip("0").rstrip(".")
    return s if s and s != "-0" else "0"


def clean(text):
    """Kill float repr noise before it reaches KiCad's parser."""
    return re.sub(r"-?\d+\.\d{5,}", lambda m: fmt(float(m.group(0))), text)


def blocks_by_prefix(text, prefix):
    """Every balanced block in `text` whose first chars are `prefix`."""
    i = 0
    while True:
        i = text.find(prefix, i)
        if i < 0:
            return
        d = 0
        j = i
        while j < len(text):
            if text[j] == "(":
                d += 1
            elif text[j] == ")":
                d -= 1
                if d == 0:
                    yield text[i:j + 1]
                    break
            j += 1
        i = j + 1


def parse_pcb(path):
    text = open(path).read()
    footprints = []
    for blk in blocks_by_prefix(text, "\t(footprint "):
        fpid = re.search(r'\(footprint "([^"]+)"', blk).group(1)
        if ":" not in fpid:
            fpid = ":" + fpid
        ref = re.search(r'\(property "Reference" "([^"]*)"', blk).group(1)
        value = re.search(r'\(property "Value" "([^"]*)"', blk).group(1)
        at = re.search(r'\n\t\t\(at ([-\d.]+) ([-\d.]+)', blk)
        pads = []
        for pb in blocks_by_prefix(blk, "\t\t(pad "):
            num = re.search(r'\(pad "([^"]*)"', pb).group(1)
            nm = re.search(r'\(net \d+ "([^"]*)"\)', pb)
            npth = "np_thru_hole" in pb
            pads.append(dict(num=num, net=(nm.group(1) if nm else ""),
                             npth=npth))
        footprints.append(dict(ref=ref, value=value, fpid=fpid,
                               leaf=fpid.split(":", 1)[-1], raw=blk,
                               at=(float(at.group(1)), float(at.group(2))),
                               pads=pads))
    return footprints


def raw_symbol(lib, name):
    path = os.path.join(SYMDIR, lib + ".kicad_sym")
    text = open(path, errors="replace").read()
    head = '(symbol "%s"\n' % name
    i = text.find(head)
    if i < 0:
        raise KeyError("symbol %s:%s not in KiCad v9 libraries" % (lib, name))
    d = 0
    j = i
    while j < len(text):
        if text[j] == "(":
            d += 1
        elif text[j] == ")":
            d -= 1
            if d == 0:
                break
        j += 1
    return text[i:j + 1]


def load_lib_symbol(lib, name):
    """Raw block, with `(extends PARENT)` flattened and renamed to LIB:NAME.

    Many KiCad v9 parts (e.g. TPS7A0533PDBV) are *derived* symbols that carry no
    pins of their own - the pin table lives in the parent.  A schematic's
    lib_symbols cache cannot express `extends`, so the parent's drawing/pin
    sub-symbols are inlined here.
    """
    block = raw_symbol(lib, name)
    m = re.search(r'\n[ \t]*\(extends "([^"]+)"\)', block)
    if m:
        parent = m.group(1)
        praw = raw_symbol(lib, parent)
        kids = list(blocks_by_prefix(praw, '\t\t(symbol "'))
        if not kids:
            raise KeyError("%s extends %s but the parent has no unit symbols"
                           % (name, parent))
        inj = "\n".join(k.replace('(symbol "%s_' % parent,
                                 '(symbol "%s_' % name, 1) for k in kids)
        block = block.replace(m.group(0), "\n" + inj)
    head = '(symbol "%s"' % name
    if not block.startswith(head):
        raise KeyError("unexpected symbol head for %s:%s" % (lib, name))
    return '(symbol "%s:%s"' % (lib, name) + block[len(head):]


PIN_RE = re.compile(
    r'\(pin\s+(\S+)\s+\S+\s+\(at\s+([-\d.]+)\s+([-\d.]+)\s+([-\d.]+)\)'
    r'\s*\(length\s+([-\d.]+)\)[\s\S]*?\(number\s+"([^"]+)"')


def symbol_pins(block):
    """{'1': {'x':0.0,'y':3.81,'a':270.0,'len':1.27,'type':'passive'}}"""
    out = {}
    for m in PIN_RE.finditer(block):
        out[m.group(6)] = dict(type=m.group(1), x=float(m.group(2)),
                               y=float(m.group(3)), a=float(m.group(4)),
                               length=float(m.group(5)))
    return out


def symbol_extent(block):
    """Rough lib-coord bbox from pins + rectangles, as (x0,y0,x1,y1)."""
    xs, ys = [], []
    for m in re.finditer(r'\(rectangle\s*\(start\s+([-\d.]+)\s+([-\d.]+)\)'
                         r'\s*\(end\s+([-\d.]+)\s+([-\d.]+)\)', block):
        xs += [float(m.group(1)), float(m.group(3))]
        ys += [float(m.group(2)), float(m.group(4))]
    for p in symbol_pins(block).values():
        xs.append(p["x"])
        ys.append(p["y"])
    if not xs:
        return (-5.0, -5.0, 5.0, 5.0)
    return (min(xs), min(ys), max(xs), max(ys))


DIR = {0.0: (1, 0), 90.0: (0, 1), 180.0: (-1, 0), 270.0: (0, -1)}


def pin_point(sym_x, sym_y, pin):
    """Absolute schematic coordinate of a pin's connection end (rot = 0)."""
    return (sym_x + pin["x"], sym_y - pin["y"])


def stub_end(sym_x, sym_y, pin, length):
    """Wire out of the pin, away from the symbol body, on the 1.27 grid."""
    ox, oy = DIR[pin["a"] % 360.0]
    px, py = pin_point(sym_x, sym_y, pin)
    return (px - ox * length, py + oy * length)


# ---------------------------------------------------------------- LR2021 custom symbol
def lr2021_symbol():
    body = []
    body.append('(symbol "balloon_flight:LR2021F33"')
    body.append("\t\t(pin_names\n\t\t\t(offset 1.016)\n\t\t\t(hide no)\n\t\t)")
    body.append("\t\t(exclude_from_sim no)\n\t\t(in_bom yes)\n\t\t(on_board yes)")
    body.append('\t\t(property "Reference" "U"\n\t\t\t(at 0 16.51 0)\n'
                "\t\t\t(effects\n\t\t\t\t(font\n\t\t\t\t\t(size 1.27 1.27)\n"
                "\t\t\t\t)\n\t\t\t)\n\t\t)")
    body.append('\t\t(property "Value" "LR2021F33"\n\t\t\t(at 0 -16.51 0)\n'
                "\t\t\t(effects\n\t\t\t\t(font\n\t\t\t\t\t(size 1.27 1.27)\n"
                "\t\t\t\t)\n\t\t\t)\n\t\t)")
    body.append('\t\t(property "Footprint" "RF_Module:HOPERF_RFM9XW_SMD"\n'
                "\t\t\t(at 0 0 0)\n\t\t\t(effects\n\t\t\t\t(font\n"
                "\t\t\t\t\t(size 1.27 1.27)\n\t\t\t\t)\n\t\t\t\t(hide yes)\n"
                "\t\t\t)\n\t\t)")
    ds = ("https://www.nicerf.com/pdf/lora2021f33-2g4-2w-high-power-high-speed-"
          "multi-band-lr2021-wireless-communication-module-v1.1.pdf")
    body.append('\t\t(property "Datasheet" "%s"\n\t\t\t(at 0 0 0)\n'
                "\t\t\t(effects\n\t\t\t\t(font\n\t\t\t\t\t(size 1.27 1.27)\n"
                "\t\t\t\t)\n\t\t\t\t(hide yes)\n\t\t\t)\n\t\t)" % ds)
    body.append('\t\t(property "Description" "NiceRF LoRa2021F33-2G4 LR2021 '
                'module, 16-pad RFM9xW-style footprint"\n\t\t\t(at 0 0 0)\n'
                "\t\t\t(effects\n\t\t\t\t(font\n\t\t\t\t\t(size 1.27 1.27)\n"
                "\t\t\t\t)\n\t\t\t\t(hide yes)\n\t\t\t)\n\t\t)")
    body.append('\t\t(symbol "LR2021F33_0_1"\n\t\t\t(rectangle\n'
                "\t\t\t\t(start -11.43 12.7)\n\t\t\t\t(end 11.43 -12.7)\n"
                "\t\t\t\t(stroke\n\t\t\t\t\t(width 0.254)\n"
                "\t\t\t\t\t(type default)\n\t\t\t\t)\n"
                "\t\t\t\t(fill\n\t\t\t\t\t(type background)\n\t\t\t\t)\n"
                "\t\t\t)\n\t\t)")
    pins = []
    for idx, (num, name) in enumerate(LR2021_PINS):
        if idx < 8:
            x, y, ang = -13.97, 8.89 - idx * 2.54, 0
        else:
            x, y, ang = 13.97, -8.89 + (idx - 8) * 2.54, 180
        pins.append(
            "\t\t\t(pin passive line\n\t\t\t\t(at %s %s %s)\n"
            "\t\t\t\t(length 2.54)\n\t\t\t\t(name \"%s\"\n\t\t\t\t\t(effects\n"
            "\t\t\t\t\t\t(font\n\t\t\t\t\t\t\t(size 1.27 1.27)\n"
            "\t\t\t\t\t\t)\n\t\t\t\t\t)\n\t\t\t\t)\n"
            "\t\t\t\t(number \"%s\"\n\t\t\t\t\t(effects\n\t\t\t\t\t\t(font\n"
            "\t\t\t\t\t\t\t(size 1.27 1.27)\n\t\t\t\t\t\t)\n\t\t\t\t\t)\n"
            "\t\t\t\t)\n\t\t\t)"
            % (fmt(x), fmt(y), fmt(ang), name, num))
    body.append('\t\t(symbol "LR2021F33_1_1"\n' + "\n".join(pins) + "\n\t\t)")
    body.append("\t)")
    return "\n".join(body)


# ---------------------------------------------------------------- PCB parsing
def resolve_symbol(fpid):
    if fpid in PART_MAP:
        return PART_MAP[fpid]
    leaf = fpid.split(":")[-1]
    for k, v in PART_MAP.items():
        if k.split(":")[-1] == leaf:
            return v
    raise KeyError("no symbol mapping for footprint %s (add to PART_MAP)" % fpid)


# ---------------------------------------------------------------- emit
def emit(footprints):
    lib_ids_used = []
    lib_blocks = {"balloon_flight:LR2021F33": lr2021_symbol()}
    resolved = []
    for fp in footprints:
        lib_id = resolve_symbol(fp["fpid"])
        if lib_id in lib_blocks:
            block = lib_blocks[lib_id]
        else:
            lib, name = lib_id.split(":")
            block = load_lib_symbol(lib, name)
            lib_blocks[lib_id] = block
        resolved.append(dict(fp=fp, lib_id=lib_id, block=block))
        if lib_id not in lib_ids_used:
            lib_ids_used.append(lib_id)

    # ---- validation: every numbered pad must have a pin in the symbol
    problems = []
    for r in resolved:
        pins = symbol_pins(r["block"])
        padnums = sorted({p["num"] for p in r["fp"]["pads"] if p["num"] != ""})
        missing = [n for n in padnums if n not in pins]
        if missing:
            problems.append("%s (%s -> %s): pads %s have no symbol pin"
                            % (r["fp"]["ref"], r["fp"]["fpid"], r["lib_id"], missing))
    if problems:
        print("PIN COVERAGE FAILURES:")
        for p in problems:
            print("  -", p)
        sys.exit(2)

    # ---- footprint library: the PCB's own footprints, exported verbatim, so the
    # schematic Footprint fields resolve (ERC footprint_link_issues = 0)
    os.makedirs(OUT_FPLIB, exist_ok=True)
    written = set()
    for r in resolved:
        leaf = r["fp"]["leaf"]
        if leaf in written:
            continue
        written.add(leaf)
        blk = re.sub(r'\(footprint\s+"[^"]*"',
                     '(footprint "%s"\n\t\t(version 20241229)\n'
                     '\t\t(generator "pcbnew")\n\t\t(generator_version "9.0")'
                     % leaf, r["fp"]["raw"], count=1)
        with open(os.path.join(OUT_FPLIB, leaf + ".kicad_mod"), "w") as fh:
            fh.write(clean(blk) + "\n")
    with open(OUT_FPTABLE, "w") as fh:
        fh.write('(fp_lib_table\n\t(version 7)\n\t(lib (name "%s")'
                 '(type "KiCad")(uri "${KIPRJMOD}/%s.pretty")(options "")'
                 '(descr "Flight board footprints exported from the frozen PCB"))'
                 '\n\t(lib (name "%s")(type "KiCad")'
                 '(uri "${KIPRJMOD}/v9_lib/%s.pretty")(options "")'
                 '(descr "v9 flight board footprints (F33 fixed pattern + bare '
                 'LoRa2021 + SX1280 UNVERIFIED)"))\n)\n'
                 % (FP_LIBNAME, FP_LIBNAME, V9_LIBNAME, V9_LIBNAME))

    # ---- layout
    by_ref = {r["fp"]["ref"]: r for r in resolved}
    unknown = [c for col in COLUMNS for c in col if c not in by_ref]
    if unknown:
        sys.exit("layout lists unknown refs: %s" % unknown)
    placed_refs = {c for col in COLUMNS for c in col}
    extra = [r["fp"]["ref"] for r in resolved if r["fp"]["ref"] not in placed_refs]
    if extra:
        sys.exit("PCB footprints missing from COLUMNS layout: %s" % extra)

    sizes = {}
    for ref, r in by_ref.items():
        x0, y0, x1, y1 = symbol_extent(r["block"])
        sizes[ref] = (x1 - x0, y1 - y0)

    col_x, x = [], 25.4
    for col in COLUMNS:
        w = max(sizes[ref][0] for ref in col)
        col_x.append(x)
        x += w + 22.86

    pos = {}
    for ci, col in enumerate(COLUMNS):
        y = 45.72
        for ref in col:
            _, h = sizes[ref]
            pos[ref] = (round(col_x[ci] / 1.27) * 1.27, round(y / 1.27) * 1.27)
            y += h + 20.32

    # ---- body
    body, notes = [], []
    body.append('\t(text "BALLOON C3 FLIGHT BOARD - netlist mirror of '
                'v8i_krt_gnss.kicad_pcb"\n\t\t(exclude_from_sim no)\n'
                '\t\t(at 25.4 25.4 0)\n\t\t(effects\n\t\t\t(font\n\t\t\t\t'
                '(size 2.54 2.54)\n\t\t\t)\n\t\t\t(justify left bottom)\n'
                '\t\t)\n\t\t(uuid "%s")\n\t)' % uid())
    body.append('\t(text "PCB sha256 %s - schematic is DERIVED, the PCB is the '
                'source of truth (ADR-028)"\n\t\t(exclude_from_sim no)\n'
                '\t\t(at 25.4 30.48 0)\n\t\t(effects\n\t\t\t(font\n\t\t\t\t'
                '(size 1.27 1.27)\n\t\t\t)\n\t\t\t(justify left bottom)\n'
                '\t\t)\n\t\t(uuid "%s")\n\t)' % (FROZEN_SHA256[:16] + "...", uid()))
    for ci, title in enumerate(COLUMN_TITLES):
        body.append('\t(text "%s"\n\t\t(exclude_from_sim no)\n'
                    '\t\t(at %s 38.1 0)\n\t\t(effects\n\t\t\t(font\n'
                    '\t\t\t\t(size 1.524 1.524)\n\t\t\t)\n'
                    '\t\t\t(justify left bottom)\n\t\t)\n\t\t(uuid "%s")\n\t)'
                    % (title, fmt(round(col_x[ci] / 1.27) * 1.27), uid()))

    power_syms, wires, labels, ncs, flags = [], [], [], [], []
    stats = dict(pins=0, nets=set(), labels=0, power=0, nc=0, gap=0, unnamed=0)

    for r in resolved:
        ref, fp, lib_id = r["fp"]["ref"], r["fp"], None
        lib_id = r["lib_id"]
        sx, sy = pos[ref]
        pins = symbol_pins(r["block"])
        # design intent override for the barometer (frozen PCB labels it BMP280)
        value = BARO_VALUE if ref == BARO_REF else fp["value"]
        footprint = BARO_FOOTPRINT if ref == BARO_REF else "%s:%s" % (FP_LIBNAME, fp["leaf"])
        pin_txt = "".join('\t\t(pin "%s"\n\t\t\t(uuid "%s")\n\t\t)\n' % (n, uid())
                          for n in padnums)
        body.append(
            "\t(symbol\n\t\t(lib_id \"%s\")\n\t\t(at %s %s 0)\n\t\t(unit 1)\n"
            "\t\t(exclude_from_sim no)\n\t\t(in_bom yes)\n\t\t(on_board yes)\n"
            "\t\t(dnp no)\n\t\t(uuid \"%s\")\n"
            "\t\t(property \"Reference\" \"%s\"\n\t\t\t(at %s %s 0)\n"
            "\t\t\t(effects\n\t\t\t\t(font\n\t\t\t\t\t(size 1.27 1.27)\n"
            "\t\t\t\t)\n\t\t\t\t(justify left)\n\t\t\t)\n\t\t)\n"
            "\t\t(property \"Value\" \"%s\"\n\t\t\t(at %s %s 0)\n"
            "\t\t\t(effects\n\t\t\t\t(font\n\t\t\t\t\t(size 1.27 1.27)\n"
            "\t\t\t\t)\n\t\t\t\t(justify left)\n\t\t\t)\n\t\t)\n"
            "\t\t(property \"Footprint\" \"%s\"\n\t\t\t(at %s %s 0)\n"
            "\t\t\t(effects\n\t\t\t\t(font\n\t\t\t\t\t(size 1.27 1.27)\n"
            "\t\t\t\t)\n\t\t\t\t(hide yes)\n\t\t\t)\n\t\t)\n"
            "%s\t\t(instances\n\t\t\t(project \"v_c3_flight\"\n"
            "\t\t\t\t(path \"/%s\"\n\t\t\t\t\t(reference \"%s\")\n"
            "\t\t\t\t\t(unit 1)\n\t\t\t\t)\n\t\t\t)\n\t\t)\n\t)\n"
            % (lib_id, fmt(sx), fmt(sy), uid(), ref, fmt(sx + 2.54),
               fmt(sy - 6.35), value, fmt(sx + 2.54), fmt(sy + 2.54),
               footprint, fmt(sx), fmt(sy),
               pin_txt, uid(), ref))

        # netless-pad handling, keyed on the audit verdicts
        for pad in fp["pads"]:
            if pad["num"] == "":
                stats["unnamed"] += 1
                continue
            pin = pins[pad["num"]]
            px, py = pin_point(sx, sy, pin)
            stats["pins"] += 1
            key = (ref, pad["num"])
            if pad["net"] == "":
                ncs.append((px, py))
                stats["nc"] += 1
                if key in DECLARED_GAP:
                    stats["gap"] += 1
                    notes.append((px, py, "GAP %s.%s: %s"
                                  % (ref, pad["num"], DECLARED_GAP[key])))
                elif key not in INTENTIONAL_NC:
                    notes.append((px, py, "NETLESS %s.%s: unclassified"
                                  % (ref, pad["num"])))
                continue
            stats["nets"].add(pad["net"])
            ex, ey = stub_end(sx, sy, pin, 5.08)
            wires.append((px, py, ex, ey))
            if pad["net"] in POWER_NETS:
                power_syms.append((pad["net"], ex, ey))
                stats["power"] += 1
            else:
                labels.append((pad["net"], ex, ey))
                stats["labels"] += 1

    # ---- PWR_FLAG: rails fed only by connectors/passives need a driver
    flag_pts = {}
    for (net, x, y) in power_syms:
        flag_pts.setdefault(net, (x, y))
    for (net, x, y) in labels:
        flag_pts.setdefault(net, (x, y))
    flag_nets = {n for (n, _, _) in power_syms}
    for r in resolved:
        if r["fp"]["ref"] != "U4":
            continue
        for p in r["fp"]["pads"]:
            if p["num"] == "1" and p["net"]:
                flag_nets.add(p["net"])
    # a rail already driven by a real power-output pin needs no PWR_FLAG
    driven = set()
    for r in resolved:
        rpins = symbol_pins(r["block"])
        for p in r["fp"]["pads"]:
            if (p["num"] and p["net"]
                    and rpins.get(p["num"], {}).get("type") == "power_out"):
                driven.add(p["net"])
    flag_nets -= driven
    for net in sorted(flag_nets):
        if net not in flag_pts:
            continue
        x, y = flag_pts[net]
        wires.append((x, y, x + 5.08, y))
        flags.append((net, x + 5.08, y))

    for (x1, y1, x2, y2) in wires:
        body.append('\t(wire\n\t\t(pts\n\t\t\t(xy %s %s) (xy %s %s)\n\t\t)\n'
                    '\t\t(stroke\n\t\t\t(width 0)\n\t\t\t(type default)\n\t\t)\n'
                    '\t\t(uuid "%s")\n\t)\n'
                    % (fmt(x1), fmt(y1), fmt(x2), fmt(y2), uid()))
    for (txt, x, y) in labels:
        body.append('\t(label "%s"\n\t\t(at %s %s 0)\n\t\t(effects\n'
                    '\t\t\t(font\n\t\t\t\t(size 1.27 1.27)\n\t\t\t)\n'
                    '\t\t\t(justify left bottom)\n\t\t)\n\t\t(uuid "%s")\n\t)\n'
                    % (txt, fmt(x), fmt(y), uid()))
    for i, (net, x, y) in enumerate(power_syms):
        pref = "#PWR0%03d" % (i + 1)
        body.append(('\t(symbol\n\t\t(lib_id "power:%s")\n\t\t(at %s %s 0)\n'
                    '\t\t(unit 1)\n\t\t(exclude_from_sim no)\n\t\t(in_bom yes)\n'
                    '\t\t(on_board yes)\n\t\t(dnp no)\n\t\t(uuid "%s")\n'
                    '\t\t(property "Reference" "#PWR"\n\t\t\t(at %s %s 0)\n'
                    '\t\t\t(effects\n\t\t\t\t(font\n\t\t\t\t\t(size 1.27 1.27)\n'
                    '\t\t\t\t)\n\t\t\t\t(hide yes)\n\t\t\t)\n\t\t)\n'
                    '\t\t(property "Value" "%s"\n\t\t\t(at %s %s 0)\n'
                    '\t\t\t(effects\n\t\t\t\t(font\n\t\t\t\t\t(size 1.27 1.27)\n'
                    '\t\t\t\t)\n\t\t\t\t(hide yes)\n\t\t\t)\n\t\t)\n'
                    '\t\t(property "Footprint" ""\n\t\t\t(at %s %s 0)\n'
                    '\t\t\t(effects\n\t\t\t\t(font\n\t\t\t\t\t(size 1.27 1.27)\n'
                    '\t\t\t\t)\n\t\t\t\t(hide yes)\n\t\t\t)\n\t\t)\n'
                    '\t\t(pin "1"\n\t\t\t(uuid "%s")\n\t\t)\n'
                    '\t\t(instances\n\t\t\t(project "v_c3_flight"\n'
                    '\t\t\t\t(path "/%s"\n\t\t\t\t\t(reference "#PWR")\n'
                    '\t\t\t\t\t(unit 1)\n\t\t\t\t)\n\t\t\t)\n\t\t)\n\t)\n'
                    % (net, fmt(x), fmt(y), uid(), fmt(x + 2.54), fmt(y + 2.54),
                       net, fmt(x + 2.54), fmt(y - 2.54), fmt(x), fmt(y),
                       uid(), uid())).replace('#PWR', pref))
    for i, (net, x, y) in enumerate(flags):
        body.append('\t(symbol\n\t\t(lib_id "power:PWR_FLAG")\n\t\t(at %s %s 0)\n'
                    '\t\t(unit 1)\n\t\t(exclude_from_sim no)\n\t\t(in_bom yes)\n'
                    '\t\t(on_board yes)\n\t\t(dnp no)\n\t\t(uuid "%s")\n'
                    '\t\t(property "Reference" "#FLG0%d"\n\t\t\t(at %s %s 0)\n'
                    '\t\t\t(effects\n\t\t\t\t(font\n\t\t\t\t\t(size 1.27 1.27)\n'
                    '\t\t\t\t)\n\t\t\t\t(hide yes)\n\t\t\t)\n\t\t)\n'
                    '\t\t(property "Value" "PWR_FLAG"\n\t\t\t(at %s %s 0)\n'
                    '\t\t\t(effects\n\t\t\t\t(font\n\t\t\t\t\t(size 1.27 1.27)\n'
                    '\t\t\t\t)\n\t\t\t\t(hide yes)\n\t\t\t)\n\t\t)\n'
                    '\t\t(property "Footprint" ""\n\t\t\t(at %s %s 0)\n'
                    '\t\t\t(effects\n\t\t\t\t(font\n\t\t\t\t\t(size 1.27 1.27)\n'
                    '\t\t\t\t)\n\t\t\t\t(hide yes)\n\t\t\t)\n\t\t)\n'
                    '\t\t(pin "1"\n\t\t\t(uuid "%s")\n\t\t)\n'
                    '\t\t(instances\n\t\t\t(project "v_c3_flight"\n'
                    '\t\t\t\t(path "/%s"\n\t\t\t\t\t(reference "#FLG0%d")\n'
                    '\t\t\t\t\t(unit 1)\n\t\t\t\t)\n\t\t\t)\n\t\t)\n\t)\n'
                    % (fmt(x), fmt(y), uid(), i + 1, fmt(x + 2.54), fmt(y + 2.54),
                       fmt(x + 2.54), fmt(y - 2.54), fmt(x), fmt(y), uid(),
                       uid(), i + 1))
    for (x, y) in ncs:
        body.append('\t(no_connect\n\t\t(at %s %s)\n\t\t(uuid "%s")\n\t)\n'
                    % (fmt(x), fmt(y), uid()))

    # gap / netless annotations: honest, visible, cites the audit
    seen_notes = set()
    for (x, y, txt) in notes:
        if txt in seen_notes:
            continue
        seen_notes.add(txt)
        body.append('\t(text "%s"\n\t\t(exclude_from_sim no)\n'
                    '\t\t(at %s %s 0)\n\t\t(effects\n\t\t\t(font\n'
                    '\t\t\t\t(size 1.016 1.016)\n\t\t\t)\n'
                    '\t\t\t(justify left bottom)\n\t\t)\n\t\t(uuid "%s")\n\t)\n'
                    % (txt, fmt(x + 1.27), fmt(y), uid()))

    # power symbols come from the power library; make sure the defs exist
    for net in sorted({n for (n, _, _) in power_syms}):
        lib, name = "power", net
        if "power:" + net not in lib_blocks:
            block = load_lib_symbol(lib, name)
            lib_blocks["power:" + net] = block
    if flags and "power:PWR_FLAG" not in lib_blocks:
        lib_blocks["power:PWR_FLAG"] = load_lib_symbol("power", "PWR_FLAG")
    libdefs = "\n".join(lib_blocks[k] for k in lib_blocks)

    sch = ('(kicad_sch\n\t(version 20250114)\n\t(generator "eeschema")\n'
           '\t(generator_version "9.0")\n\t(uuid "%s")\n\t(paper "A2")\n'
           '\t(title_block\n\t\t(title "Balloon C3 Flight Board")\n'
           '\t\t(date "2026-09-17")\n\t\t(rev "v0-derived")\n'
           '\t\t(company "Balloon Relay")\n'
           '\t\t(comment 1 "DERIVED artifact: mirrors the frozen PCB netlist; '
           'PCB is the source of truth (ADR-028)")\n\t)\n'
           '\t(lib_symbols\n%s\n\t)\n%s'
           '\t(sheet_instances\n\t\t(path "/"\n\t\t\t(page "1")\n\t\t)\n\t)\n)\n'
           % (uid(), libdefs, "".join(body)))

    with open(OUT_SCH, "w") as fh:
        fh.write(clean(sch))

    # standalone symbol library for the custom parts (sym-lib-table resolves it)
    with open(OUT_CUSTOM_SYM, "w") as fh:
        fh.write('(kicad_symbol_lib\n\t(version 20241209)\n'
                 '\t(generator "kicad_symbol_editor")\n'
                 '\t(generator_version "9.0")\n')
        for k, blk in lib_blocks.items():
            if k.startswith(FP_LIBNAME + ":"):
                fh.write("\t" + blk.replace('(symbol "%s:' % FP_LIBNAME,
                                             '(symbol "', 1) + "\n")
        fh.write(")\n")

    libs = sorted({k.split(":")[0] for k in lib_blocks}
                  | {"Sensor_Pressure", "Diode", V9_LIBNAME})
    with open(OUT_LIBTABLE, "w") as fh:
        fh.write('(sym_lib_table\n\t(version 7)\n')
        for lib in libs:
            uri = (os.path.join(SYMDIR, lib + ".kicad_sym")
                   if lib not in ("balloon_flight", V9_LIBNAME)
                   else ("${KIPRJMOD}/balloon_flight.kicad_sym"
                         if lib == "balloon_flight"
                         else "${KIPRJMOD}/v9_lib/%s.kicad_sym" % V9_LIBNAME))
            fh.write('\t(lib (name "%s")(type "KiCad")(uri "%s")(options "")'
                     '(descr ""))\n' % (lib, uri))
        fh.write(")\n")

    stats["flags"] = len(flags)
    return stats, resolved


# =====================================================================
# v9 TRI-BAND FLIGHT BOARD  (ADR-029 / 108-f33-sx1280-pin-plan / 034 / 035 /
# 036-043)
# ---------------------------------------------------------------------
# The C3 schematic above is DERIVED from a frozen PCB sha256.  No v9 PCB
# exists, so this variant is a DESIGN-INTENT schematic instead: every net
# below is transcribed from a landed decision record (named in V9_NET_SRC),
# and every pin whose electrical treatment no record fixes is left OPEN with
# a visible TODO(unverified) note.  Nothing is guessed -- in particular no
# tie-off is invented for the 2 W PA module, for an RF port, or for a power
# pin whose rail the records leave open (ADR-029 O5).
# =====================================================================

V9_OUT_SCH = os.path.join(HERE, "v9_flight.kicad_sch")
V9_LIBDIR = os.path.join(HERE, "v9_lib")
V9_FPLIB = os.path.join(V9_LIBDIR, "balloon_flight_v9.pretty")
V9_SYMLIB = os.path.join(V9_LIBDIR, "balloon_flight_v9.kicad_sym")
V9_FPTABLE = os.path.join(HERE, "v9_fp-lib-table")
V9_SYMTABLE = os.path.join(HERE, "v9_sym-lib-table")
V9_PROJECT = "v9_flight"
V9_LIBNAME = "balloon_flight_v9"
V9_SRC_PRETTY = os.path.join(REPO, "tracker", "hardware", "hub_board_diy",
                             "custom.pretty")
V9_SX_FP = os.path.join(REPO, "tracker", "hardware", "footprints", "v9",
                        "SX1280_QFN24.kicad_mod")

# --- F33-2G4 18-pad module.  Pad names from docs/DUAL-VARIANT-DESIGN.md (V2
# table) + commit d5a2e47 (the corrected vendor land pattern, in base).
V9_F33_PINS = [
    ("1", "VCC", "power_in"), ("2", "GND", "power_in"),
    ("3", "GND", "power_in"), ("4", "GND", "power_in"),
    ("5", "CE", "input"), ("6", "GND", "power_in"),
    ("7", "GND", "power_in"), ("8", "GND", "power_in"),
    ("9", "ANT", "passive"),
    ("10", "ANT-2G4", "passive"), ("11", "GND", "power_in"),
    ("12", "SCK", "input"), ("13", "NSS", "input"),
    ("14", "BUSY", "output"), ("15", "MOSI", "input"),
    ("16", "MISO", "tri_state"), ("17", "RESET", "input"),
    ("18", "IRQ", "output"),
]

# --- bare LoRa2021 castellated 18-pad module.  Pad names from
# docs/DUAL-VARIANT-DESIGN.md (V1 table: GP2..GP8 wiring + "GND pins 2,8,11,12,18").
# Pad 13 is `VTCXO` (was the placeholder `PAD13_??`): the value vendor pin table
# docs/assets/lr2021/LoRa2021-Module-Datasheet-V1.3.pdf 7 "Pin definition"
# enumerates all 18 pads and names pad 13 `VTCXO`, `O`, "Can provide power for an
# external TCXO."  This is a NAMING correction with a source (ADR-058 s1.3), not a
# connectivity change: pad 13 carries the chip's VTCXO/VNTC rail (chip pin 6) and
# is the bias rail of the ADR-058 NTC temperature-compensation provision.
# NOTE: the module breaks out VTCXO but NOT the chip's `NTC` sense input (chip
# pin 3) - see OPEN-29 and ADR-058 D6.  Pads 16/17 are now NAMED `DIO8`/`DIO7` - a naming correction with a source (the vendor pin table docs/assets/lr2021/LoRa2021-Module-Datasheet-V1.3.pdf s7 and docs/inventory.md line 28), no connectivity added. Their MCU ASSIGNMENT is still OPEN (OPEN-5).
V9_BARE_PINS = [
    ("1", "VCC", "power_in"), ("2", "GND", "power_in"),
    ("3", "MISO", "tri_state"), ("4", "MOSI", "input"),
    ("5", "SCK", "input"), ("6", "NSS", "input"),
    ("7", "BUSY", "output"), ("8", "GND", "power_in"),
    ("9", "ANT", "passive"),
    ("10", "2G4_ANT", "passive"), ("11", "GND", "power_in"),
    ("12", "GND", "power_in"), ("13", "VTCXO", "passive"),
    ("14", "RESET", "input"), ("15", "IRQ_DIO9", "output"),
    ("16", "DIO8", "passive"), ("17", "DIO7", "passive"),
    ("18", "GND", "power_in"),
]

# --- SX1280.  REAL pinout, VERIFIED.  Source: Semtech SX1280/SX1281 Data Sheet Rev 3.2
# (March 2020) Table 2-1 + Figure 2-1, vendored at docs/sx1280/ -- transcribed to
# docs/fab/SX1280-WIRING-SPEC.json and docs/fab/OPEN-13-CLOSED-SX1280-PINOUT.md, and built into
# the sheet of record by commit b7b47df7 (STEP 1).
#
# The FOURTH field is the pin's REAL SIDE.  This is the whole point: the previous version of this
# table was a declared-unverified PLACEHOLDER (VDD_IN/VDD_IO/NSS/SCK/MOSI/MISO/ANT_SW) whose
# 25 entries were laid out by _v9_symbol()'s 50/50 half-split -- 13 left / 12 right at 2.54 mm --
# which is structurally unable to represent a part with 6 LEFT / 3 BOTTOM / 9 RIGHT / 6 TOP pins.
# The placeholder also gave the part an ANT_SW pin, which the real SX1280 does NOT have (that net
# was removed from the sheet in commit 96d219b3).
#
# ORDER MATTERS: pins are placed in list order along their own side, so this list is also the
# pin-escape order.  Pin 0 is the exposed pad, whose connectable end lands at the body CENTRE --
# that is what STEP 1 built and what the sheet's wiring assumes (it needs a dedicated wire run
# out to a ground flag).  Making the EP a normal side pin is a separate, still-open improvement.
V9_SX1280_PINS = [
    ("0",  "GND",     "passive",       "centre"),
    ("1",  "VR_PA",   "passive",       "LEFT"),
    ("2",  "VDD_IN",  "power_in",      "LEFT"),
    ("3",  "NRESET",  "input",         "LEFT"),
    ("4",  "XTA",     "passive",       "LEFT"),
    ("5",  "GND",     "passive",       "LEFT"),
    ("6",  "XTB",     "passive",       "LEFT"),
    ("7",  "BUSY",    "output",        "BOTTOM"),
    ("8",  "DIO1",    "bidirectional", "BOTTOM"),
    ("9",  "DIO2",    "bidirectional", "BOTTOM"),
    ("10", "DIO3",    "bidirectional", "RIGHT"),
    ("11", "VBAT_IO", "power_in",      "RIGHT"),
    ("12", "DCC_FB",  "passive",       "RIGHT"),
    ("13", "GND",     "passive",       "RIGHT"),
    ("14", "DCC_SW",  "passive",       "RIGHT"),
    ("15", "VBAT",    "power_in",      "RIGHT"),
    ("16", "MISO_TX", "output",        "RIGHT"),
    ("17", "MOSI_RX", "input",         "RIGHT"),
    ("18", "SCK_RTSN", "input",        "RIGHT"),
    ("19", "NSS_CTS", "input",         "TOP"),
    ("20", "GND",     "passive",       "TOP"),
    ("21", "GND",     "passive",       "TOP"),
    ("22", "RFIO",    "bidirectional", "TOP"),
    ("23", "GND",     "passive",       "TOP"),
    ("24", "GND",     "passive",       "TOP"),
]

# --- TPS7A02 3.3 V ultra-low-Iq LDO, SOT-23-5 (ADR-006).  Pin *names* follow the
# SOT-23-5 LDO convention the repo already uses (Regulator_Linear:TPS7A0533PDBV).
# The TPS7A02 pinout itself is not committed in-repo -> EN/NC treatment is TODO.
V9_TPS7A02_PINS = [
    ("1", "IN", "power_in"), ("2", "GND", "power_in"),
    ("3", "EN", "input"), ("4", "NC", "passive"), ("5", "OUT", "power_out"),
]


def _v9_symbol(libname, name, value, footprint, descr, datasheet, pins):
    """Build a balloon_flight_v9:<name> symbol from a pin table.

    TWO FORMS, and the difference matters:

    * 3-tuples (num, pname, etype) -- LEGACY.  Pins are split 50/50 left/right at 2.54 mm pitch,
      exactly like the LR2021F33 custom symbol the C3 generator emits (pins 1..N/2 left, rest
      right).  Unchanged; every other custom symbol on this sheet still uses it.

    * 4-tuples (num, pname, etype, side) with side in LEFT / BOTTOM / RIGHT / TOP / centre --
      the REAL SX1280 layout.  Pins are placed on their OWN side, spread evenly across the body,
      which is what a 6 LEFT / 3 BOTTOM / 9 RIGHT / 6 TOP part requires.  A 50/50 half-split
      CANNOT represent it: 25 pins that way is 13 left / 12 right at 2.54 mm, and that 13-row
      2.54 mm stub field is exactly the geometry that re-landed the old wiring on the wrong pins.
      The geometry below reproduces rewrite_sch_sx1280.py (STEP 1, commit b7b47df7) pin for pin,
      so the generator's symbol and the sheet of record stay identical.  A 'centre' pin is placed
      at the symbol origin -- that is the exposed pad, whose connectable end lands inside the body.
    """
    sided = bool(pins) and len(pins[0]) == 4
    if sided:
        groups = {}
        for num, pname, etype, side in pins:
            if side == "centre":
                continue
            groups.setdefault(side, []).append((num, pname, etype))
        bx, by, lead = 12.7, 17.78, 2.54
        for side in ("LEFT", "BOTTOM", "RIGHT", "TOP"):
            if side not in groups:
                continue
            grp = groups[side]
            n_side = len(grp)
            step = (by * 2 if side in ("LEFT", "RIGHT") else bx * 2) / (n_side + 1)
            for i, (num, pname, etype) in enumerate(grp):
                off = step * (i + 1)
                if side == "LEFT":
                    x, y, ang = -bx - lead, by - off, 0.0
                elif side == "RIGHT":
                    x, y, ang = bx + lead, -by + off, 180.0
                elif side == "BOTTOM":
                    x, y, ang = -bx + off, -by - lead, 90.0
                else:                                    # TOP
                    x, y, ang = bx - off, by + lead, 270.0
                groups[side][i] = (num, pname, etype, x, y, ang)
        centres = [(num, pname, etype, 0.0, 0.0, 0.0)
                   for num, pname, etype, side in pins if side == "centre"]
        body_pins = centres + [p for side in ("LEFT", "BOTTOM", "RIGHT", "TOP")
                               for p in groups.get(side, [])]
        body = [_v9_pin(num, pname, etype, x, y, ang)
                for num, pname, etype, x, y, ang in body_pins]
        out = _v9_symbol_head(libname, name, value, footprint, descr, datasheet, bx, by)
        out.append('\t\t(symbol "%s_1_1"\n%s\n\t\t)' % (name, "\n".join(body)))
        out.append("\t)")
        return "\n".join(out)

    half = (len(pins) + 1) // 2
    left, right = pins[:half], pins[half:]
    n = max(len(left), len(right))
    by = (n - 1) * 2.54 / 2.0 + 2.54
    bx = 12.7
    out = _v9_symbol_head(libname, name, value, footprint, descr, datasheet, bx, by)
    body = []
    for i, (num, pname, etype) in enumerate(left):
        body.append(_v9_pin(num, pname, etype, -bx - 2.54,
                            by - 2.54 - i * 2.54, 0.0))
    for i, (num, pname, etype) in enumerate(right):
        body.append(_v9_pin(num, pname, etype, bx + 2.54,
                            by - 2.54 - i * 2.54, 180.0))
    out.append('\t\t(symbol "%s_1_1"\n%s\n\t\t)' % (name, "\n".join(body)))
    out.append("\t)")
    return "\n".join(out)


def _v9_symbol_head(libname, name, value, footprint, descr, datasheet, bx, by):
    """Everything of a custom symbol before its pin body: headers, properties, body rectangle."""
    out = ['(symbol "%s:%s"' % (libname, name)]
    out.append('\t\t(pin_names\n\t\t\t(offset 1.016)\n\t\t\t(hide no)\n\t\t)')
    out.append('\t\t(exclude_from_sim no)\n\t\t(in_bom yes)\n\t\t(on_board yes)')
    out.append('\t\t(property "Reference" "U"\n\t\t\t(at 0 %s 0)\n'
               '\t\t\t(effects\n\t\t\t\t(font\n\t\t\t\t\t(size 1.27 1.27)\n'
               '\t\t\t\t)\n\t\t\t)\n\t\t)' % fmt(by + 2.54))
    out.append('\t\t(property "Value" "%s"\n\t\t\t(at 0 %s 0)\n'
               '\t\t\t(effects\n\t\t\t\t(font\n\t\t\t\t\t(size 1.27 1.27)\n'
               '\t\t\t\t)\n\t\t\t)\n\t\t)' % (value, fmt(-by - 2.54)))
    out.append('\t\t(property "Footprint" "%s"\n\t\t\t(at 0 0 0)\n'
               '\t\t\t(effects\n\t\t\t\t(font\n\t\t\t\t\t(size 1.27 1.27)\n'
               '\t\t\t\t)\n\t\t\t\t(hide yes)\n\t\t\t)\n\t\t)' % footprint)
    out.append('\t\t(property "Datasheet" "%s"\n\t\t\t(at 0 0 0)\n'
               '\t\t\t(effects\n\t\t\t\t(font\n\t\t\t\t\t(size 1.27 1.27)\n'
               '\t\t\t\t)\n\t\t\t\t(hide yes)\n\t\t\t)\n\t\t)' % datasheet)
    out.append('\t\t(property "Description" "%s"\n\t\t\t(at 0 0 0)\n'
               '\t\t\t(effects\n\t\t\t\t(font\n\t\t\t\t\t(size 1.27 1.27)\n'
               '\t\t\t\t)\n\t\t\t\t(hide yes)\n\t\t\t)\n\t\t)' % descr)
    out.append('\t\t(symbol "%s_0_1"\n\t\t\t(rectangle\n'
               '\t\t\t\t(start %s %s)\n\t\t\t\t(end %s %s)\n'
               '\t\t\t\t(stroke\n\t\t\t\t\t(width 0.254)\n'
               '\t\t\t\t\t(type default)\n\t\t\t\t)\n'
               '\t\t\t\t(fill\n\t\t\t\t\t(type background)\n\t\t\t\t)\n\t\t\t)\n\t\t)'
               % (name, fmt(-bx), fmt(by), fmt(bx), fmt(-by)))
    return out


def _v9_pin(num, pname, etype, x, y, ang):
    return ('\t\t\t(pin %s line\n\t\t\t\t(at %s %s %s)\n'
            '\t\t\t\t(length 2.54)\n\t\t\t\t(name "%s"\n'
            '\t\t\t\t\t(effects\n\t\t\t\t\t\t(font\n'
            '\t\t\t\t\t\t\t(size 1.27 1.27)\n\t\t\t\t\t\t)\n'
            '\t\t\t\t\t)\n\t\t\t\t)\n\t\t\t\t(number "%s"\n'
            '\t\t\t\t\t(effects\n\t\t\t\t\t\t(font\n'
            '\t\t\t\t\t\t\t(size 1.27 1.27)\n\t\t\t\t\t\t)\n'
            '\t\t\t\t\t)\n\t\t\t\t)\n\t\t\t)'
            % (etype, fmt(x), fmt(y), fmt(ang), pname, num))


def v9_custom_symbols():
    """The four repo-local symbols the v9 sheet needs (written to v9_lib/)."""
    return {
        "balloon_flight_v9:F33_2G4": _v9_symbol(
            V9_LIBNAME, "F33_2G4", "LoRa2021F33-2G4",
            "balloon_flight_v9:LoRa2021F33_2G4",
            "NiceRF LoRa2021F33-2G4 (SEMTECH LR2021, 18-pad castellated, "
            "built-in +30 dBm PA / 0.5 ppm TCXO). Pad names from "
            "docs/DUAL-VARIANT-DESIGN.md; pad centres from the vendor land "
            "file (d5a2e47), pad SIZE derived from the operator-supplied "
            "castellation hole diameter 0.80 +- 0.1 mm (datasheet s9 p8).",
            "https://www.nicerf.com/pdf/lora2021f33-2g4-2w-high-power-high-speed-"
            "multi-band-lr2021-wireless-communication-module-v1.1.pdf",
            V9_F33_PINS),
        "balloon_flight_v9:LR2021_BARE": _v9_symbol(
            V9_LIBNAME, "LR2021_BARE", "LoRa2021_Castellated",
            "balloon_flight_v9:LoRa2021_Castellated",
            "NiceRF LoRa2021 castellated (SEMTECH LR2021, 18-pad, "
            "chip-only 2.4 GHz RX under ADR-034 D1). Pad names from "
            "docs/DUAL-VARIANT-DESIGN.md V1 table. Land pattern UNVERIFIED "
            "against the vendor pad file (V9-RADIO-SITE-MATRIX open item 6).",
            "", V9_BARE_PINS),
        "balloon_flight_v9:SX1280": _v9_symbol(
            V9_LIBNAME, "SX1280", "SX1280",
            "balloon_flight_v9:SX1280_QFN24",
            "Semtech SX1280 2.4 GHz ranging transceiver. *** PIN NUMBERING "
            "AND LAND PATTERN NOT VERIFIED - Semtech datasheet unreachable on "
            "this host; see TODO(unverified) notes on the sheet. ***",
            "", V9_SX1280_PINS),
        "balloon_flight_v9:TPS7A0233": _v9_symbol(
            V9_LIBNAME, "TPS7A0233", "TPS7A02",
            "Package_TO_SOT_SMD:SOT-23-5",
            "TI TPS7A02 3.3 V ultra-low-Iq LDO (25 nA), SOT-23-5 - ADR-006 3.3 V "
            "rail. EN/NC tie-off not fixed by any record.",
            "", V9_TPS7A02_PINS),
        # A repo-local 3-pad solder-jumper symbol, deliberately NOT taken from
        # KiCad's `Jumper` library: the shared sym-lib-table is written by BOTH
        # generators, and the C3 generator's union does not carry `Jumper`.
        # Keeping the selector inside balloon_flight_v9 keeps the sheet
        # resolvable in either generation order.
        "balloon_flight_v9:F33_VCC_SEL": _v9_symbol(
            V9_LIBNAME, "F33_VCC_SEL", "F33_VCC_SEL (5V raw | 3V3)",
            "Jumper:SolderJumper-3_P1.3mm_Open_RoundedPad1.0x1.5mm",
            "ADR-029 D8 pin-1 rail selector (operator-RATIFIED 2026-10-05): a "
            "3-pad solder jumper. pin 2 COMMON -> F33_VCC; pin 1 -> VSCAP (raw "
            "supercap node, PRE-LDO) to fly the F33; pin 3 -> +3V3 (TPS7A02 OUT) "
            "to fly the nested bare LoRa2021. ADR-044 option (a) / ADR-047 2.",
            "", [("1", "A_VSCAP", "passive"), ("2", "COM", "passive"),
                 ("3", "B_3V3", "passive")]),
        # --- the HUB-SIDE wing interface (ADR-046 s2.1/s2.2/s4.1 +
        # docs/WING-TO-HUB-SOCKET-SPEC.md, implemented by ADR-048).  FOUR of these
        # sit on the v9 hub, one per edge, at 90 deg spacing; each one is the
        # socket land set that one wing tab solders onto.  Pin names are the
        # WING-side names of ADR-046 s2.1 (1 SOLAR_P, 2 GND, 3 RF_FEED, 4 SOLAR_N);
        # the hub NET of each pin is fixed per interface by the socket spec s3.
        # Pin TYPE is 'passive' on every pin on purpose: this is a hand-soldered
        # copper land set with no driver, so no ERC power/PA/RF termination is
        # asserted here.  Pin 3 (RF_FEED) is an unnetted V2 provision on v9
        # (ADR-046 s2.4) and is deliberately left with no net and no no_connect
        # flag - see OPEN-21.
        "balloon_flight_v9:WING_SOCKET_4P": _v9_symbol(
            V9_LIBNAME, "WING_SOCKET_4P", "WING_SOCKET_4P (hub wing interface)",
            "Tracker_Mechanical:Wing_Tab_4P",
            "Hub-side wing interface / socket land set for the v9 3D hub+4-wing "
            "assembly: 4 lands per face on BOTH outer layers = 8 copper lands per "
            "interface, land 4.0 x 1.2 mm, pitch 1.8 mm, insertion depth 6.0 mm, "
            "routed slot 0.9 mm +/-0.10 mm, 90 deg attach, edge clearance "
            ">= 1.0 mm (ADR-046 s2.2 over the socket spec's >= 0.5 mm - see "
            "ADR-048 D-1). Pads 1..4 = SOLAR_P / GND / RF_FEED (v9 provision, NO "
            "NET) / SOLAR_N. Geometry lives in the real footprint "
            "Tracker_Mechanical:Wing_Tab_4P; NOT human-accepted (ADR-046 + "
            "ADR-048 are Status Proposed).",
            "", [("1", "SOLAR_P", "passive"), ("2", "GND", "passive"),
                 ("3", "RF_FEED", "passive"), ("4", "SOLAR_N", "passive")]),
        # --- ADR-051 s2.1: the HUB-MOUNTED array as its OWN series string.
        # Symbol name mandated by ADR-051 s2.1.1.  The pin FUNCTIONS `P` / `N`
        # are load-bearing: scripts/bypass_diode_check.py resolves an on-board
        # cell's polarity from exactly these two function strings, and
        # scripts/hub_array_topology_check.py identifies the cell by its `PVA<n>`
        # reference.  Footprint is deliberately EMPTY: the hub outline is a
        # form-factor decision owned by another task (ADR-051 s2.3).
        "balloon_flight_v9:PVA_CELL": _v9_symbol(
            V9_LIBNAME, "PVA_CELL", "SolarCell_78x39mm",
            "balloon_flight_v9:PVA_CELL",
            "Hub-mounted solar cell of the INDEPENDENT hub array string "
            "(ADR-051 s2.1, LARGE class per ADR-049: 78.55 x 38.90 mm, 30.6 cm2, "
            "~0.5 V / ~1.2 A). Pin 1 = P (+), pin 2 = N (-). The CELL COUNT and "
            "the MOUNTING PLANE are OPEN (ADR-051 s2.2 + s4 items 3/4/5, ADR-054 "
            "s4.5) - the count on this sheet is a documented PLACEHOLDER, not a "
            "sizing decision. Footprint NOT fixed: the hub outline does not exist yet.",
            "", [("1", "P", "passive"), ("2", "N", "passive")]),
        # --- ADR-051 s2.1 decision 1: the hub string's OWN converter input.
        # A PROVISION - which part (sub-uA harvester H2/H3 vs the main converter
        # M5/M6) is unresolved (ADR-051 s4 items 3 and 5; ADR-054 s1.3).
        "balloon_flight_v9:HUB_CONVERTER": _v9_symbol(
            V9_LIBNAME, "HUB_CONVERTER", "HUB_PV input (part TODO(unverified))",
            "balloon_flight_v9:HUB_CONVERTER",
            "The hub array's OWN converter / harvester input (ADR-051 s2.1 "
            "decision 1 - the hub string is never in series with, and never a tap "
            "on, the wing chain). Pin 1 = PV_P (HUB_PV_P), pin 2 = GND (the ONE "
            "node this string may share with the wing system), pin 3 = PV_N "
            "(HUB_PV_N). The chosen part is OPEN: ADR-051 s2.2 recommends a "
            "2-cell H2 string on a sub-uA harvester (bq25570 class) but the "
            "H2/H3 vs M5/M6 fork and the harvester's peak-input rating are "
            "unresolved (ADR-051 s4 items 3/5/6, OPEN-26).",
            "", [("1", "PV_P", "passive"), ("2", "GND", "passive"),
                 ("3", "PV_N", "passive")]),
        # --- ADR-051 s2.5 decision item 5 + s2.6: one latched cut driver and
        # cut-sense channel per wing.  Both halves share the wing's RF_FEED
        # land: ONE conductor plus the shared ground return does the nichrome
        # drive AND the continuity sense.
        "balloon_flight_v9:CUT_CHANNEL": _v9_symbol(
            V9_LIBNAME, "CUT_CHANNEL",
            "latched cut driver + cut-sense (part TODO(unverified))",
            "balloon_flight_v9:CUT_CHANNEL",
            "Per-wing cutter channel provision (ADR-051 s2.5 decision item 5 + "
            "s2.6). Pin 1 = VSCAP (raw supercap node, post-BAT54, PRE-LDO, so the "
            "channel works with the converter dead - ADR-047 s2.1), pin 2 = GND, "
            "pin 3 = the wing's RF_FEED land (cut DRIVE and continuity SENSE on "
            "one conductor plus the shared ground). THE DRIVE MUST BE A LATCHED "
            "ONE-SHOT: cutting is irreversible and a level-sensitive driver can "
            "re-fire on a reset, a brown-out, a firmware retry or a floating "
            "gate (ADR-051 s2.5.1). Exact part, the sense divider and the GPIO "
            "assignment are all TODO(unverified) - see OPEN-25 and OPEN-28.",
            "", [("1", "VSCAP", "passive"), ("2", "GND", "passive"),
                 ("3", "CUT_W", "passive")]),
    }


# --- component table -------------------------------------------------------
# ref, lib_id, value, footprint, dnp, note
V9_COMPONENTS = [
    ("U1", "RF_Module:ESP32-S3-WROOM-1", "ESP32-S3-WROOM-1U-N8R8",
     "RF_Module:ESP32-S3-WROOM-1U", False,
     "ADR-029 D1 / ADR-037 D1: octal-PSRAM -N8R8, U.FL variant."),
    ("U2", "balloon_flight_v9:F33_2G4", "LoRa2021F33-2G4",
     "balloon_flight_v9:LoRa2021F33_2G4", False,
     "ADR-034 D1/D2: 433 MHz TX on the 2 W sub-GHz port (pin 9)."),
    ("U3", "balloon_flight_v9:LR2021_BARE", "LoRa2021_Castellated",
     "balloon_flight_v9:LoRa2021_Castellated", False,
     "ADR-034 D1: separate bare LoRa2021 = the 2.4 GHz RX chip."),
    ("U4", "balloon_flight_v9:SX1280", "SX1280",
     "balloon_flight_v9:SX1280_QFN24", False,
     "ADR-029 D2b + ADR-035: dedicated 2.4 GHz ranging radio."),
    ("U5", "RF_GPS:MAX-M10S", "MAX-M10S", "RF_GPS:ublox_MAX", False,
     "ADR-029 D2b: GNSS L1 position/time; receive-only, continuous (ADR-035 D3)."),
    ("U6", "balloon_flight_v9:MS5611_BARO", "MS5611-01BA",
     "Package_LGA:LGA-8_3x5mm_P1.25mm", False,
     "Barometer, 10-1200 hPa flight profile (ADR-029 pin plan: I2C on GPIO1/2)."),
    ("U7", "balloon_flight_v9:TPS7A0233", "TPS7A02",
     "Package_TO_SOT_SMD:SOT-23-5", False,
     "ADR-006: TPS7A02 3.3 V LDO, solar -> BAT54 -> supercap -> LDO."),
    ("C_CAP1", "Device:C_Polarized", "3.3F 2.7V (AVX SCC)",
     "Capacitor_THT:CP_Radial_D10.0mm_P5.00mm", False,
     "ADR-006: 2x 3.3 F 2.7 V in series = 1.65 F @ 5.4 V (cell A)."),
    ("C_CAP2", "Device:C_Polarized", "3.3F 2.7V (AVX SCC)",
     "Capacitor_THT:CP_Radial_D10.0mm_P5.00mm", False,
     "ADR-006: supercap bank (cell B). Sized to ONE burst (ADR-036)."),
    ("D1", "Device:D_Schottky", "BAT54", "Diode_SMD:D_SOD-123", False,
     "ADR-006: solar reverse-current Schottky (blocks back-feed into the "
     "solar cells at night)."),
    ("R_DIV1", "Device:R", "1M", "Resistor_SMD:R_0402_1005Metric", False,
     "ADR-006: 2x 1 MOhm supercap-rail ADC divider (upper)."),
    ("R_DIV2", "Device:R", "1M", "Resistor_SMD:R_0402_1005Metric", False,
     "ADR-006: 2x 1 MOhm supercap-rail ADC divider (lower)."),
    ("R_F1", "Device:R", "100R", "Resistor_SMD:R_0402_1005Metric", False,
     "ADR-029 D2(d): dedicated RC/ferrite feed (100 Ohm + 10 uF) into the GNSS "
     "rail."),
    ("C4", "Device:C", "10uF", "Capacitor_SMD:C_0402_1005Metric", False,
     "ADR-029 D2(d): GNSS-rail bulk cap on the filtered feed."),
    ("ANT1", "Connector:Conn_Coaxial", "U.FL_433_TX",
     "Connector_Coaxial:U.FL_Molex_MCRF_73412-0110_Vertical", False,
     "ADR-029 D3 (sub-GHz U.FL) + ADR-034 D1: 433 MHz TX feed = F33 pin 9."),
    ("ANT2", "Connector:Conn_Coaxial", "U.FL_2G4_RANGE",
     "Connector_Coaxial:U.FL_Molex_MCRF_73412-0110_Vertical", False,
     "ADR-108 Revision R1 (2026-10-07): the SX1280 2.4 GHz RANGING feed. "
     "Re-pointed from the F33 ANT-2G4 port because ADR-034 D1/D5 state the "
     "F33 carries TX ONLY (its pin 9 sub-GHz port is the 433 MHz TX) while "
     "the SX1280 - operator-ratified (ADR-029 D2b) and given its own TDM "
     "slot (ADR-035) - needs a feed; there are four U.FL sites and four RF "
     "parts (ADR-034 D5). Hub-side wire dipole per ADR-009. See OPEN-2."),
    ("ANT3", "Connector:Conn_Coaxial", "U.FL_2G4_RX",
     "Connector_Coaxial:U.FL_Molex_MCRF_73412-0110_Vertical", False,
     "ADR-034 D1: 2.4 GHz RX feed of the bare LoRa2021 (pin 10, the Site-B "
     "2.4 GHz RX). ADR-108 Revision R1: the four-feed / five-feed conflict "
     "is SETTLED - ANT3 keeps its role and ANT2 moves to the SX1280, so the "
     "two 2.4 GHz-capable feeds (ANT2 ranging, ANT3 link RX) stay separate "
     "as ADR-029 D3 requires. Hub-side wire dipole per ADR-009."),
    ("ANT4", "Connector:Conn_Coaxial", "U.FL_GNSS_L1",
     "Connector_Coaxial:U.FL_Molex_MCRF_73412-0110_Vertical", False,
     "ADR-029 D3: GNSS L1 feed, +Y sky-facing edge."),
    # --- ADR-047: the F33 5 V PA rail provision (operator directive 2026-10-07) ---
    ("J_VCC", "balloon_flight_v9:F33_VCC_SEL", "F33_VCC_SEL (5V raw | 3V3)",
     "Jumper:SolderJumper-3_P1.3mm_Open_RoundedPad1.0x1.5mm", False,
     "ADR-029 D8 (operator-RATIFIED 2026-10-05): the mandatory SELECTABLE pin-1 "
     "rail (3-pad solder jumper). pin 2 = COM -> F33_VCC; pin 1 = VSCAP (raw "
     "supercap node, PRE-LDO) for the F33; pin 3 = +3V3 (TPS7A02 OUT) for the "
     "nested bare LoRa2021. ADR-044 option (a) + ADR-047 2. Rendered with a "
     "repo-local symbol so no new symbol library is required."),
    ("C_BULK", "Device:C", "100uF",
     "Capacitor_SMD:C_1206_3216Metric", False,
     "ADR-047 4: local bulk cap AT THE MODULE PIN, sized for the current step "
     "(holds 1.2 A within 20 mV for 1.67 us). Cited: "
     "docs/PCB-HANDOVER-FOR-JLCPCB.md 2.4 '>=100 uF low-ESR tantalum or ceramic at "
     "PA VCC'; ADR-029 2(f) 'each radio rail gets its own ferrite + bulk cap'."),
    ("C_HF", "Device:C", "100nF",
     "Capacitor_SMD:C_0402_1005Metric", False,
     "ADR-047 4: HF bypass at the module pin. Same citation as C_BULK "
     "('... plus 100 nF HF bypass')."),
    ("D_CLAMP", "Device:D_TVS", "TVS clamp (set point TODO(unverified))",
     "Diode_SMD:D_SOD-323", False,
     "ADR-044 option (c) + ADR-047 7: over-voltage INSURANCE on F33_VCC, made "
     "required by the operator's over-provisioning directive. The set point must "
     "sit above the 5.4 V rail top and below the F33's damage threshold, which "
     "Rev 1.1 of the datasheet does not publish -> part AND set point are "
     "TODO(unverified). See OPEN-16."),
    ("R_MON1", "Device:R", "4.7M", "Resistor_SMD:R_0402_1005Metric", False,
     "ADR-047 6: F33 rail-monitor divider (upper). 4.7 M keeps the lead at "
     "0.574 uA / 3.1 uW so the divider pair does not eat ADR-036's 100 uW night "
     "anchor (the pre-existing 1M/1M SCAP divider already draws 14.6 uW)."),
    ("R_MON2", "Device:R", "4.7M", "Resistor_SMD:R_0402_1005Metric", False,
     "ADR-047 6: F33 rail-monitor divider (lower). Ratio 0.5 -> 5.4 V reads "
     "2.70 V at the ESP32-S3 ADC."),
    ("C_MON", "Device:C", "10nF", "Capacitor_SMD:C_0402_1005Metric", False,
     "ADR-047 6: ADC sample-and-hold reservoir for the 2.35 MOhm-Thevenin "
     "monitor tap (tau = 23.5 ms). Without it the S/H cap cannot settle."),
    ("R_BAL1", "Device:R", "10k", "Resistor_SMD:R_0402_1005Metric", False,
     "ADR-006 / ADR-044 'already fixed': 2x 10 kOhm supercap balancing resistors "
     "(upper cell). Mandated by the Accepted ADR-006 and restated in ADR-044; "
     "they were missing from this sheet."),
    ("R_BAL2", "Device:R", "10k", "Resistor_SMD:R_0402_1005Metric", False,
     "ADR-006 / ADR-044: balancing resistor, lower cell."),
    # --- ADR-046 / WING-TO-HUB-SOCKET-SPEC / ADR-048: the FOUR wing-mount
    # interfaces.  One hub edge each, at 90 deg spacing.  Every pad count, net
    # name and net assignment is cited in the component note; the physical land
    # geometry lives in the real footprint Tracker_Mechanical:Wing_Tab_4P, not in
    # a generic pin header.
    ("J_W1", "balloon_flight_v9:WING_SOCKET_4P", "WING_SOCKET_4P (hub wing interface 1)",
     "Tracker_Mechanical:Wing_Tab_4P", False,
     "ADR-046 s1/s2 + socket spec s1: wing interface 1 of 4. 4 lands per face x 2 "
     "faces = 8 lands, pad order 1 SOLAR_P / 2 GND / 3 RF_FEED(v9 provision, no "
     "net) / 4 SOLAR_N. Net assignment (socket spec s3.1): pad 1 = stack TOP "
     "W1_SOLAR_P -> BAT54; pad 2 = GND; pad 4 = W1_SOLAR_N, linked to wing 2's "
     "W2_SOLAR_P on the hub. Land 4.0 x 1.2 mm, pitch 1.8 mm, insertion 6.0 mm "
     "(ADR-046 s2.2/s4.1)."),
    ("J_W2", "balloon_flight_v9:WING_SOCKET_4P", "WING_SOCKET_4P (hub wing interface 2)",
     "Tracker_Mechanical:Wing_Tab_4P", False,
     "ADR-046 s1/s2 + socket spec s1: wing interface 2 of 4. Same 8-land socket. "
     "pad 2 = GND; pad 4 = W2_SOLAR_N linked to wing 3's W3_SOLAR_P; pad 1 lands "
     "on the W1_SOLAR_N / W2_SOLAR_P hub-link node (socket spec s3.1)."),
    ("J_W3", "balloon_flight_v9:WING_SOCKET_4P", "WING_SOCKET_4P (hub wing interface 3)",
     "Tracker_Mechanical:Wing_Tab_4P", False,
     "ADR-046 s1/s2 + socket spec s1: wing interface 3 of 4. Same 8-land socket. "
     "pad 2 = GND; pad 4 = W3_SOLAR_N linked to wing 4's W4_SOLAR_P; pad 1 lands "
     "on the W2_SOLAR_N / W3_SOLAR_P hub-link node (socket spec s3.1)."),
    ("J_W4", "balloon_flight_v9:WING_SOCKET_4P", "WING_SOCKET_4P (hub wing interface 4)",
     "Tracker_Mechanical:Wing_Tab_4P", False,
     "ADR-046 s1/s2 + socket spec s1: wing interface 4 of 4. Same 8-land socket. "
     "pad 2 = GND; pad 4 = W4_SOLAR_N = the stack BOTTOM, tied to the hub GND "
     "plane (ADR-046 s2.3: 'stack_bot = W4.SOLAR_N -> system GND'); DO NOT tie "
     "any other W<n>_SOLAR_N to GND (socket spec s3). pad 1 lands on the "
     "W3_SOLAR_N / W4_SOLAR_P hub-link node (socket spec s3.1)."),
    # --- ADR-051 s2.7 / ADR-053 s2.2 (as amended by ADR-054 s3.2): the four
    # HUB-SIDE per-interface bypass diodes.  POPULATED (not DNP) and re-rated:
    # a cutter-carrying flight needs them, and the DNP BAT54 the socket spec
    # named is disqualified twice over.
    #   1. WHY HUB-SIDE.  A cut jettisons the wing AND every part soldered to
    #      it, so a wing-board diode leaves with the wing and cannot bridge the
    #      gap it was fitted to bridge (ADR-054 s2.2, adversarial F3).  Only a
    #      hub-side, per-interface diode can restore the broken PATH.  Without
    #      it a cutter flight is WORSE than baseline: the first cut opens the
    #      string and the array delivers 0.00 W.
    #   2. WHY >= 2 A / 40 V AND NOT THE 200 mA BAT54.  Post-cut the other wings
    #      drive the array's FULL 1.2 A continuously through this diode for the
    #      rest of the flight - a PERMANENT CONTINUOUS bypass duty, not the
    #      shading transient a 200 mA part is sold as (ADR-051 s2.4 decisions
    #      4.2/4.3, s2.7); and the reverse rating must clear the ~9.58 V cold
    #      open-circuit stack against a 30 V part (ADR-050 s3.2).  SS24 = 2 A /
    #      40 V, in the class ADR-051 s2.7 names ("SS24 or PMEG4020ER class").
    #   3. WHY THE PACKAGE MOVES.  SOD-323 cannot carry 2 A (ADR-051 s2.7), so
    #      the land pattern moves to SMA.  See OPEN-11 for the delta = 1 derate
    #      still owed and OPEN-28 for the hub re-layout this forces.
    ("D_BP1", "Device:D_Schottky", "SS24", "Diode_SMD:D_SMA", False,
     "ADR-051 s2.7 + ADR-054 s2.2/s3.2 (HUB-SIDE placement): bypass Schottky "
     "ACROSS wing interface 1 - cathode to W1_SOLAR_P, anode to W1_SOLAR_N. "
     "POPULATED (ADR-051 s2.4 decision 4.2 supersedes the DNP instruction of "
     "ADR-046 s6 / socket spec s5 for any cutter-carrying flight). SS24 = 2 A / "
     "40 V: the post-cut bypass path is a PERMANENT CONTINUOUS 1.2 A path, and "
     "the 200 mA / 30 V BAT54 is disqualified against it. SMA land, not SOD-323: "
     "SOD-323 cannot carry 2 A."),
    ("D_BP2", "Device:D_Schottky", "SS24", "Diode_SMD:D_SMA", False,
     "ADR-051 s2.7 + ADR-054 s2.2: bypass Schottky across wing interface 2 - "
     "cathode to W2_SOLAR_P (= the W1_SOLAR_N hub link), anode to W2_SOLAR_N. "
     "POPULATED, SS24 (2 A / 40 V). Same hub-side rationale as D_BP1."),
    ("D_BP3", "Device:D_Schottky", "SS24", "Diode_SMD:D_SMA", False,
     "ADR-051 s2.7 + ADR-054 s2.2: bypass Schottky across wing interface 3 - "
     "cathode to W3_SOLAR_P (= the W2_SOLAR_N hub link), anode to W3_SOLAR_N. "
     "POPULATED, SS24 (2 A / 40 V). Same hub-side rationale as D_BP1."),
    ("D_BP4", "Device:D_Schottky", "SS24", "Diode_SMD:D_SMA", False,
     "ADR-051 s2.7 + ADR-054 s2.2: bypass Schottky across wing interface 4 - "
     "cathode to W4_SOLAR_P (= the W3_SOLAR_N hub link), anode to W4_SOLAR_N = "
     "GND. POPULATED, SS24 (2 A / 40 V). Same hub-side rationale as D_BP1. This "
     "is the only one whose anode sits on GND, because wing 4's SOLAR_N IS the "
     "stack bottom (ADR-046 s2.3)."),
    # --- ADR-058: THE LR2021 ON-CHIP NTC TEMPERATURE-COMPENSATION PROVISION.
    # The LR2021 silicon contains the XTAL compensation engine; it needs only an
    # external NTC thermistor + bias resistor at the crystal (Semtech DS 2.2
    # s1.9.2 "Figure 1-15: NTC Connection"; SetTempCompCfg opcode 0x0132 and
    # SetNtcParams opcode 0x0133 per Tables 6-69/6-70; chip pin 3 = NTC, chip
    # pin 6 = VTCXO/VNTC per Table 2-1).  Both parts are DNP, with the reason
    # recorded in the net note and OPEN-29: on the OWNED bare NiceRF module the
    # chip's NTC sense pin has NO castellation (the vendor pin table
    # docs/assets/lr2021/LoRa2021-Module-Datasheet-V1.3.pdf s7 enumerates all 18
    # pads and the only oscillator pad is 13 = VTCXO), so the sense node has no
    # path back to the chip and the loop cannot be closed.  The land is provided
    # now because there is no v9 hub PCB yet, so it costs no respin: a module (or
    # revision) that breaks the pin out closes the loop at zero cost.  Values are
    # TODO(unverified) because they must be characterised from the populated part
    # (ADR-058 D4), not guessed.
    ("R_NTC1", "Device:R", "TODO(unverified) (sets ntc_r_ratio)",
     "Resistor_SMD:R_0402_1005Metric", True,
     "ADR-058 D1/D4: series/bias resistor of the on-chip NTC temperature-"
     "compensation divider, from the VTCXO/VNTC bias rail to the NTC sense node. "
     "Its value must be characterised against the populated NTC (it sets "
     "SetNtcParams ntc_r_ratio = RBiasRatio, 'the ratio between the resistor bias "
     "value and the NTC resistor value at 25 degC, 10 bits with 9 fractional bits "
     "(10,9)' - DS 2.2 Table 6-70) -> TODO(unverified). DNP, not populated: the "
     "sense node has no path back to the chip on the owned bare module (OPEN-29, "
     "ADR-058 D6)."),
    ("TH_NTC1", "Device:Thermistor_NTC", "TODO(unverified) (NTC, R25/beta TODO)",
     "Resistor_SMD:R_0402_1005Metric", True,
     "ADR-058 D1/D3/D4: the NTC thermistor of the on-chip temperature-"
     "compensation provision - sense node to GND. SITING RULE (ADR-058 D3): it "
     "must be thermally coupled to the radio's XTAL, NOT parked on the far side "
     "of the board, and NOT sited where a self-heating neighbour dominates its "
     "reading (the F33 2 W PA, the hub converter). Part, R25 and beta are "
     "TODO(unverified): they must be read from the chosen part's datasheet and "
     "matched to ntc_beta (DS 2.2 Table 6-70: 'NTC temperature in 2 Kelvin/lsb') "
     "and to the -60 degC design case - see OPEN-30.  0402 land because an 0402 "
     "NTC uses the same land as an 0402 resistor. DNP (OPEN-29, ADR-058 D6)."),
]

# --- ADR-051 §2.1: the hub array.  Its cell count is a PARAMETER, not a
# decision.  *** THE COUNT BELOW IS A DOCUMENTED PLACEHOLDER *** ADR-051 §2.2
# recommends H2 = 2 LARGE cells (H3 = 3 is the fallback); the count, the
# MOUNTING PLANE and the harvester part are all OPEN (ADR-051 §4 items 3/4/5/6;
# ADR-054 §4.5), and the hub OUTLINE is a form-factor decision owned by another
# task (ADR-051 §2.3) - which is why the cells' footprint field is left EMPTY.
# Changing this one number regenerates the cells, the HUB_PV_MID<n> interiors,
# the per-cell hub bypass diodes and the whole hub string.  Nothing else in this
# file hard-codes the hub cell count.
V9_HUB_ARRAY_CELLS = 2

for _i in range(1, V9_HUB_ARRAY_CELLS + 1):
    V9_COMPONENTS.append(
        ("PVA%d" % _i, "balloon_flight_v9:PVA_CELL", "SolarCell_78x39mm",
         "", False,
         "Cell %d of the INDEPENDENT hub-array string (ADR-051 §2.1, LARGE "
         "class per ADR-049: 78.55 x 38.90 mm, 30.6 cm2, ~0.5 V / ~1.2 A). The "
         "string is its OWN series string with its OWN converter input; it is "
         "NEVER in series with, and never a tap on, the wing chain - the only "
         "node it may share with the wing system is GND. Enforced by "
         "scripts/hub_array_topology_check.py. CELL COUNT / MOUNTING PLANE / "
         "OUTLINE ARE OPEN (OPEN-26); this ref is a PLACEHOLDER." % _i))
    V9_COMPONENTS.append(
        ("D_HUB%d" % _i, "Device:D_Schottky", "SS24", "Diode_SMD:D_SMA", False,
         "Bypass Schottky across hub-array cell PVA%d: cathode to the cell's + "
         "node, anode to its - node. ADR-051 §2.2 places the hub cells on the "
         "hub and says they 'need their own diodes'; ADR-053 §1.6/§2.4 keeps "
         "per-GROUP over per-CELL as the general rule, and ADR-054 §4.5 leaves "
         "the hub's OWN granularity explicitly OPEN (OPEN-27). Populated at the "
         "same >=2 A / 40 V class as the per-interface diodes (SS24) so a hub "
         "cell failure is contained BY A PATH that survives any wing cut." % _i))

V9_COMPONENTS.append(
    ("U_HUB_CVT", "balloon_flight_v9:HUB_CONVERTER",
     "HUB_PV input (part TODO(unverified))", "", False,
     "The hub array's OWN converter / harvester input provision (ADR-051 §2.1 "
     "decision 1: 'its positive terminal feeds its own converter/harvester "
     "input, on its own net'). Pin 1 = HUB_PV_P, pin 2 = GND (the ONE shared "
     "node), pin 3 = HUB_PV_N. The PART is unresolved: ADR-051 §2.2 recommends "
     "the 2-cell H2 string on a sub-uA harvester of the bq25570 class, but the "
     "H2/H3 vs M5/M6 fork and the harvester's peak-input-power rating against "
     "the array's face-on peak are OPEN (OPEN-26; ADR-051 §4 items 3/5/6)."))

for _i in range(1, 5):
    V9_COMPONENTS.append(
        ("U_CUT%d" % _i, "balloon_flight_v9:CUT_CHANNEL",
         "latched cut driver + cut-sense (part TODO(unverified))", "", False,
         "Wing %d cut channel (ADR-051 §2.5 decision item 5 + §2.6): the "
         "nichrome cutter drive AND the cut-sense continuity line on the wing's "
         "ONE reserved RF_FEED conductor plus the shared ground. Pin 1 = VSCAP "
         "(raw supercap node, post-BAT54, PRE-LDO, so the cut works with the "
         "converter dead - ADR-047 §2.1); pin 2 = GND; pin 3 drives/senses "
         "CUT_SENSE_W%d = J_W%d pad 3 (RF_FEED). THE DRIVE IS MANDATED TO BE A "
         "LATCHED ONE-SHOT (ADR-051 §2.5.1): cutting is irreversible, and a "
         "level-sensitive driver can re-fire on a reset, brown-out, retry or "
         "floating gate - each fire costing ~2.59 J of the bank\'s 16.63 J at "
         "the moment the bank matters. Firmware must also serialise cuts "
         "(4 simultaneous fires = 9.9 A = 2.4x the IRLML2502 class rating) and "
         "log a silently-failed cut below the ~3.3 V arming threshold. Part, "
         "sense divider, GPIO and the latch's exact topology: TODO(unverified) "
         "- OPEN-25 and OPEN-28." % (_i, _i, _i)))


# --- nets ------------------------------------------------------------------
# net -> [(ref, pin), ...].  Each entry carries its citation.
V9_NETS = [
    ("+3V3", [("U1", "2"), ("U2", "5"), ("U3", "1"), ("U5", "6"), ("U5", "7"),
              ("U5", "9"), ("U6", "1"), ("U6", "4"), ("U7", "5"), ("R_F1", "1"),
              ("U4", "15"), ("J_VCC", "3")],
     "ADR-006 3.3 V rail (TPS7A02 OUT); U2 pin 5 CE strapped to 3V3 per the "
     "ADR-029 pin plan (blocker 3: confirm CE vs the purchased revision). "
     "U5 pins 6/7/9 (V_BCKP / VCC_IO / ~RESET) are tied to +3V3 on the precedent "
     "of the frozen v8i board, which uses the SAME ublox_MAX footprint and "
     "RF_GPS:MAX-M10S symbol (v8i_krt_gnss.kicad_pcb U3 pads 6,7,8,9 = +3V3; "
     "the v8i board is sha256-pinned in this generator). J_VCC pin 3 is the "
     "3.3 V position of the ADR-029 D8 pin-1 selector (nested bare LoRa2021). "
     "R_F1 pin 1 feeds the GNSS RC filter per ADR-029 2(d). "
     "ADR-108 Revision R1 (2026-10-07) CLOSED OPEN-1 as 'U4 pins 1/2 are on "
     "+3V3'.  THE PINOUT REVISION OF 2026-10-15 SUPERSEDES THE PIN NUMBERS IN "
     "THAT RULING: on the REAL part the radio supply is pin 15 (VBAT), and pins "
     "1 and 2 are VR_PA (a regulator OUTPUT, bypassed by C5 to GND) and VDD_IN "
     "(the internal regulator's output node, tied to pin 12 DCC_FB through L4) "
     "-- NEITHER may sit on a rail.  So the rail of record is unchanged (the "
     "3.3 V rail IS the SX1280 supply of "
     "record - ADR-047 2.3 states verbatim that the 3.3 V rail also carries "
     "the ESP32-S3, the SX1280 and the GNSS, and docs/POWER-BUDGET-V9-D2BE.md "
     "2 puts BOTH SX1280 states (ranging TX 70 mA, ranging RX 15 mA) on the "
     "3.3 V rail. ADR-060 s4 confirms the SX1280 default is no TCXO and NO "
     "new or gated rail, so no rail is created for this part. The ADR-029 "
     "2(f) provision (its own ferrite + bulk cap) is NOT yet fitted and is "
     "registered as OPEN-33. "
     "OPEN-7 CLOSURE (2026-10-07): U6 pin 4 (CSB) is tied to +3V3 on the "
     "precedent of the frozen v8j MS5611 board "
     "(tracker/hardware/output/v8j_krt_ms5611.kicad_pcb), which carries the "
     "SAME Package_LGA:LGA-8_3x5mm_P1.25mm barometer footprint in the SAME "
     "I2C mode (its pads 7/8 are I2C_SDA / I2C_SCL, exactly this sheet U6 "
     "pins 7/8) and ties pad 4 = +3V3, pad 2 = GND, pad 6 = GND."),
    ("GND", [("U1", "1"),
             ("U2", "2"), ("U2", "3"), ("U2", "4"), ("U2", "6"), ("U2", "7"),
             ("U2", "8"), ("U2", "11"),
             ("U3", "2"), ("U3", "8"), ("U3", "11"), ("U3", "12"), ("U3", "18"),
             # U4's REAL ground pads: 0 is the exposed pad (whose connectable end lands at the
             # symbol origin), 5/13/20/21/23/24 are the GND pins.  The placeholder list (3/15..25)
             # was the 13/12 half-split numbering and would now short the SPI pins to ground.
             ("U4", "0"), ("U4", "5"), ("U4", "13"), ("U4", "20"), ("U4", "21"),
             ("U4", "23"), ("U4", "24"),
             ("U5", "1"), ("U6", "2"), ("U6", "3"), ("U6", "6"), ("U7", "2"), ("C_CAP2", "2"),
             ("R_DIV2", "2"), ("C4", "2"), ("R_BAL2", "2"),
             ("C_BULK", "2"), ("C_HF", "2"), ("D_CLAMP", "2"), ("R_MON2", "2"),
             ("C_MON", "2"),
             ("ANT1", "2"), ("ANT2", "2"), ("ANT3", "2"), ("ANT4", "2"),
             ("J_W1", "2"), ("J_W2", "2"), ("J_W3", "2"), ("J_W4", "2"),
             ("J_W4", "4"), ("D_BP4", "2"), ("TH_NTC1", "2")],
     "Ground. F33 GND pads 2,3,4,6,7,8,11; bare GND pads 2,8,11,12,18 "
     "(docs/DUAL-VARIANT-DESIGN.md). J_W1..J_W4 pin 2 are the four wing "
     "interfaces' GND lands: socket spec s3 makes each interface's GND land tie "
     "DIRECTLY to the hub ground plane and warns 'Do not tie any W<n>_SOLAR_N to "
     "GND except W4_SOLAR_N'. J_W4 pin 4 and D_BP4 pin 2 are that single "
     "exception: wing 4's SOLAR_N IS the 6.0 V stack bottom (ADR-046 s2.3 "
     "'stack_bot = W4.SOLAR_N -> system GND'). Wings 1-3 SOLAR_N are on the "
     "W1_SOLAR_N / W2_SOLAR_N / W3_SOLAR_N hub links, NOT here. "
     "OPEN-7 CLOSURE (2026-10-07): U6 pin 2 (PS) and U6 pin 6 (SDO) are "
     "tied to GND on the precedent of the frozen v8j MS5611 board "
     "(tracker/hardware/output/v8j_krt_ms5611.kicad_pcb) - the SAME "
     "Package_LGA:LGA-8_3x5mm_P1.25mm footprint, same I2C mode - which ties "
     "its pad 2 and pad 6 to GND."),
    ("VSCAP", [("D1", "1"), ("C_CAP1", "1"), ("U7", "1"), ("U7", "3"),
               ("R_DIV1", "1"), ("R_BAL1", "1"), ("J_VCC", "1")],
     "ADR-006 chain: BAT54 cathode -> supercap bank (top) -> TPS7A02 IN ->, for "
     "the F33, the pin-1 selector's raw, PRE-LDO position. U7 pin 3 (EN) sits on "
     "this net beside U7 pin 1 (IN) so the LDO is permanently on - decided by "
     "docs/coordination/SCHEMATIC-PLAN-3VARIANTS.md 5 item 4 and 6 items 7/14 "
     "('U3.EN tied to U3.VIN on the VBAT net'), and by the v8i board "
     "(U4 pad 3 = VCAP = pad 1)."),
    ("SCAP_MID", [("C_CAP1", "2"), ("C_CAP2", "1"), ("R_BAL1", "2"),
                  ("R_BAL2", "1")],
     "ADR-006 (Accepted): the SERIES mid-node of the 2x 3.3 F 2.7 V bank "
     "(1.65 F @ 5.4 V). This net was MISSING from the sheet: its absence put "
     "C_CAP2 straight across the rail (a 2.7 V-rated cap on a 5.4 V node) and "
     "left C_CAP1 pin 2 floating. R_BAL1/R_BAL2 (2x 10 kOhm, ADR-006) balance "
     "the two cells here."),
    ("W1_SOLAR_P", [("J_W1", "1"), ("D1", "2"), ("D_BP1", "1")],
     "ADR-046 s2.3 / socket spec s3.1: stack TOP = wing 1's solar POSITIVE "
     "terminal (W1_SOLAR_P) -> BAT54 (D1) -> supercap bank (ADR-006). This net "
     "carries the socket spec's W1_SOLAR_P LAND of wing interface 1; it is the "
     "v9 sheet's former 1-pad `SOLAR_IN` net (which had only the D1 anode end and "
     "was filed as OPEN-12 'solar input connector not in the component list'). "
     "It is now the whole 4-wing array input: the four wing interfaces ARE the "
     "solar source, so OPEN-12 is closed by ADR-048. It is renamed from SOLAR_IN "
     "to W1_SOLAR_P because that is the land net name the socket spec s3 fixes. "
     "D_BP1 pin 1 is its cathode: the bypass Schottky's cathode goes to the "
     "wing's SOLAR_P (ADR-046 s2.3)."),
    ("W1_SOLAR_N", [("J_W1", "4"), ("J_W2", "1"), ("D_BP1", "2"), ("D_BP2", "1")],
     "ADR-046 s2.3 / socket spec s3.1: the first HUB LINK. ADR-046 s2.3 mandates "
     "`W1.SOLAR_N == W2.SOLAR_P (hub link)`, so this is ONE electrical node: it "
     "carries wing interface 1's SOLAR_N land (socket spec net name "
     "`W1_SOLAR_N`) AND wing interface 2's SOLAR_P land (socket spec net name "
     "`W2_SOLAR_P`). The node is named after the first of the pair; the "
     "land-to-node mapping for all 8 spec land names is tabulated in "
     "docs/adr/048-v9-hub-wing-interfaces.md. D_BP1 pin 2 (anode) and D_BP2 pin "
     "1 (cathode) sit across wings 1 and 2 respectively (socket spec s5)."),
    ("W2_SOLAR_N", [("J_W2", "4"), ("J_W3", "1"), ("D_BP2", "2"), ("D_BP3", "1")],
     "ADR-046 s2.3 / socket spec s3.1: the second HUB LINK - `W2.SOLAR_N == "
     "W3.SOLAR_P` is one electrical node carrying wing interface 2's SOLAR_N "
     "land and wing interface 3's SOLAR_P land (socket spec land net names "
     "W2_SOLAR_N and W3_SOLAR_P). D_BP2 anode / D_BP3 cathode."),
    ("W3_SOLAR_N", [("J_W3", "4"), ("J_W4", "1"), ("D_BP3", "2"), ("D_BP4", "1")],
     "ADR-046 s2.3 / socket spec s3.1: the third HUB LINK - `W3.SOLAR_N == "
     "W4.SOLAR_P` is one electrical node carrying wing interface 3's SOLAR_N "
     "land and wing interface 4's SOLAR_P land (socket spec land net names "
     "W3_SOLAR_N and W4_SOLAR_P). D_BP3 anode / D_BP4 cathode."),
    ("F33_VCC", [("J_VCC", "2"), ("U2", "1"), ("C_BULK", "1"), ("C_HF", "1"),
                 ("D_CLAMP", "1"), ("R_MON1", "1")],
     "ADR-044 option (a) + ADR-047 2: the F33's pin 1 VCC. Fed from the RAW "
     "supercap node PRE-LDO through the ADR-029 D8 pin-1 selector. It must NEVER "
     "be fed through the TPS7A02: that LDO is rated <=300 mA (ADR-006) / 200 mA "
     "(KiCad Regulator_Linear:TPS7A0533PDBV) against the F33's 1118 mA - a "
     "3.7x-5.6x overload and a hard failure, not a hypothesis (ADR-047 2.3)."),
    ("F33_VSENSE", [("R_MON1", "2"), ("R_MON2", "1"), ("C_MON", "1"),
                    ("U1", "21")],
     "ADR-047 6: F33 rail monitor. Divider ratio 0.5 (4.7 M / 4.7 M) -> "
     "5.4 V reads 2.70 V at ESP32-S3 IO13 (U1 pin 21). Firmware must inhibit TX "
     "below the LOADED-rail threshold for the wanted output power: >=5.0 V for "
     "the full 33.0 dBm, and >=3.54 V (interpolated) + the bank\'s ESR step for "
     "+30 dBm. See OPEN-17 for the ADC-channel TODO."),
    ("GNSS_VCC", [("R_F1", "2"), ("C4", "1"), ("U5", "8")],
     "ADR-029 2(d): the FILTERED GNSS rail - 'a dedicated RC/ferrite feed (e.g. "
     "100 Ohm + 10 uF) from 3V3 into the GNSS rail'. The MAX-M10S is a 3.3 V "
     "part, so this net must NOT hang off the 5.4 V cap node; R_F1.1 is on "
     "+3V3. Fixes a sheet defect in which R_F1.1 appeared in BOTH the +3V3 and "
     "VSCAP net lists and R_F1 pin 2 was floating."),
    ("F33_SCK", [("U1", "4"), ("U2", "12"), ("U3", "5")],
     "SPI2 FSPI SCK on GPIO4; the bare module shares SPI2 data/clock "
     "(V9-RADIO-SITE-MATRIX 3.1)."),
    ("F33_MOSI", [("U1", "5"), ("U2", "15"), ("U3", "4")],
     "SPI2 MOSI on GPIO5 (shared, see 3.1)."),
    ("F33_MISO", [("U1", "6"), ("U2", "16"), ("U3", "3")],
     "SPI2 MISO on GPIO6 (SHARED bus - see 3.1). Both slave MISO pins are typed "
     "tri_state because an SPI slave only drives MISO while its own CS is "
     "asserted; the shared data/clock bus is the landed decision in "
     "docs/V9-RADIO-SITE-MATRIX.md 3.1 ('{HP+LP} ... +4 GPIO (shared bus) ... "
     "share SPI data/clock', citing docs/V9-DUAL-LR-DESIGN-MEMO.md 5). Typing "
     "them 'output' (as they were) produced a false pin_to_pin ERC error; the "
     "pin TYPE is corrected here, no connectivity is changed."),
    ("F33_CS_N", [("U1", "7"), ("U2", "13")],
     "F33 NSS on GPIO7 (ADR-029 pin plan, unique CS)."),
    ("F33_BUSY", [("U1", "12"), ("U2", "14")],
     "F33 BUSY polled by GPIO8 (ADR-029 D4 hardware BUSY binding)."),
    ("F33_IRQ", [("U1", "17"), ("U2", "18")],
     "F33 IRQ/DIO1 on GPIO9 (ADR-029 pin plan)."),
    ("F33_RESET_N", [("U1", "18"), ("U2", "17")],
     "F33 RESET on GPIO10 (ADR-029 pin plan)."),
    # U4's pin numbers below are the REAL SX1280 pad numbers (Table 2-1).  They were 4/5/6/7/8/
    # 9/10/11/12 in the placeholder table, and the numbers moved with the pinout: leaving them
    # would re-create the 7 dead connections this card removes (CS_N driving NRESET, MOSI driving
    # XTA, DIO1 shorted to GND, ...).  SX1280_ANT_SW is GONE: the real part has no ANT_SW pin
    # (removed from the sheet in commit 96d219b3, operator-confirmed).
    ("SX1280_SCK", [("U1", "22"), ("U4", "18")],
     "SPI3 clock on GPIO14 (ADR-029 pin plan). U4 pad 18 = SCK_RTSN (real pinout)."),
    ("SX1280_MOSI", [("U1", "8"), ("U4", "17")],
     "SPI3 MOSI on GPIO15 (ADR-029 pin plan). U4 pad 17 = MOSI_RX."),
    ("SX1280_MISO", [("U1", "9"), ("U4", "16")],
     "SPI3 MISO on GPIO16 (ADR-029 pin plan). U4 pad 16 = MISO_TX."),
    ("SX1280_CS_N", [("U1", "10"), ("U4", "19")],
     "SPI3 CS on GPIO17 (ADR-029 pin plan). U4 pad 19 = NSS_CTS."),
    ("SX1280_BUSY", [("U1", "31"), ("U4", "7")],
     "SX1280 BUSY on GPIO38 (ADR-029 pin plan). U4 pad 7 = BUSY."),
    ("SX1280_RESET_N", [("U1", "32"), ("U4", "3")],
     "SX1280 RESET on GPIO39 - native JTAG MTCK lost (ADR-029 pin plan, "
     "explicit trade-off). U4 pad 3 = NRESET."),
    ("SX1280_DIO1", [("U1", "33"), ("U4", "8")],
     "SX1280 DIO1/IRQ on GPIO40 - native MTDO/JTAG lost (pin plan). U4 pad 8 = DIO1."),
    ("SX1280_DIO2", [("U1", "11"), ("U4", "9")],
     "SX1280 DIO2 on GPIO18 (pin plan, optional function). U4 pad 9 = DIO2."),
    ("SX1280_DIO3", [("U1", "34"), ("U4", "10")],
     "SX1280 DIO3 on GPIO41 - native MTDI/JTAG lost (pin plan). U4 pad 10 = DIO3."),
    ("GNSS_PPS", [("U1", "23"), ("U5", "4")],
     "MAX-M10S TIMEPULSE/PPS on GPIO21 (ADR-029 pin plan)."),
    ("GNSS_TX", [("U1", "36"), ("U5", "2")],
     "MAX-M10S TXD -> S3 RXD0/GPIO43 (pin plan; console mux is a firmware "
     "policy)."),
    ("GNSS_RX", [("U1", "37"), ("U5", "3")],
     "MAX-M10S RXD <- S3 TXD0/GPIO44 (pin plan)."),
    ("I2C_SDA", [("U1", "39"), ("U6", "7")],
     "MS5611 SDI/SDA on GPIO1, external pull-up to 3V3 required (pin plan)."),
    ("I2C_SCL", [("U1", "38"), ("U6", "8")],
     "MS5611 SCLK/SCL on GPIO2, external pull-up to 3V3 required (pin plan)."),
    ("SCAP_ADC", [("R_DIV1", "2"), ("R_DIV2", "1")],
     "ADR-006 supercap ADC divider tap. The ADC GPIO is UNRESOLVED: ADR-006 "
     "says GPIO0, the ADR-029 pin plan reserves IO0 as a boot strap."),
    ("ANT1_433_TX", [("U2", "9"), ("ANT1", "1")],
     "ADR-034 D1/D2 + ADR-029 D3: 433 MHz TX, F33 sub-GHz ANT."),
    ("ANT2_2G4_RANGE", [("U4", "22"), ("ANT2", "1")],
     "ADR-108 Revision R1 (2026-10-07) CLOSES OPEN-2. ANT2 is re-pointed "
     "from the F33 2.4 GHz port to the SX1280 RFIO. ADR-029 D2b/D3 "
     "enumerated FOUR connectors (GNSS L1, F33 sub-GHz, F33 ANT-2G4, "
     "SX1280); ADR-034 D1/D5 then re-pointed the 2.4 GHz link RX at a "
     "SEPARATE bare LoRa2021 and states plainly that the F33 carries TX "
     "ONLY. So of the five candidate feeds exactly one has no role - the "
     "F33 ANT-2G4 port - and the SX1280, an operator-RATIFIED radio "
     "(ADR-029 D2b, 2026-10-05) that the TDM schedule gives its own slot "
     "(ADR-035), needs a feed. One U.FL site is the only currency "
     "available, so ANT2 serves the SX1280 and U2 pin 10 becomes an "
     "explicit no-connect. The count is settled at FOUR feeds for the FOUR "
     "RF parts of ADR-034 D5 (433 TX, 2.4 ranging, 2.4 RX, GNSS L1) "
     "against the four U.FL sites ANT1..ANT4 actually drawn, and the two "
     "2.4 GHz-capable feeds stay SEPARATE as ADR-029 D3 requires (ANT2 "
     "ranging, ANT3 link RX; never co-polarised within lambda/2). Antennas "
     "are hub-side wire dipoles per ADR-009, so a wing cut costs no comms. "
     "The SX1280 RFIO pad number (14) is still ADR-045 D1 OPEN-13-"
     "TODO(unverified) - the net is named, the pad number is not proven."),
    ("ANT3_2G4_RX", [("U3", "10"), ("ANT3", "1")],
     "ADR-034 D1: bare LoRa2021 2.4 GHz feed."),
    ("ANT4_GNSS_L1", [("U5", "11"), ("ANT4", "1")],
     "ADR-029 D3: MAX-M10S RF_IN -> GNSS L1 U.FL."),
    # --- ADR-108 Revision R1: the bare-module control lines (OPEN-3/OPEN-14) ---
    # The +4 GPIO budget of docs/V9-RADIO-SITE-MATRIX.md 3.1 (CS + BUSY +
    # RESET + IRQ/DIO, shared SPI data/clock) is spent on the only four
    # ESP32-S3 GPIOs that are free after the straps (IO0/IO3/IO45/IO46, ADR-108
    # strapping audit), the octal-PSRAM pins (IO35/36/37, -N8R8) and the USB
    # console (IO19/IO20): IO11, IO12, IO47, IO48. IO11 is free because the
    # F33 has NO DIO5 pad (OPEN-6), and its ENABLE routing is the one the
    # reference supplies; IO12/IO47/IO48 are the three pins OPEN-14 recorded
    # as unassigned. Spending all four here is the documented consequence:
    # no free GPIO remains, so OPEN-25 cut-sense must multiplex (ADR-051 2.6).
    ("U3_CS_N", [("U1", "20"), ("U3", "6")],
     "ADR-108 Revision R1 CLOSES OPEN-3: bare LoRa2021 NSS (pad 6) on "
     "IO12 (U1 pin 20), the first of the +4 GPIO budget in "
     "docs/V9-RADIO-SITE-MATRIX.md 3.1 and ADR-040 D2. U3 shares the SPI2 SCK/MOSI/MISO "
     "data and clock with the F33 (F33_SCK/F33_MOSI/F33_MISO) and needs its own chip select "
     "because SPI2 has two slaves. CLOSES the U1.20 half of OPEN-14."),
    ("U3_BUSY", [("U1", "24"), ("U3", "7")],
     "ADR-108 Revision R1 CLOSES OPEN-3: bare LoRa2021 BUSY (pad 7) on "
     "IO47 (U1 pin 24) - the arbiter reads BUSY by GPIO without driver "
     "cooperation (ADR-029 D4 R3). CLOSES the U1.24 half of OPEN-14."),
    ("U3_RESET_N", [("U1", "25"), ("U3", "14")],
     "ADR-108 Revision R1 CLOSES OPEN-3: bare LoRa2021 RESET (pad 14) on "
     "IO48 (U1 pin 25). CLOSES the U1.25 half of OPEN-14."),
    ("U3_IRQ", [("U1", "19"), ("U3", "15")],
     "ADR-108 Revision R1 CLOSES OPEN-3: bare LoRa2021 IRQ/DIO9 (pad 15, "
     "the vendor pin table name in docs/assets/lr2021/"
     "LoRa2021-Module-Datasheet-V1.3.pdf s7) on IO11 (U1 pin 19). IO11 was "
     "assigned to F33_DIO5 in the original pin plan; OPEN-6 established the "
     "F33 has NO DIO5 pad (all 18 pads enumerated, the front-end DIOs are "
     "internal) and freed IO11 for exactly this kind of re-assignment. That "
     "makes four control lines for the second radio - the +4 of "
     "docs/V9-RADIO-SITE-MATRIX.md 3.1 - and it removes the F33_DIO5 "
     "no-connect from V9_NC."),
    # --- ADR-058: the LR2021 on-chip NTC temperature-compensation provision. ---
    ("VTCXO_VNTC", [("U3", "13"), ("R_NTC1", "1")],
     "ADR-058 D1: the VTCXO/VNTC bias rail of the on-chip temperature-"
     "compensation divider, taken from the bare module's pad 13 = VTCXO (vendor "
     "pin table docs/assets/lr2021/LoRa2021-Module-Datasheet-V1.3.pdf s7: "
     "'Can provide power for an external TCXO'). DS 2.2 Table 2-1 names the chip "
     "pin it carries, pin 6 = VTCXO/VNTC, 'External TCXO supply voltage "
     "(REG_TCXO) / NTC supply'; DS 2.2 s1.9.2 says this pin 'can be used to power "
     "an external temperature sensor (R and NTC)'. R_NTC1 pin 1 sits on it - the "
     "divider is the only load here, a microwatt fraction of the regulator's "
     "ILTCXO 1.5 mA typ / 4 mA max (DS 2.2 Table 3-25). NO PWR_FLAG is implied: "
     "the net carries passive pins only."),
    ("NTC_SENSE", [("R_NTC1", "2"), ("TH_NTC1", "1")],
     "ADR-058 D1/D6: the divider's midpoint - THE NORMAL SENSE NODE that the "
     "chip's NTC input (chip pin 3, DS 2.2 Table 2-1 'Negative Temperature "
     "Coefficient (NTC) resistor connection') is meant to read. It is a "
     "DELIBERATELY OPEN LOOP on the owned bare module: the chip's NTC pin is NOT "
     "broken out on the NiceRF module's 18 castellations (the vendor pin table "
     "enumerates all 18 pads and the only oscillator pad is 13 = VTCXO; module "
     "pad 3 is MISO), so this node has no path back to the chip. The parts are "
     "DNP for exactly that reason and the node is left as the two-part divider "
     "node rather than given an invented chip-side net. A module that DOES break "
     "the pin out closes the loop here - see OPEN-29."),
]

# --- ADR-051 §2.1: the hub array's OWN nets, and the cut-sense lines. --------
# These nets carry the hub string and NOTHING ELSE: no W<n>_SOLAR_P and no
# W<n>_SOLAR_N land appears on any HUB_PV_* net, and the only node the hub
# string shares with the wing system is GND (through U_HUB_CVT pin 2).  That is
# the whole invariant ADR-051 §2.1 exists to protect - a hub array in series
# with, or tapped onto, the wing chain dies on the first cut, which turns the
# cut into suicide.  scripts/hub_array_topology_check.py is the mechanical
# enforcement (R3/R3b/R4/R5/R7).
V9_NETS.append(
    ("HUB_PV_P",
     [("PVA1", "1"), ("D_HUB1", "1"), ("U_HUB_CVT", "1")],
     "ADR-051 §2.1.1: the hub string's POSITIVE terminal and its own converter "
     "input node. Feeds U_HUB_CVT pin 1 - the hub array's OWN harvester/converter "
     "input, never the wing chain's BAT54/supercap node. D_HUB1 pin 1 is the "
     "first hub cell's bypass cathode."))
for _k in range(1, V9_HUB_ARRAY_CELLS):
    V9_NETS.append(
        ("HUB_PV_MID%d" % _k,
         [("PVA%d" % _k, "2"), ("PVA%d" % (_k + 1), "1"),
          ("D_HUB%d" % _k, "2"), ("D_HUB%d" % (_k + 1), "1")],
         "ADR-051 §2.1.1: interior node %d of the hub series string (between "
         "hub cells %d and %d). It is INTERNAL to the hub array: it carries no "
         "wing land, and sharing it with the wing chain is exactly the tap the "
         "topology checker fails on (R4)." % (_k, _k, _k + 1)))
V9_NETS.append(
    ("HUB_PV_N",
     [("PVA%d" % V9_HUB_ARRAY_CELLS, "2"),
      ("D_HUB%d" % V9_HUB_ARRAY_CELLS, "2"), ("U_HUB_CVT", "3")],
     "ADR-051 §2.1.1: the hub string's NEGATIVE terminal, wired to the hub "
     "converter\'s own PV_N input (U_HUB_CVT pin 3) and to the last hub cell's "
     "bypass anode. It carries NO wing land: the only node the hub string "
     "shares with the wing system is GND, and that is through the converter\'s "
     "ground pin, not through a W<n>_SOLAR_N land. (ADR-051 §2.1.2.)"))

for _i in range(1, 5):
    V9_NETS.append(
        ("CUT_SENSE_W%d" % _i,
         [("J_W%d" % _i, "3"), ("U_CUT%d" % _i, "3")],
         "ADR-051 §2.6: the per-wing cut-sense / cutter line on the wing "
         "tab's RESERVED pin 3 (RF_FEED). Netting it CLOSES the four "
         "pin_not_connected ERC errors the unnetted provision produced, at "
         "zero connector cost - the land and the position were already paid "
         "for. Honest caveat: on the v9 WING, RF_FEED is a copper land with no "
         "net, so the continuity measurement only becomes meaningful once the "
         "wing is re-spun to tie RF_FEED into the cut loop\'s return (OPEN-25, "
         "ADR-051 §2.6 caveat + §4 item 9)."))

# --- ADR-051: the new hub-array / cut-channel components' power and ground pins.
# Their OWN nets are appended above; the two SHARED rails are extended here so
# every added pin lands on the same node the rest of the sheet already uses.
# This is deliberate: a new component with an unnetted pin would ADD a
# pin_not_connected ERC error, and the point of netting the RF_FEED lands is to
# CLOSE errors, not trade them.
_GND_EXTRA = [("U_HUB_CVT", "2")] + [("U_CUT%d" % _i, "2") for _i in range(1, 5)]
_VSCAP_EXTRA = [("U_CUT%d" % _i, "1") for _i in range(1, 5)]
for _idx, (_n, _nodes, _src) in enumerate(V9_NETS):
    if _n == "GND":
        V9_NETS[_idx] = (_n, list(_nodes) + _GND_EXTRA,
                         _src + " ADR-051: this net also carries the hub "
                         "converter's ground pin (U_HUB_CVT.2) and the four "
                         "latched cut channels' ground pins (U_CUT1..4.2) - it is "
                         "the ONE node the hub string shares with the wing system.")
    elif _n == "VSCAP":
        V9_NETS[_idx] = (_n, list(_nodes) + _VSCAP_EXTRA,
                         _src + " ADR-051 s2.5: this net is also the cut "
                         "channels' drive rail (U_CUT1..4.1) - VSCAP is the raw "
                         "supercap node, post-BAT54 and PRE-LDO, so a cut still "
                         "works with the converter dead (ADR-047 s2.1).")

# --- deliberately unconnected pins, each with the record that says so ------
V9_NC = [
    ("U1", "27", "IO0 boot strap: no radio pull-up/CS (ADR-029 pin plan, "
                 "strapping audit)."),
    ("U1", "15", "IO3 boot strap: no sensor/radio connection (pin plan)."),
    ("U1", "26", "IO45 boot strap: vendor strap level, no external load (pin plan)."),
    ("U1", "16", "IO46 boot strap: vendor strap level, no external load (pin plan)."),
    ("U1", "28", "IO35 = octal-PSRAM connection on -N8R8, not a board GPIO "
                 "(ADR-029 D1.1 / pin plan)."),
    ("U1", "29", "IO36 = octal-PSRAM connection (ADR-029 D1.1 / pin plan)."),
    ("U1", "30", "IO37 = octal-PSRAM connection (ADR-029 D1.1 / pin plan)."),
    ("U5", "5", "MAX-M10S EXTINT unused (carried from the v8i board audit)."),
    ("U5", "13", "MAX-M10S LNA_EN unused (v8i board audit)."),
    ("U5", "14", "MAX-M10S VCC_RF unused (v8i board audit)."),
    ("U5", "16", "MAX-M10S SDA unused - v9 GNSS is UART, not I2C (v8i audit)."),
    ("U5", "17", "MAX-M10S SCL unused - v9 GNSS is UART, not I2C (v8i audit)."),
    ("U2", "10", "F33 ANT-2G4 port RETIRED. ADR-034 D5: 'the F33 carries "
                 "TX only' - its pin-9 sub-GHz port is the 433 MHz TX, and "
                 "the 2.4 GHz link RX was re-pointed at the bare LoRa2021 "
                 "(ADR-034 D1). With only four U.FL sites, ANT2 goes to the "
                 "SX1280 ranging radio (ADR-108 Revision R1, OPEN-2) and this "
                 "port has no destination. Not equipped, not a stub: no "
                 "matching network is fitted either (ADR-029 D8 item 2 - DNP "
                 "pads, never open stubs)."),
    ("U3", "9", "Bare LoRa2021 sub-GHz ANT (pad 9) is unused in EVERY "
                 "documented population configuration. ADR-034 D1 puts the "
                 "433 MHz TX on the Site-A module (whose pad 9 shares the "
                 "F33 land - ADR-040 D1 nested pad field - and therefore "
                 "reaches ANT1), and Site B is the LP-only 2.4 GHz RX site "
                 "(ADR-040 D1/D2, docs/V9-RADIO-SITE-MATRIX.md 3.3/3.4). "
                 "In {HP} Site B is DNP. So this port is not 'unconditionally "
                 "unused by reflex' - it is unused because in all four "
                 "configurations the TX role sits on the Site-A module. "
                 "CLOSES OPEN-4; a future re-point would need a fifth feed."),
    ("U3", "16", "Bare LoRa2021 DIO8 (vendor pin table, "
                 "docs/assets/lr2021/LoRa2021-Module-Datasheet-V1.3.pdf s7). "
                 "The LR2021 DIO5-8 are the RF FRONT-END control lines "
                 "(docs/LR2021-LESSONS-2026-09.md), and this module has NO "
                 "front end: the bare NiceRF LoRa2021 is chip-only (needs an "
                 "external FEM for a 2.4 GHz PA, docs/F33-MODULE-PLAN.md) and "
                 "ADR-034 D1 item 2 deliberately leaves the airborne 2.4 GHz "
                 "RX unamplified. Nothing to control, and no GPIO left. "
                 "CLOSES OPEN-5."),
    ("U3", "17", "Bare LoRa2021 DIO7 (vendor pin table s7) - same reasoning "
                 "as pad 16: a front-end control line on a module with no "
                 "front end. CLOSES OPEN-5."),
    ("U5", "15", "MAX-M10S VIO_SEL is LEFT OPEN by its own datasheet. u-blox "
                 "MAX-M10S datasheet UBX-20035208-R08 Table 10, pin 15: "
                 "'Voltage selector for V_IO supply. Connect to GND for 1.8 V "
                 "supply, or leave open for 3.3 V supply.' The v9 GNSS IO "
                 "supply U5 pin 7 (V_IO) is +3V3, so 3.3 V is the correct "
                 "range and the pin must stay open. Tying it to GND would "
                 "select the 1.8 V range and put 3.3 V on a pin whose "
                 "absolute maximum in that state is 1.98 V (Table 12). The "
                 "frozen v8i board's netless pad 15 is therefore CORRECT, not "
                 "a recorded gap. CLOSES OPEN-8."),
    ("U5", "18", "MAX-M10S SAFEBOOT_N is LEFT OPEN by its own datasheet. "
                 "UBX-20035208-R08 Table 10, pin 18: 'Safeboot mode (active "
                 "low). Leave open if not used.' (footnote 15: the pin is "
                 "internally tied to TIMEPULSE through a 1 kOhm series "
                 "resistor and has its own pull-up, Table 12 Rpu). Safeboot "
                 "is a recovery mode; the v9 receiver runs in continuous "
                 "mode. CLOSES OPEN-8."),
    ("U7", "4", "TPS7A02 pin 4 is NC ON THE PART. TI datasheet SBVS277C "
                 "(Rev C) Table 5-1 / Figure 5-2, DBV (SOT-23, 5): pin 1 IN, "
                 "pin 2 GND, pin 3 EN, pin 4 NC ('No connect pin. This pin is "
                 "not internally connected. Connect to ground or leave "
                 "floating.'), pin 5 OUT. The sheet symbol's own 'NC' label "
                 "is RIGHT; the frozen boards are wrong to tie pad 4 to +3V3 "
                 "(v8i/v8j/v8b/v8c/v8f) - harmless because the pad is not "
                 "internally connected, but it is not what the datasheet asks "
                 "for, so it is NOT adopted; hub_board_v1_clean (pad 5 = OUT) "
                 "has the correct pin map and confirms this reading. CLOSES "
                 "OPEN-9."),
]
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
