c03rad0r/balloon-fresh-1/tracker/hardware/fix_vialess_gnd.py

"""Fix the two via-less GND fragments (D12). Astra: "Do not order with these. Fix those first."

TWO REAL ELECTRICAL DEFECTS:
  U4.13        (SX1280 GND, declared GND in the netlist) sits in a 0.278 mm2 F.Cu pour with no via.
  U_HUB_CVT.2  (BQ25504 GND, declared GND) sits in a 0.445 mm2 F.Cu pour with no via.
Neither fragment can hold a via: U4.13's is 0.298 mm tall, and a 0.50 mm via has a 0.90 mm envelope.

THE ROOT CAUSE OF U4.13 (measured, see docs/fab/D12-VIALESS-GND-FRAGMENTS.md):
  U4's right column is 9 pads at 0.500 mm pitch with 0.300 mm pad height, so the edge-to-edge gap between
  every adjacent pair is 0.200 mm = exactly the clearance rule. The GND escape must therefore run inside
  y 27.200..27.300 -- a 0.100 mm window. /SX1280_VDD's diagonal (55.650,27.750)->(56.300,27.100) crosses
  y=27.25 at x~56.0 and is the ONLY thing blocking it.

WHY MOVING VDD IS SAFE: /SX1280_VDD has two pads on U4 (pad 2 at 50.350,26.000 and pad 12 at
55.150,27.750) which are ALREADY joined through In1.Cu, so the F.Cu diagonal from pad 12 to the via at
(56.300,26.450) may be rerouted above the GND corridor without disconnecting anything.

WHAT THIS SCRIPT DOES, in order:
  1. rips the one VDD diagonal and replaces it with an L that stays north of y=27.40
  2. routes a GND track out of U4.13 along y=27.250 to the nearest validated GND via
  3. routes a GND track from U_HUB_CVT.2 to the GND via at (26.100,5.800)
  4. refills zones
Every step is a measured, dry-runnable plan; --apply writes the board.

Does NOT touch In1.Cu island 1 (Astra: add stitching vias there, do NOT reroute +3V3).
Does NOT touch the three signal nets already routed.
"""
from __future__ import annotations

import argparse
import heapq
import math
import sys

import pcbnew

UM = 1_000_000.0
R_TR = 0.100          # 0.20 mm track
CLR = 0.200
NODE = 0.05
VIA_D = 0.50
VIA_R = VIA_D / 2.0
VIA_SPACING = 0.800   # 0.500 dia + 0.200 clearance between two vias


def segd(px, py, x1, y1, x2, y2):
    dx, dy = x2 - x1, y2 - y1
    if dx == 0 and dy == 0:
        return math.hypot(px - x1, py - y1)
    t = max(0.0, min(1.0, ((px - x1) * dx + (py - y1) * dy) / (dx * dx + dy * dy)))
    return math.hypot(px - (x1 + t * dx), py - (y1 + t * dy))


class World:
    def __init__(self, board):
        self.b = board
        self.gnd = board.FindNet("GND").GetNetCode()
        self.trk = {"F.Cu": [], "In1.Cu": [], "In2.Cu": [], "B.Cu": []}
        self.vias = []        # (x, y, r) all-layer, non-GND
        self.pads = []        # (x, y, w, h, layers) non-GND
        self.gnd_vias = []
        for t in board.GetTracks():
            if t.GetNetCode() == self.gnd:
                if t.Type() == pcbnew.PCB_VIA_T:
                    p = t.GetPosition()
                    self.gnd_vias.append((p.x / UM, p.y / UM))
                continue
            if t.Type() == pcbnew.PCB_VIA_T:
                p = t.GetPosition()
                self.vias.append((p.x / UM, p.y / UM, t.GetWidth(pcbnew.F_Cu) / 2 / UM))
            elif t.Type() == pcbnew.PCB_TRACE_T:
                s, e = t.GetStart(), t.GetEnd()
                ln = board.GetLayerName(t.GetLayer())
                self.trk.setdefault(ln, []).append(
                    (s.x / UM, s.y / UM, e.x / UM, e.y / UM, t.GetWidth() / 2 / UM, str(t.GetNetname())))
        for fp in board.GetFootprints():
            for p in fp.Pads():
                if p.GetNetCode() == self.gnd:
                    continue
                pos = p.GetPosition()
                self.pads.append((pos.x / UM, pos.y / UM, p.GetSize().x / UM, p.GetSize().y / UM,
                                  [board.GetLayerName(l) for l in p.GetLayerSet().Seq()],
                                  fp.GetReference() + "." + str(p.GetNumber()), str(p.GetNetname())))

    def clr_track(self, x, y, layer, ignore_nets=(), radius=R_TR):
        """Clearance for a TRACK on ONE layer. Tracks on other layers do not obstruct."""
        worst = (1e9, None)
        for x1, y1, x2, y2, rr, nm in self.trk.get(layer, []):
            if nm in ignore_nets:
                continue
            d = segd(x, y, x1, y1, x2, y2) - rr - radius
            if d < worst[0]:
                worst = (d, "trk " + nm)
        for vx, vy, rr in self.vias:
            d = math.hypot(x - vx, y - vy) - rr - radius
            if d < worst[0]:
                worst = (d, "via")
        for px, py, ww, hh, layers, nm, pnet in self.pads:
            if layer not in layers:
                continue
            if pnet in ignore_nets:
                continue
            dx = max(px - ww / 2 - x, 0.0, x - (px + ww / 2))
            dy = max(py - hh / 2 - y, 0.0, y - (py + hh / 2))
            d = math.hypot(dx, dy) - radius
            if d < worst[0]:
                worst = (d, "pad " + nm)
        return worst

    def clr_via(self, x, y, ignore_nets=()):
        """A via pierces every layer: worst of all four, plus via-to-via spacing."""
        worst = (1e9, None)
        for ln in ("F.Cu", "In1.Cu", "In2.Cu", "B.Cu"):
            c = self.clr_track(x, y, ln, ignore_nets, radius=VIA_R)
            if c[0] < worst[0]:
                worst = c
        for gx, gy in self.gnd_vias:
            d = math.hypot(x - gx, y - gy) - VIA_SPACING
            if d < worst[0]:
                worst = (d, "other GND via")
        return worst


def astar(world, start, goals, layer, ignore_nets=(), bounds=None):
    """Grid A* on ONE layer. Returns a list of points, or None."""
    sx, sy = start
    gkeys = {(round(g[0] / NODE), round(g[1] / NODE)) for g in goals}
    if bounds is None:
        xs = [sx] + [g[0] for g in goals]
        ys = [sy] + [g[1] for g in goals]
        bounds = (min(xs) - 6, min(ys) - 6, max(xs) + 6, max(ys) + 6)
    bx0, by0, bx1, by1 = bounds

    def near(g):
        return math.hypot(g[0] - sx, g[1] - sy)

    best = min(goals, key=near)
    openh = [(math.hypot(best[0] - sx, best[1] - sy), 0.0, sx, sy)]
    seen = {(round(sx / NODE), round(sy / NODE)): 0.0}
    parent = {}
    steps = ((NODE, 0), (-NODE, 0), (0, NODE), (0, -NODE),
             (NODE, NODE), (-NODE, NODE), (NODE, -NODE), (-NODE, -NODE))
    while openh:
        f, g, x, y = heapq.heappop(openh)
        k = (round(x / NODE), round(y / NODE))
        if k in gkeys:
            path = [(x, y)]
            while k in parent:
                k = parent[k]
                path.append((k[0] * NODE, k[1] * NODE))
            return path[::-1]
        for dx, dy in steps:
            nx, ny = x + dx, y + dy
            if not (bx0 <= nx <= bx1 and by0 <= ny <= by1):
                continue
            nk = (round(nx / NODE), round(ny / NODE))
            ng = g + math.hypot(dx, dy)
            if nk in seen and seen[nk] <= ng:
                continue
            if world.clr_track(nx, ny, layer, ignore_nets)[0] < CLR:
                continue
            seen[nk] = ng
            parent[nk] = k
            heapq.heappush(openh, (ng + math.hypot(best[0] - nx, best[1] - ny), ng, nx, ny))
    return None


def simplify(pts):
    if len(pts) < 3:
        return pts
    out = [pts[0]]
    for i in range(1, len(pts) - 1):
        ax, ay = out[-1]
        bx, by = pts[i]
        cx, cy = pts[i + 1]
        cross = (bx - ax) * (cy - ay) - (by - ay) * (cx - ax)
        if abs(cross) > 1e-9:
            out.append(pts[i])
    out.append(pts[-1])
    return out


def plane_polys(board):
    d = {}
    for z in board.Zones():
        ln = board.GetLayerName(z.GetLayer())
        poly = z.GetFilledPolysList(z.GetLayer())
        arr = []
        for i in range(poly.OutlineCount()):
            ol = poly.Outline(i)
            pts = [(ol.CPoint(k).x / UM, ol.CPoint(k).y / UM) for k in range(ol.PointCount())]
            a = 0.0
            for k in range(len(pts)):
                x1, y1 = pts[k]
                x2, y2 = pts[(k + 1) % len(pts)]
                a += x1 * y2 - x2 * y1
            arr.append((abs(a) / 2, pts))
        arr.sort(key=lambda t: -t[0])
        d[ln] = arr
    return d


def inside(pts, x, y):
    ins = False
    n = len(pts)
    for i in range(n):
        x1, y1 = pts[i]
        x2, y2 = pts[(i + 1) % n]
        if (y1 > y) != (y2 > y):
            xin = x1 + (y - y1) * (x2 - x1) / (y2 - y1)
            if x < xin:
                ins = not ins
    return ins
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
