c03rad0r/balloon-fresh-1/tracker/hardware/fcu_escape_feasibility.py

#!/usr/bin/env python3
"""F.Cu ESCAPE FEASIBILITY MAP for the four unrouted SX1280 pads on hub_board_v9.

This is a MEASUREMENT, not a router. It answers one question per pad:

    can the pad's own copper reach open board area, DRC-legally, at the
    board's own rules -- and if not, which rule binds and by how much?

It does NOT choose a route, does NOT write the board, and does NOT claim that
"reachable" means "routable to the destination". See the CANNOT-CONCLUDE
section of docs/fab/FCU-ESCAPE-FEASIBILITY.md.

Why this file exists
--------------------
tracker/hardware/pad_reachability.py (worktree wing-fix) printed

    => PAD ESCAPE CLEAR (nearest 0.970 mm >= 0.300 mm)

while labelling four obstacles [BLOCKING] at 0.970/1.260/1.312/1.810 mm. Three
independent defects caused that contradiction:

  D1  UNIT MISMATCH. It compared `d` (millimetres) against `need * UM`
      (nanometres), so `d < need*UM` was true for *every* obstacle and every
      one printed [BLOCKING]. Line:
          blocked = "BLOCKING" if d < need * UM else "clear"
  D2  WRONG THRESHOLD. `need = track_w/2 + clearance` (0.300 mm) is the
      clearance a *trace centreline* needs. A *pad* escapes from its own edge,
      so the threshold is the pad half-diagonal + clearance (1.0746 mm for a
      1.50x0.90 pad), not 0.300 mm.
  D3  WRONG LAYER. It only collected B.Cu obstacles, but all four pads are
      F.Cu-only SMD. B.Cu obstacles are not reachable from the pad without a
      via, so that measurement describes a layer the pad cannot touch.

Every threshold in this file is computed from the object whose escape is being
judged, and `self_check()` refuses to print a verdict that disagrees with the
obstacle data that produced it.

Reproduce
---------
    ~/venvs/kicad/bin/python tracker/hardware/fcu_escape_feasibility.py

`pcbnew` exists only in that interpreter. BOARD_DESIGN_SETTINGS has no
GetDefault() in KiCad 9, so rules are read from m_MinClearance /
GetSmallestClearanceValue() / the current tool sizes.
"""

from __future__ import annotations

import math
import sys

import pcbnew

BOARD = "tracker/hardware/hub_board_v9.kicad_pcb"
U = 1_000_000.0  # internal units (nm) per millimetre

# The four unrouted endpoints: both nets have BOTH endpoints unrouted.
PADS = [("U1", "8"), ("U1", "22"), ("U4", "17"), ("U4", "18")]

COPPER_LAYERS = [
    (pcbnew.F_Cu, "F.Cu"),
    (pcbnew.In1_Cu, "In1.Cu"),
    (pcbnew.In2_Cu, "In2.Cu"),
    (pcbnew.B_Cu, "B.Cu"),
]

EPS = 1e-9
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
